ridedott/lido-hardware/LIDO_HW_2022_04_V01/SupportDocuments/OMNI_PCB_Stackup.JPG

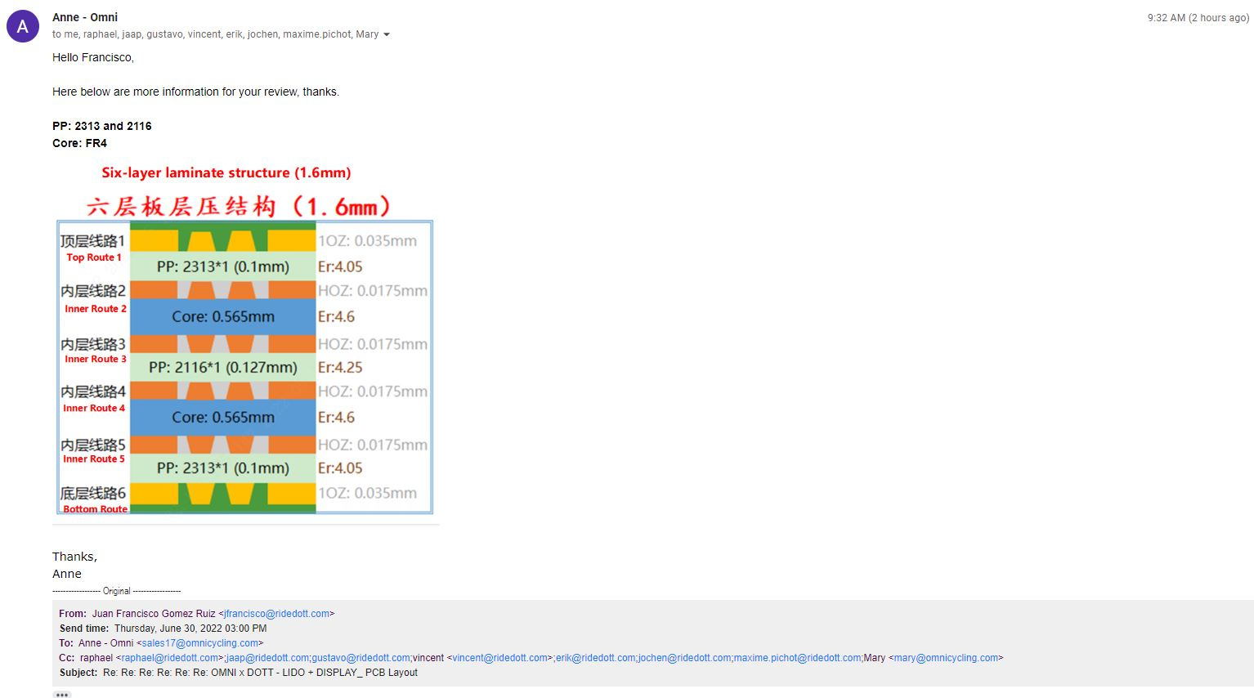
LIDO_HW_2022_04_V01/SupportDocuments/OMNI_PCB_Stackup.JPG
