ridedott/lido-hardware/LIDO_HW_2022_04_V01/SupportDocuments/Pinout_RearConnector.JPG

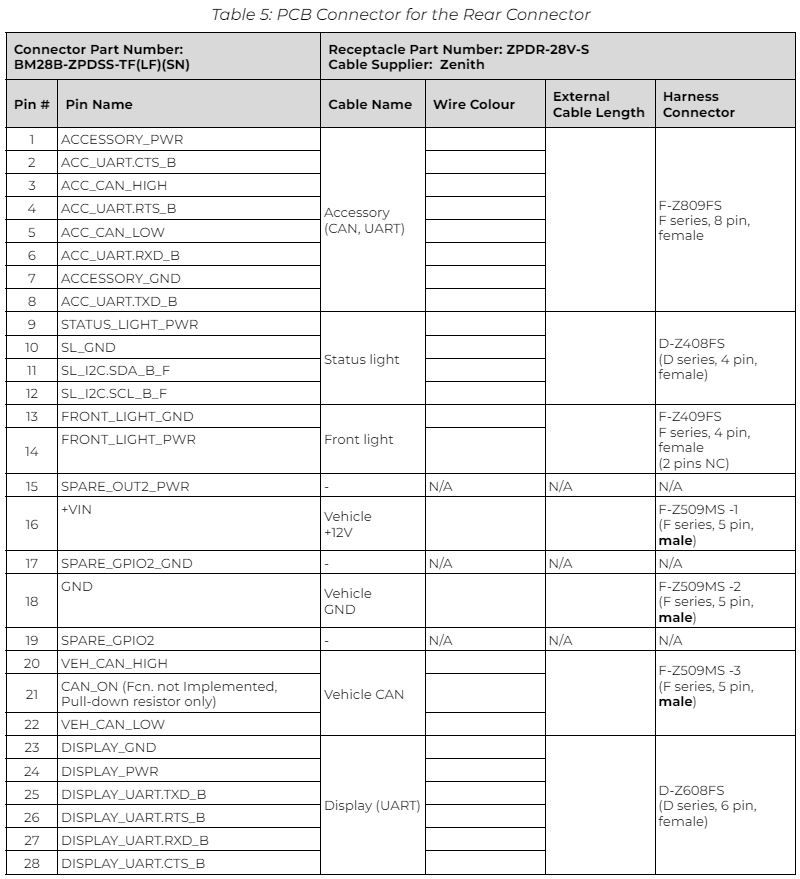
LIDO_HW_2022_04_V01/SupportDocuments/Pinout_RearConnector.JPG
