ridedott/lido-hardware/LIDO_HW_2022_04_V01/Output Documents/05_BOM/BOM LIDO_V03_DEVELOPMENT_04_07_2022.xls

 | Bill Of Materials
 | Project: | SDRR |  |  |  | DOTT (emTransit B.V.)
 | Source Data From: | LIDO_HW_2022_04_V01.PrjPcb |  |  |  | Westerdok
 | Project Name ( Board ): | LIDO |  |  |  | Van Diemenstraat 292
 | Variant: | DEVELOPMENT |  |  |  | 1013 CR, Amsterdam
 | Version & Revision: | 0 | .3 |  |  | The Netherlands
Created: | 02/07/2022 |  |  |  | Remarks:
Change LOG*: | .3 | 02/07/2022 | Initial release
*Change LOG information
Quantity | Designator | Manufacturer Part Number | Manufacturer | Manufacturer Part Number 2nd | Manufacturer 2nd | Description | Part Package | Package Type
28 | C100, C101, C102, C104, C106, C107, C108, C109, C111, C112, C113, C115, C118, C120, C122, C123, C124, C125, C127, C133, C302, C303, C304, C311, C314, C406, C407, C408 | CGA3E2C0G2A101J080AA | TDK Corporation |  |  | CAP CER 100PF 100V C0G 0603 | 0603 | SMT
10 | C103, C105, C110, C114, C116, C117, C119, C121, C126, C222 | CGA3E2X7R2A102K080AA | TDK Corporation |  |  | CAP CER 1000PF 100V X7R 0603 | 0603 | SMT
2 | C128, C129 | 25SVPK33M | Panasonic Electronic Components |  |  | CAP ALUM POLY 33UF 20% 25V SMD | D5_5.3x5.3x5.9mm | SMT
5 | C130, C131, C136, C146, C163 | ECASD31E226M040KA0 | Murata Electronics |  |  | CAP ALUM POLY 22UF 20% 25V SMD | 2917 | SMT
5 | C132, C142, C219, C221, C223 | CGA3E2X7R1H104K080AA | TDK Corporation |  |  | CAP CER 0.1UF 50V X7R 0603 | 0603 | SMT
7 | C135, C137, C139, C141, C143, C144, C300 | CL32B475KBJVPNE | Samsung Electro-Mechanics |  |  | CAP CER 4.7UF 50V X7R 1210 | 1210 | SMT
4 | C147, C148, C149, C150 | CGA3E2X7R1H682K080AA | TDK Corporation |  |  | CAP CER 6800PF 50V X7R 0603 | 0603 | SMT
5 | C151, C152, C153, C157, C158 | CGA3E2X7R1H333K080AA | TDK Corporation | CL10B333KB8WPNC | Samsung Electro-Mechanics | CAP CER 0.033UF 50V X7R 0603 | 0603 | SMT
23 | C154, C155, C161, C162, C164, C168, C224, C225, C301, C306, C307, C308, C309, C310, C312, C313, C400, C401, C402, C403, C404, C405, C410 | CGA3E1X7R1E105M080AE | TDK Corporation |  |  | CAP CER 1UF 25V X7R 0603 | 0603 | SMT
8 | C165, C166, C167, C169, C170, C171, C172, C173 | GCM188R71H473KA55D | Murata Electronics | CGA3E2X7R1H473M080AA | TDK Corporation | CAP CER 0.047UF 50V X7R 0603 | 0603 | SMT
11 | C200, C202, C203, C204, C210, C211, C213, C214, C215, C216, C217 | GCM155R71H104KE02D | Murata Electronics |  |  | CAP CER 0.1UF 50V X7R 0402 | 0402 | SMT
4 | C201, C205, C212, C218 | GRM188Z71A106KA73D | Murata Electronics |  |  | CAP CER 10UF 10V X7R 0603 | 0603 | SMT
4 | C206, C207, C208, C209 | GJM1555C1H120FB01D | Murata Electronics |  |  | CAP CER 12PF 50V C0G/NP0 0402 | 0402 | SMT
2 | C305, C409 | CGA3E2X7R1H472K080AA | TDK Corporation |  |  | CAP CER 4700PF 50V X7R 0603 | 0603 | SMT
18 | D100, D101, D102, D104, D105, D107, D108, D109, D111, D112, D113, D116, D119, D121, D123, D125, D126, D128 | PESD5V0V1BA,115 | Nexperia USA Inc. |  |  | 12.5V Clamp 4.8A (8/20µs) Ipp Tvs Diode Surface Mount SOD-323 | SOD323 | SMT
10 | D103, D106, D110, D114, D117, D118, D120, D122, D127, D130 | PESD12VL1BA,115 | Nexperia USA Inc. |  |  | 37V Clamp 5A (8/20µs) Ipp Tvs Diode Surface Mount SOD-323 | SOD323 | SMT
2 | D115, D124 | PESD1CAN,215 | Nexperia USA Inc. |  |  | 70V Clamp 3A (8/20µs) Ipp Tvs Diode Surface Mount TO-236AB | SOT23-3 | SMT
1 | D129 | SDT3A45SA-13 | Diodes Incorporated |  |  | SCHOTTKY RECTIFIER SMA T&R 10K | DO-214AC | SMT
12 | D131, D132, D133, D134, D135, D136, D137, D138, D139, D140, D141, D142 | CUS520,H3F | Toshiba Semiconductor and Storage |  |  | DIODE SCHOTTKY 30V 200MA | SOD-323 | SMT
1 | F100 | C1Q 3 | Bel Fuse Inc. |  |  | 3 A 125 V AC 63 V DC Fuse Board Mount (Cartridge Style Excluded) Surface Mount 1206 (3216 Metric) | 1206 | SMT
8 | FB100, FB101, FB102, FB103, FB107, FB108, FB110, FB113 | BLM18EG121SN1D | Murata Electronics |  |  | FERRITE BEAD 120 OHM 0603 1LN | 0603 | SMT
4 | FB104, FB105, FB111, FB112 | BLM15BD601SN1D | Murata Electronics |  |  | FERRITE BEAD 600 OHM 0402 1LN | 0402 | SMT
2 | FB106, FB109 | BLM18AG221SN1D | Murata Electronics |  |  | FERRITE BEAD 220 OHM 0603 1LN | 0603 | SMT
1 | FB200 | BLM18PG471SN1D | Murata Electronics |  |  | FERRITE BEAD 470 OHM 0603 1LN | 0603 | SMT
2 | L100, L101 | IHLP2525CZER100M8A | Vishay Dale |  |  | FIXED IND 10UH 4A 76.9 MOHM SMD | 6.47x6.47x3.0mm | SMT
1 | L200 | CDRH2D18/HPNP-100NC | Sumida America Components Inc. |  |  | FIXED IND 10UH 900MA 245MOHM SMD | 3.0x3.0x2.0mm | SMT
2 | Q100, Q101 | DMN4035LQ-13 | Diodes Incorporated |  |  | MOSFET N-CH 40V 4.6A SOT23 | SOT23-3 | SMT
8 | R100, R101, R102, R103, R104, R105, R106, R107 | ERJ-PA3J470V | Panasonic Electronic Components |  |  | RES SMD 47 OHM 5% 1/4W 0603 | 0603 | SMT
32 | R108, R113, R114, R115, R120, R123, R126, R129, R132, R133, R134, R140, R164, R165, R166, R170, R247, R248, R253, R260, R261, R263, R264, R300, R307, R310, R311, R314, R401, R402, R404, R410 | RC0603FR-0710KL | YAGEO |  |  | RES 10K OHM 1% 1/10W 0603 | 0603 | SMT
6 | R109, R110, R111, R116, R118, R119 | ERJ-6GEY0R00V | Panasonic Electronic Components |  |  | RES SMD 0 OHM JUMPER 1/8W 0805 | 0805 | SMT
1 | R112 | ERJ-3EKF5622V | Panasonic Electronic Components |  |  | RES SMD 56.2K OHM 1% 1/10W 0603 | 0603 | SMT
1 | R117 | ERJ-3EKF7682V | Panasonic Electronic Components | RMCF0603FT76K8 | Stackpole Electronics Inc | RES SMD 76.8K OHM 1% 1/10W 0603 | 0603 | SMT
10 | R121, R124, R127, R130, R200, R201, R205, R206, R315, R316 | ERJ-3EKF4701V, RC0603JR-074K7L | Panasonic Electronic Components, YAGEO |  |  | RES SMD 4.7K OHM 1% 1/10W 0603, RES 4.7K OHM 5% 1/10W 0603 | 0603 | SMT
4 | R122, R125, R128, R131 | ERJ-3EKF2002V | Panasonic Electronic Components | RC0603FR-0720KL | YAGEO | RES SMD 20K OHM 1% 1/10W 0603 | 0603 | SMT
5 | R135, R136, R137, R141, R143 | ERJ-3EKF4702V | Panasonic Electronic Components |  |  | RES SMD 47K OHM 1% 1/10W 0603 | 0603 | SMT
19 | R138, R142, R144, R147, R148, R149, R150, R155, R156, R158, R161, R251, R252, R254, R308, R312, R317, R318, R400 | RC0603JR-070RL | YAGEO | RMCF0603ZT0R00 | Stackpole Electronics Inc | RES 0 OHM JUMPER 1/10W 0603 | 0603 | SMT
1 | R163 | ESR03EZPJ100 | Rohm Semiconductor |  |  | RES SMD 10 OHM 5% 1/4W 0603 | 0603 | SMT
5 | R167, R259, R262, R302, R406 | RC0603JR-0733RL | YAGEO |  |  | RES 33 OHM 5% 1/10W 0603 | 0603 | SMT
24 | R202, R203, R204, R207, R209, R212, R216, R217, R218, R221, R223, R224, R226, R228, R229, R230, R231, R233, R235, R237, R238, R242, R243, R244 | ERJ-2GE0R00X | Panasonic Electronic Components |  |  | RES SMD 0 OHM JUMPER 1/10W 0402 | 0402 | SMT
19 | R208, R210, R211, R213, R214, R215, R219, R220, R222, R225, R227, R232, R234, R236, R239, R240, R241, R249, R250 | ERJ-2GEJ330X | Panasonic Electronic Components |  |  | RES SMD 33 OHM 5% 1/10W 0402 | 0402 | SMT
3 | R245, R246, R257 | RC0603JR-071KL | YAGEO |  |  | RES 1K OHM 5% 1/10W 0603 | 0603 | SMT
2 | R255, R258 | ERJ-3EKF5101V | Panasonic Electronic Components |  |  | RES SMD 5.1K OHM 1% 1/10W 0603 | 0603 | SMT
1 | R256 | RC0603FR-0731K6L | YAGEO |  |  | RES 31.6K OHM 1% 1/10W 0603 | 0603 | SMT
4 | R305, R306, R409, R411 | ERJ-3EKF62R0V | Panasonic Electronic Components |  |  | RES SMD 62 OHM 1% 1/10W 0603 | 0603 | SMT
1 | S200 | SKRKAEE020 | Alps Alpine |  |  | Switch Tactile N.O. SPST Round Button Gull Wing 0.05A 12VDC 1.57N SMD T/R |  | SMT
1 | U100 | TPS562208DDCR | Texas Instruments |  |  | Buck Switching Regulator IC Positive Adjustable 0.768V 1 Output 2A SOT-23-6 Thin, TSOT-23-6 | SOT23-6 | SMT
1 | U101 | TPS2552DBVR | Texas Instruments |  |  | Power Switch/Driver 1:1 N-Channel 1.5A SOT-23-6 | SOT23-6 | SMT
1 | U102 | TLV74333PDBVR | Texas Instruments |  |  | Linear Voltage Regulator IC Positive Fixed 1 Output 300mA SOT-23-5 | SOT23-5 | SMT
6 | U103, U302, U303, U304, U400, U401 | TCA9406DCTR | Texas Instruments |  |  | Voltage Level Translator Bidirectional 1 Circuit 2 Channel 24Mbps SM8 | MSOP-8 | SMT
1 | U104 | L9733XPTR | STMicroelectronics |  |  | Power Switch/Driver 1:8 N-Channel 1A PowerSSO-28 Exposed Pad | PSSOP-28 | SMT
1 | U200 | ATSAME54P20A-CTUT | Microchip Technology |  |  | ARM® Cortex®-M4F series Microcontroller IC 32-Bit Single-Core 120MHz 1MB (1M x 8) FLASH 120-TFBGA (8x8) | TFBGA-120 | SMT
1 | U201 | TPS3808G01DBVR | Texas Instruments |  |  | Supervisor Open Drain or Open Collector 1 Channel SOT-23-6 | SOT23-6 | SMT
1 | U202 | ATECC608A-SSH4E-T | Microchip Technology |  |  | IC AUTHENTICATION CHIP 8SOIC | SOIC-8 | SMT
1 | U203 | TMP75AIDGKR | Texas Instruments |  |  | Temperature Sensor Digital, Local -40°C ~ 125°C 11 b 8-VSSOP | VSSOP-8 | SMT
2 | U300, U402 | ATA6561-GAQW | Microchip Technology |  |  | IC TRANSCEIVER 1/1 8SO | SOIC-8 | SMT
2 | U301, U403 | TS3A4741DCNR | Texas Instruments |  |  | IC SWITCH DUAL SPST SOT23-8 | SOT23-8 | SMT
1 | X100 | BM24B-GHDS-TF(LF)(SN) | JST Sales America Inc. |  |  | Connector Header Surface Mount 24 position 0.049" (1.25mm)
1 | X101 | BM28B-ZPDSS-TF(LF)(SN) | JST Sales America Inc. |  |  | Connector Header Surface Mount 28 position 0.059" (1.50mm)
1 | X200 | PRPC003SAAN-RC | Sullins Connector Solutions |  |  | CONN HEADER VERT 3POS 2.54MM
1 | X201 | 830103552209 | Würth Elektronik |  |  | 32 MHz ±10ppm Crystal 9pF 40 Ohms 4-SMD, No Lead | SMD-4 | SMT
1 | X202 | CM8V-T1A-32.768KHZ-9PF-20PPM-TA-QC | Micro Crystal AG |  |  | 32.768 kHz ±20ppm Crystal 9pF 70 kOhms 2-SMD, No Lead | SMD-2 | SMT
1 | X203 | GRPB052VWQS-RC | Sullins Connector Solutions |  |  | CONN HEADER SMD 10POS 1.27MM
