ridedott/lido-hardware/LIDO_HW_2022_04_V01/SupportDocuments/Templates/BOM Dott template rev.A1.xls

 | Bill Of Materials
 | Project: | Field=MainProjectName |  |  |  | DOTT (emTransit B.V.)
 | Source Data From: | Field=DataSourceFileName |  |  |  | Westerdok
 | Project Name ( Board ): | Field=ProjectBoardName |  |  |  | Van Diemenstraat 292
 | Variant: | Field=VariantName |  |  |  | 1013 CR, Amsterdam
 | Version & Revision: | Field=Project_Version | Field=ProjectRevision |  |  | The Netherlands
Created: | Field=ReportDate |  |  |  | Remarks:
Change LOG*: | Field=ProjectRevision | Field=ReportDate | Initial release
*Change LOG information
Column=Quantity | Column=Designator | Column=Manufacturer Part Number | Column=Manufacturer | Column=Manufacturer Part Number 2nd | Column=Manufacturer 2nd | Column=Description | Column=Part Package | Column=Package Type
