ridedott/lido-hardware/LIDO_HW_2022_04_V01/SupportDocuments/20220602_OMNI LIDO PCB.step

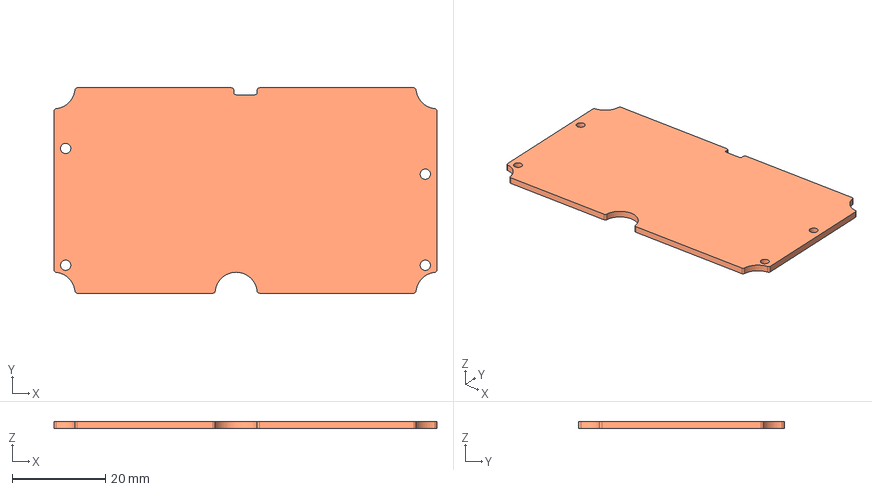
[picture p4: CAD file, 2022-06-07]
LIDO_HW_2022_04_V01/SupportDocuments/20220602_OMNI LIDO PCB.step
82.0 x 44.0 x 1.60 mm
