ridedott/lido-hardware/LIDO_HW_2022_04_V01/Output Documents/01_Schematics/Sch LIDO_V03_DEVELOPMENT_04_07_2022.PDF

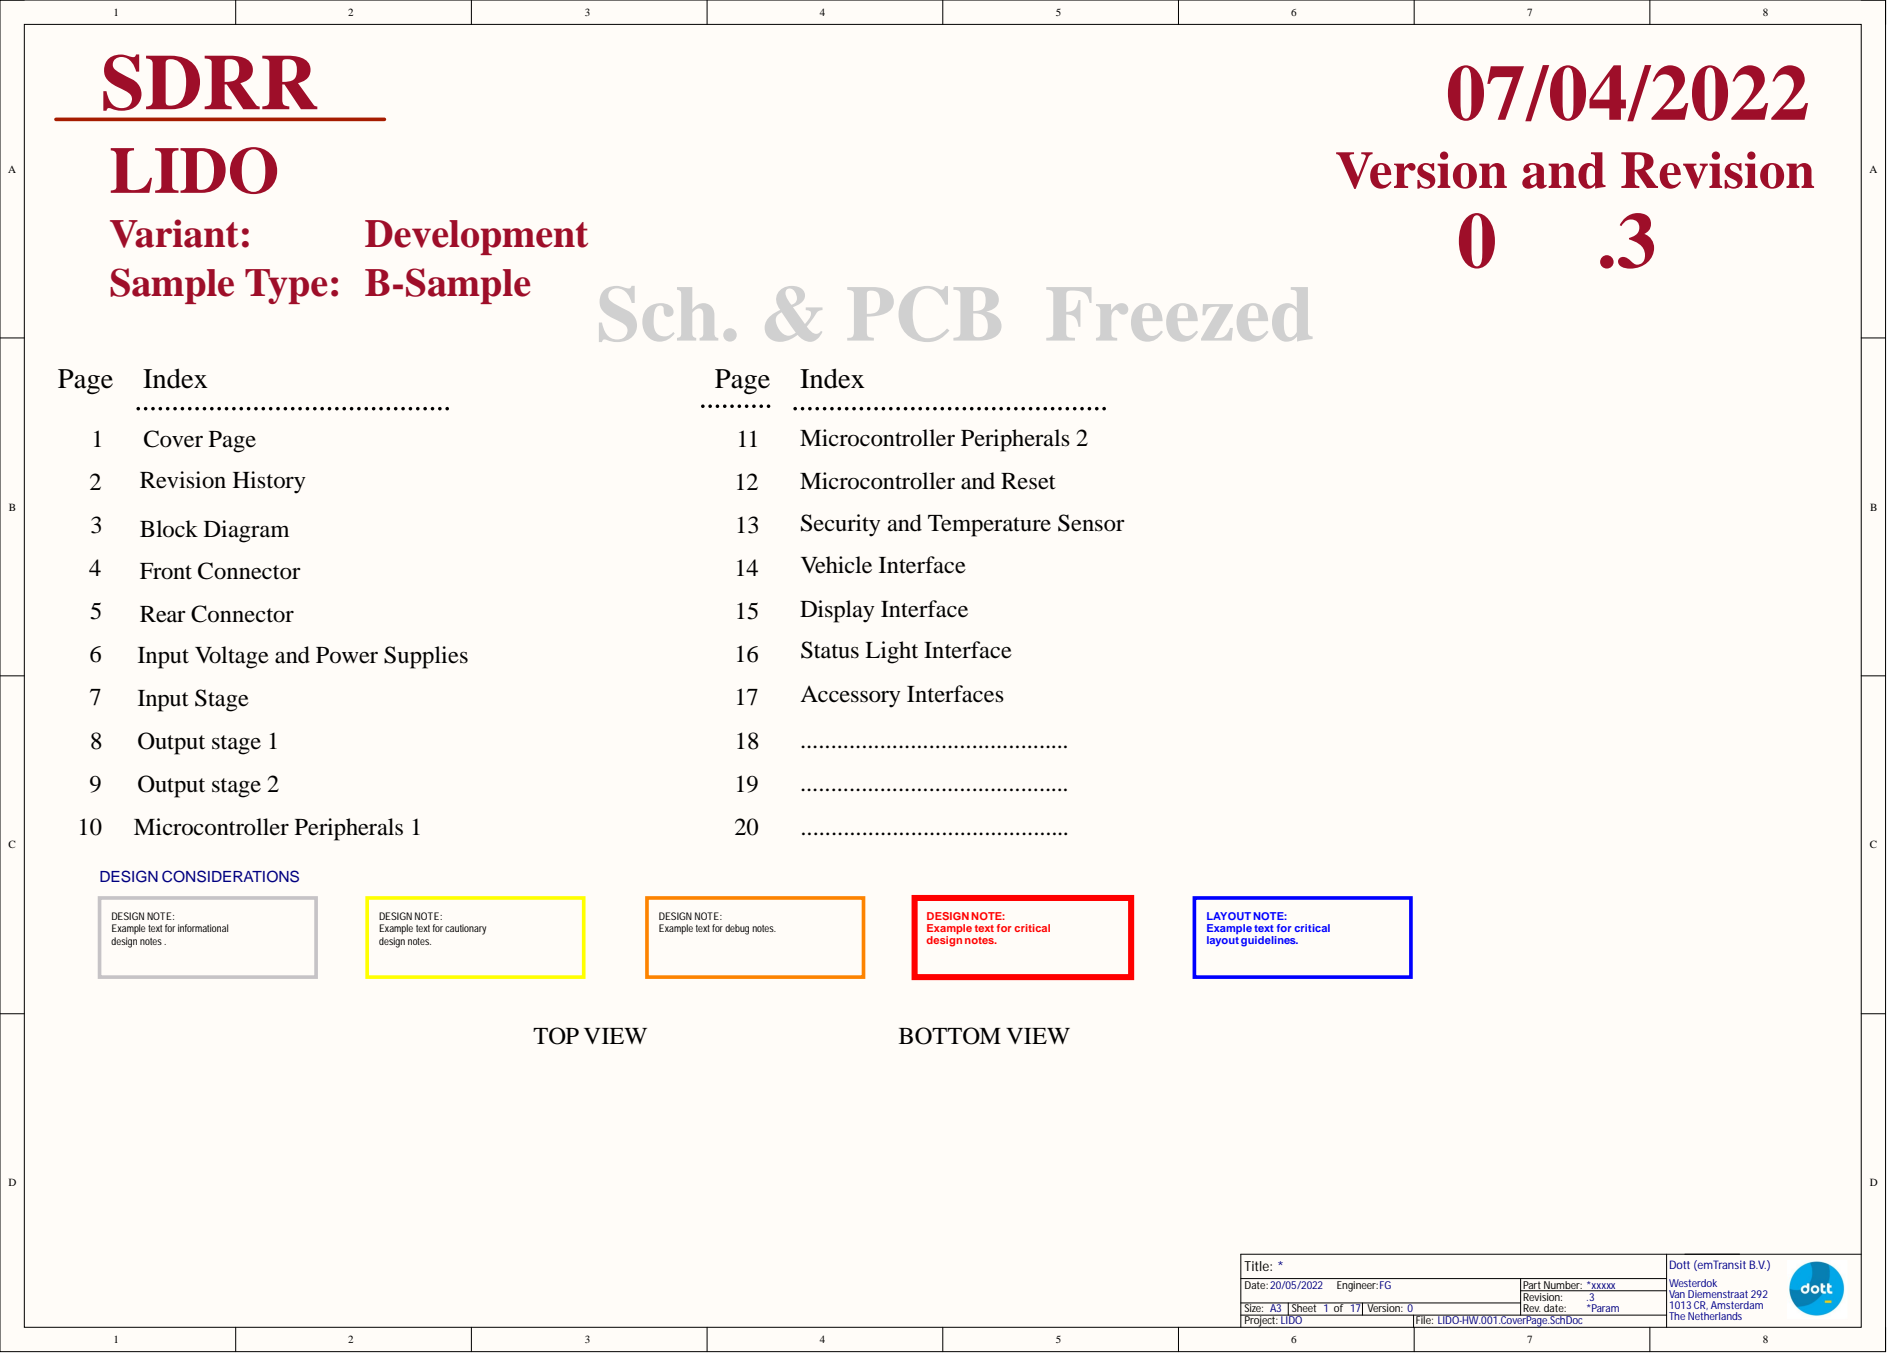
[picture p5: page 1]

DESIGN NOTE:
Example text for informational
design notes .

Example text for cautionary
design notes.

Example text for debug notes.

Example text for critical

LAYOUT NOTE:
layout guidelines.

LIDO-HW.001.CoverPage.SchDoc

D | D
C | C
B | B
A | A

LIDO-HW.002.RevisionHistory.SchDoc

Sheet | of 2 | 17 | Version: 0

# ID002 - Revision History

Index | HISTORY
1 | Date
| 29/04/2022
2 | 04/05/2022
3 | 17/05/2022
4 | 01/06/2022

Draft schematic wiht symbo only ready for first reviews within team and Vladimir (external)

V0.1 - Corrections based on the first sch. review meeting.

V0.2 - Vladimir's comments/suggestions added to schematic.
Old symbol where replaced by real components (Symbol + Footprint) from the databsae library with the part numbers provided by Vladimir.
Some of the part numbers change due to no stock. main parameter remains.

V0.3 - Connectors andCapacitors changed due to space constrains.
- New connectors have smaller pitch. Main connector with 1.50mm pitch; Ratings: 100Volts and up to 2.0Amp. Sensor's conenctor with 1.25mm pitch; Ratings: 50Volts and up to 1.0Amp.
- Some Polymer Caps change to MLCC caps due to space constrains.
- Component placement completed in this revision.

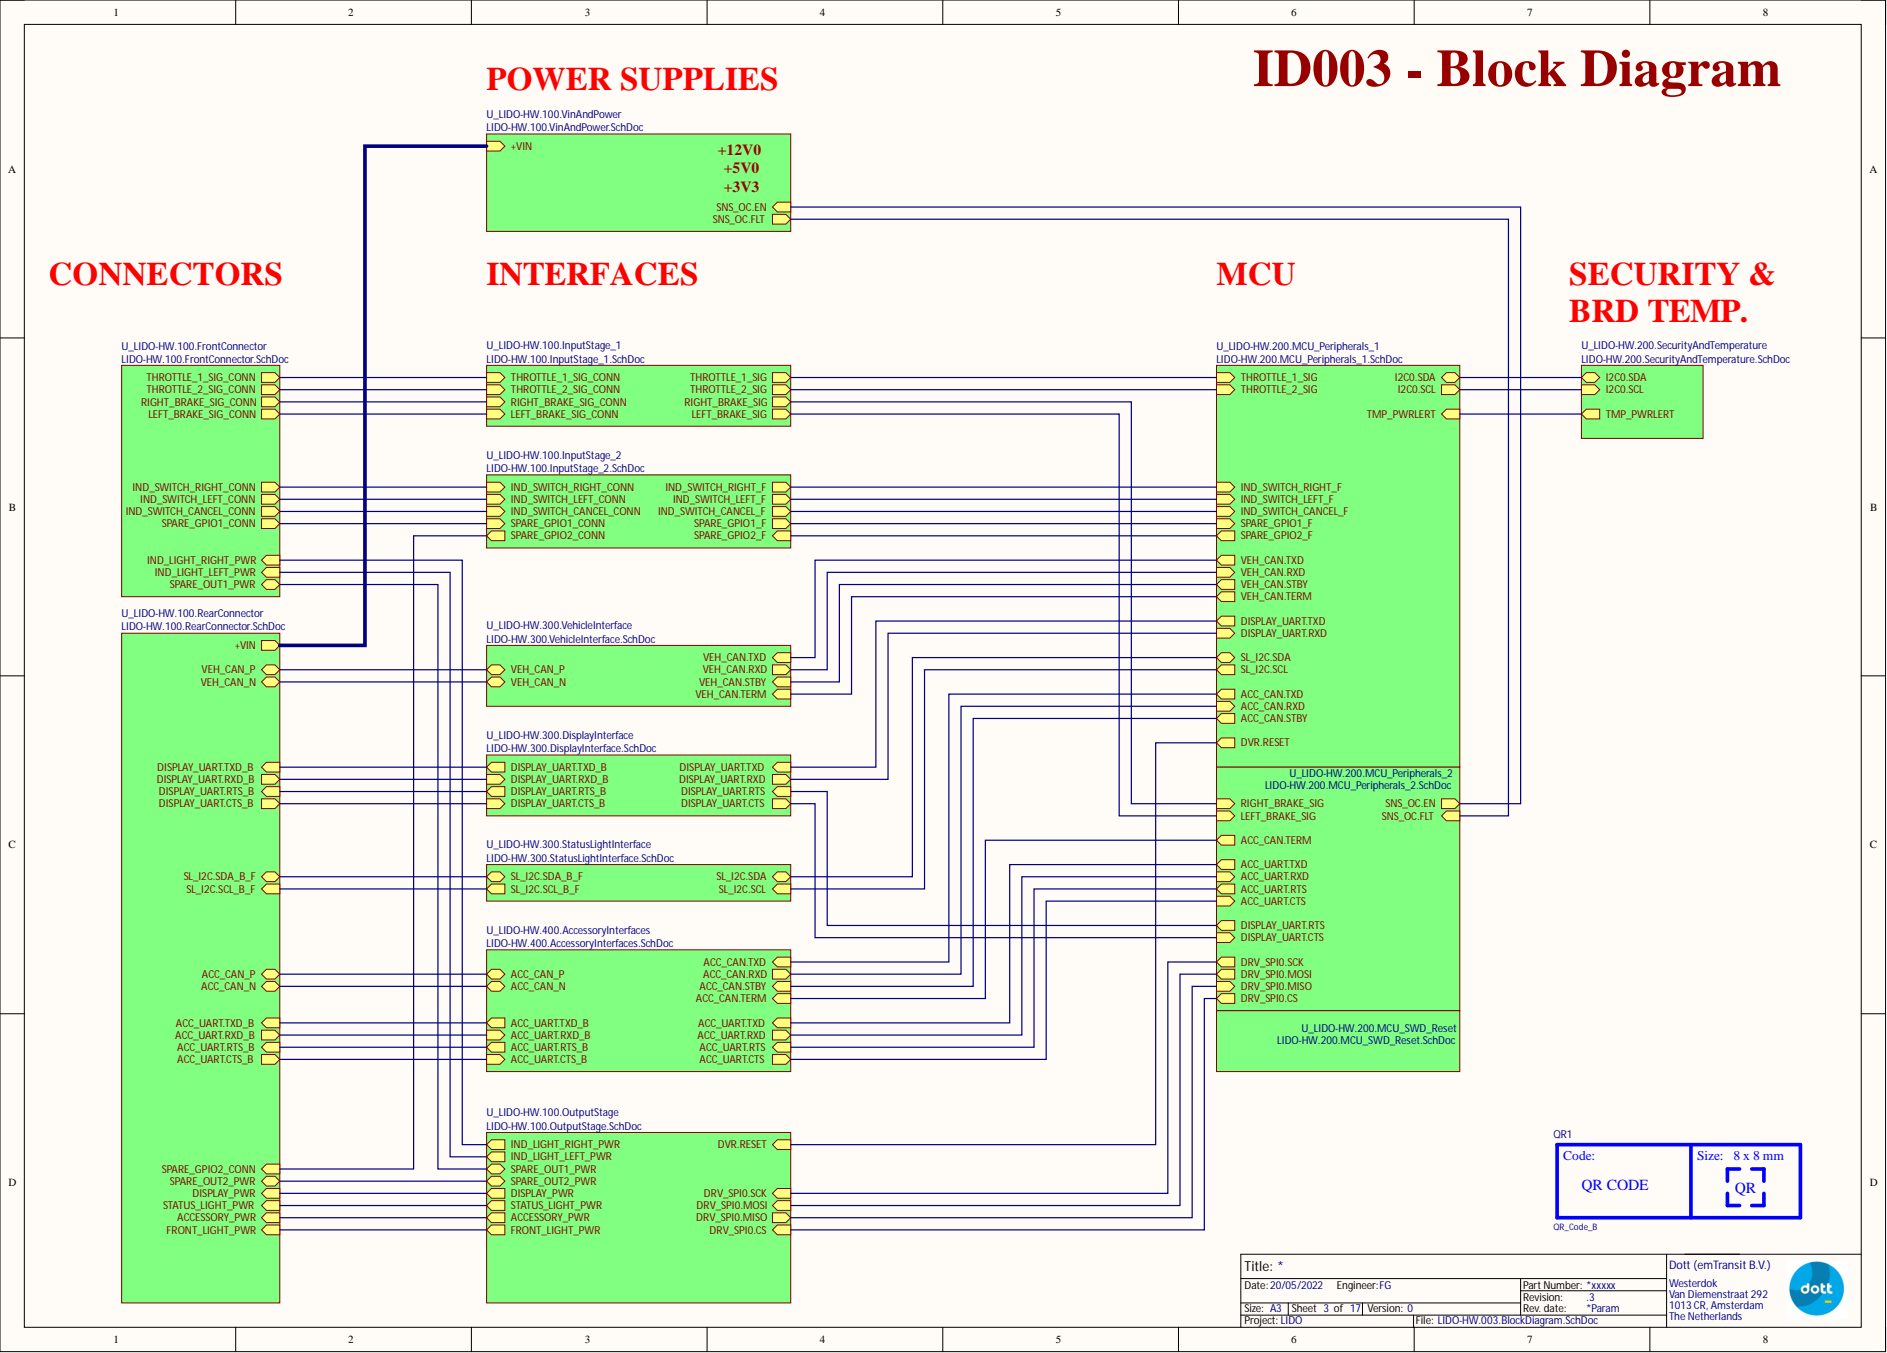
[picture p6: page 3]

U_LIDO-HW.100.VinAndPower
LIDO-HW.100.VinAndPower.SchDoc
+VIN

U_LIDO-HW.200.SecurityAndTemperature
LIDO-HW.200.SecurityAndTemperature.SchDoc
I2C0.SDA
I2C0.SCL

U_LIDO-HW.100.RearConnector
LIDO-HW.100.RearConnector.SchDoc

U_LIDO-HW.300.VehicleInterface
LIDO-HW.300.VehicleInterface.SchDoc

VEH_CAN.TXD VEH_CAN_P VEH_CAN.RXD VEH_CAN_N VEH_CAN.STBY VEH_CAN.TERM

U_LIDO-HW.300.DisplayInterface LIDO-HW.300.DisplayInterface.SchDoc

U_LIDO-HW.200.MCU_Peripherals_2 LIDO-HW.200.MCU_Peripherals_2.SchDoc RIGHT_BRAKE_SIG SNS_OC.EN

LEFT_BRAKE_SIG SNS_OC.FLT

U_LIDO-HW.300.StatusLightInterface LIDO-HW.300.StatusLightInterface.SchDoc | ACC_CAN.TERM ACC_UART.TXD ACC_UART.RXD ACC_UART.RTS ACC_UART.CTS DISPLAY_UART.RTS DISPLAY_UART.CTS DRV_SPI0.SCK DRV_SPI0.MOSI DRV_SPI0.MISO DRV_SPI0.CS

SL_I2C.SDA_B_F SL_I2C.SDA SL_I2C.SCL_B_F SL_I2C.SCL

U_LIDO-HW.400.AccessoryInterfaces LIDO-HW.400.AccessoryInterfaces.SchDoc

LIDO-HW.003.BlockDiagram.SchDoc

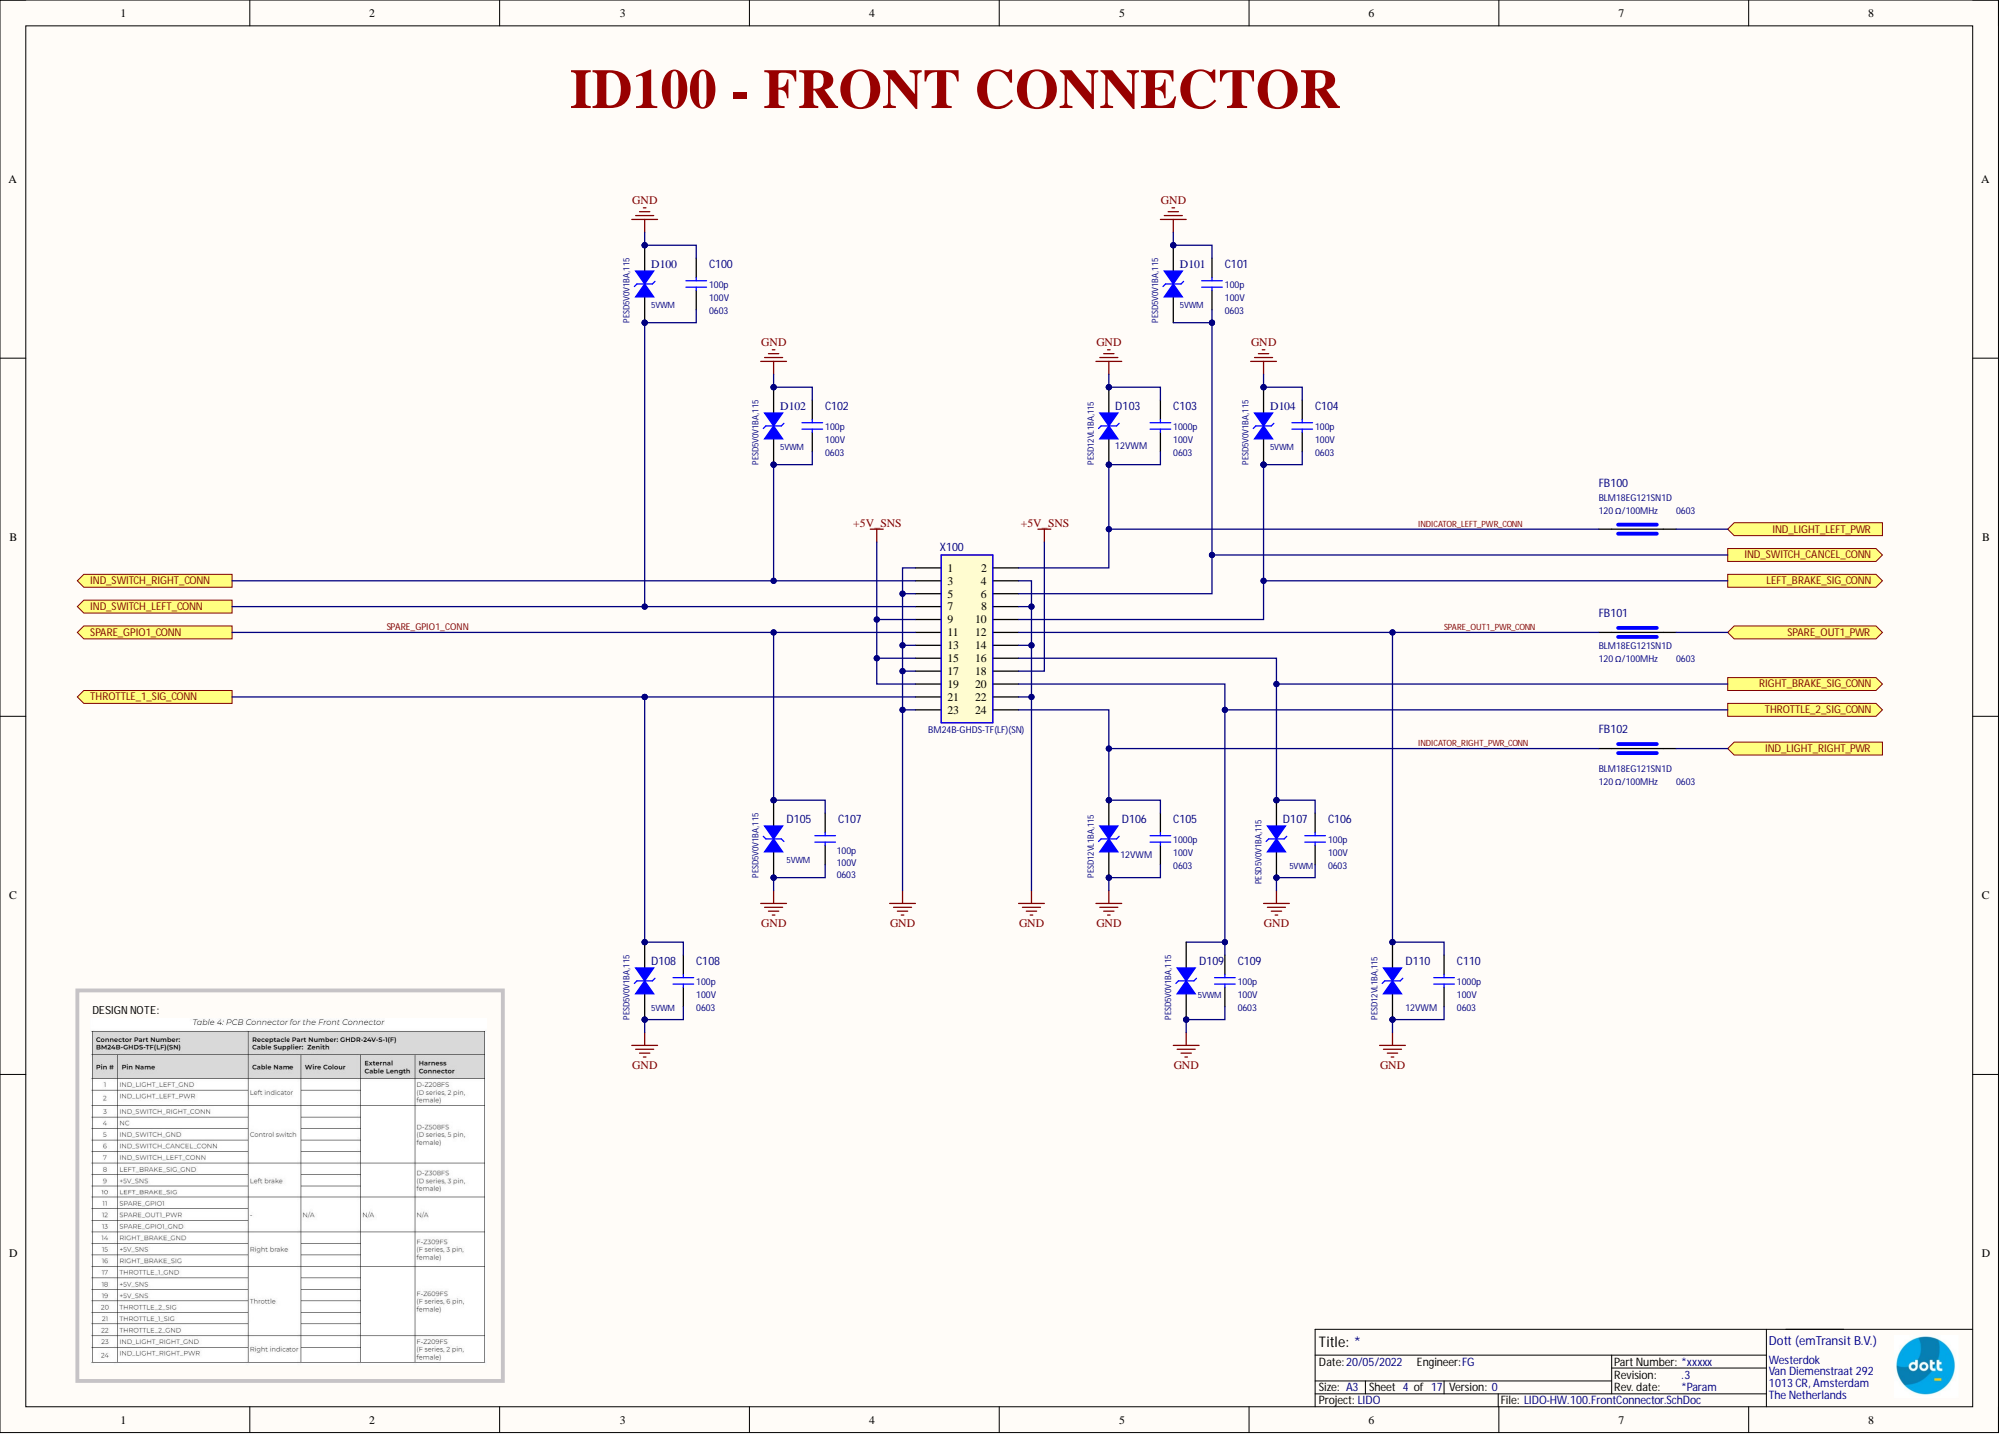
[picture p7: page 4]

BM24B-GHDS-TF(LF)(SN)

LIDO-HW.100.FrontConnector.SchDoc

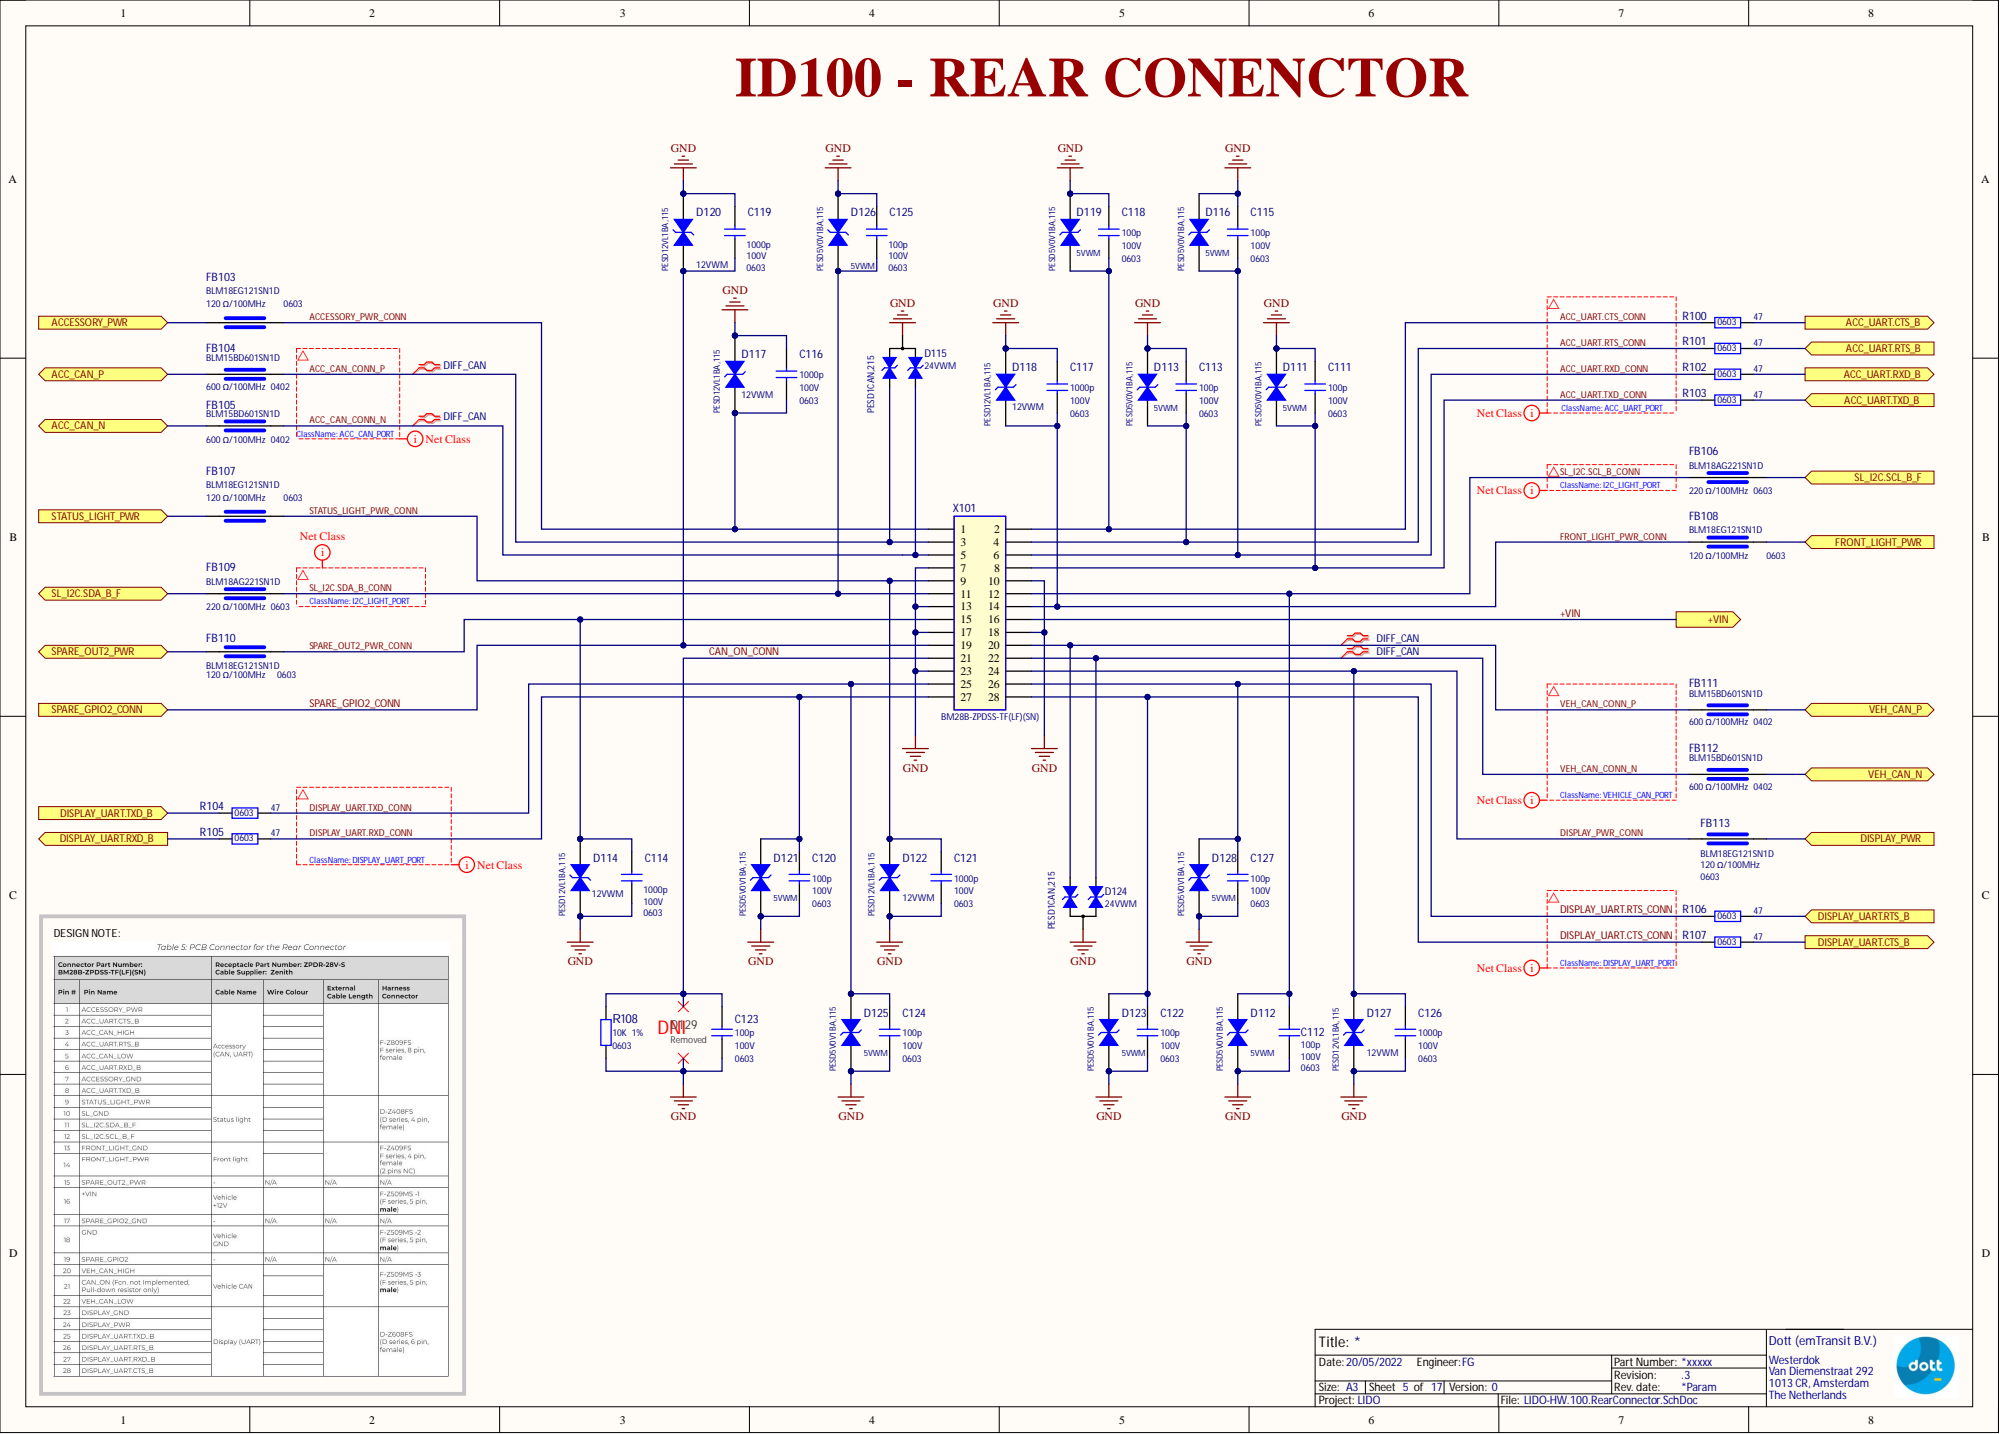
[picture p8: page 5]

1000p | 100p | 100p | ACC_UART.TXD_CONN

0603 | | 5VWM | 0603 | 5VWM

Net Class

BM28B-ZPDSS-TF(LF)(SN)

DISPLAY_UART.RXD_CONN

DISPLAY_UART.CTS_CONN

LIDO-HW.100.RearConnector.SchDoc

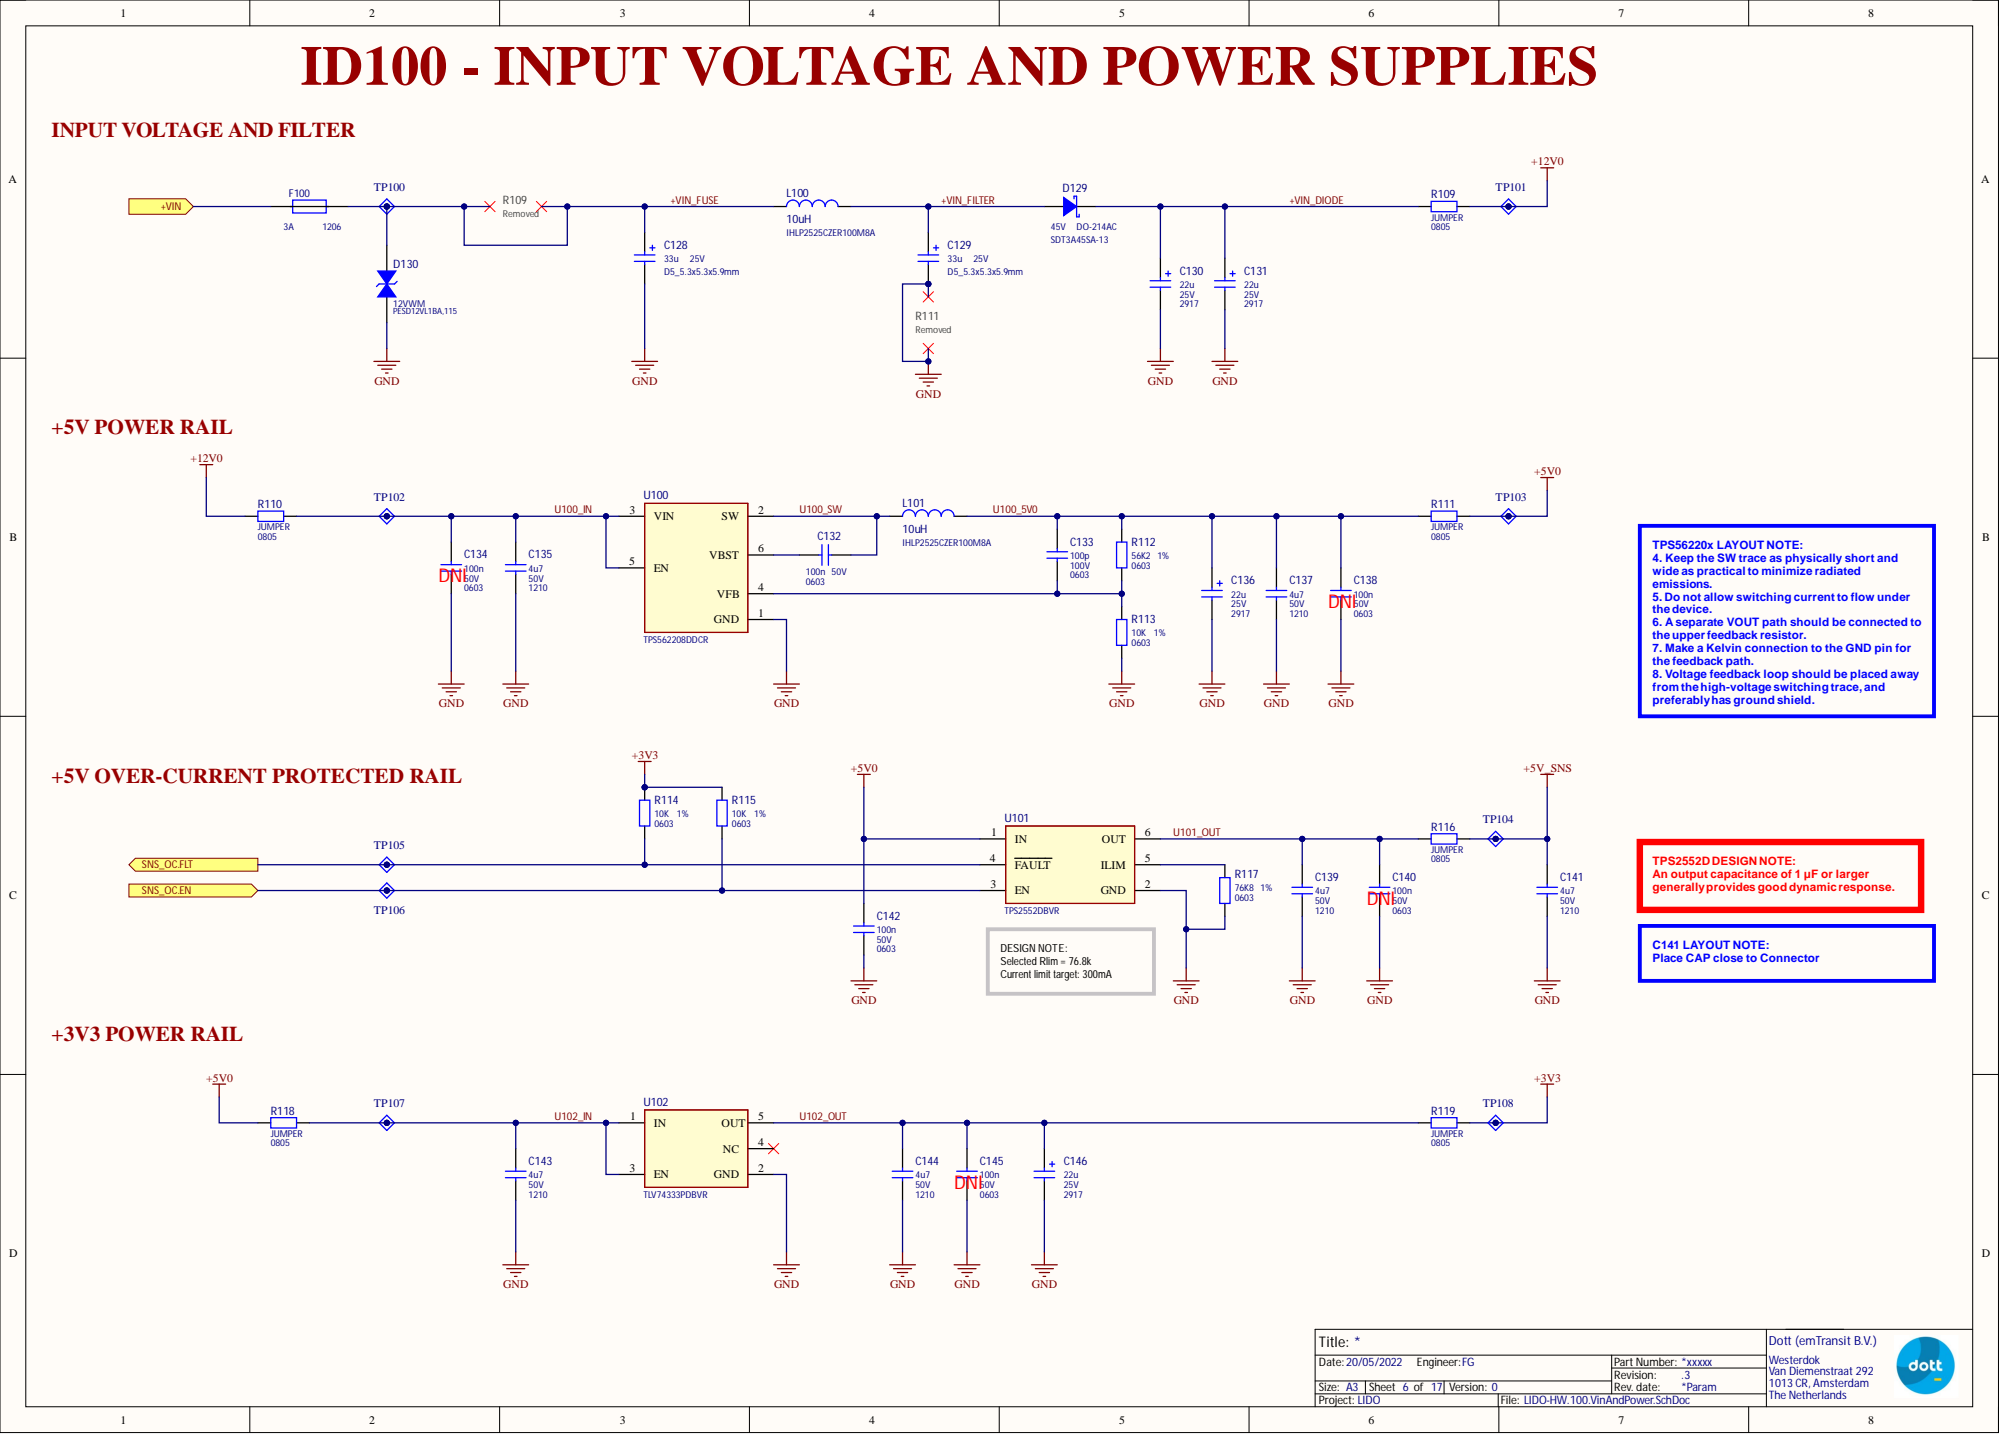
[picture p9: page 6]

ID100 - INPUT VOLTAGE AND POWER SUPPLIES

INPUT VOLTAGE AND FILTER

TPS56220x LAYOUT NOTE:
4. Keep the SW trace as physically short and
wide as practical to minimize radiated
emissions.
5. Do not allow switching current to flow under
the device.
6. A separate VOUT path should be connected to
the upperfeedback resistor.
7. Make a Kelvin connection to the GND pin for
the feedback path.
8. Voltage feedback loop should be placed away
from the high-voltage switching trace, and
preferablyhas ground shield.

+5V OVER-CURRENT PROTECTED RAIL

TPS2552D DESIGN NOTE:
An output capacitance of 1 μF or larger
generallyprovides good dynamic response.

C141 LAYOUT NOTE:
Place CAP close to Connector

LIDO-HW.100.VinAndPower.SchDoc

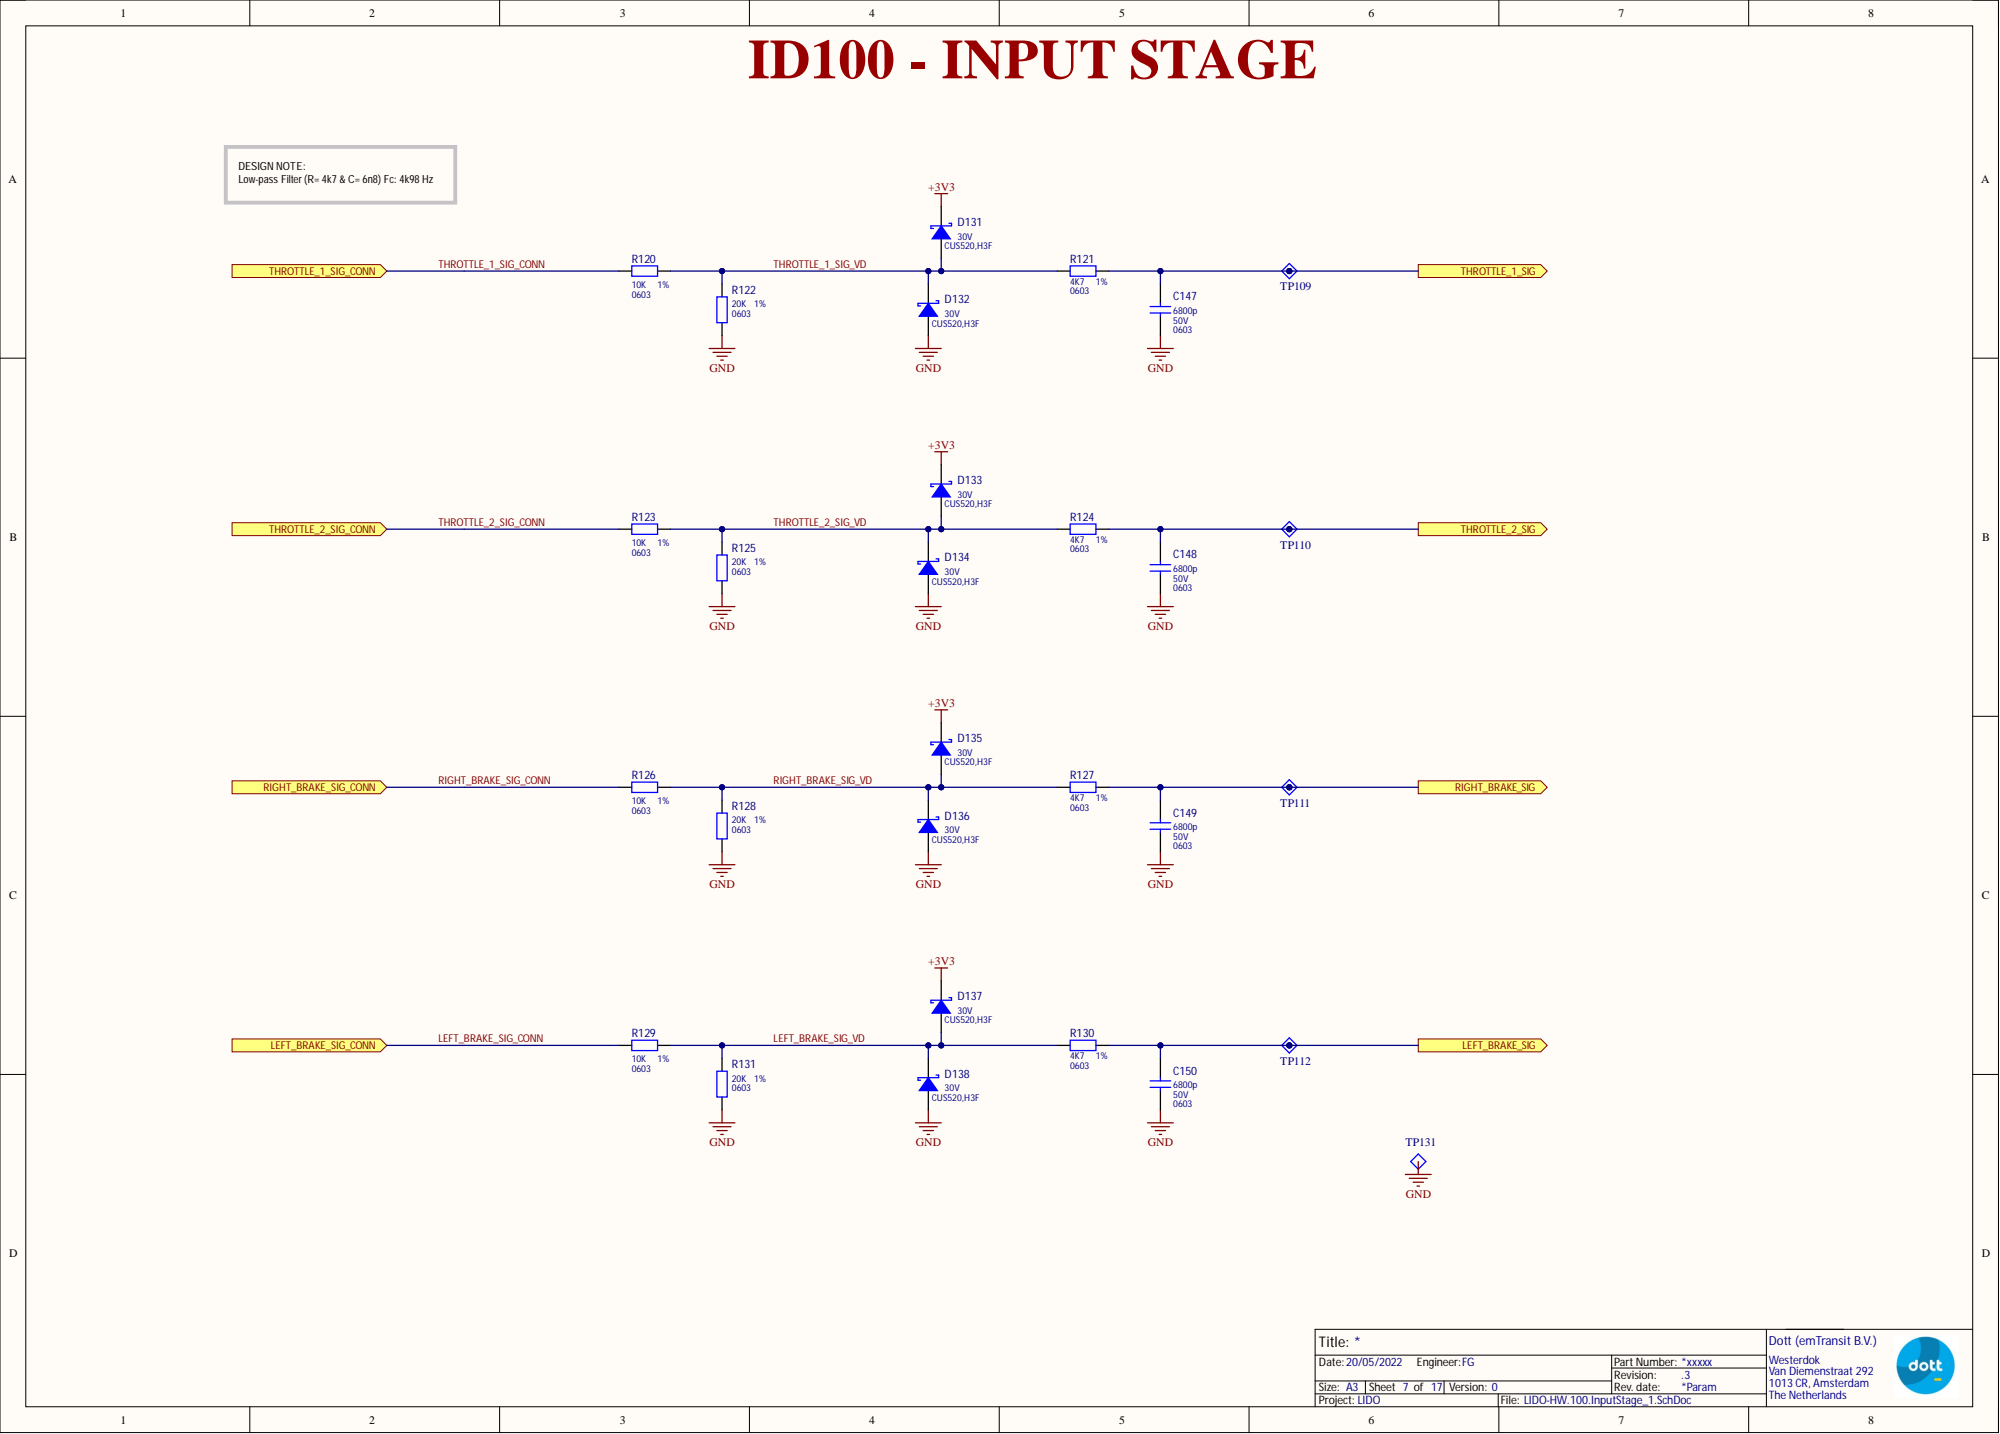
[picture p10: page 7]

DESIGN NOTE:
Low-pass Filter (R= 4k7 & C= 6n8) Fc: 4k98 Hz

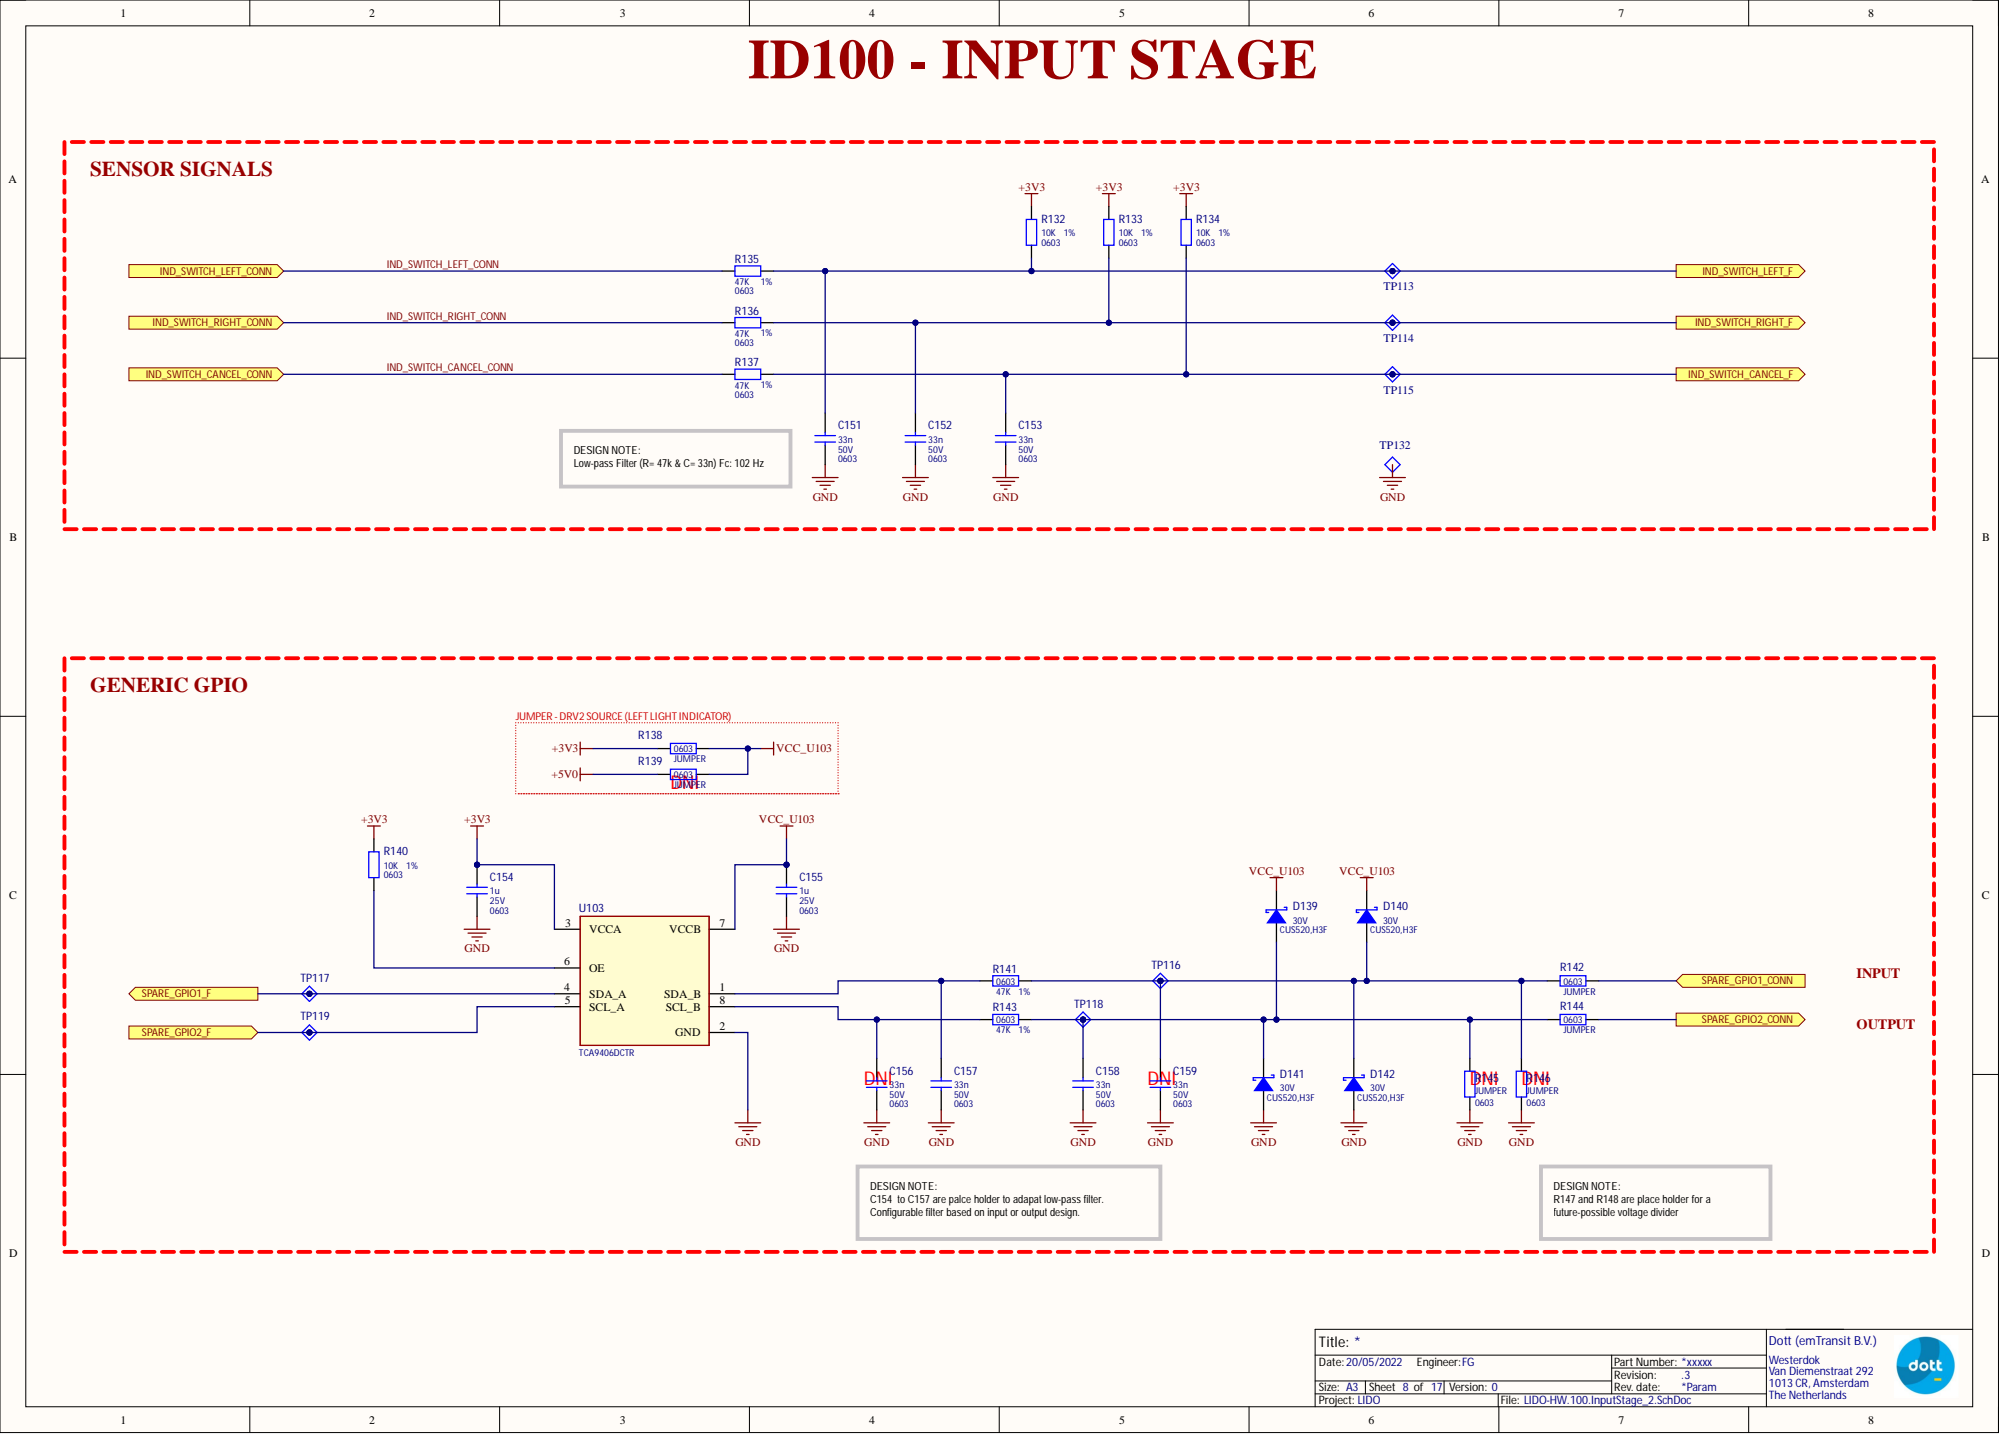
[picture p11: page 8]

DESIGN NOTE:
Low-pass Filter (R= 47k & C= 33n) Fc: 102 Hz

JUMPER - DRV2 SOURCE (LEFT LIGHT INDICATOR)

C154 to C157 are palce holder to adapat low-pass filter.
Configurable filter based on input or output design.

R147 and R148 are place holder for a
future-possible voltage divider

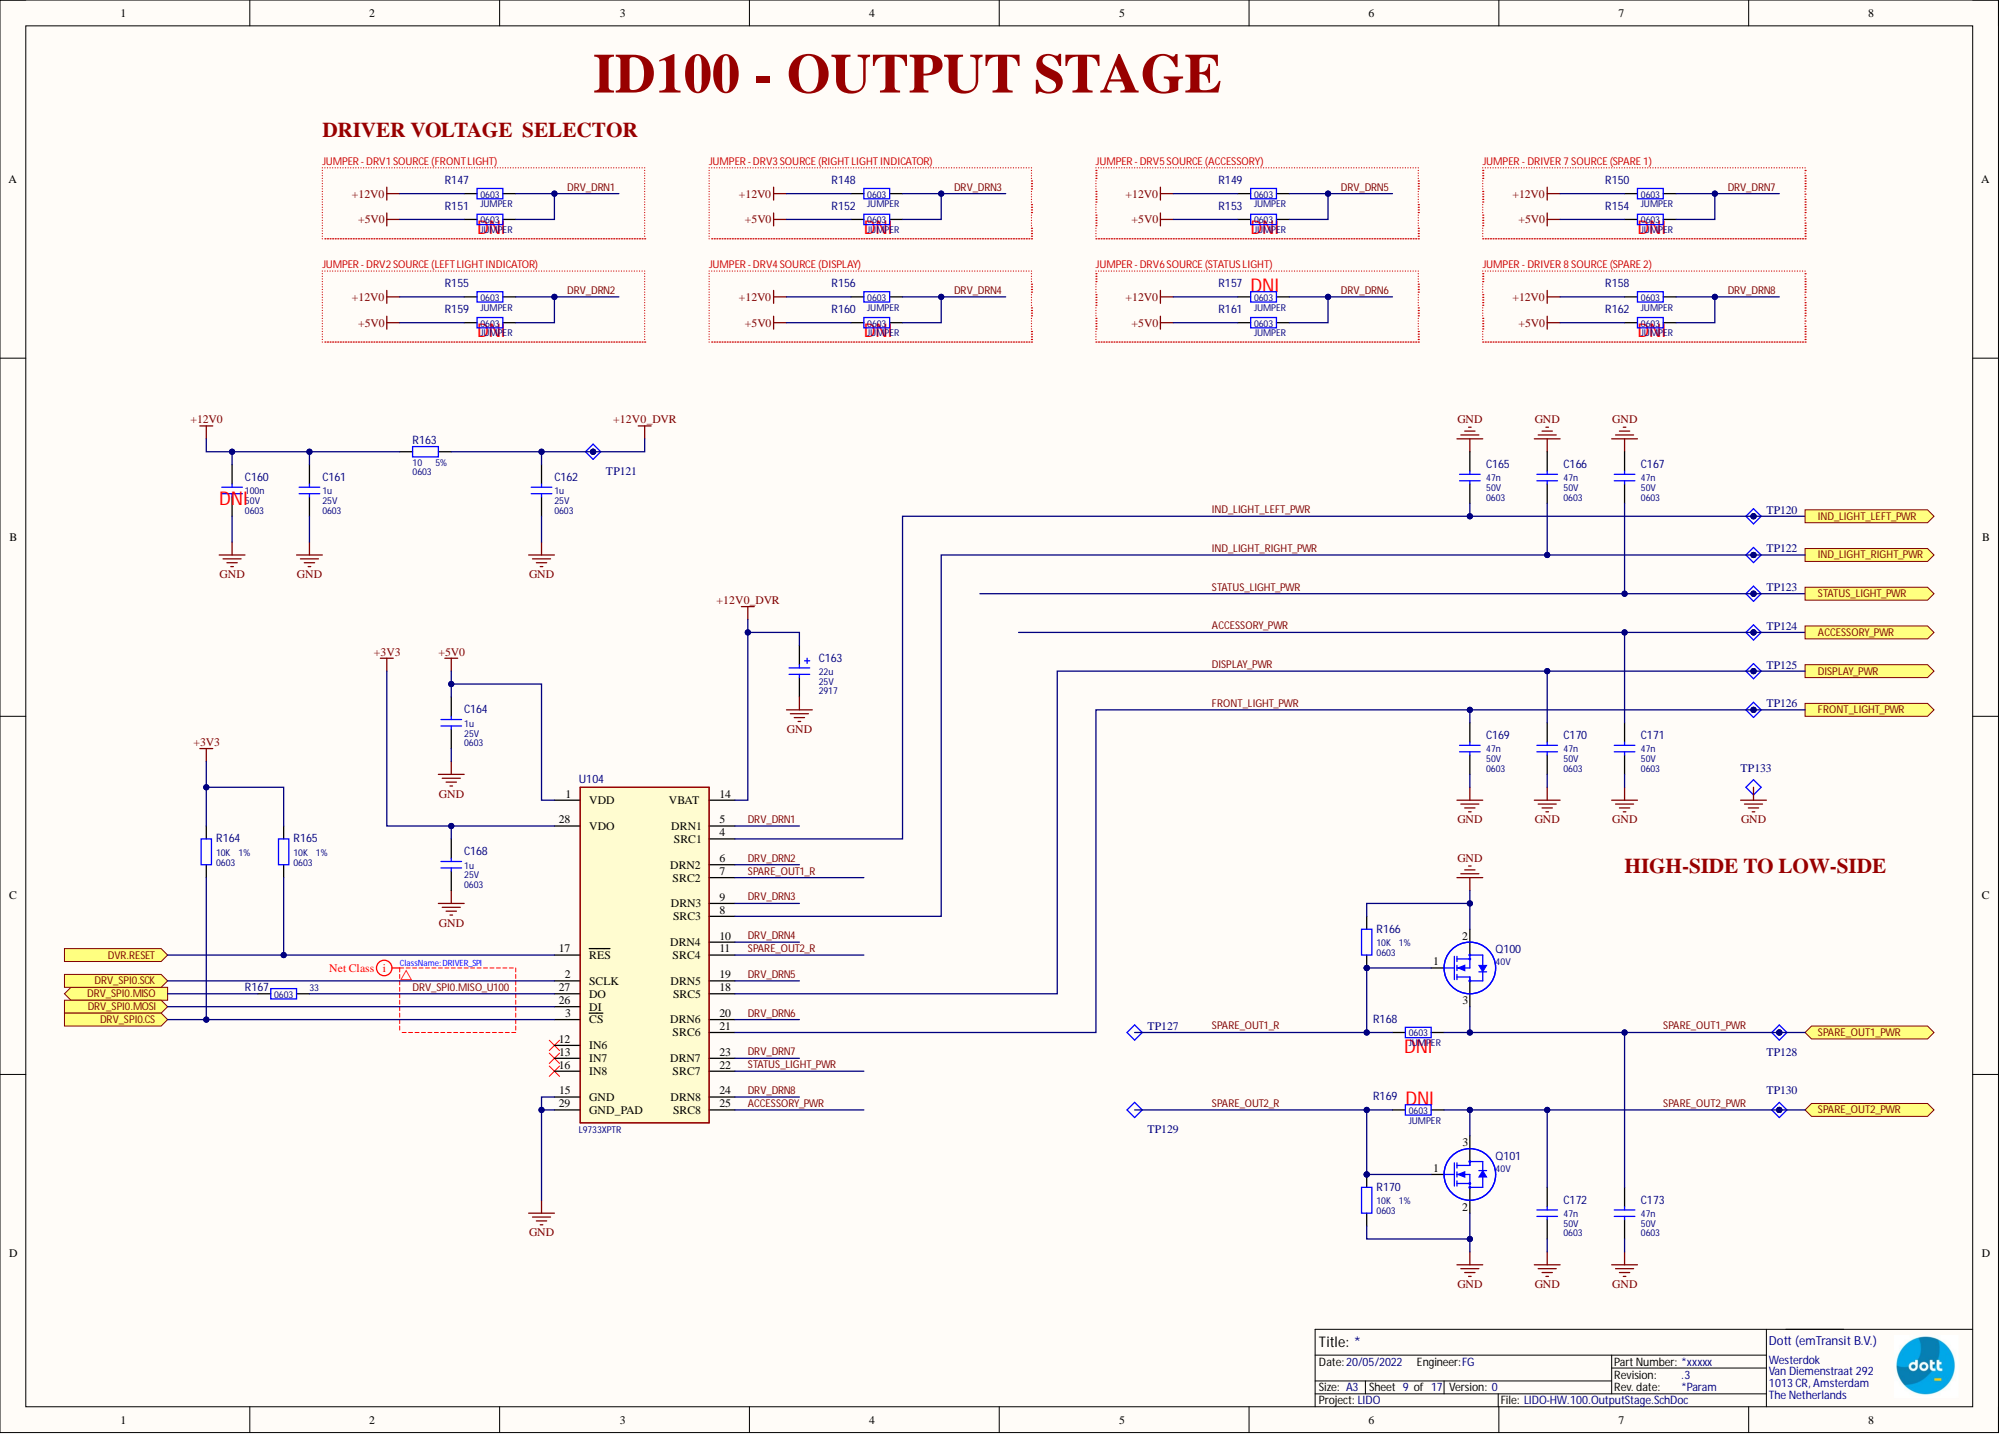
[picture p12: page 9]

JUMPER - DRV1 SOURCE (FRONT LIGHT)

JUMPER - DRV3 SOURCE (RIGHT LIGHT INDICATOR)

JUMPER - DRIVER 7 SOURCE (SPARE 1)

JUMPER - DRV2 SOURCE (LEFT LIGHT INDICATOR)

JUMPER - DRV6 SOURCE (STATUS LIGHT)

JUMPER - DRIVER 8 SOURCE (SPARE 2)

HIGH-SIDE TO LOW-SIDE

LIDO-HW.100.OutputStage.SchDoc

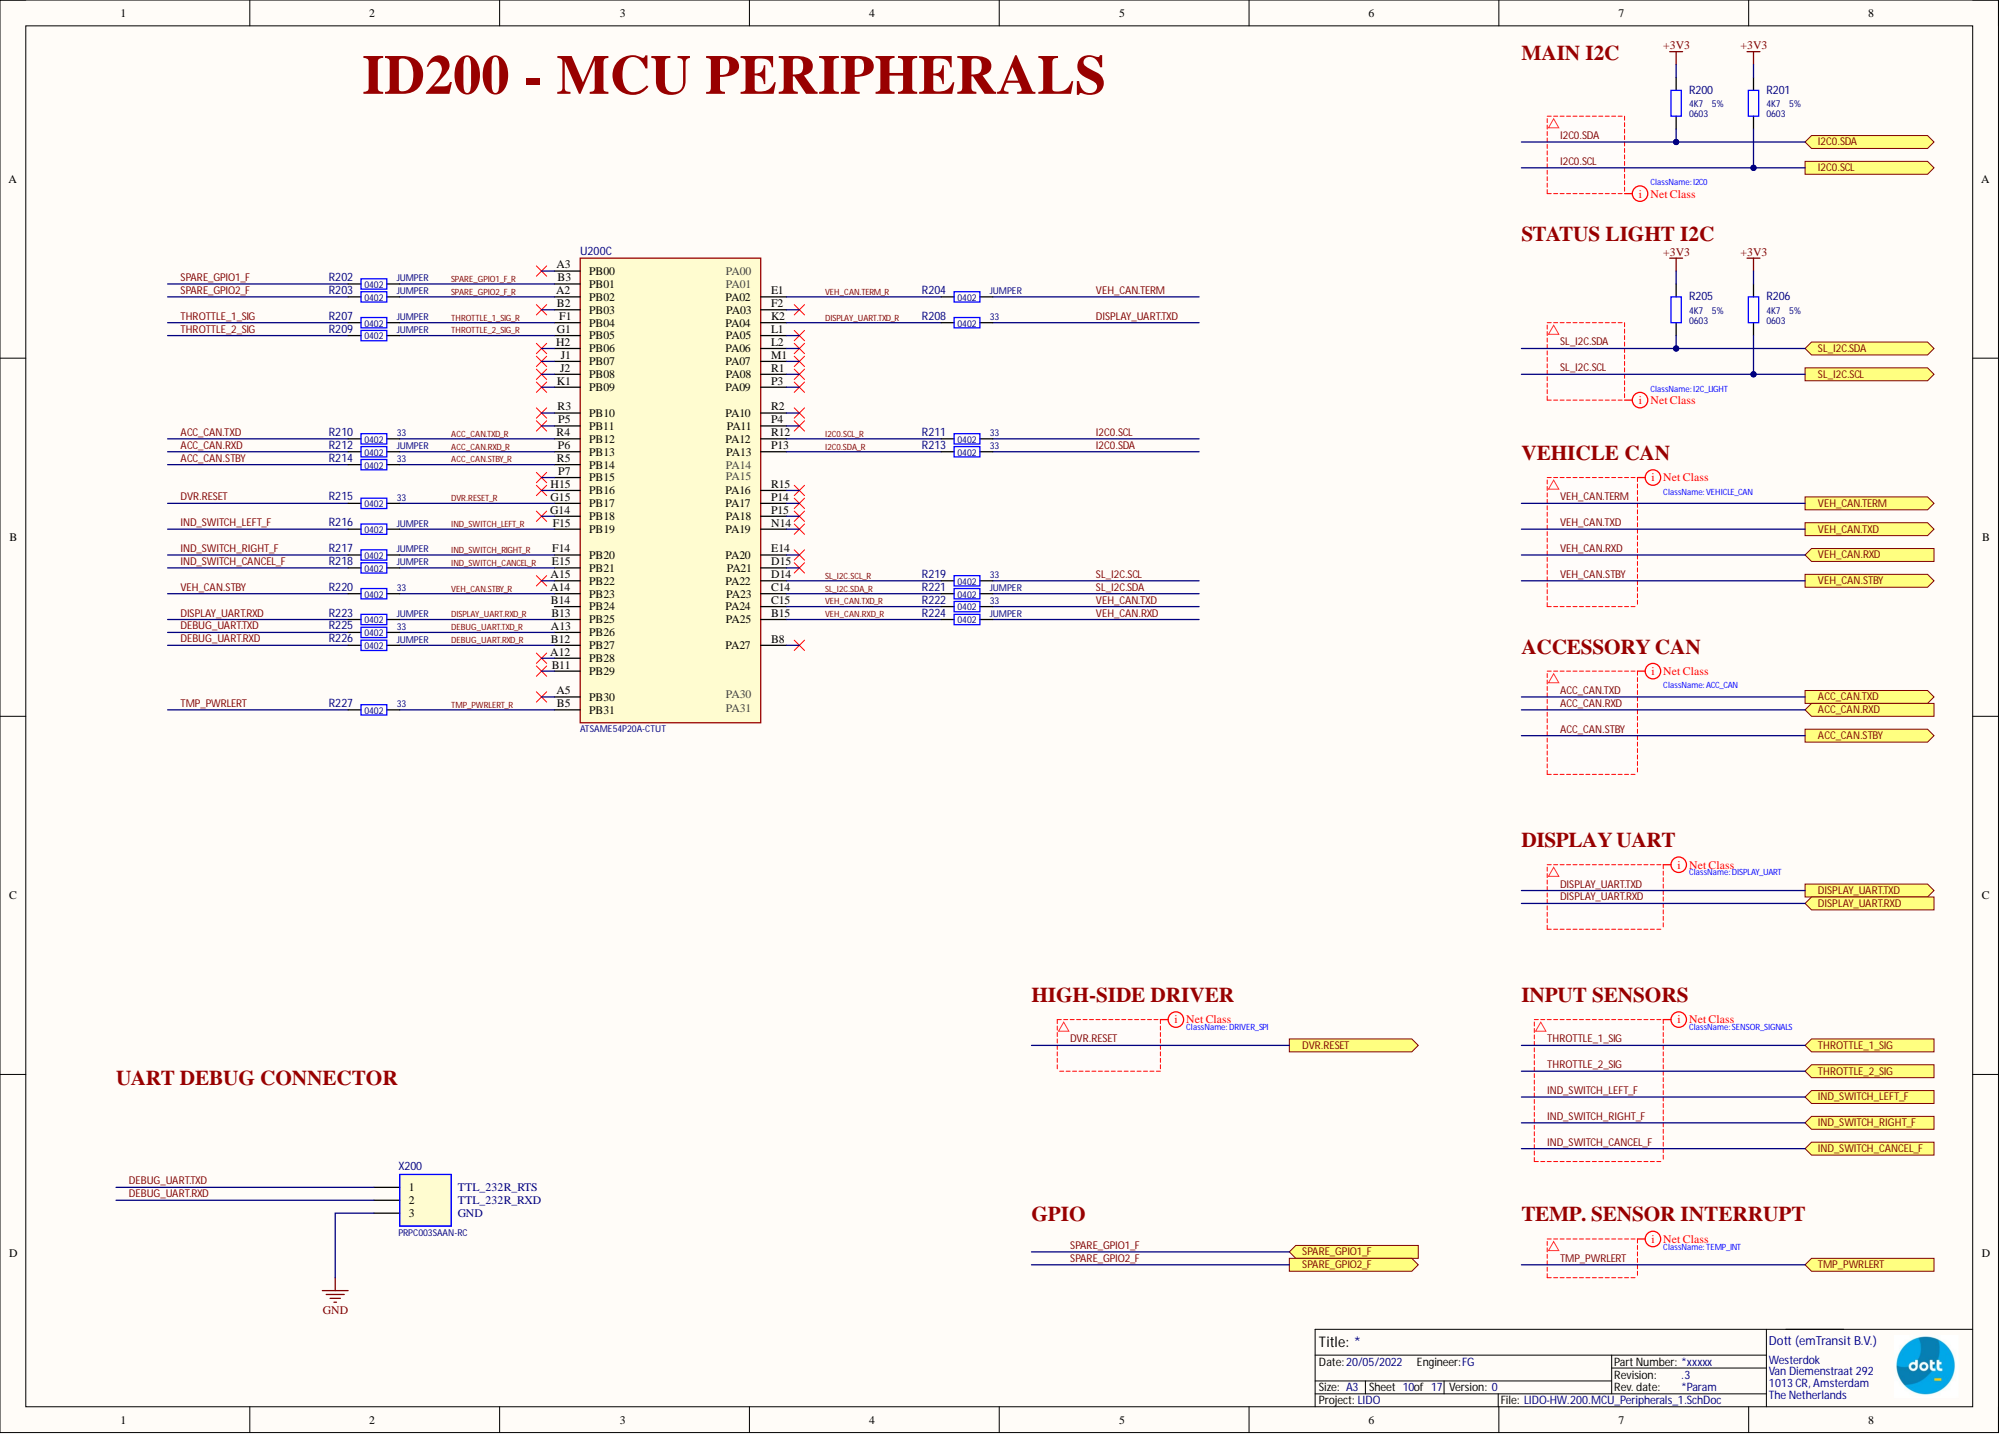
[picture p13: page 10]

DVR.RESET

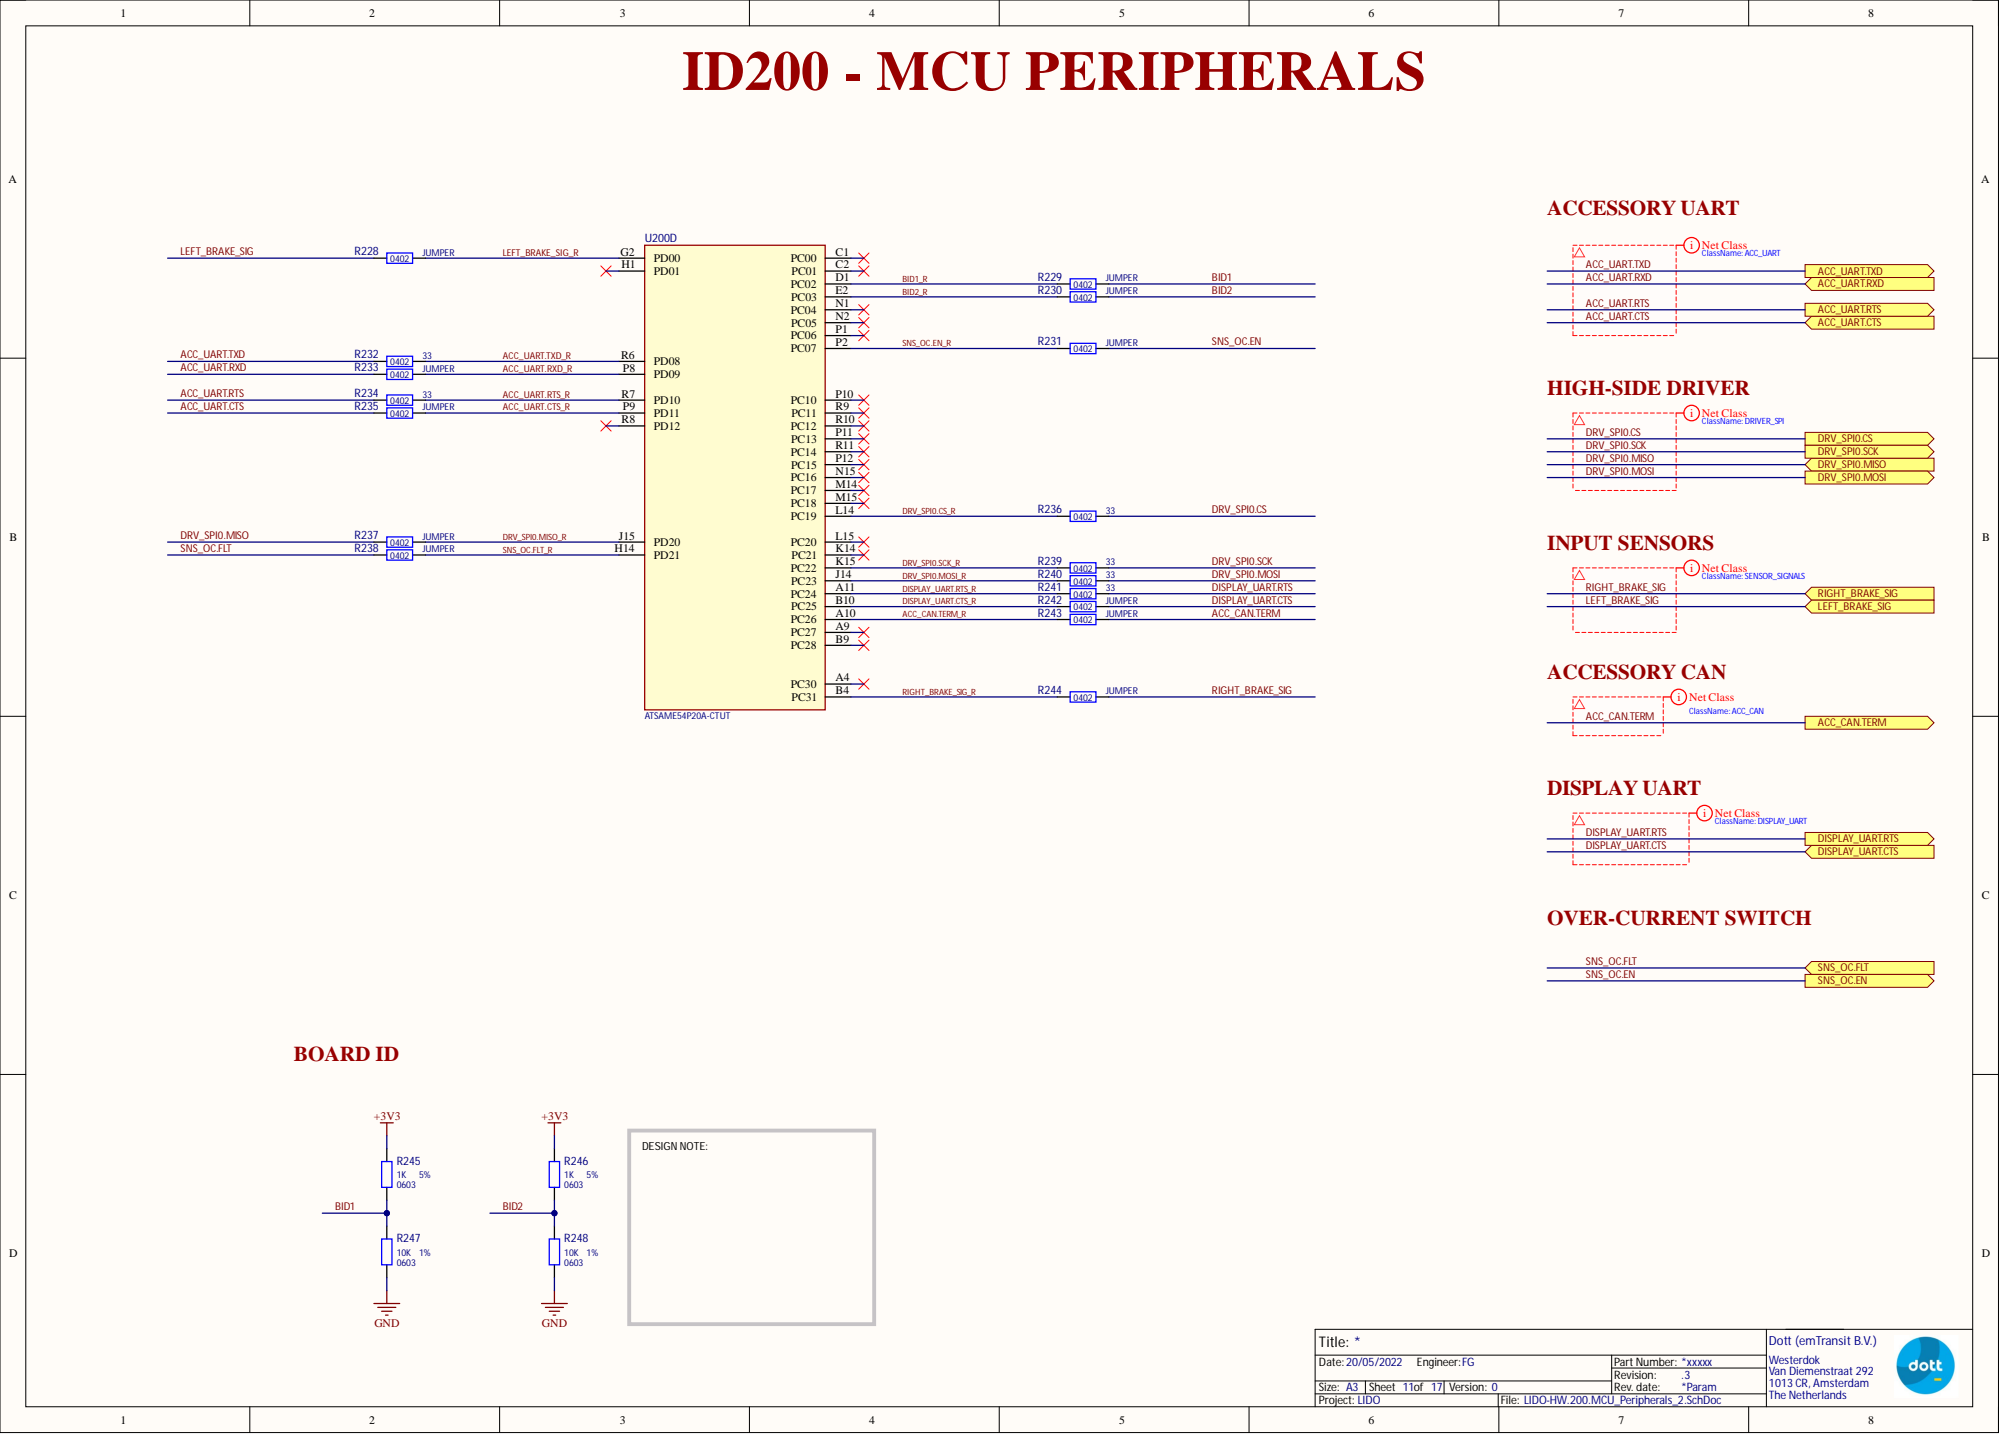
[picture p14: page 11]

DISPLAY_UART.RTS_R | 0402 R241 | 33 DISPLAY_UART.RTS
DISPLAY_UART.CTS_R | 0402 R242 | JUMPER DISPLAY_UART.CTS
ACC_CAN.TERM_R | | ACC_CAN.TERM

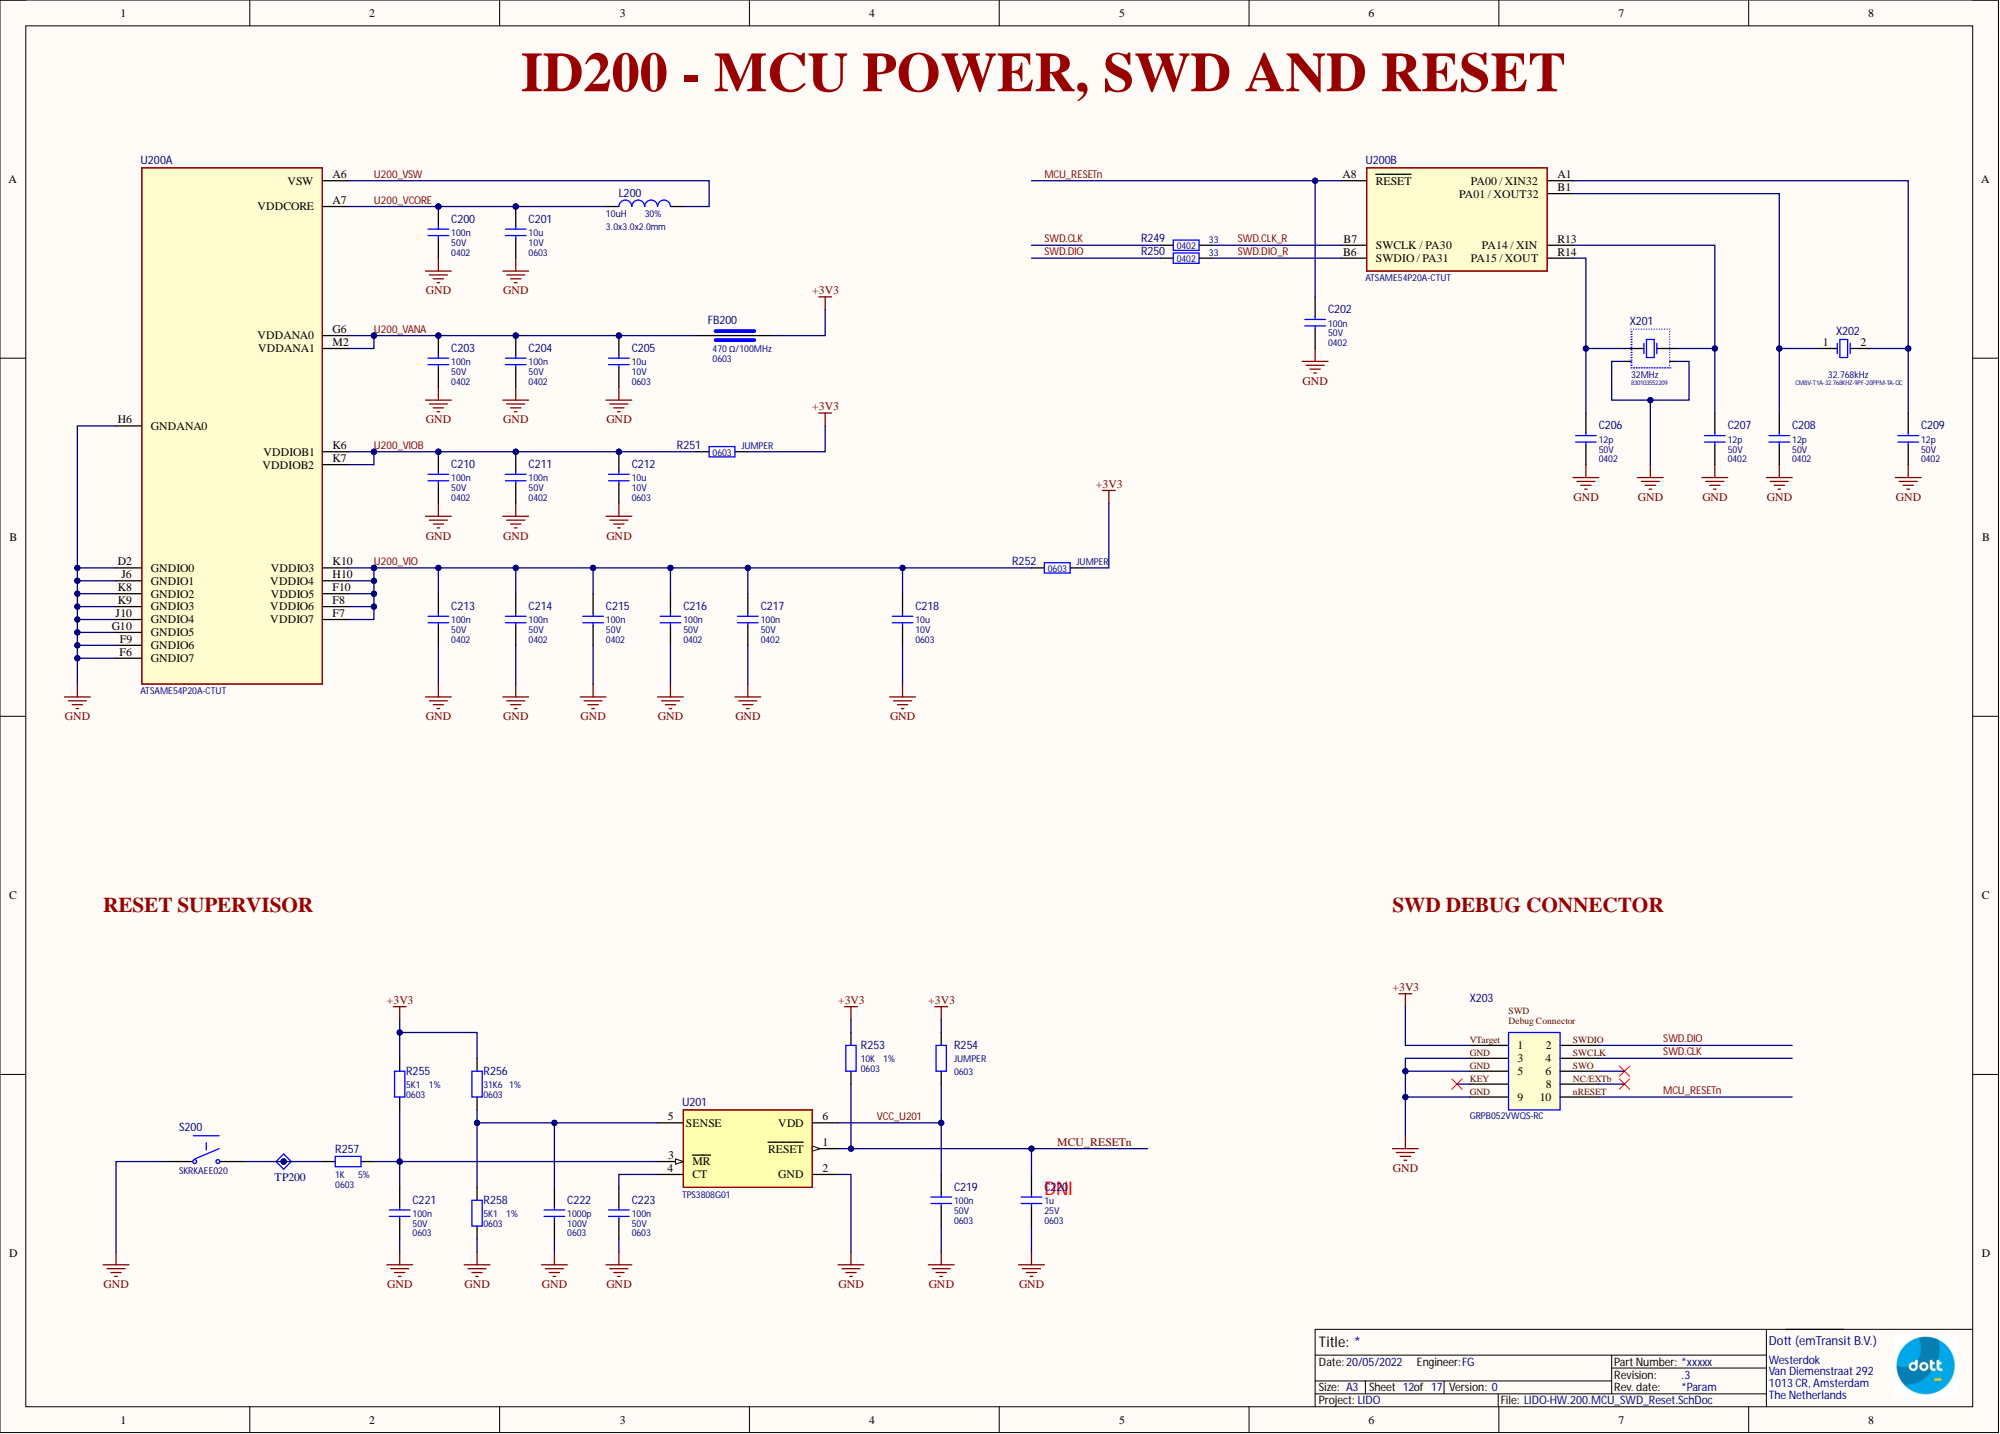
[picture p15: page 12]

ID200 - MCU POWER, SWD AND RESET

GND
KEY

VCC_U201

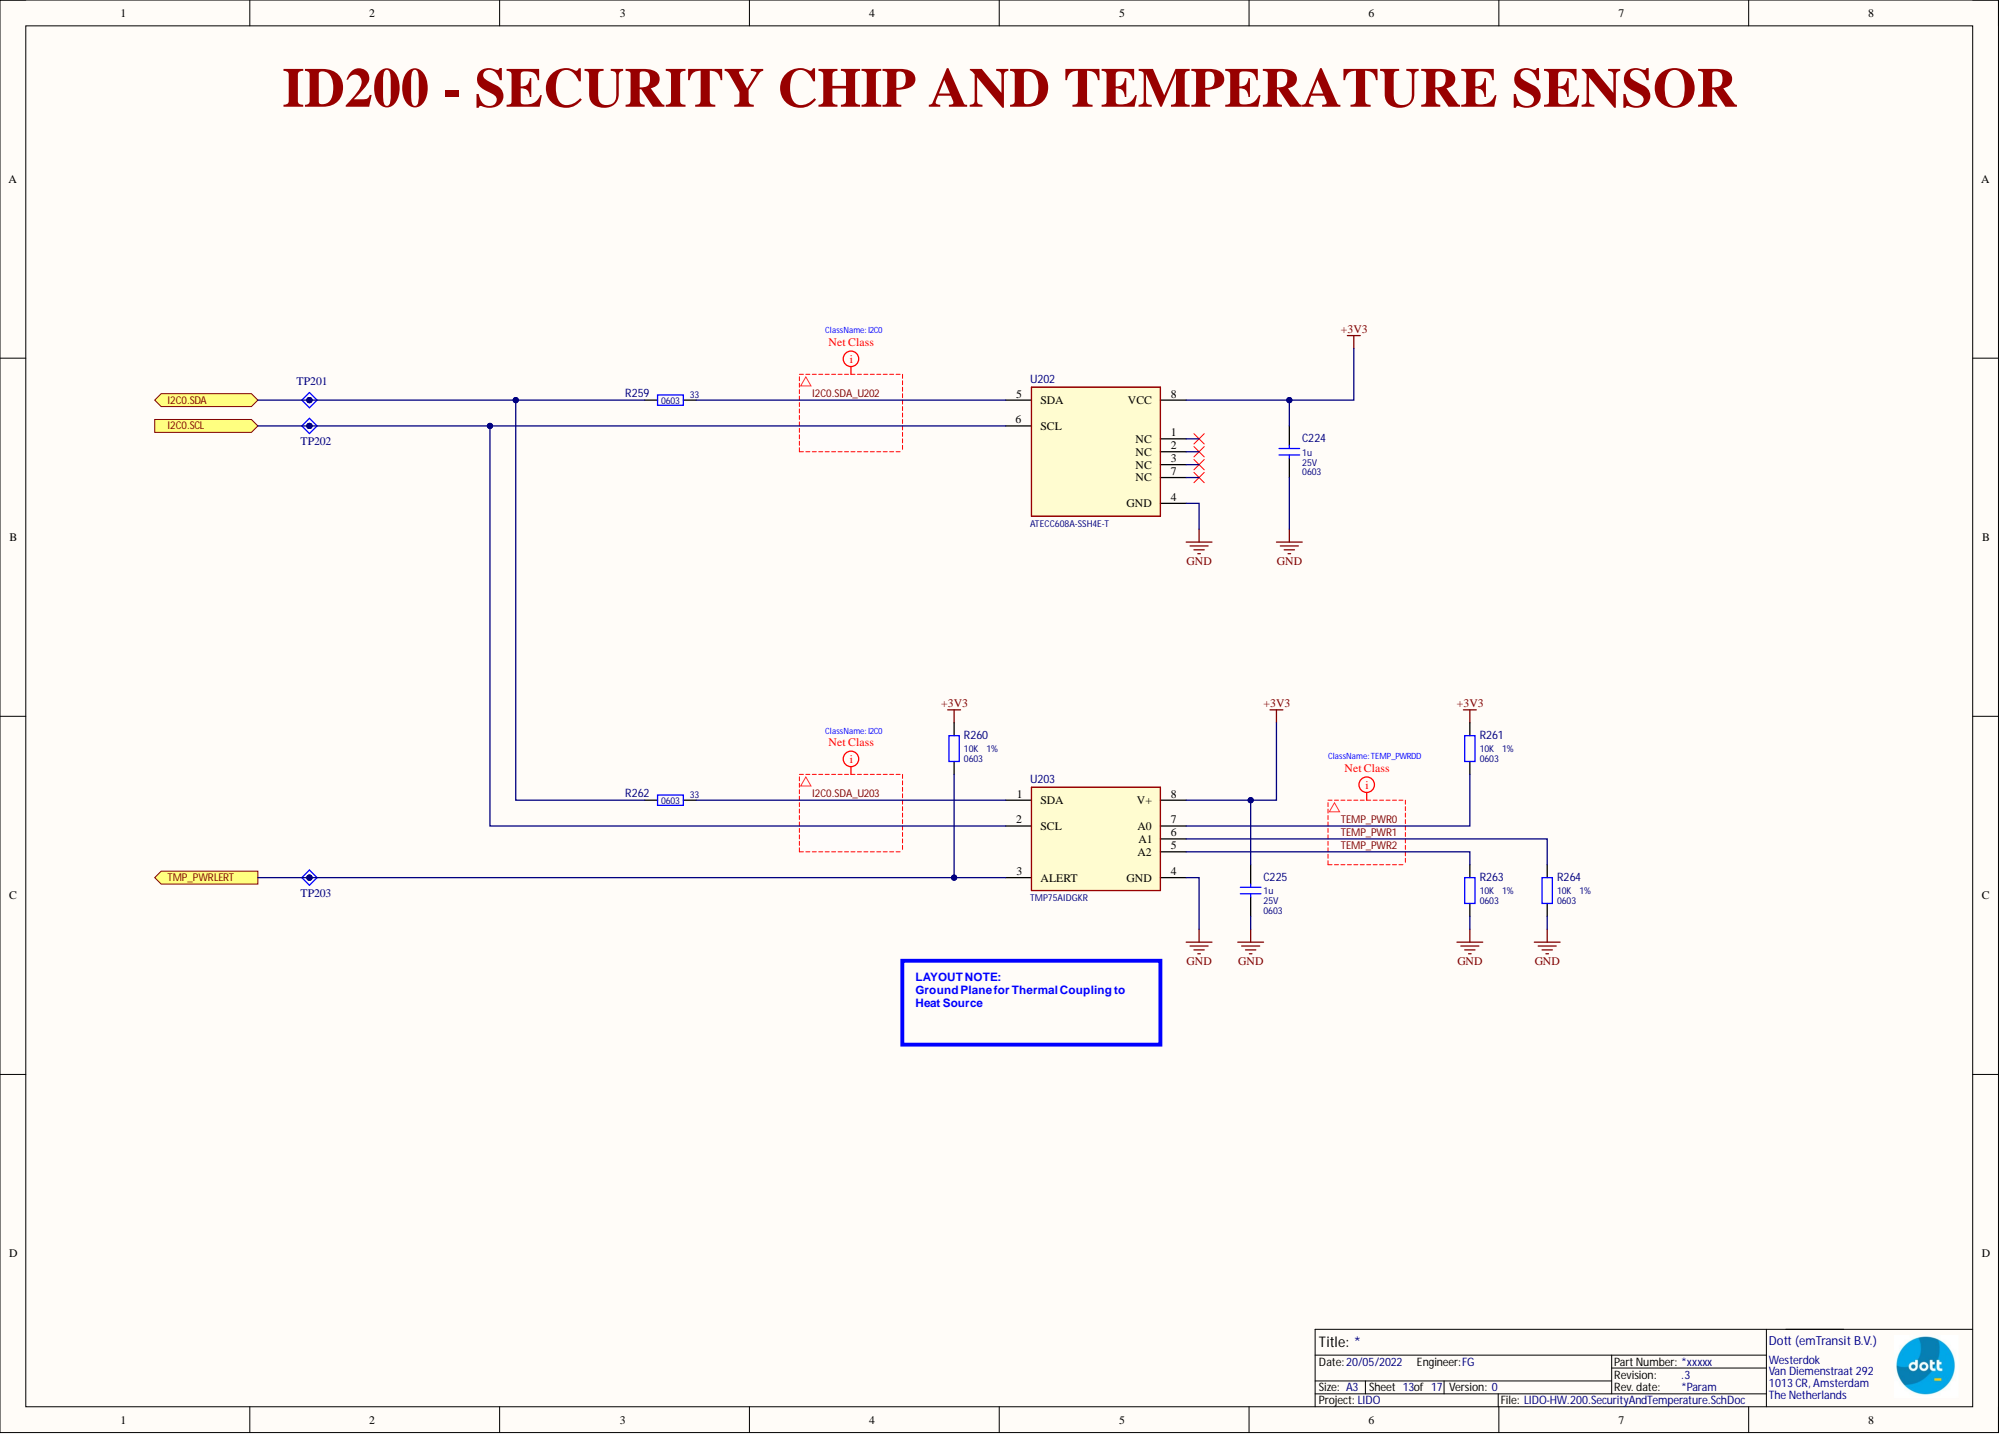
[picture p16: page 13]

ID200 - SECURITY CHIP AND TEMPERATURE SENSOR I2C0.SDA_U202 I2C0.SDA_U203 i Net Class ClassName: I2C0 i Net Class ClassName: I2C0

6 | TEMP_PWR 1

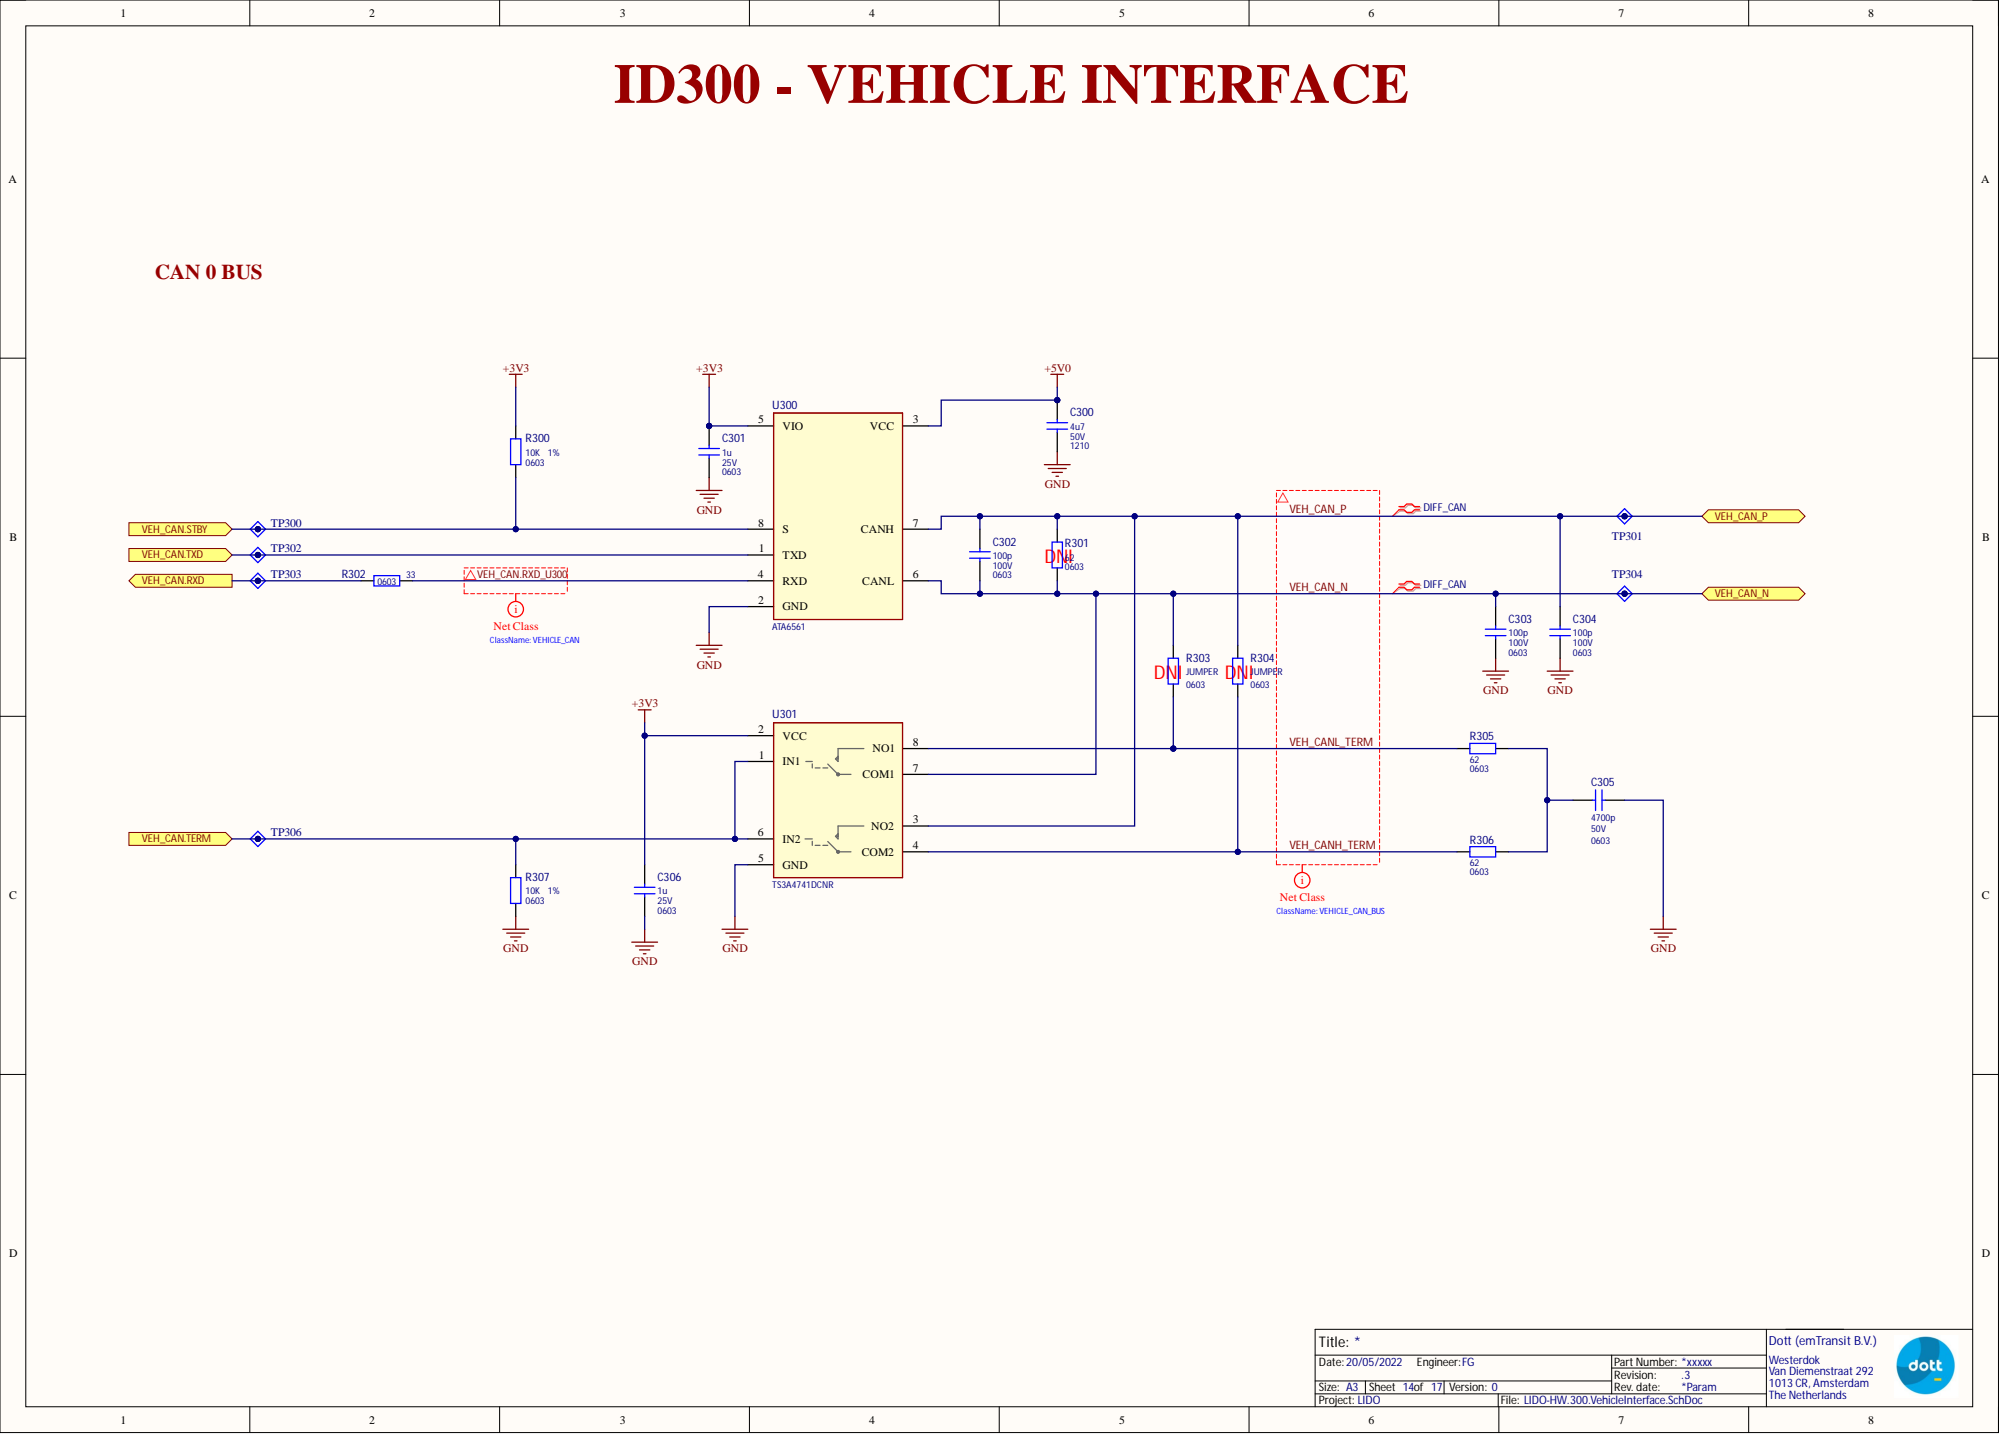
[picture p17: page 14]

VEH_CA N L_TER M

7 | | VEH_CA NH_TER M

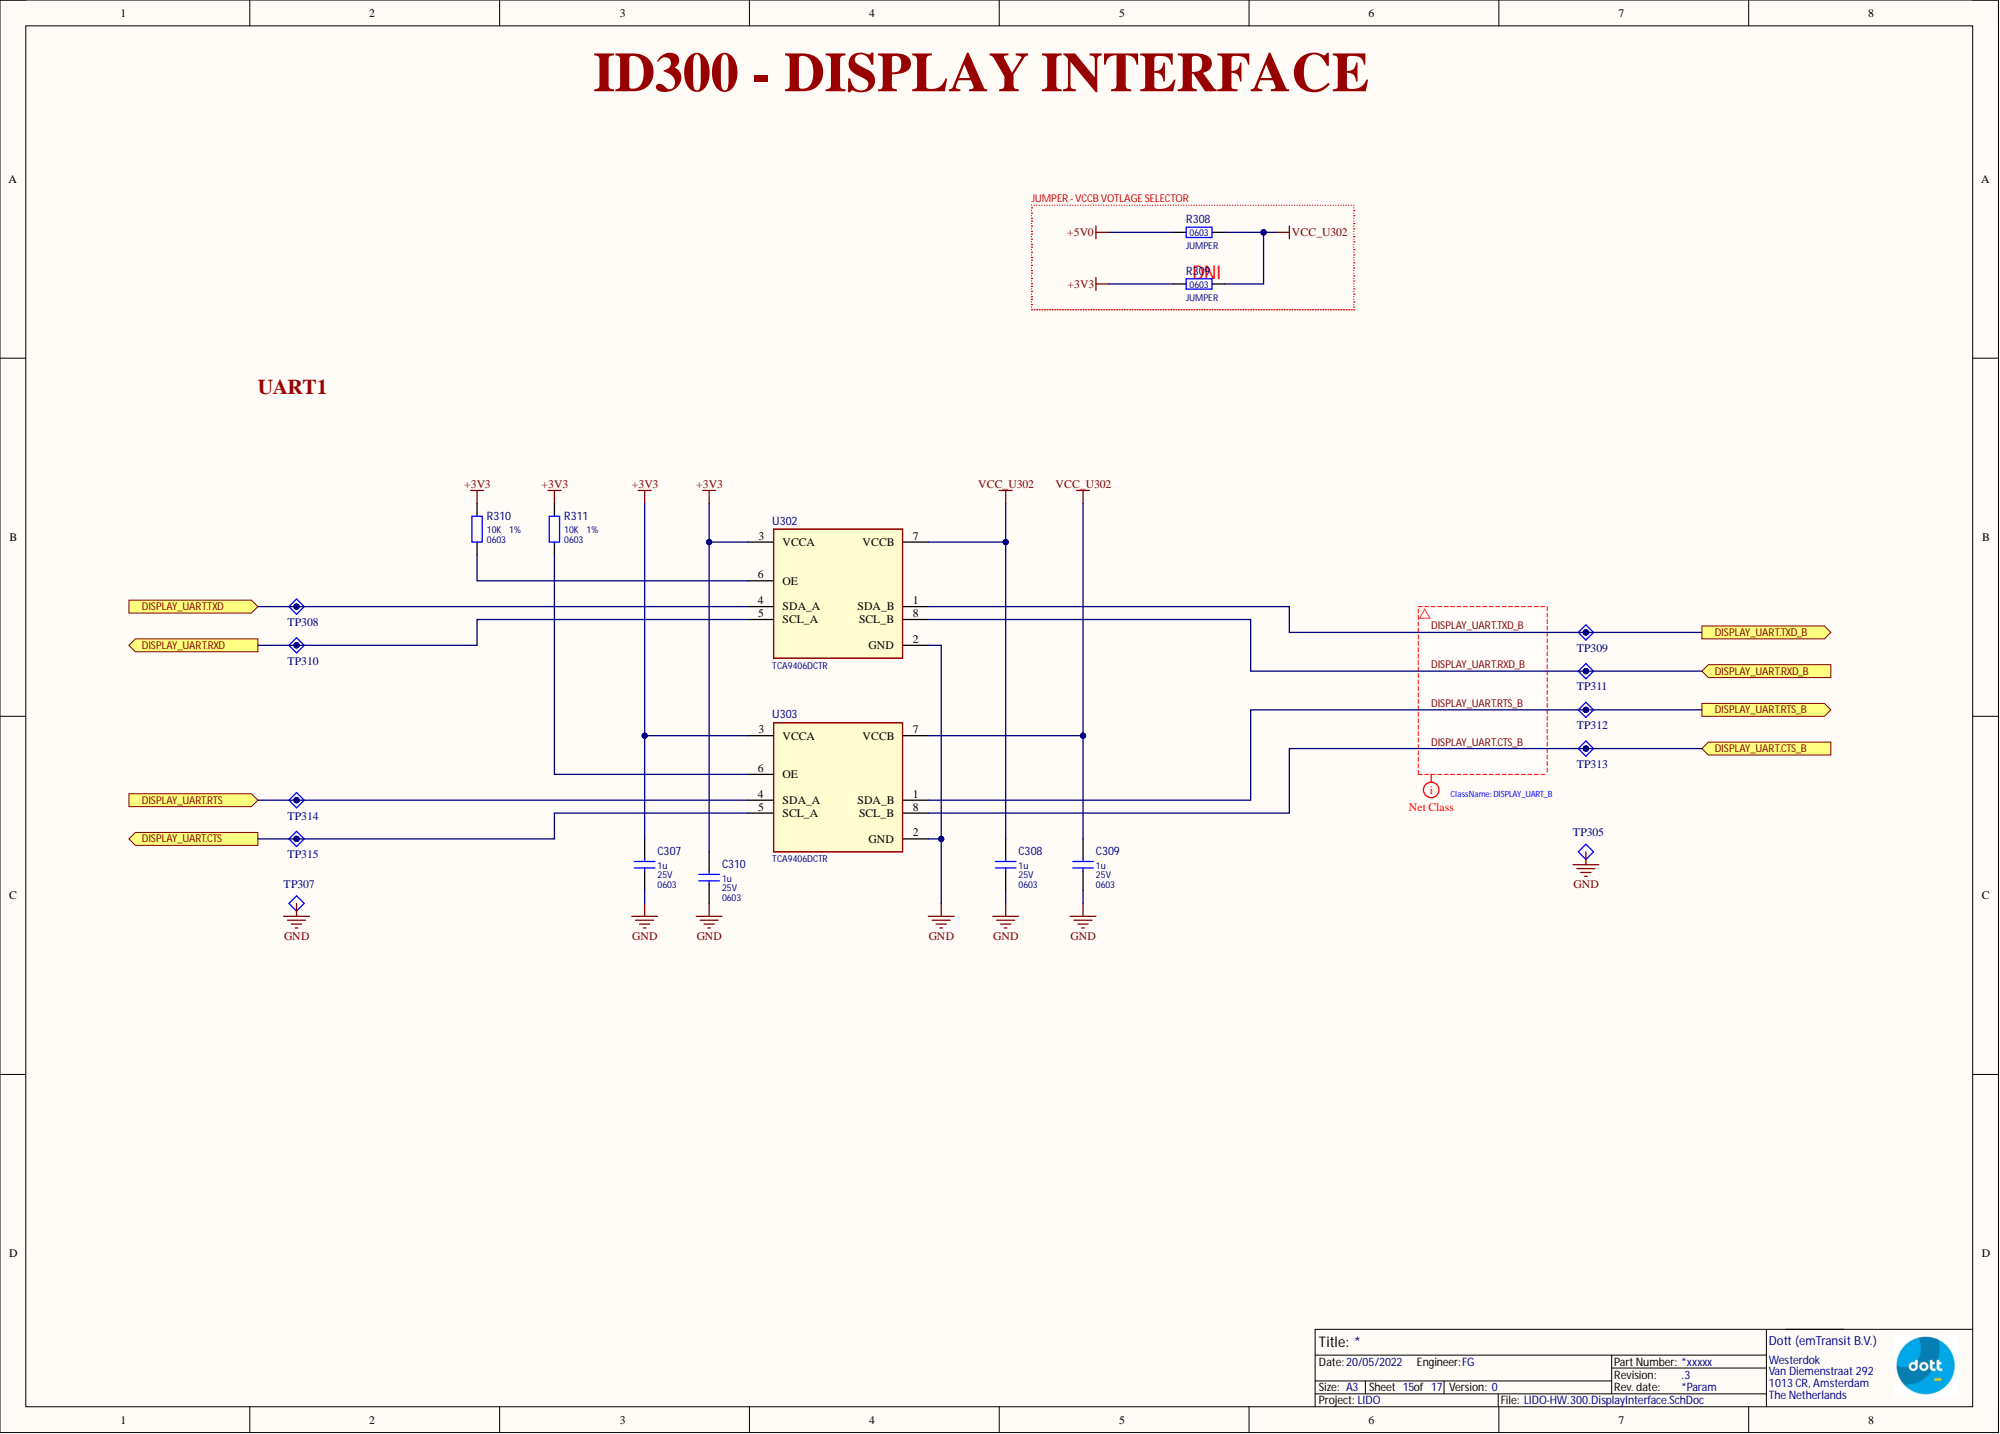
[picture p18: page 15]

JUMPER - VCCB VOTLAGE SELECTOR

DISPLAY_UART.RXD_B | TP309

DISPLAY_UART.RTS_B

LIDO-HW.300.DisplayInterface.SchDoc

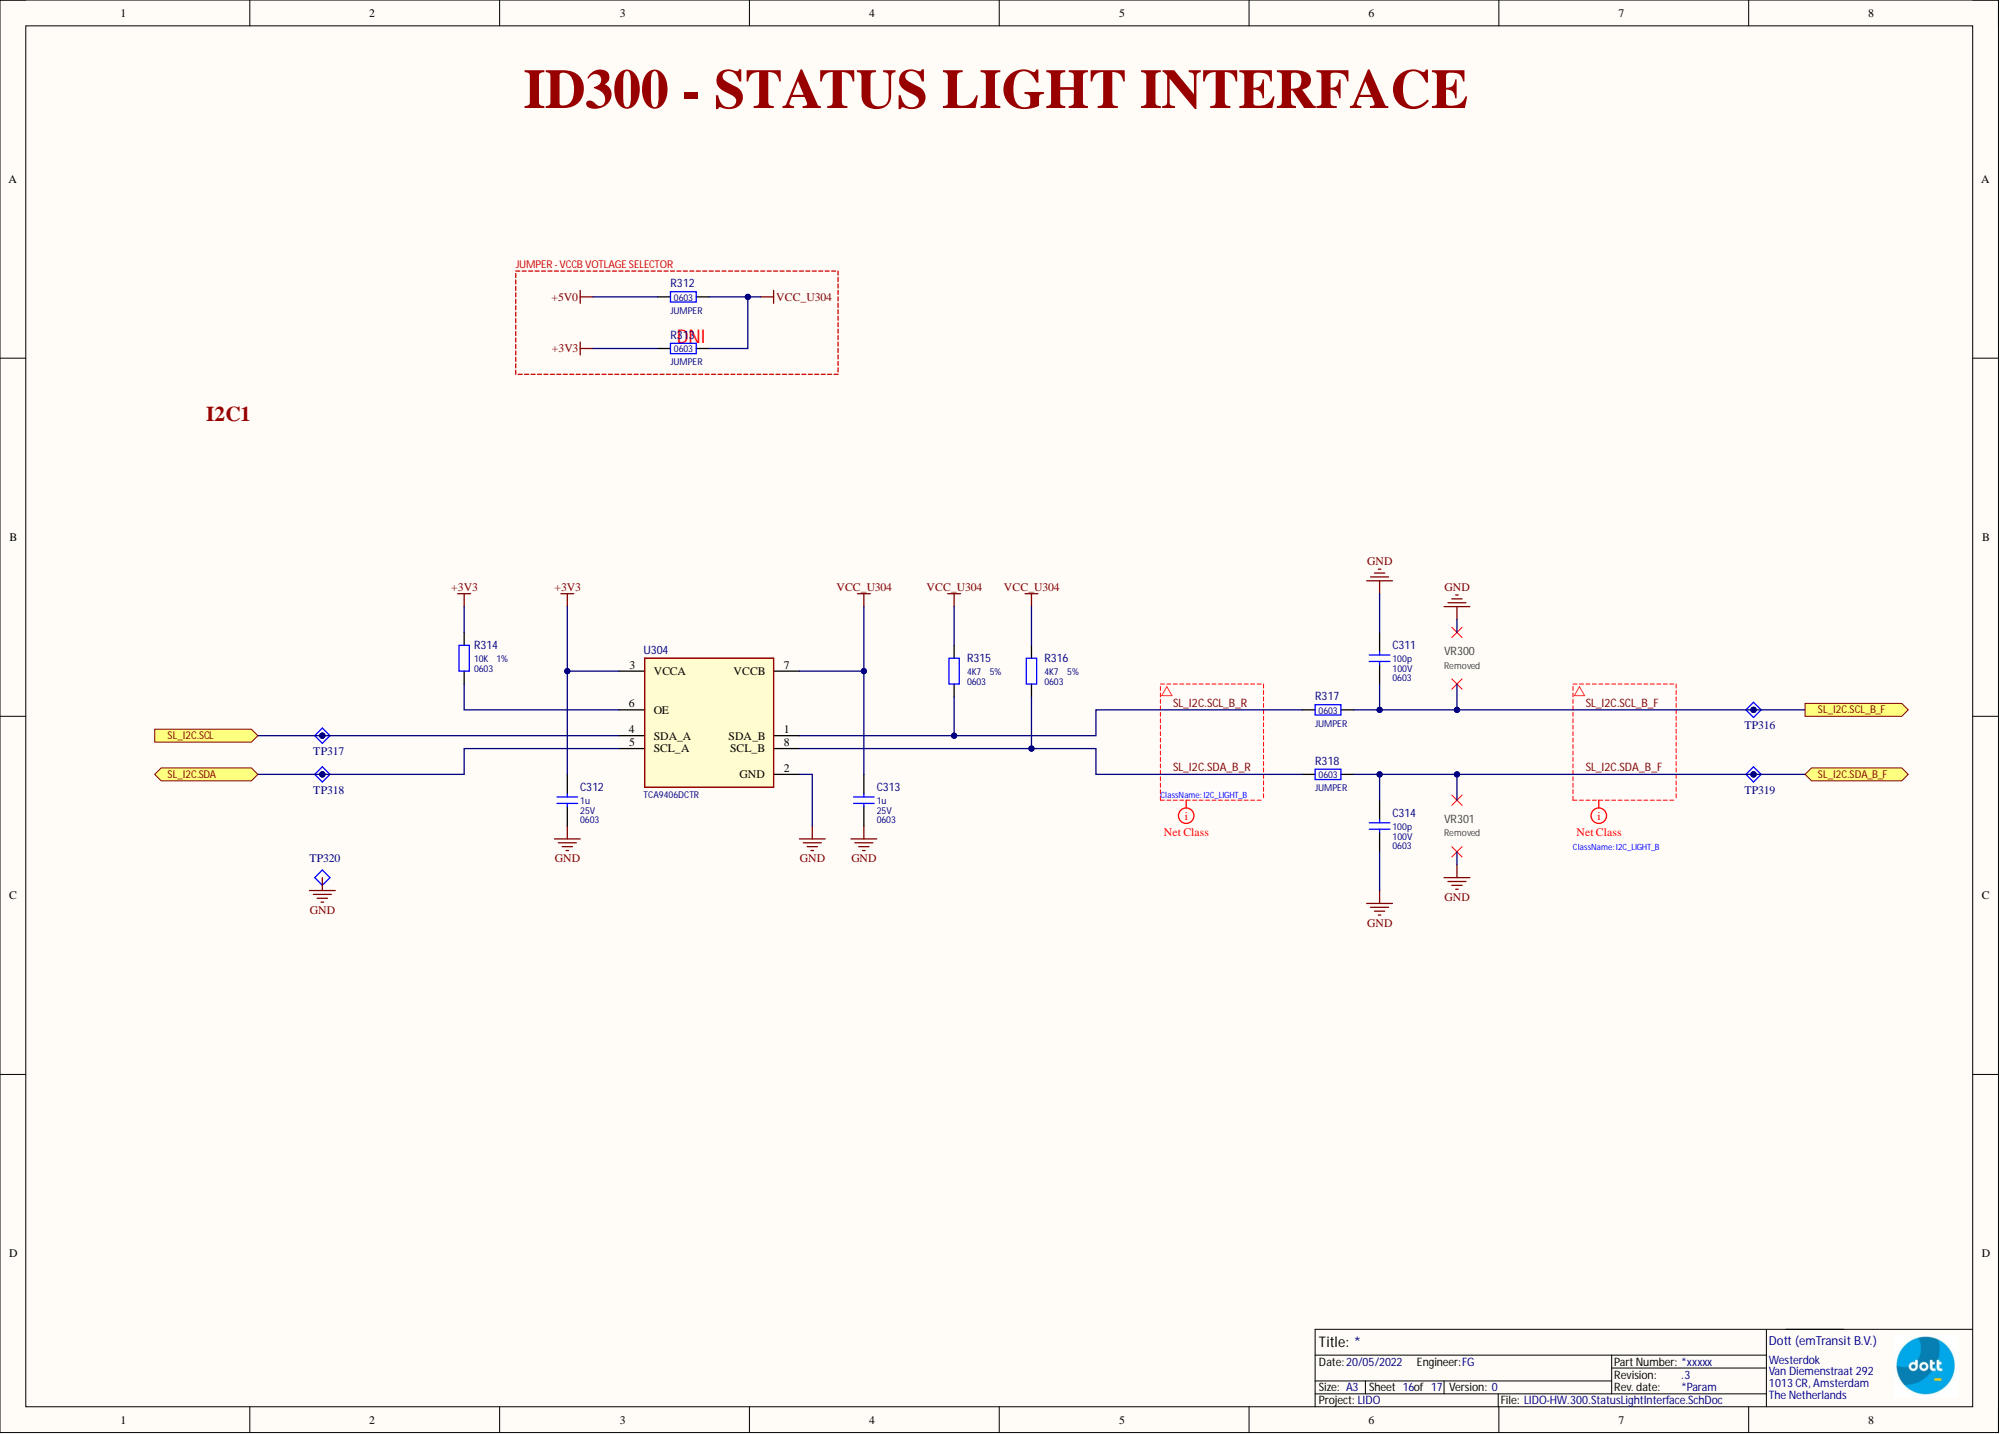
[picture p19: page 16]

JUMPER - VCCB VOTLAGE SELECTOR

SDA_A 4 | JUMPER R318

ClassName: I2C_LIGHT_B | 0603

LIDO-HW.300.StatusLightInterface.SchDoc

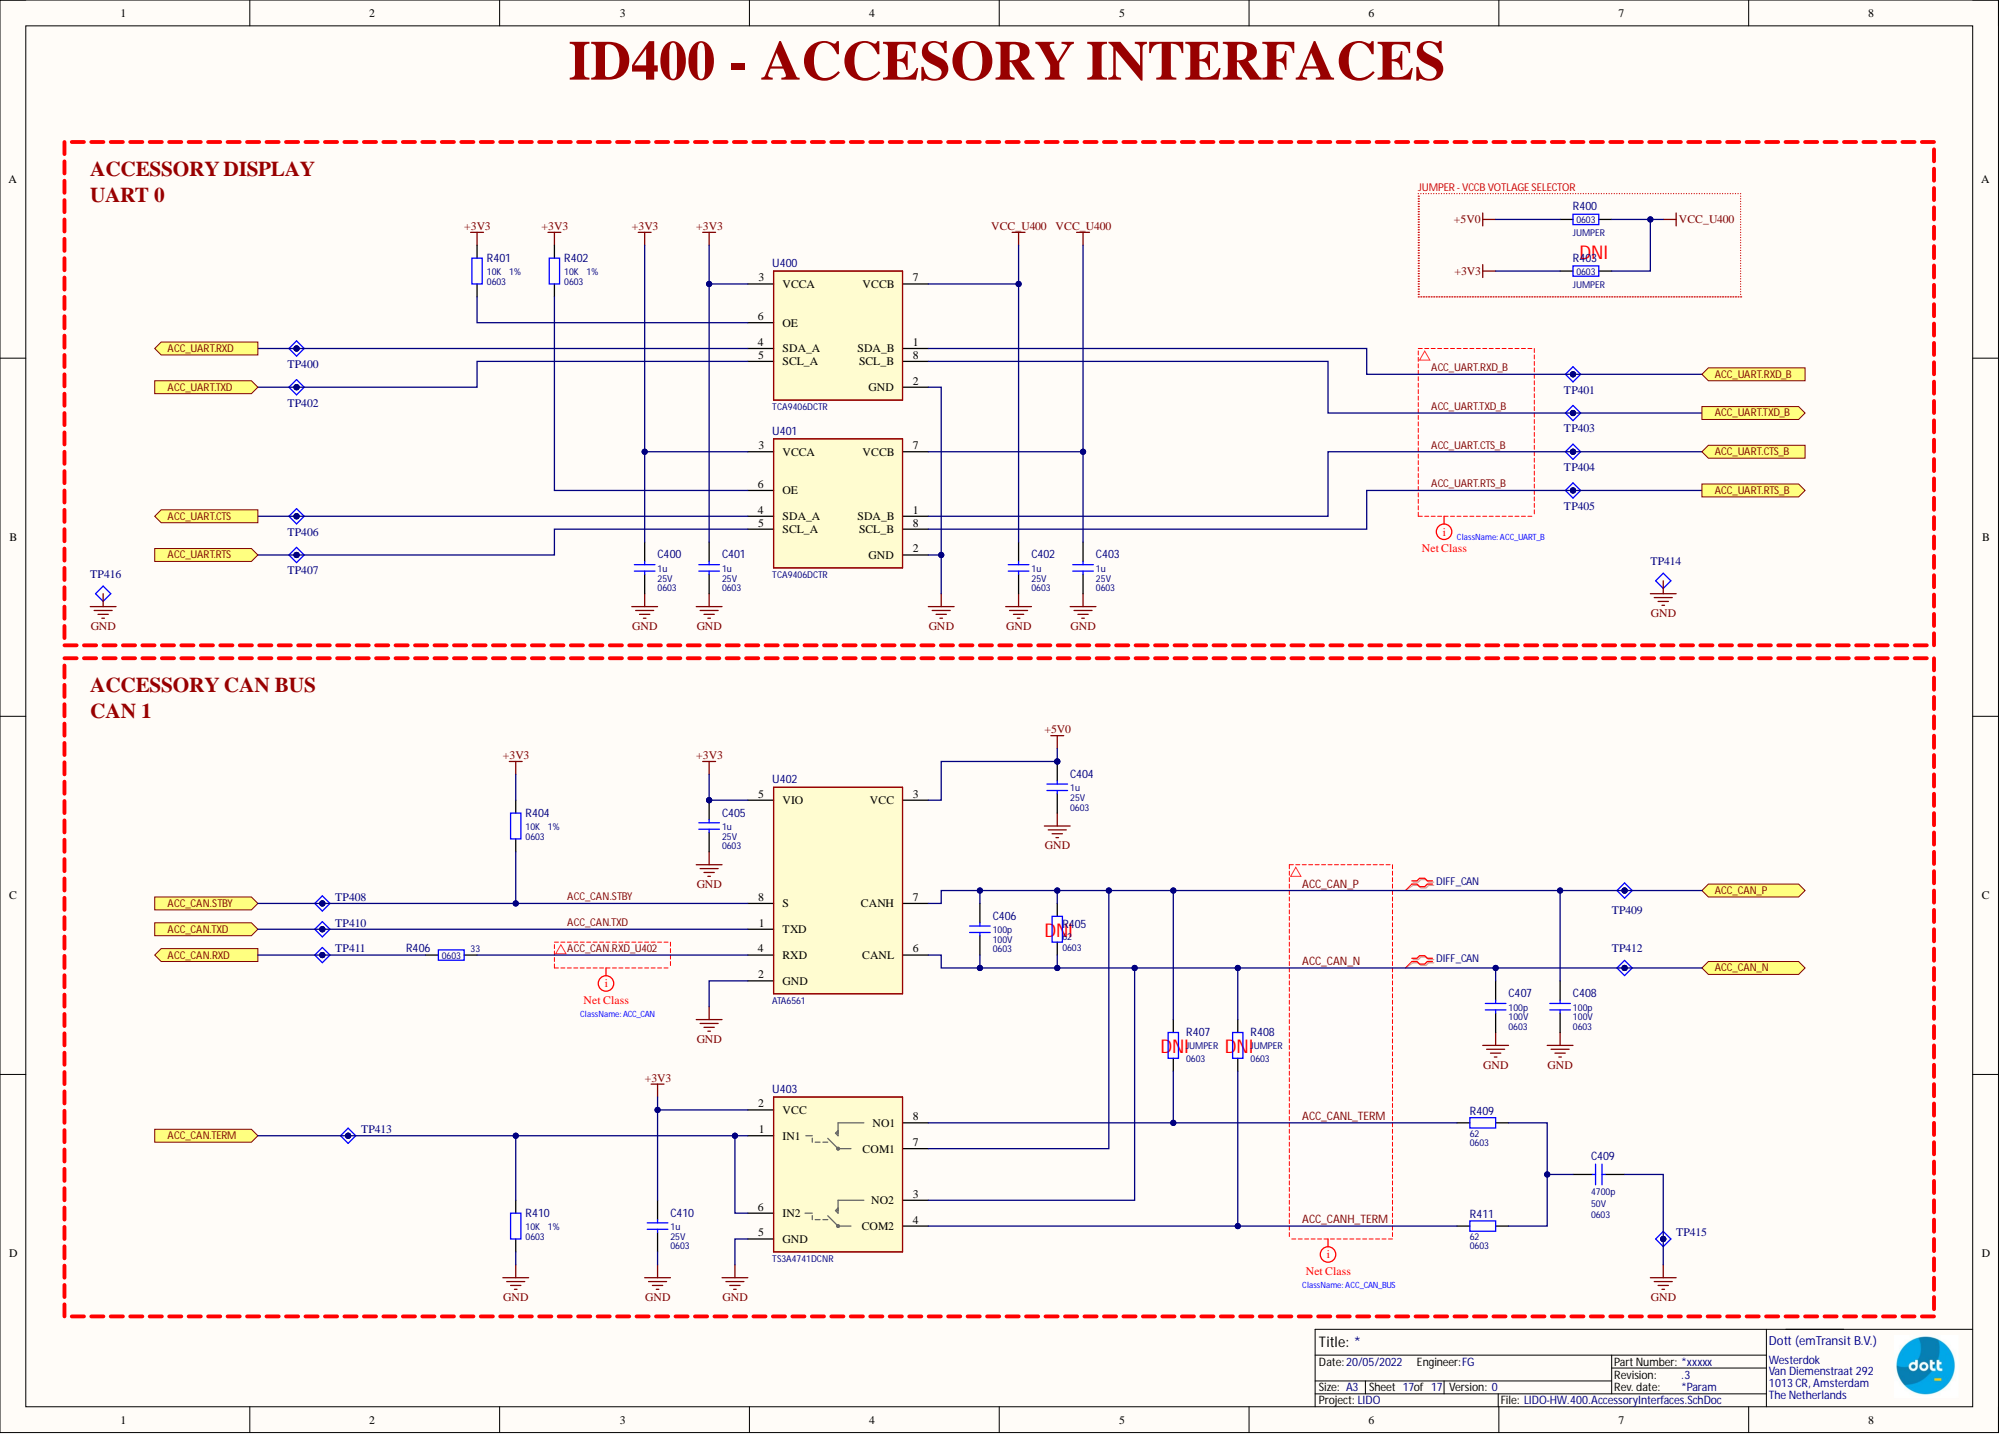
[picture p20: page 17]

JUMPER - VCCB VOTLAGE SELECTOR

SDA_A 4

TP400 | | | ACC_UART.RXD_B

ACC_UART.TXD_B | TP401

ACC_UART.CTS_B

ACC_CAN_N | DIFF_CAN

ACC_CANL_TERM

LIDO-HW.400.AccessoryInterfaces.SchDoc
