ridedott/lido-hardware/LIDO_HW_2022_04_V01/Output Documents/02_Assembly Drawings/Assy Drw LIDO_V03_DEVELOPMENT_04_07_2022.PDF

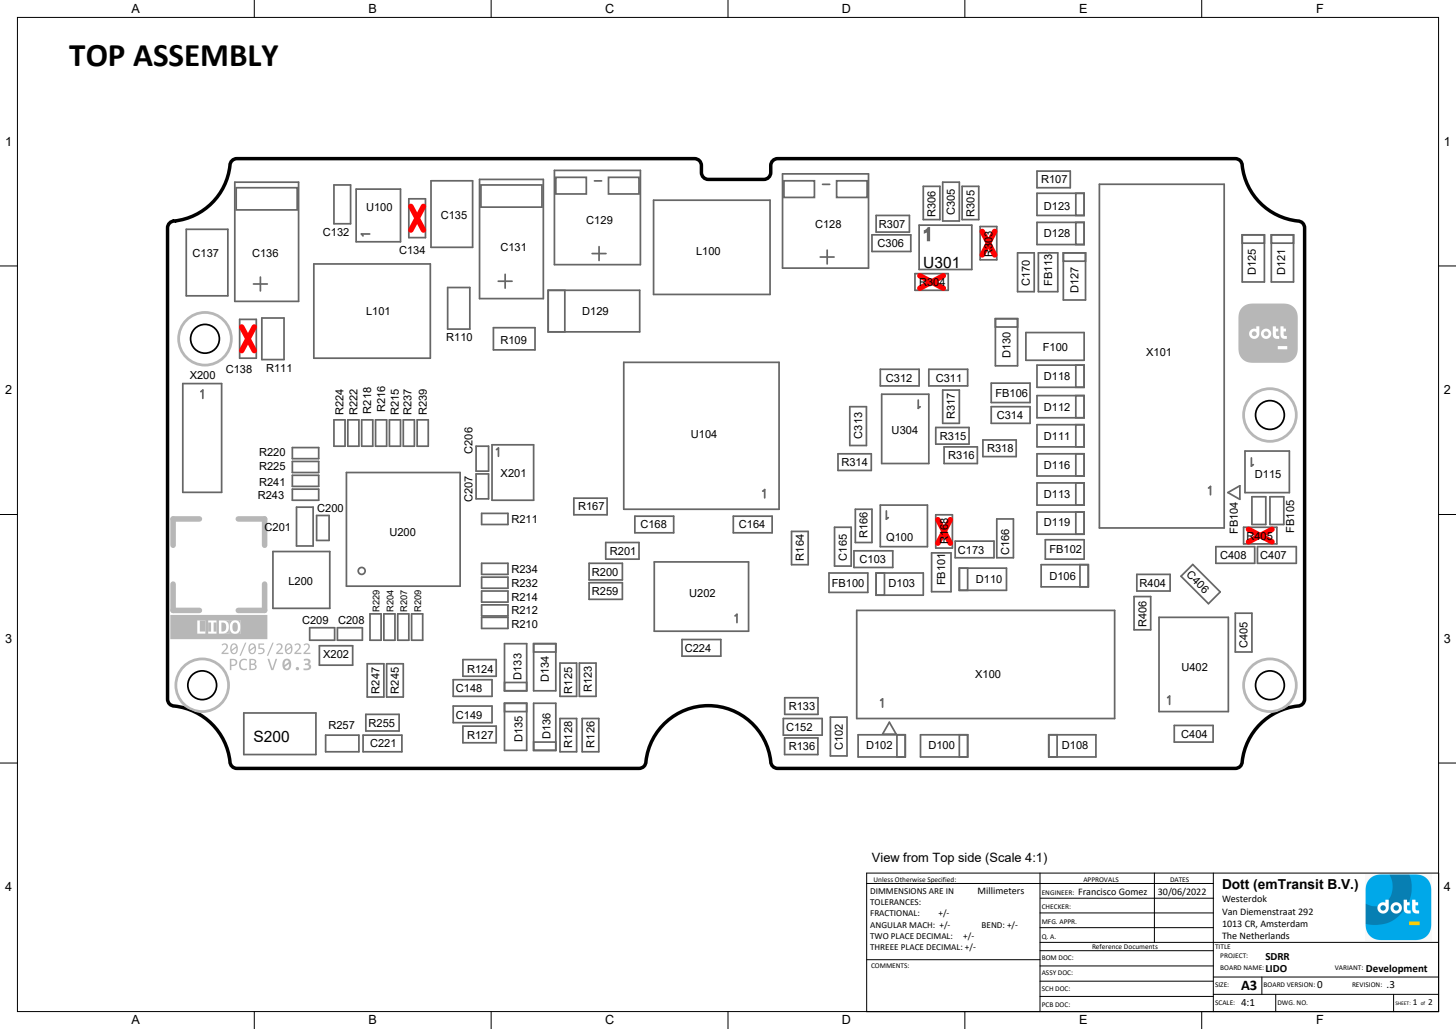
[picture p21: page 1]

View from Top side (Scale 4:1)

Unless Otherwise Specified: | APPROVALS | DATES | Dott (emTransit B.V.) Westerdok Van Diemenstraat 292 1013 CR, Amsterdam The Netherlands
DIMMENSIONS ARE IN Millimeters TOLERANCES: FRACTIONAL: +/-ANGULAR MACH: +/-BEND: +/-TWO PLACE DECIMAL: +/-THREEE PLACE DECIMAL: +/- | Francisco Gomez ENGINEER: | 30/06/2022

CHECKER:
MFG. APPR.
Q. A.

Reference Documents | | TITLE PROJECT: SDRR BOARD NAME:LIDO VARIANT: Development

SIZE: A3 | BOARD VERSION: 0 REVISION: .3

PCB DOC: | 4:1 SCALE: | DWG. NO. | SHEET: of 1 2

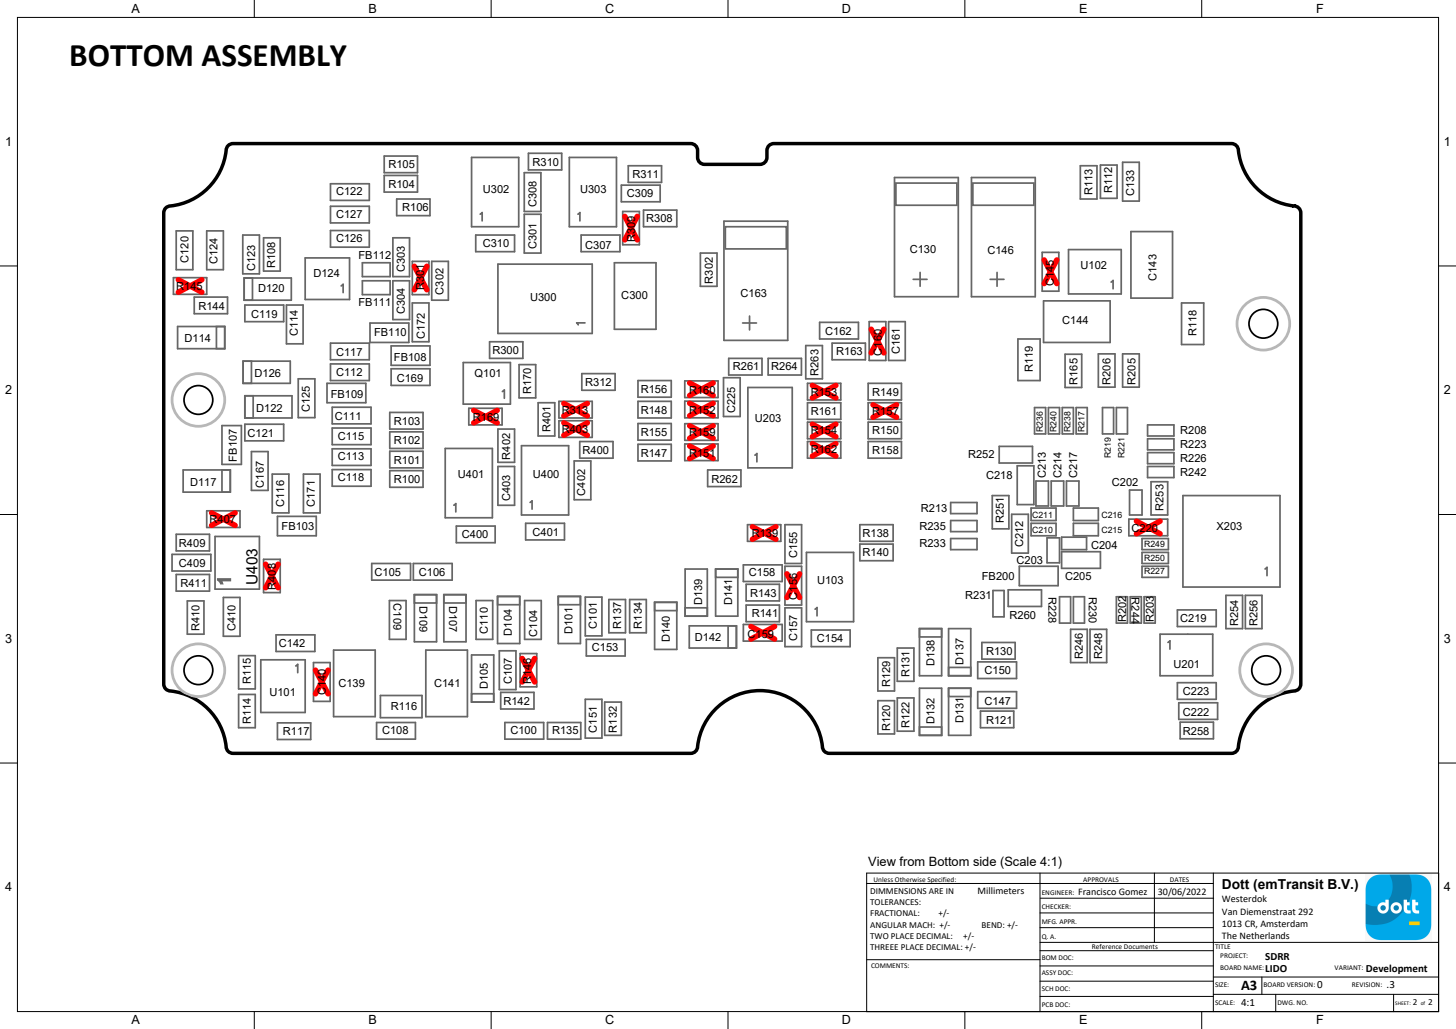
[picture p22: page 2]

View from Bottom side (Scale 4:1)

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

CHECKER:
MFG. APPR.
Q. A.

Reference Documents | | TITLE PROJECT: SDRR BOARD NAME:LIDO VARIANT: Development

SIZE: A3 | BOARD VERSION: 0 REVISION: .3

PCB DOC: | 4:1 SCALE: | DWG. NO. | SHEET: of 2 2
