ridedott/lido-hardware/LIDO_HW_2022_04_V01/Output Documents/01_Schematics/LIDO_V01_29042022.PDF

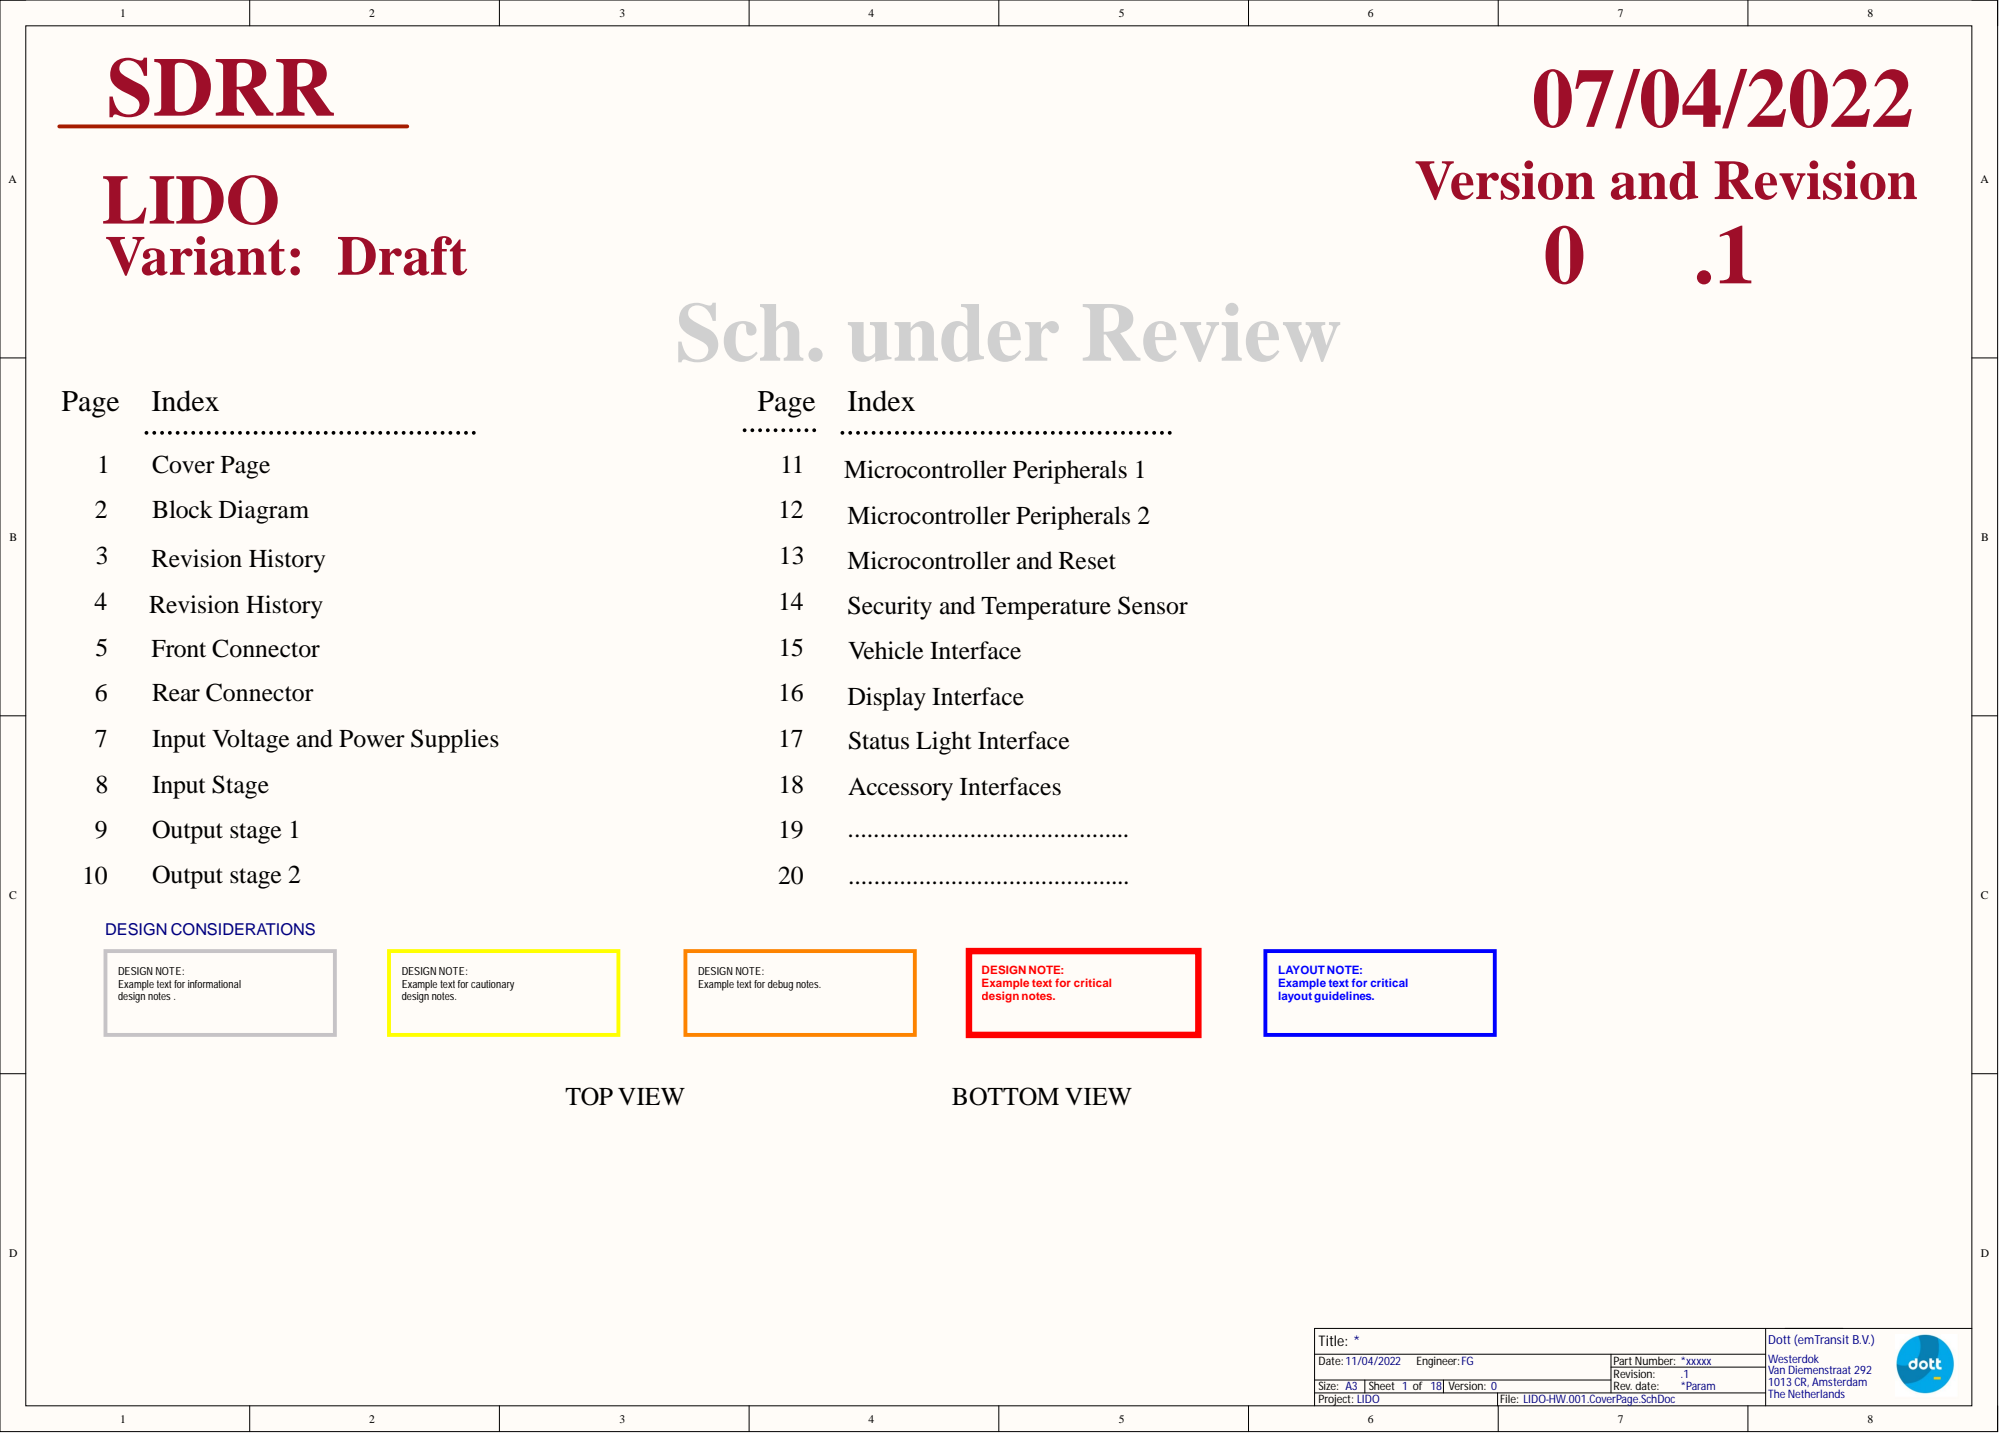
[picture p40: page 1]

Version and Revision LIDO

Input Voltage and Power Supplies

DESIGN NOTE:
Example text for informational
design notes .

Example text for cautionary
design notes.

Example text for debug notes.

Example text for critical

LAYOUT NOTE:
layout guidelines.

LIDO-HW.001.CoverPage.SchDoc

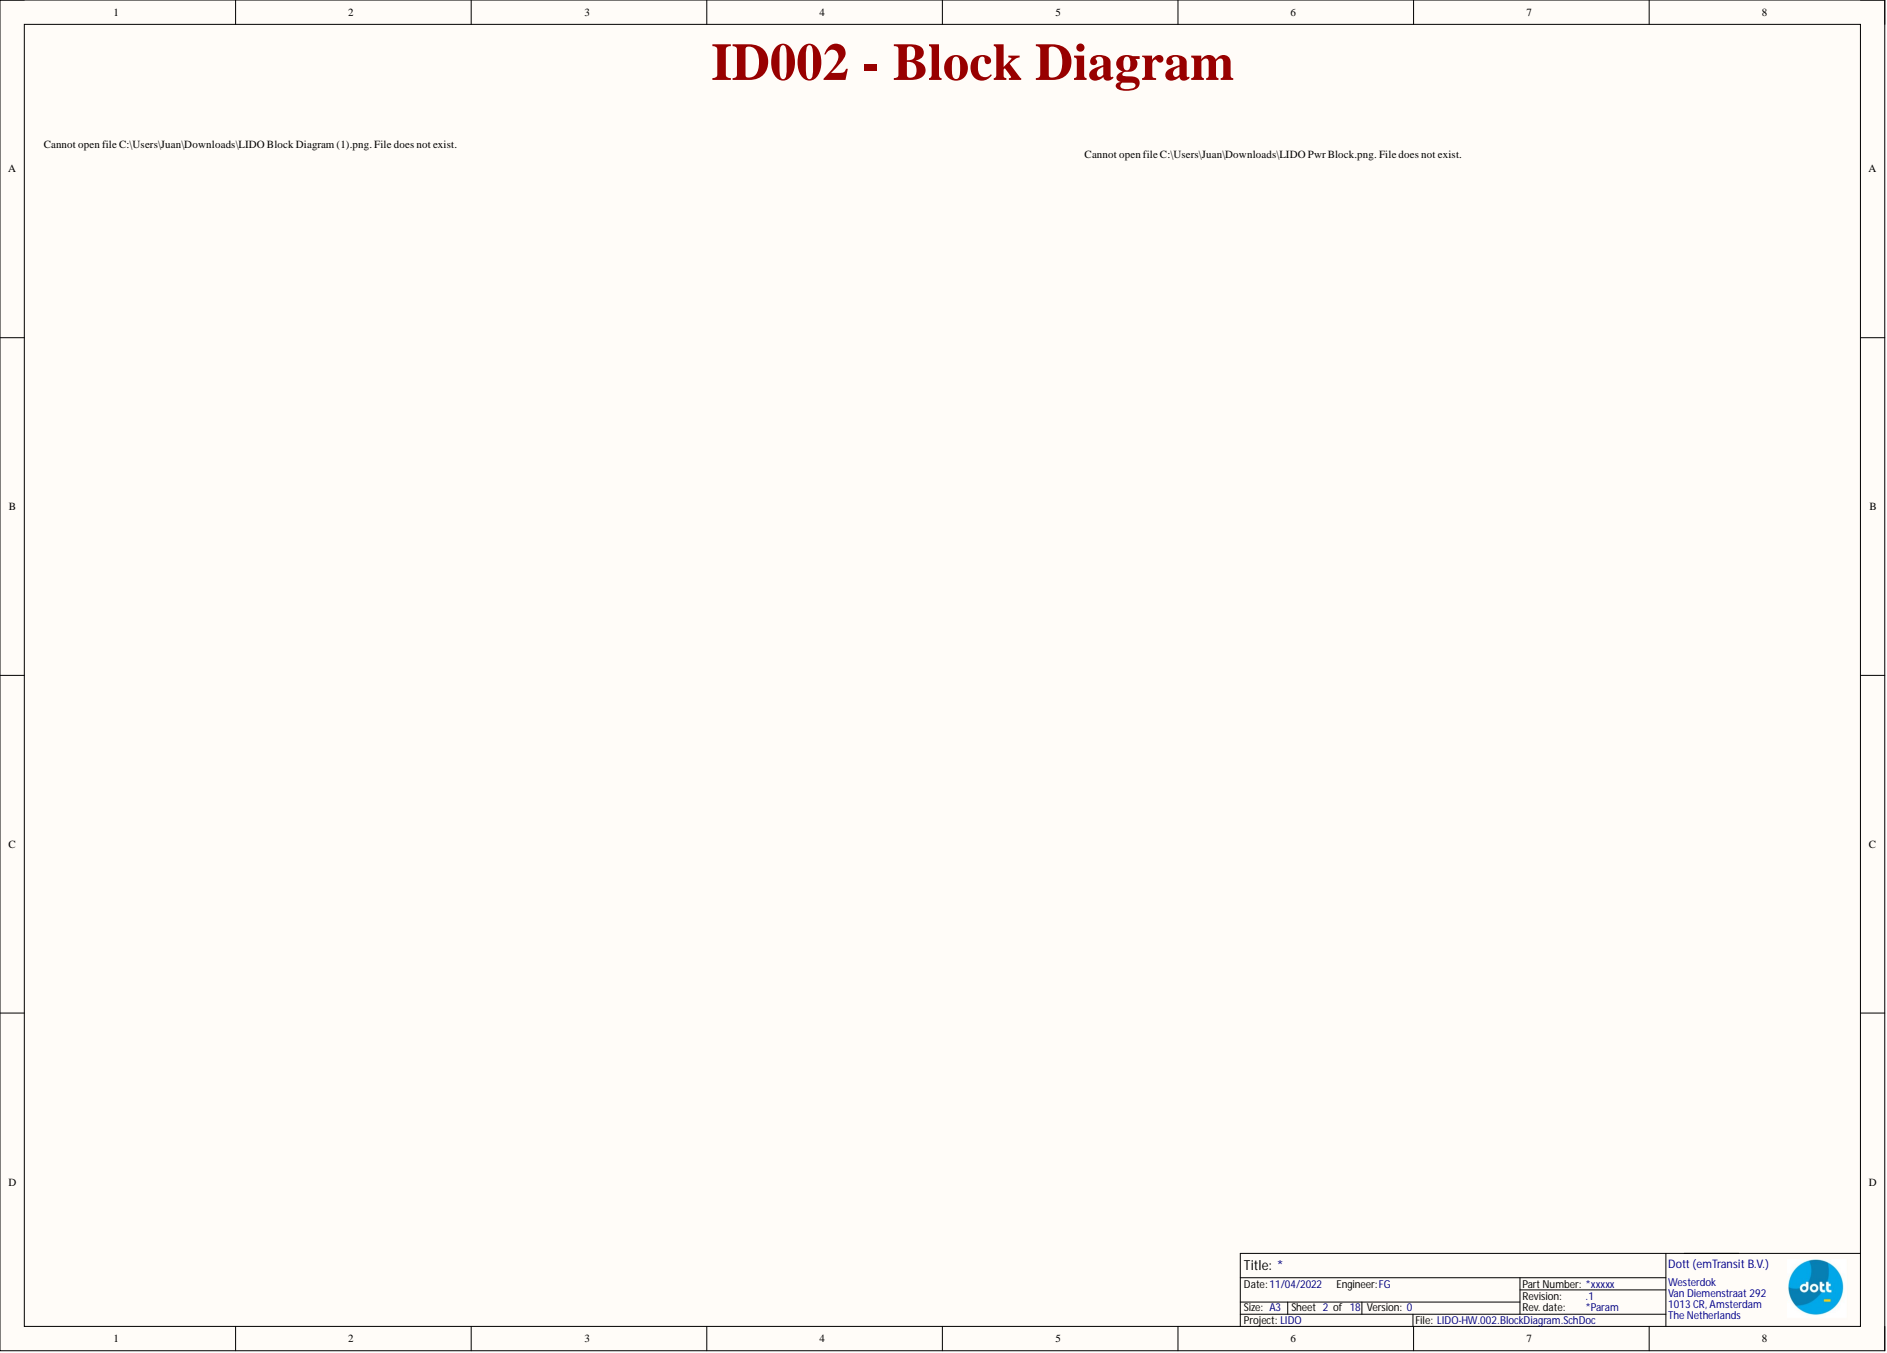
[picture p41: page 2]

Cannot open file C:\Users\Juan\Downloads\LIDO Pwr Block.png. File does not exist. Cannot open file C:\Users\Juan\Downloads\LIDO Block Diagram (1).png. File does not exist.

LIDO-HW.002.BlockDiagram.SchDoc

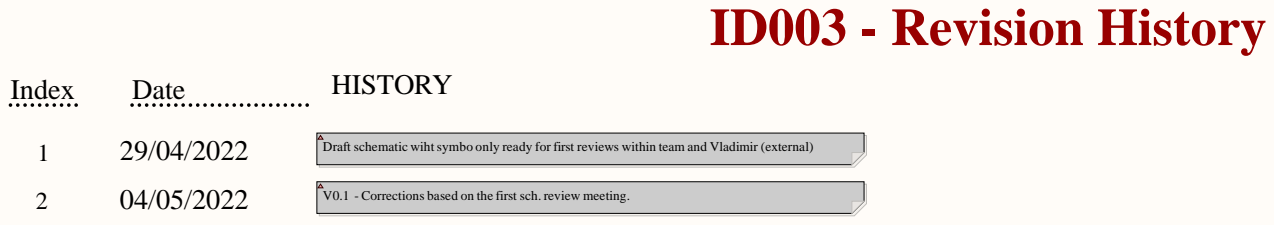
[picture p42: page 3]

Draft schematic wiht symbo only ready for first reviews within team and Vladimir (external)

V0.1 - Corrections based on the first sch. review meeting.

LIDO-HW.003.RevisionHistory.SchDoc

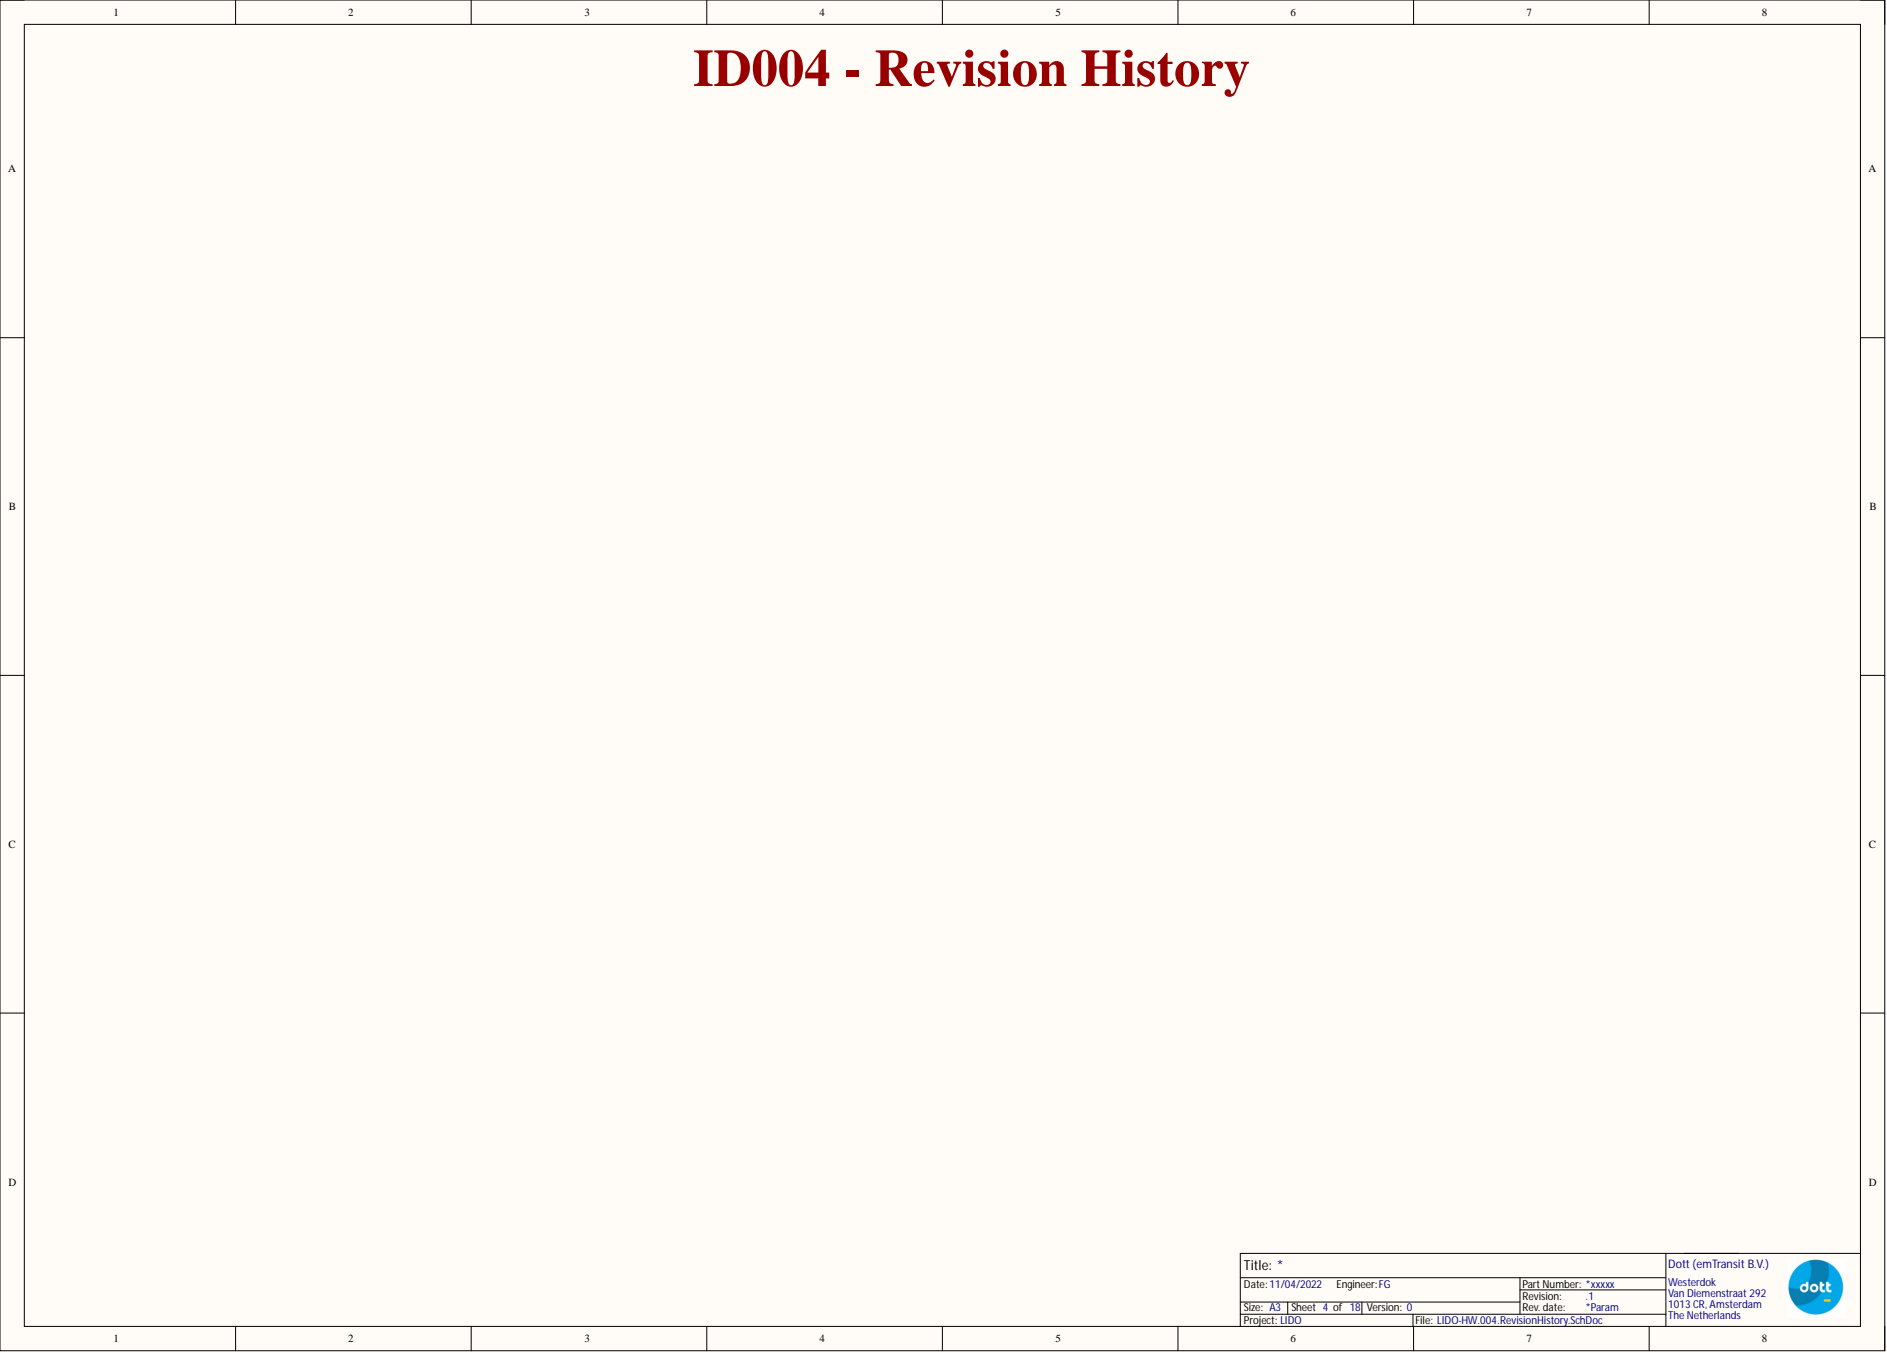
[picture p43: page 4]

LIDO-HW.004.RevisionHistory.SchDoc

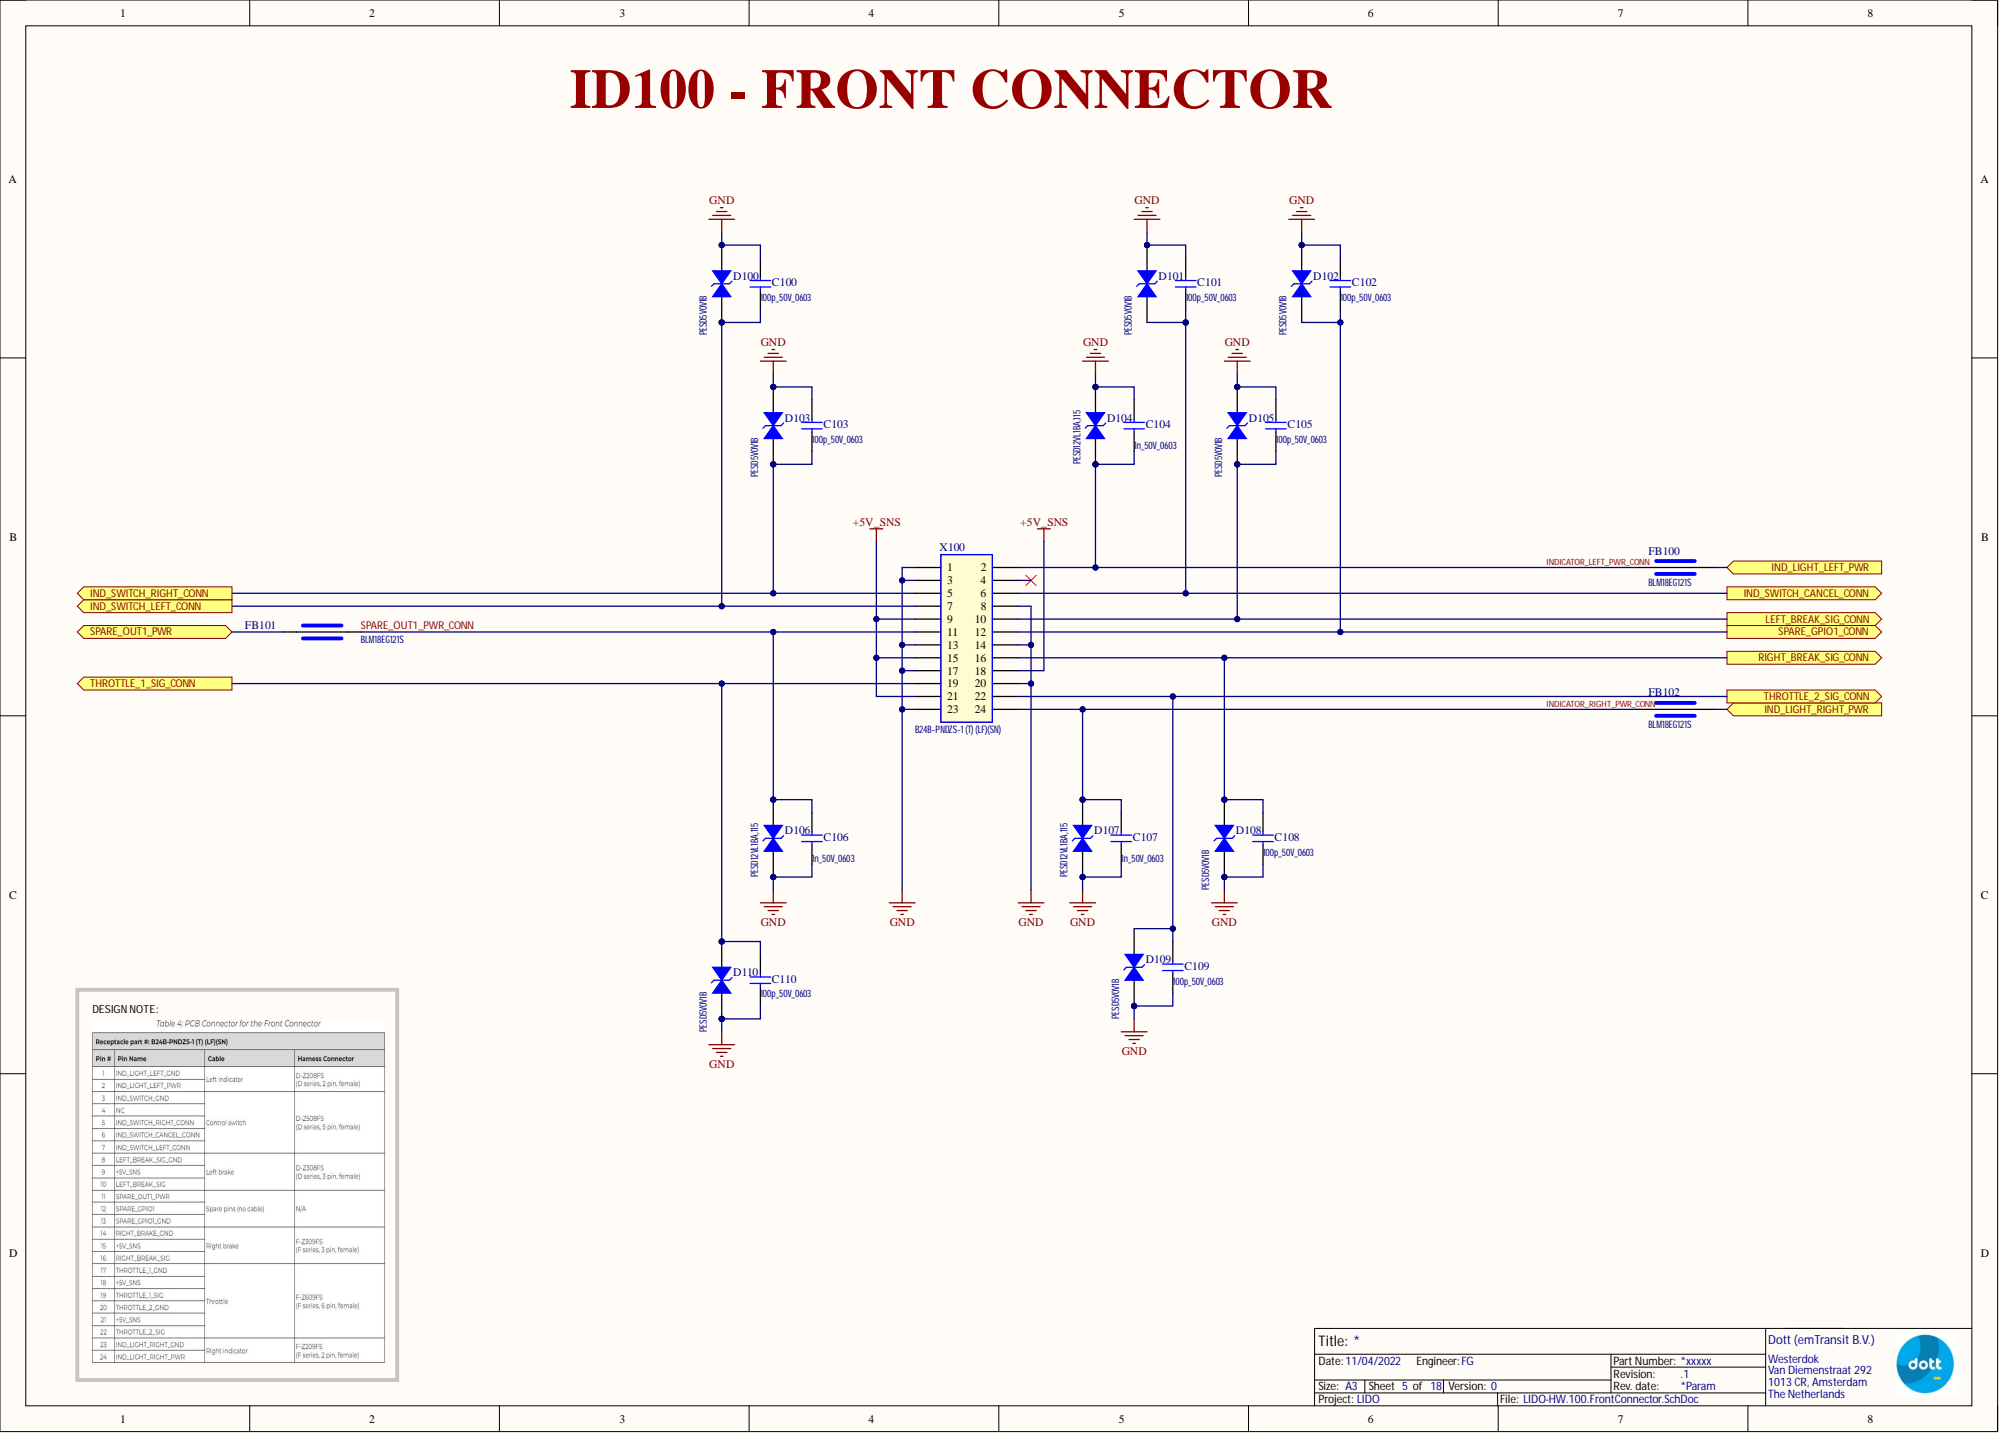
[picture p44: page 5]

LIDO-HW.100.FrontConnector.SchDoc

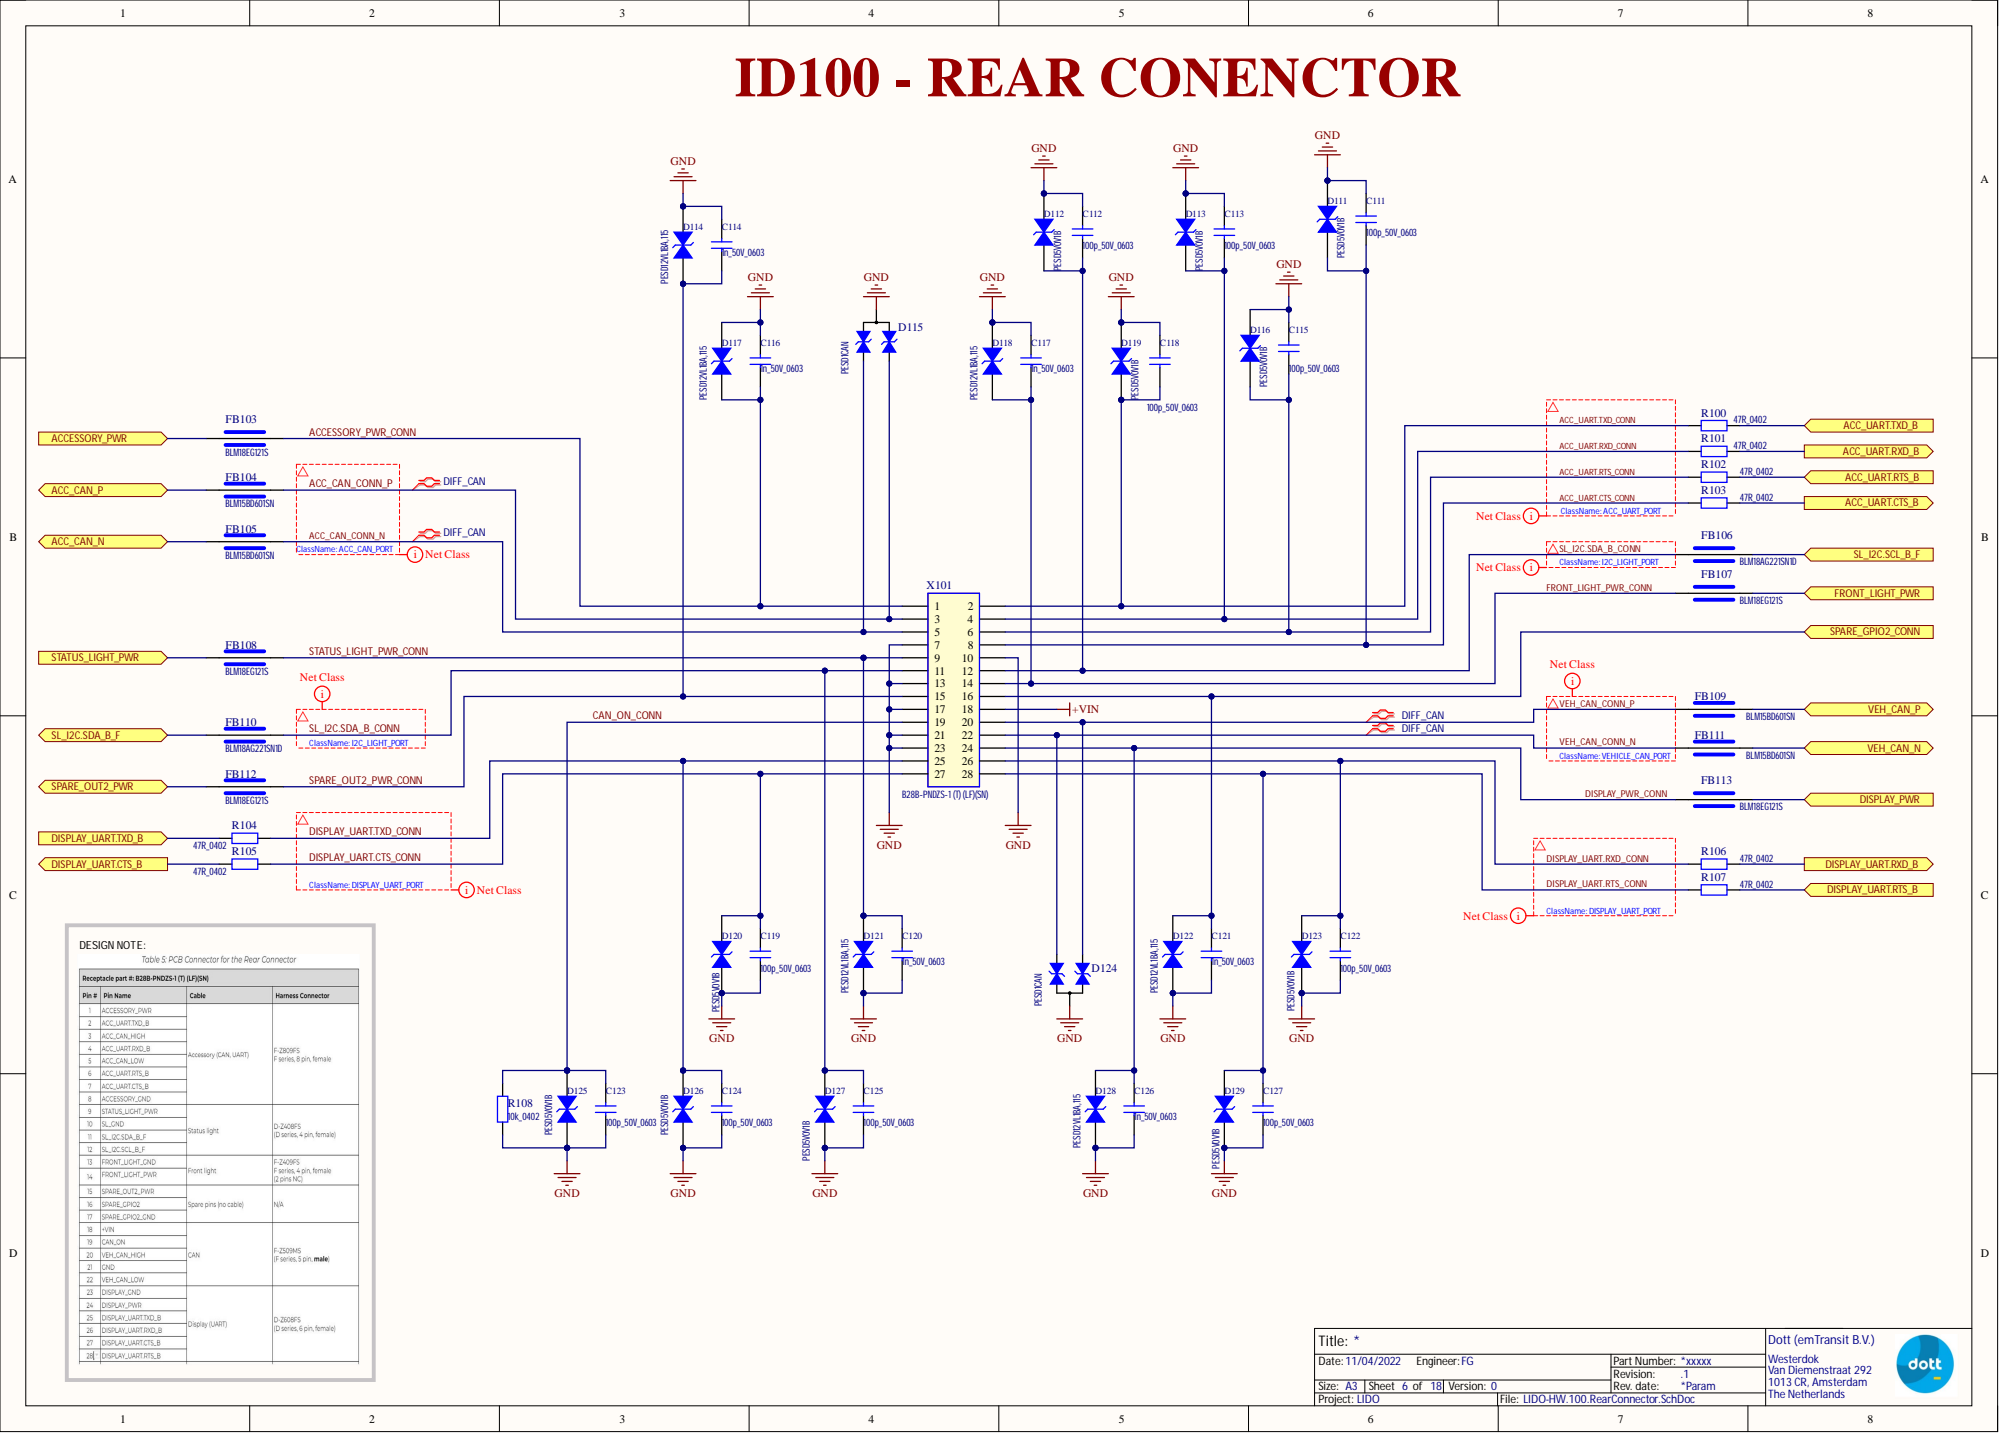
[picture p45: page 6]

A CC_UART.RX D_CO N N

A CC_UART.RTS_CO N N

A CC_UART.CTS_CO N N
C l assName: A CC_U A RT_PO RT

Net Clas s
H_CAN_CONN_N i V E H_CAN_CONN_P

V E
C l assName: V E HIC LE_CA N_PO RT

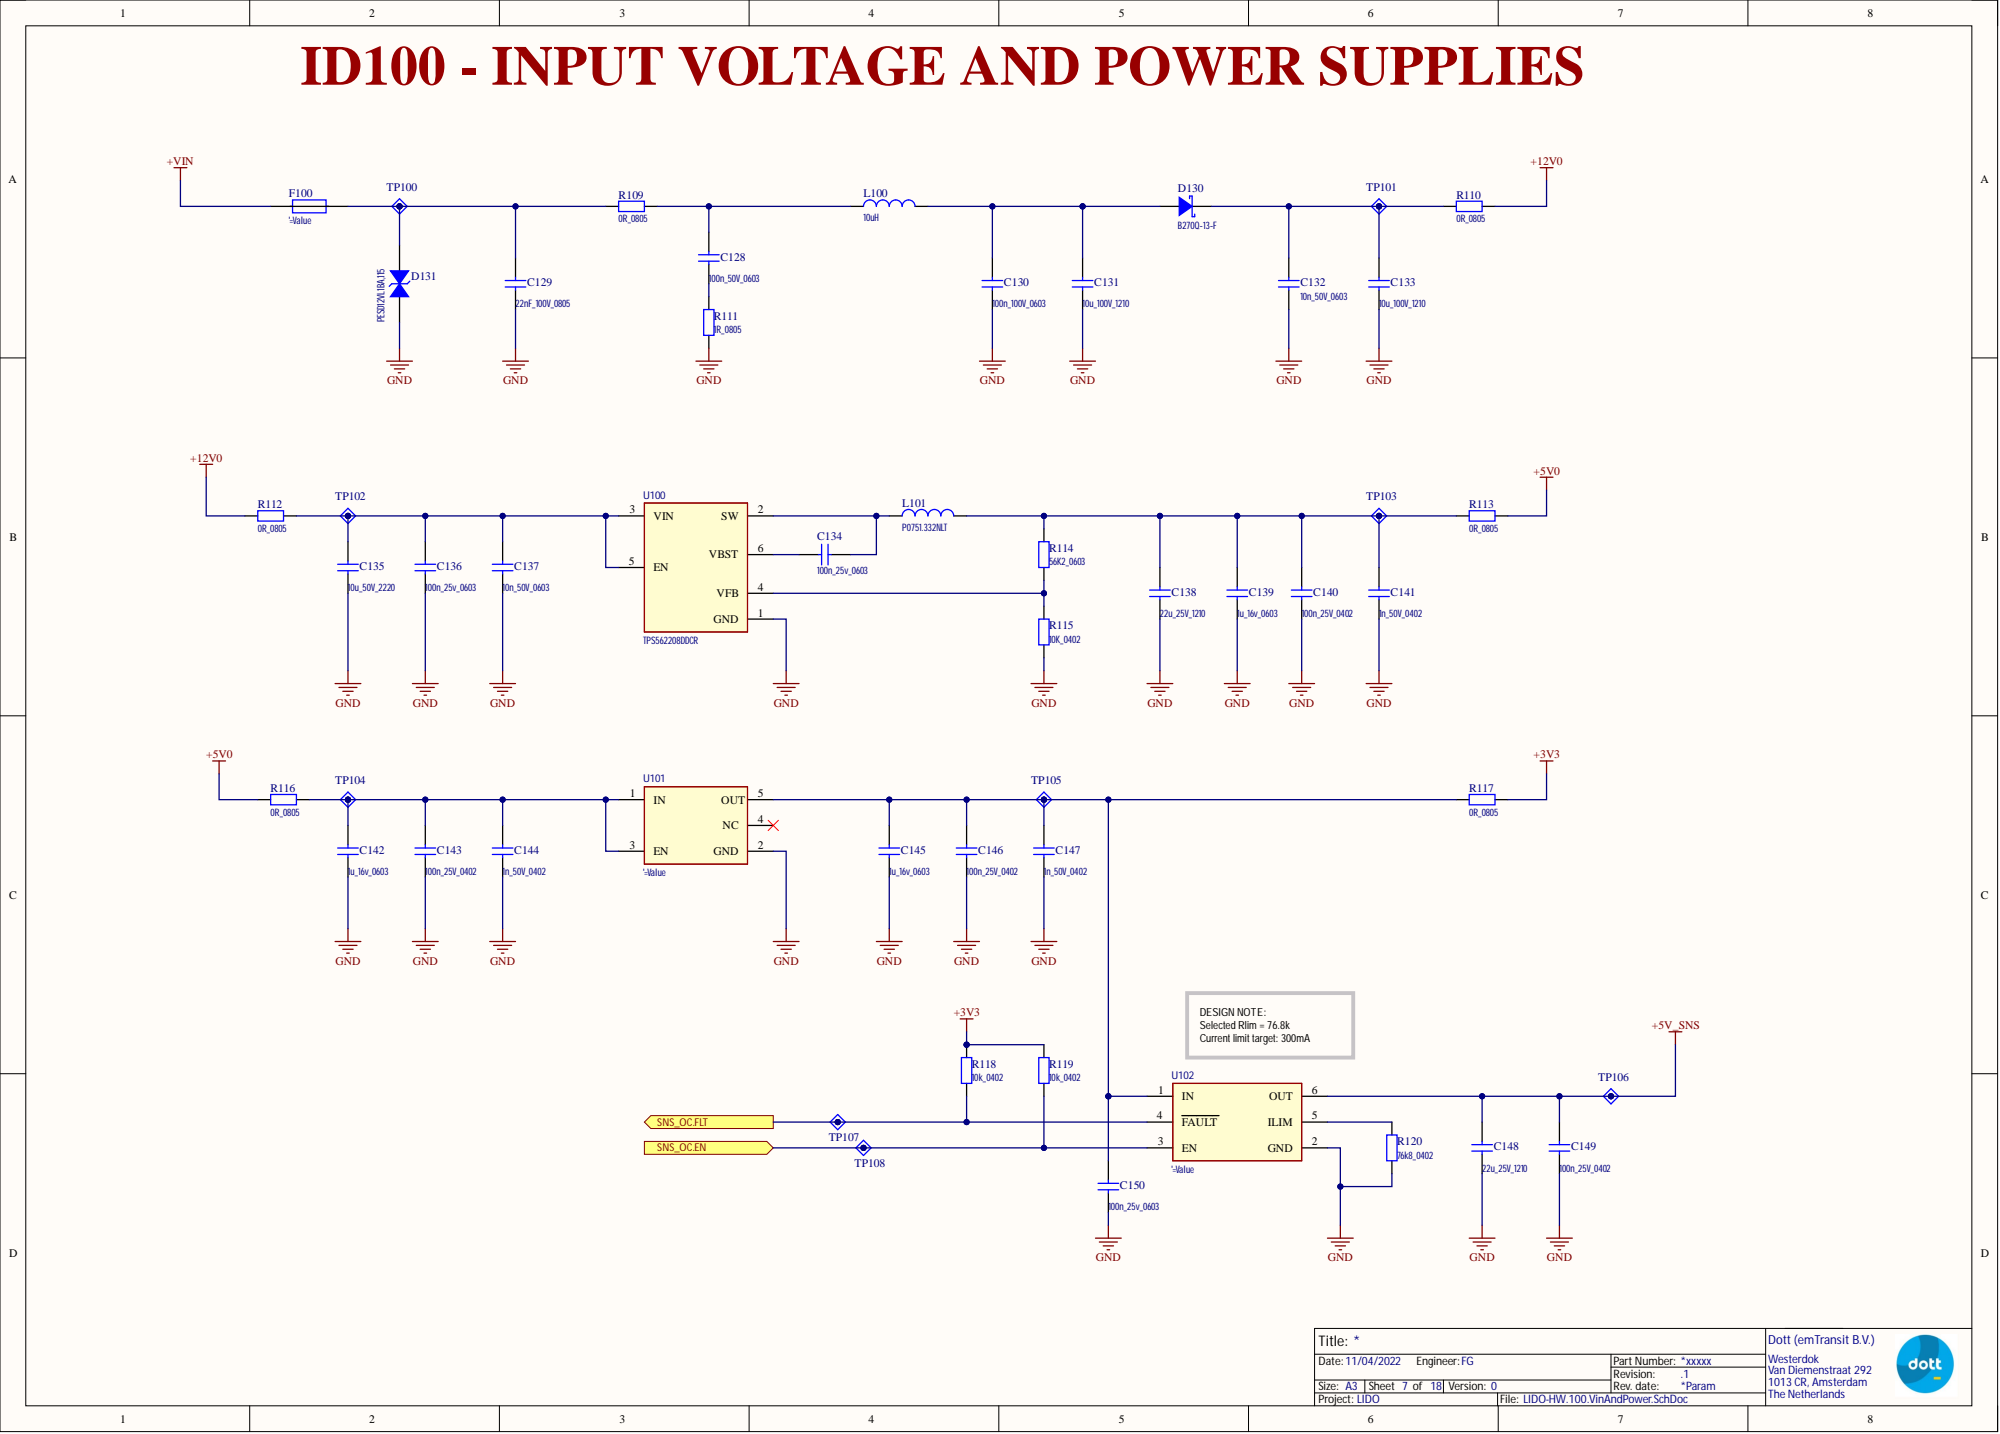
[picture p46: page 7]

ID100 - INPUT VOLTAGE AND POWER SUPPLIES

LIDO-HW.100.VinAndPower.SchDoc

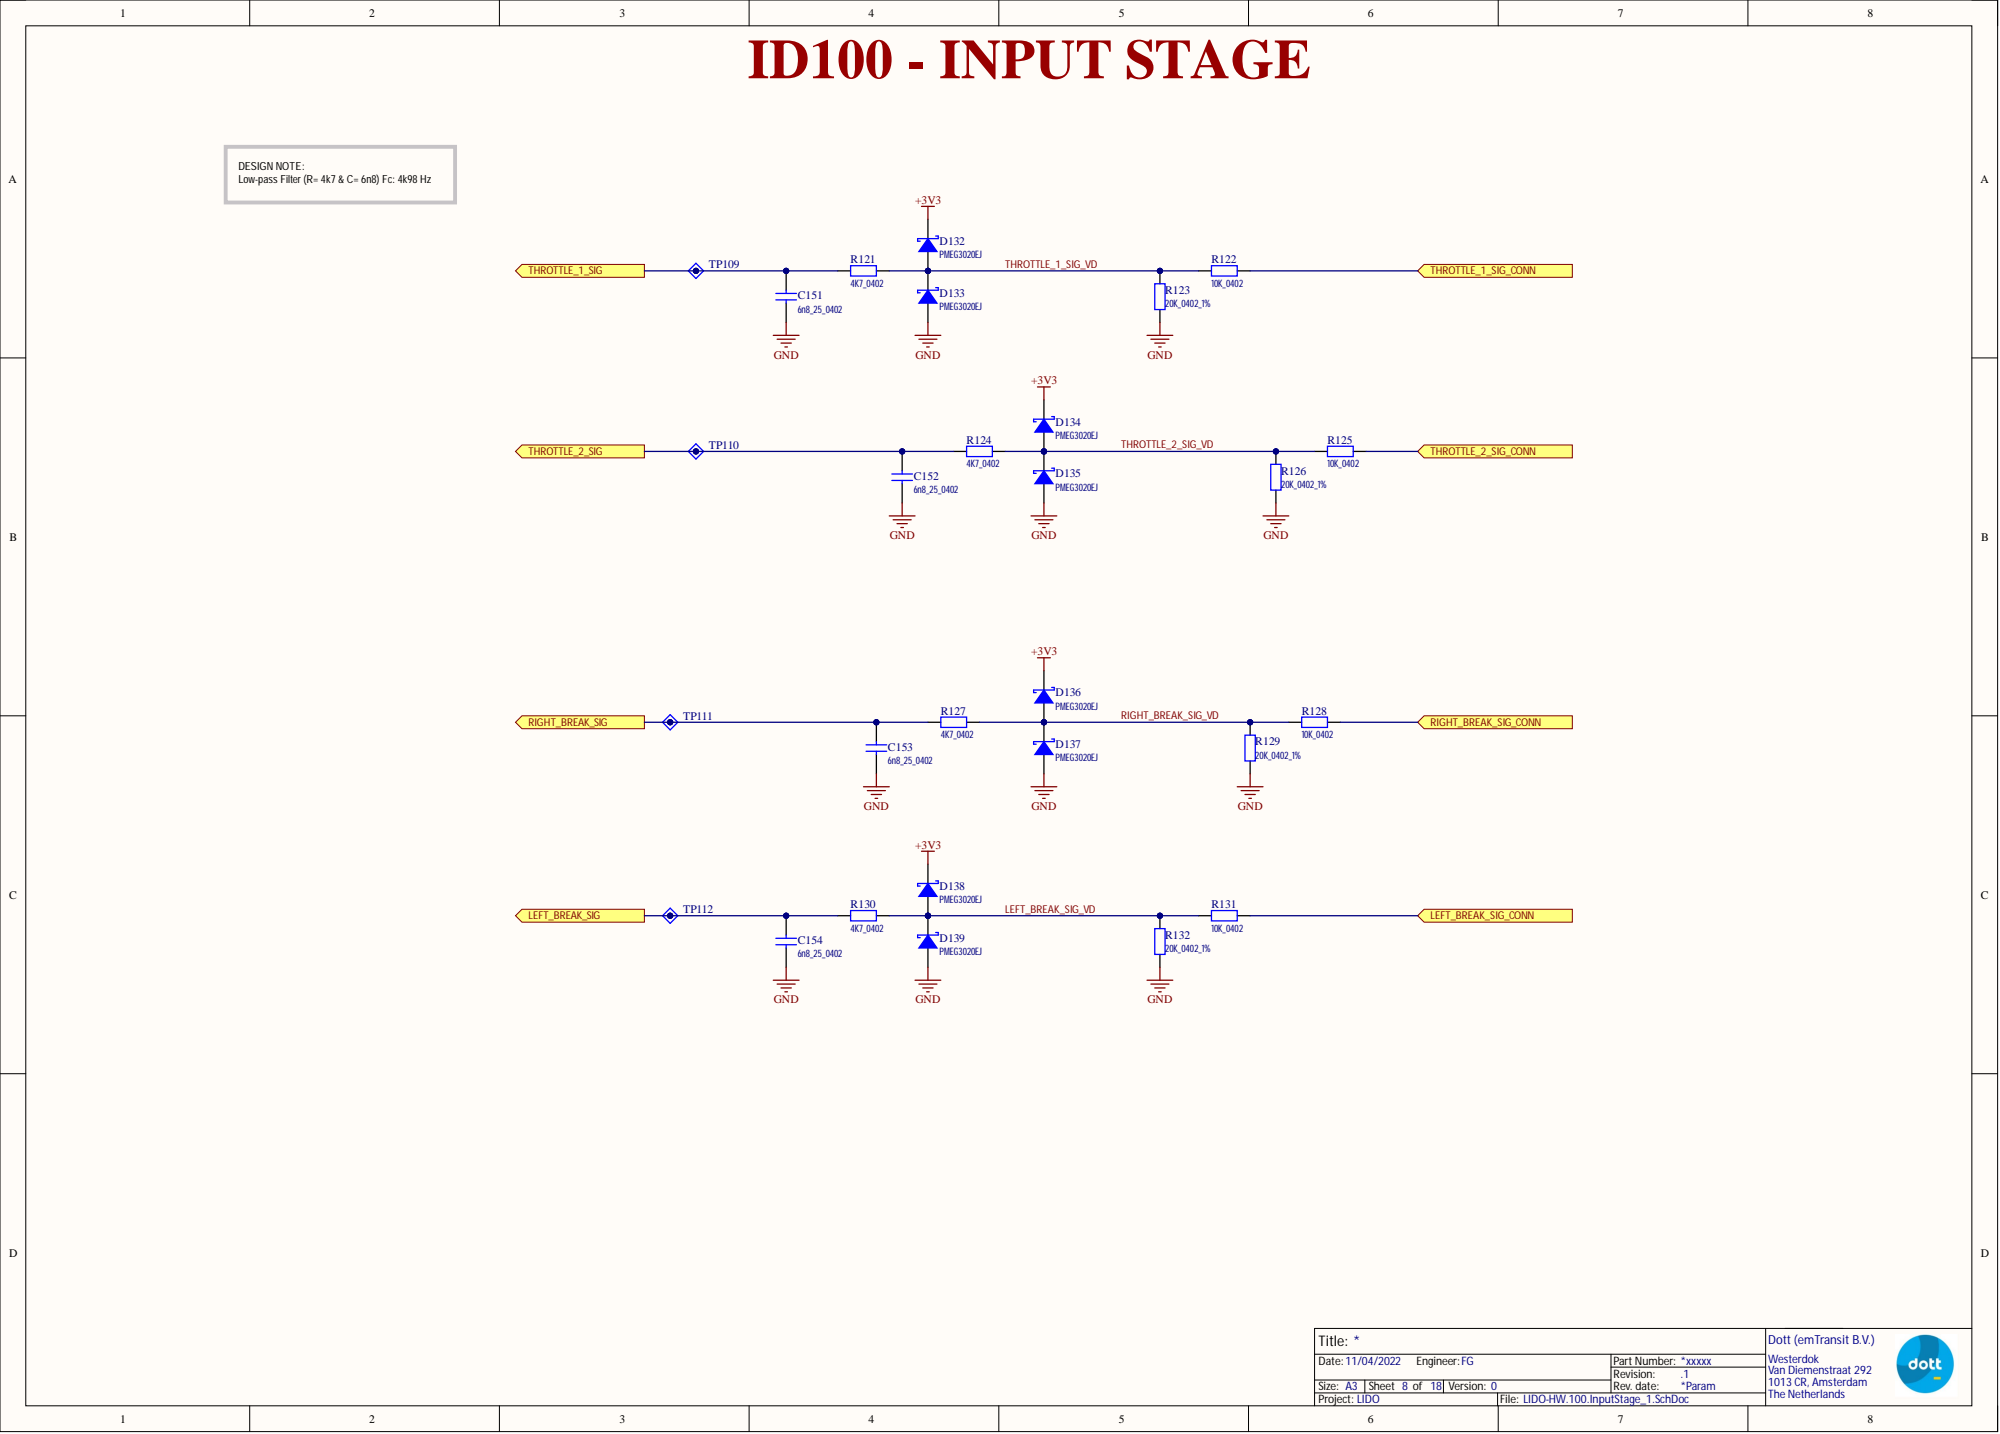
[picture p47: page 8]

DESIGN NOTE:
Low-pass Filter (R= 4k7 & C= 6n8) Fc: 4k98 Hz

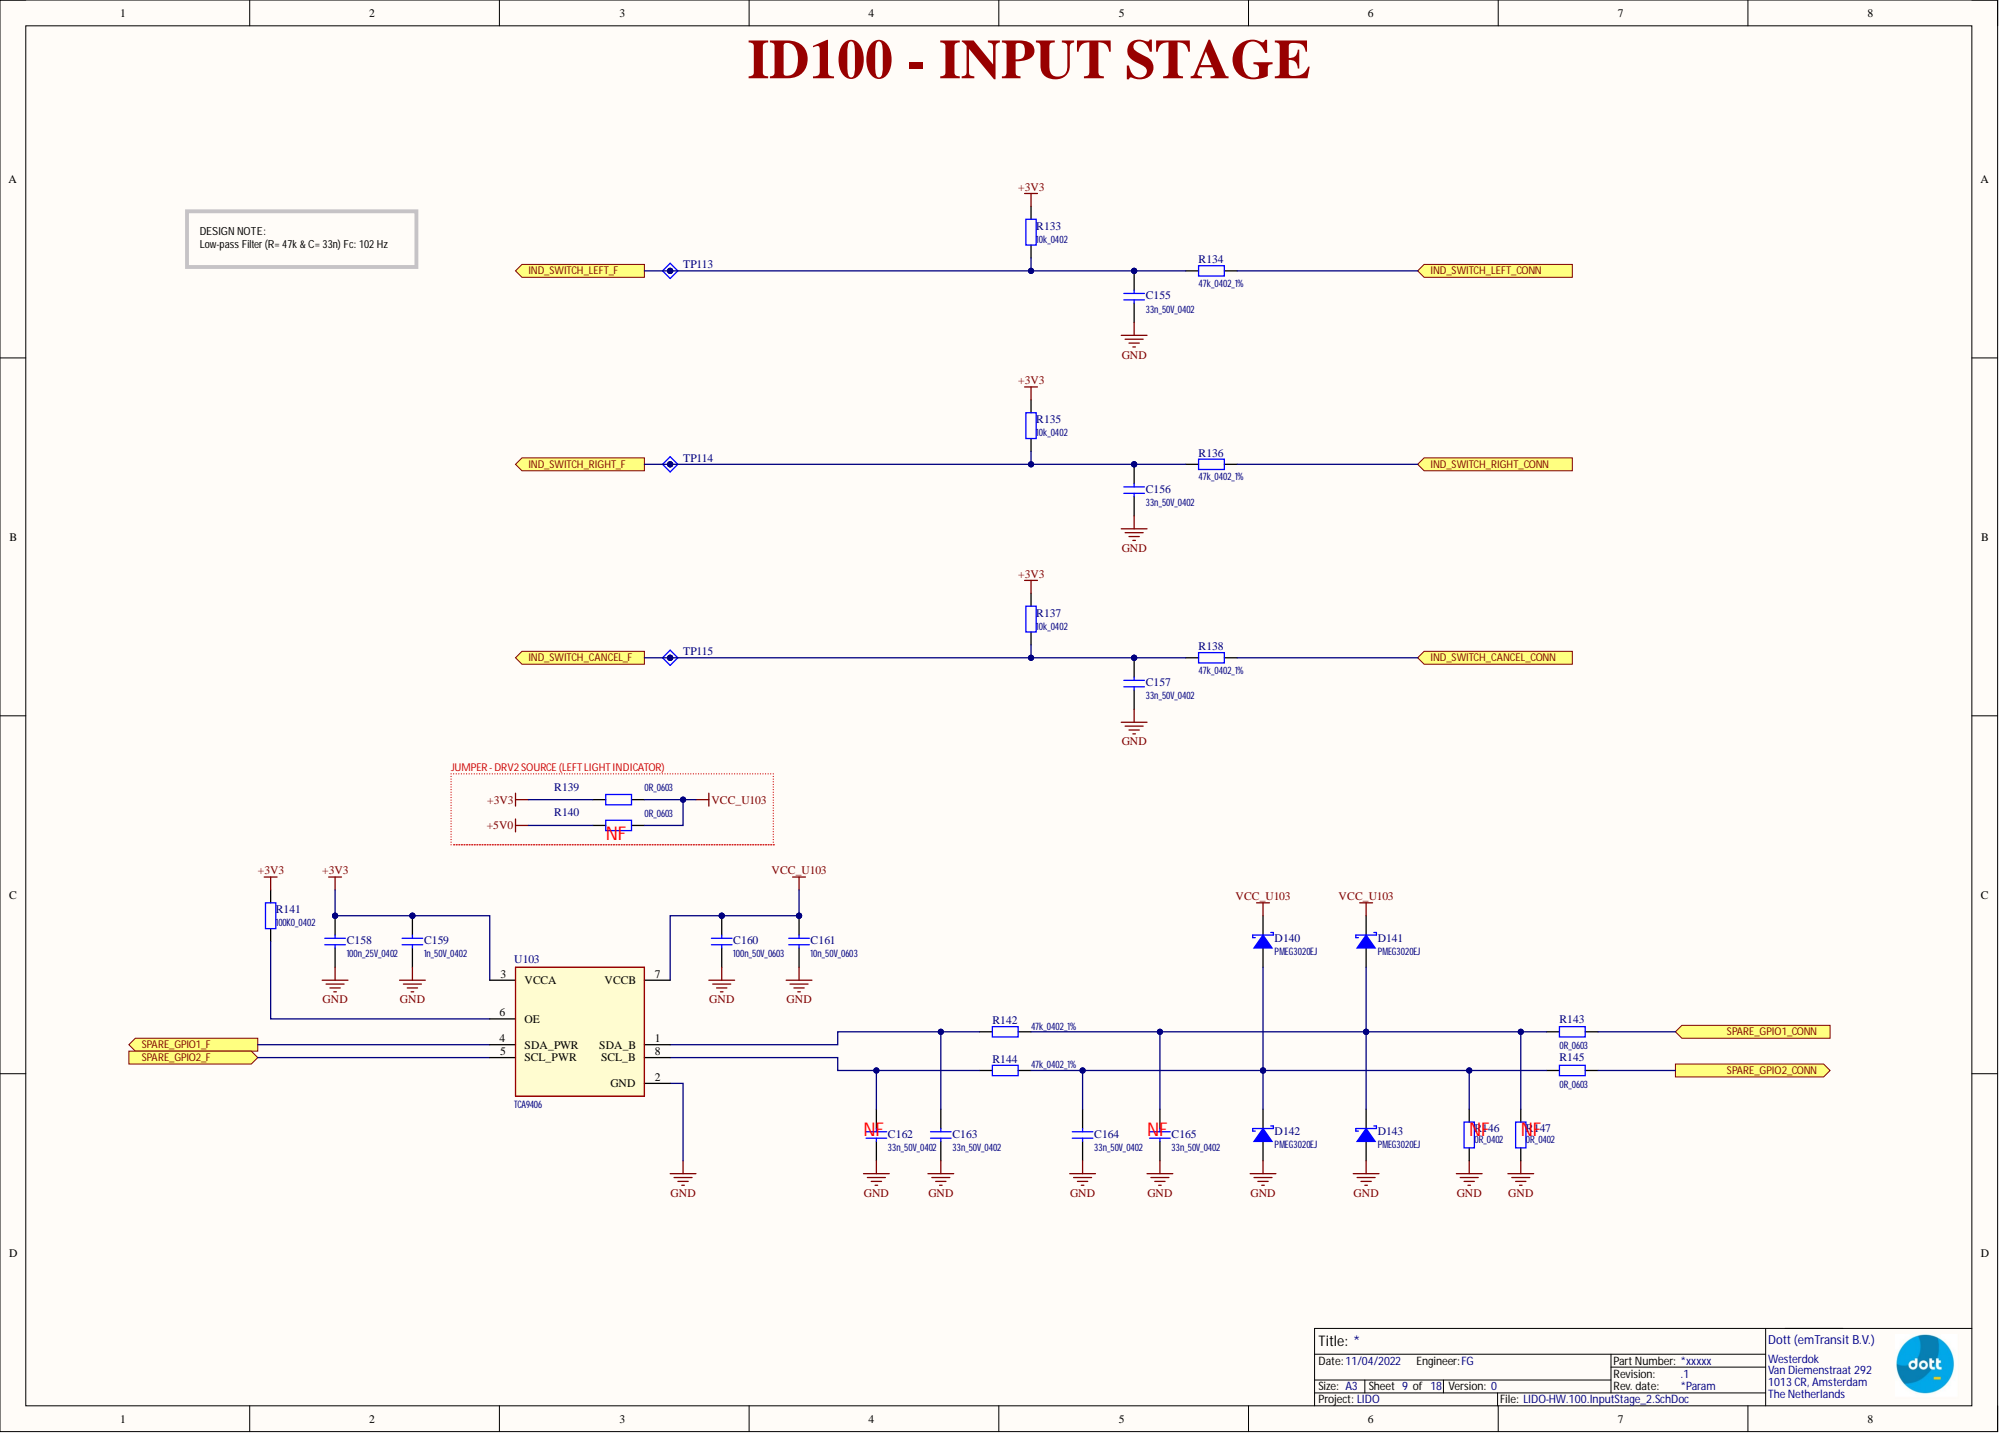
[picture p48: page 9]

DESIGN NOTE:
Low-pass Filter (R= 47k & C= 33n) Fc: 102 Hz

JUMPER - DRV2 SOURCE (LEFT LIGHT INDICATOR)

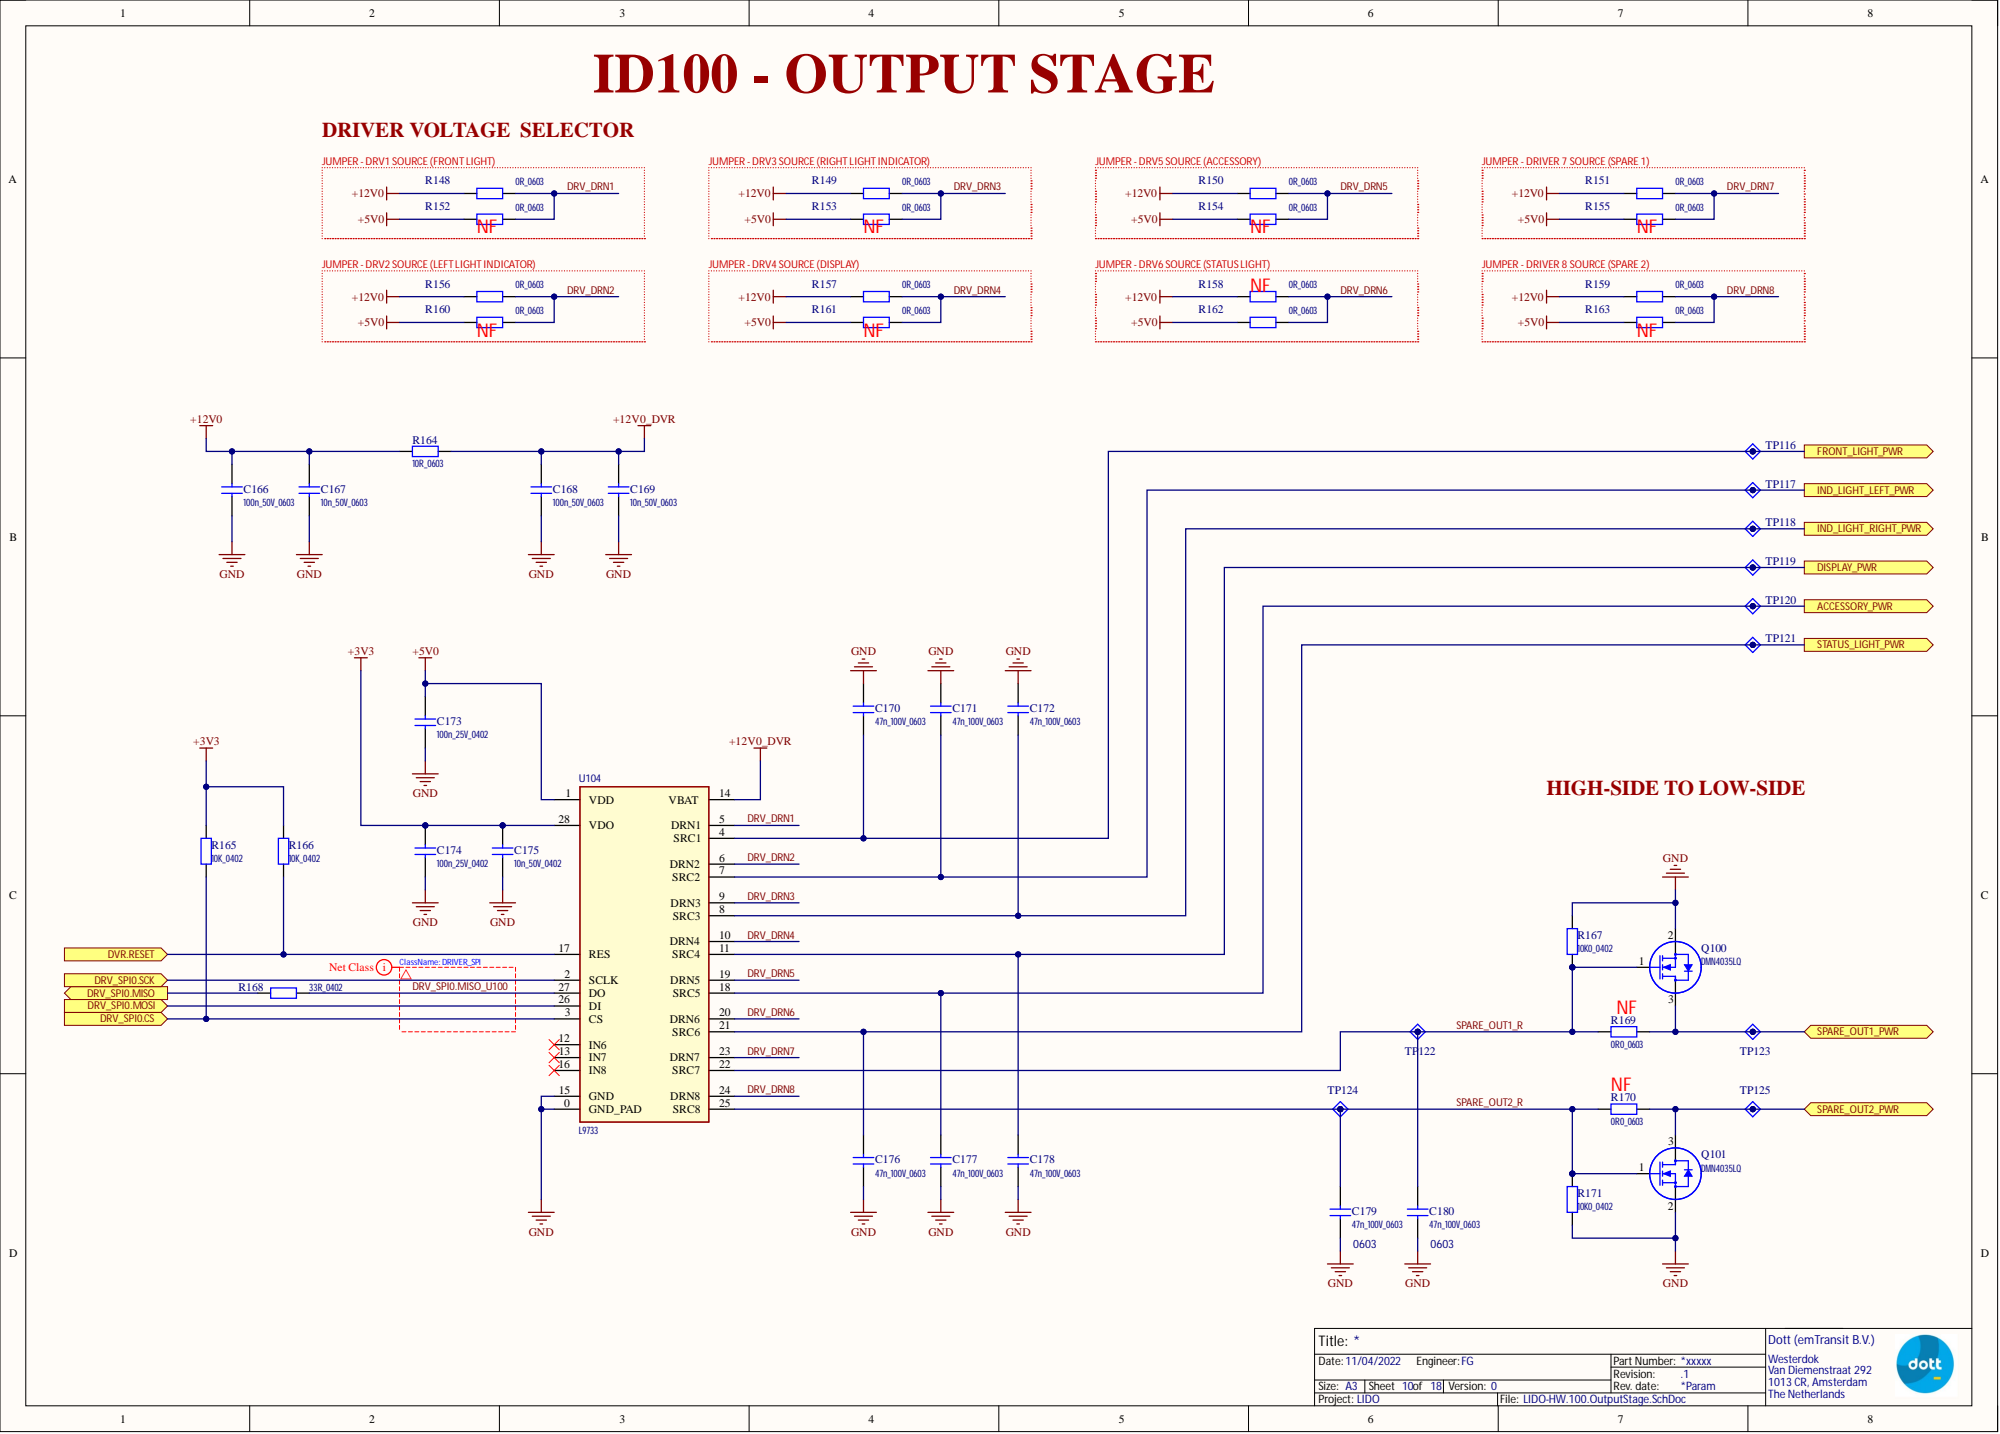
[picture p49: page 10]

JUMPER - DRV1 SOURCE (FRONT LIGHT)

JUMPER - DRV3 SOURCE (RIGHT LIGHT INDICATOR)

JUMPER - DRIVER 7 SOURCE (SPARE 1)

JUMPER - DRV2 SOURCE (LEFT LIGHT INDICATOR)

JUMPER - DRV6 SOURCE (STATUS LIGHT)

JUMPER - DRIVER 8 SOURCE (SPARE 2)

HIGH-SIDE TO LOW-SIDE

LIDO-HW.100.OutputStage.SchDoc

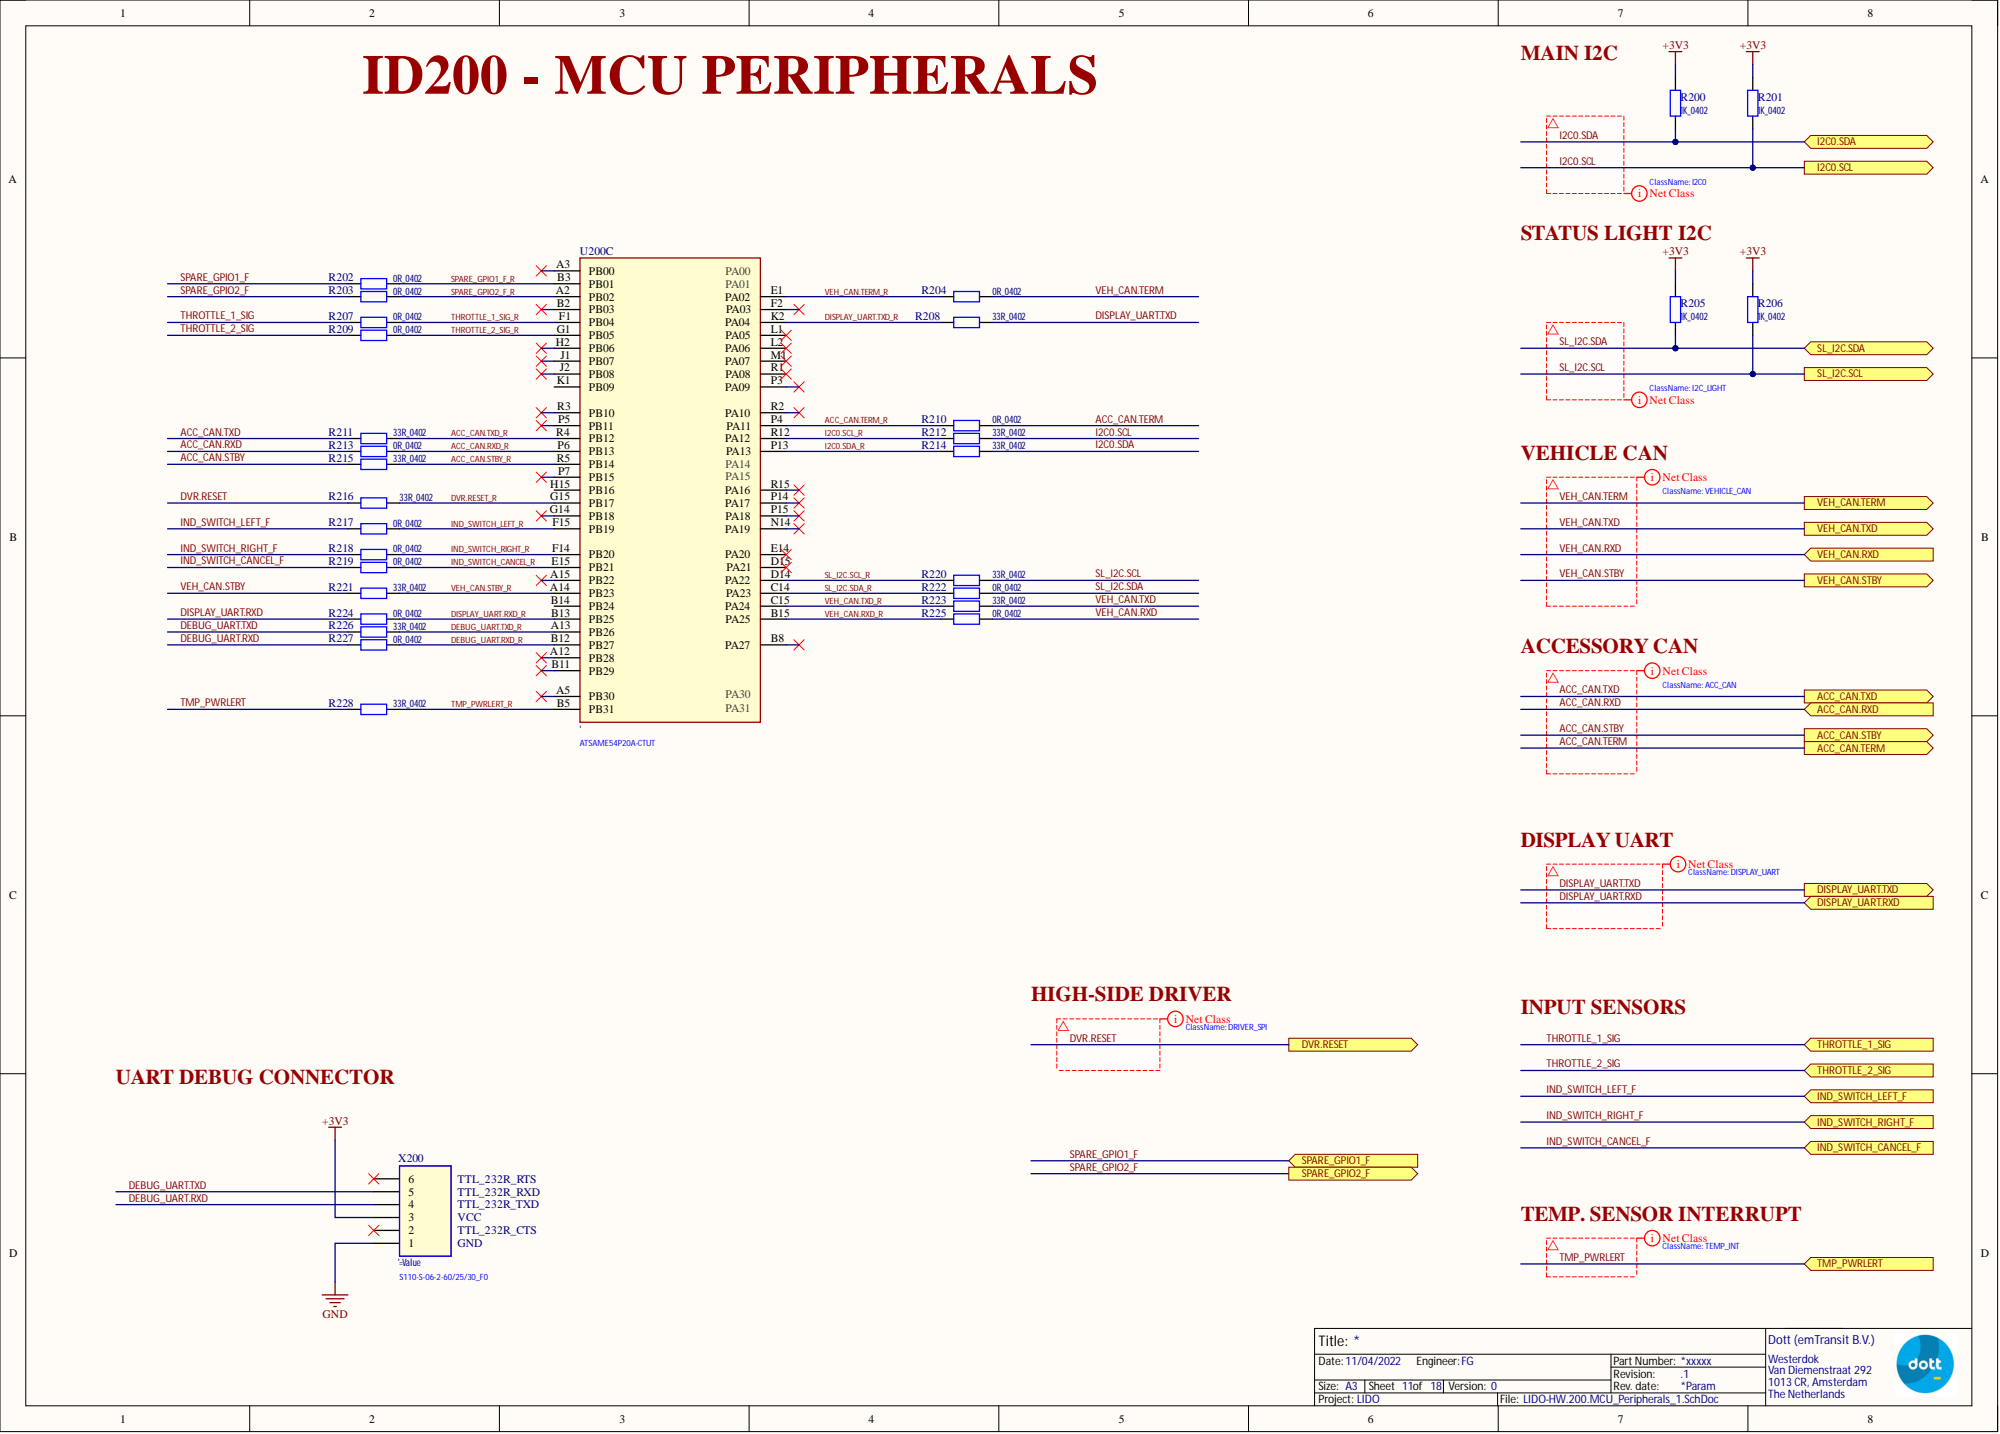
[picture p50: page 11]

DVR.RESET

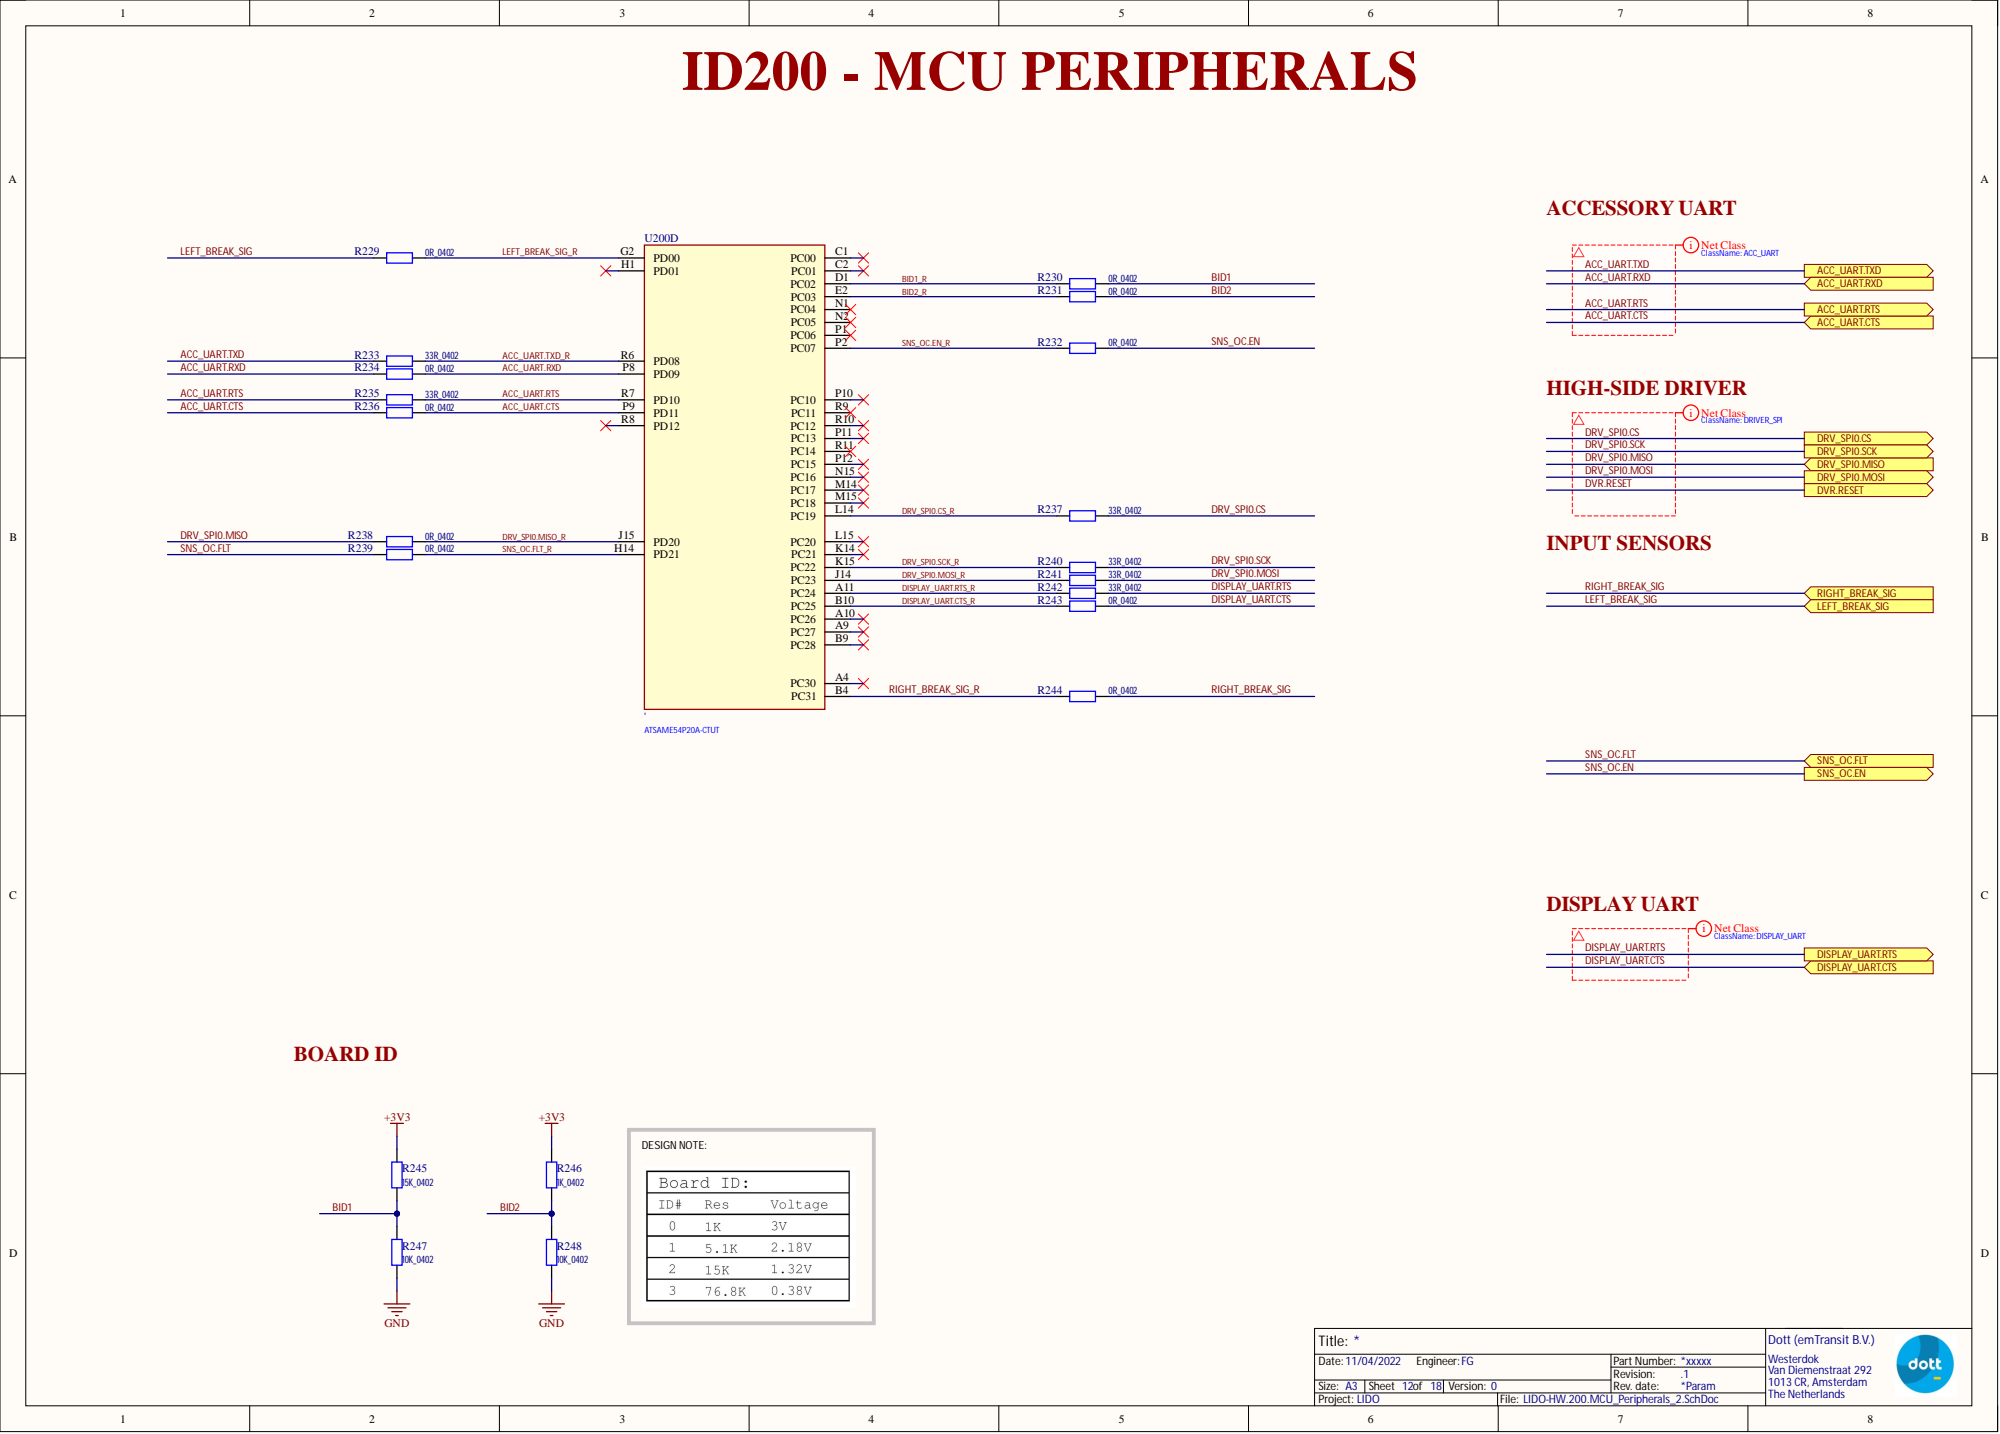
[picture p51: page 12]

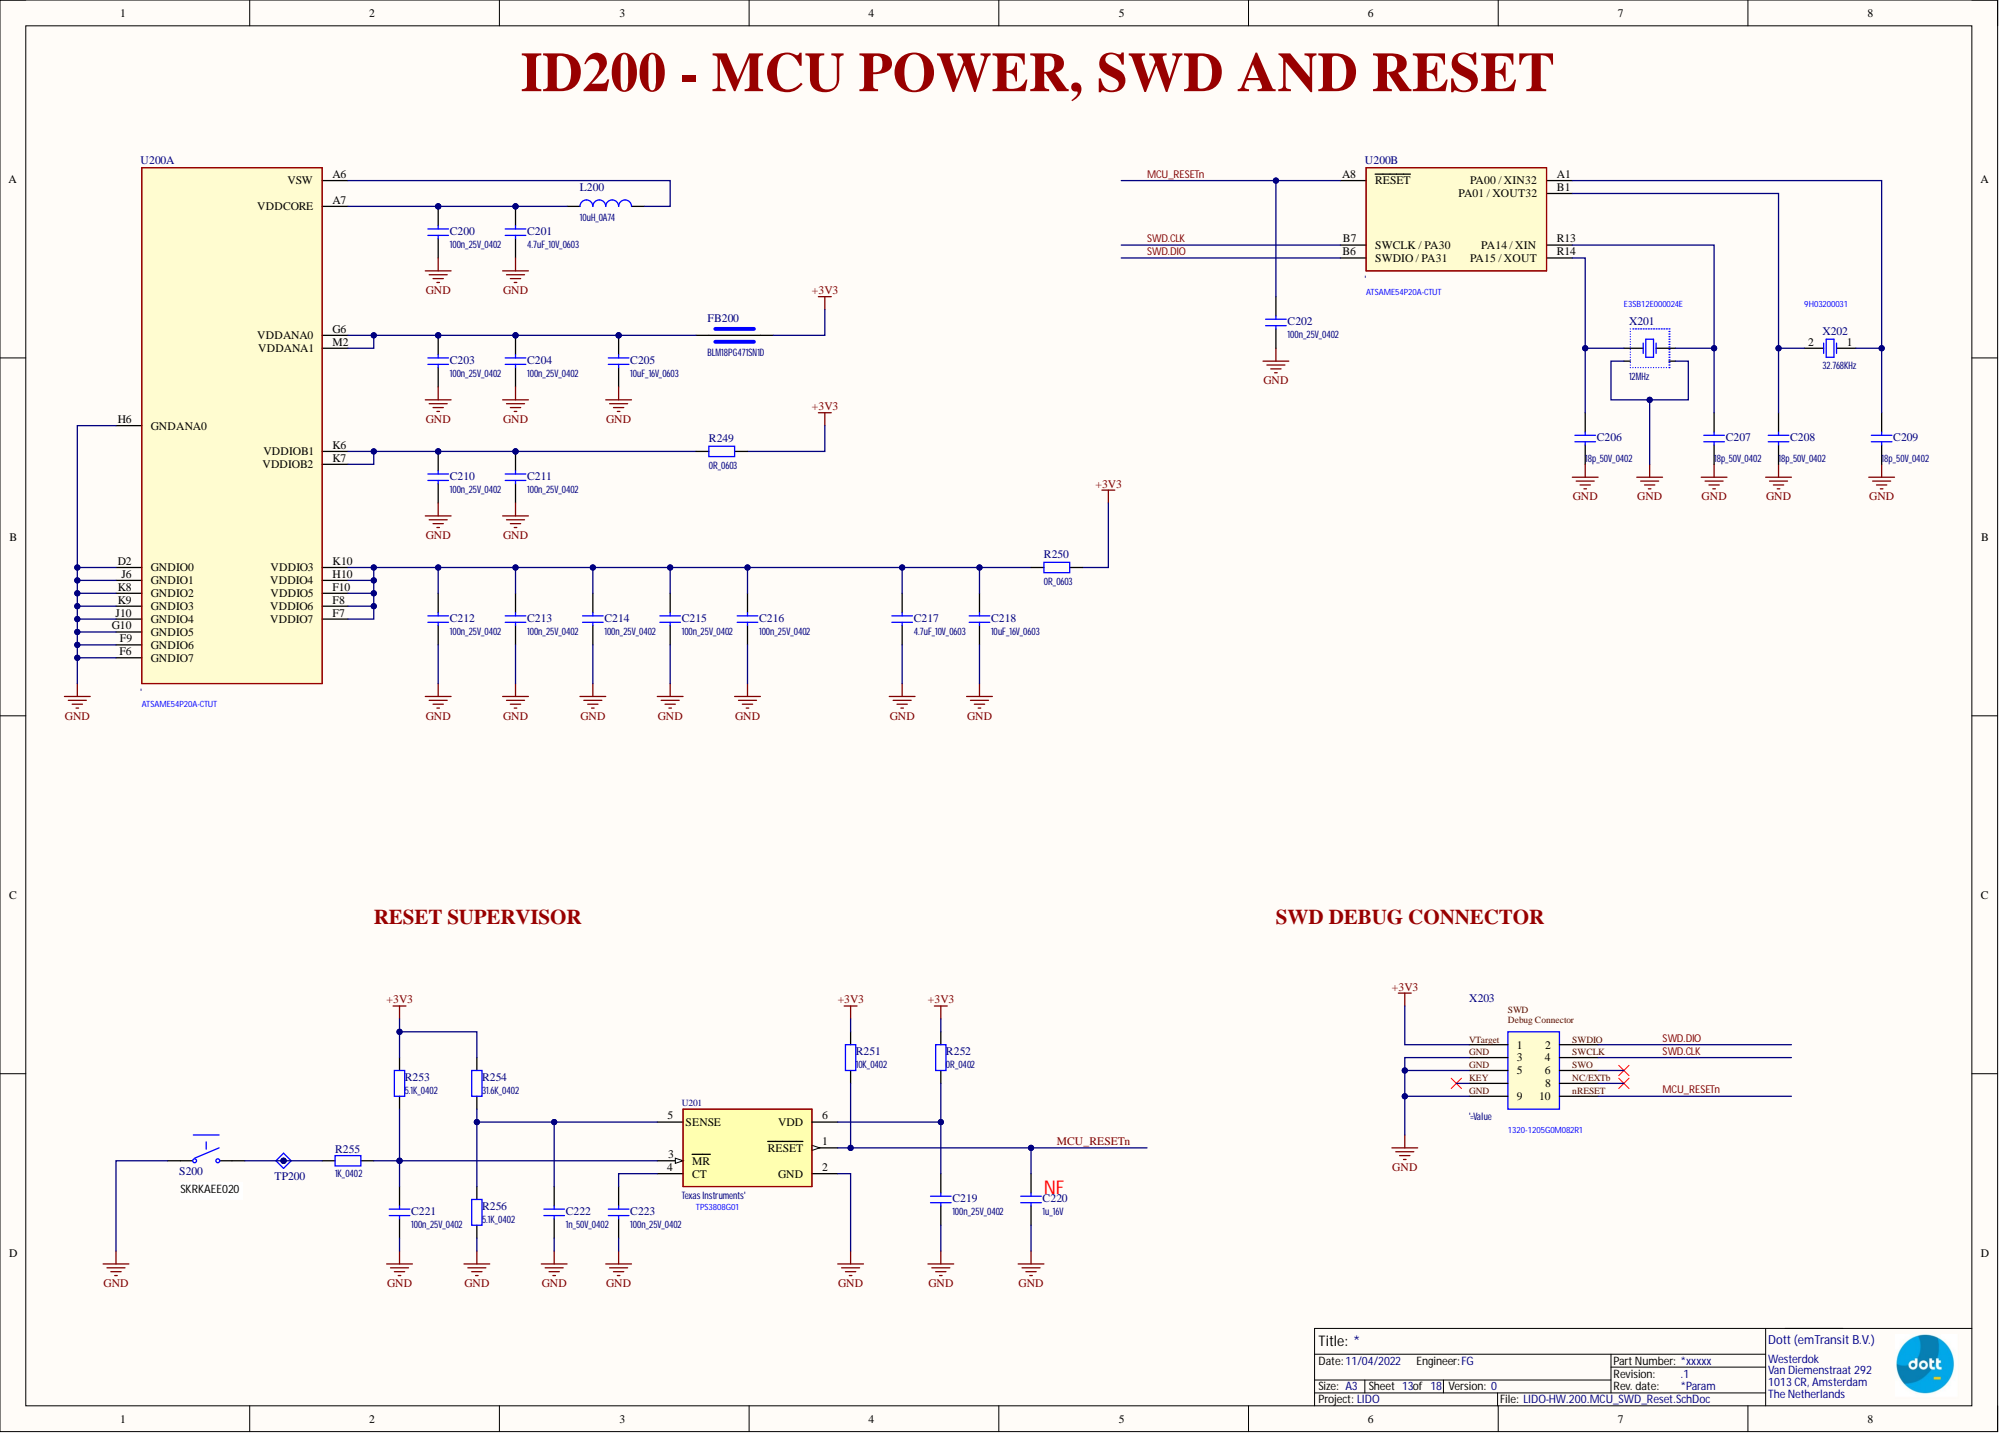
[picture p52: page 13]

ID200 - MCU POWER, SWD AND RESET

GND
KEY

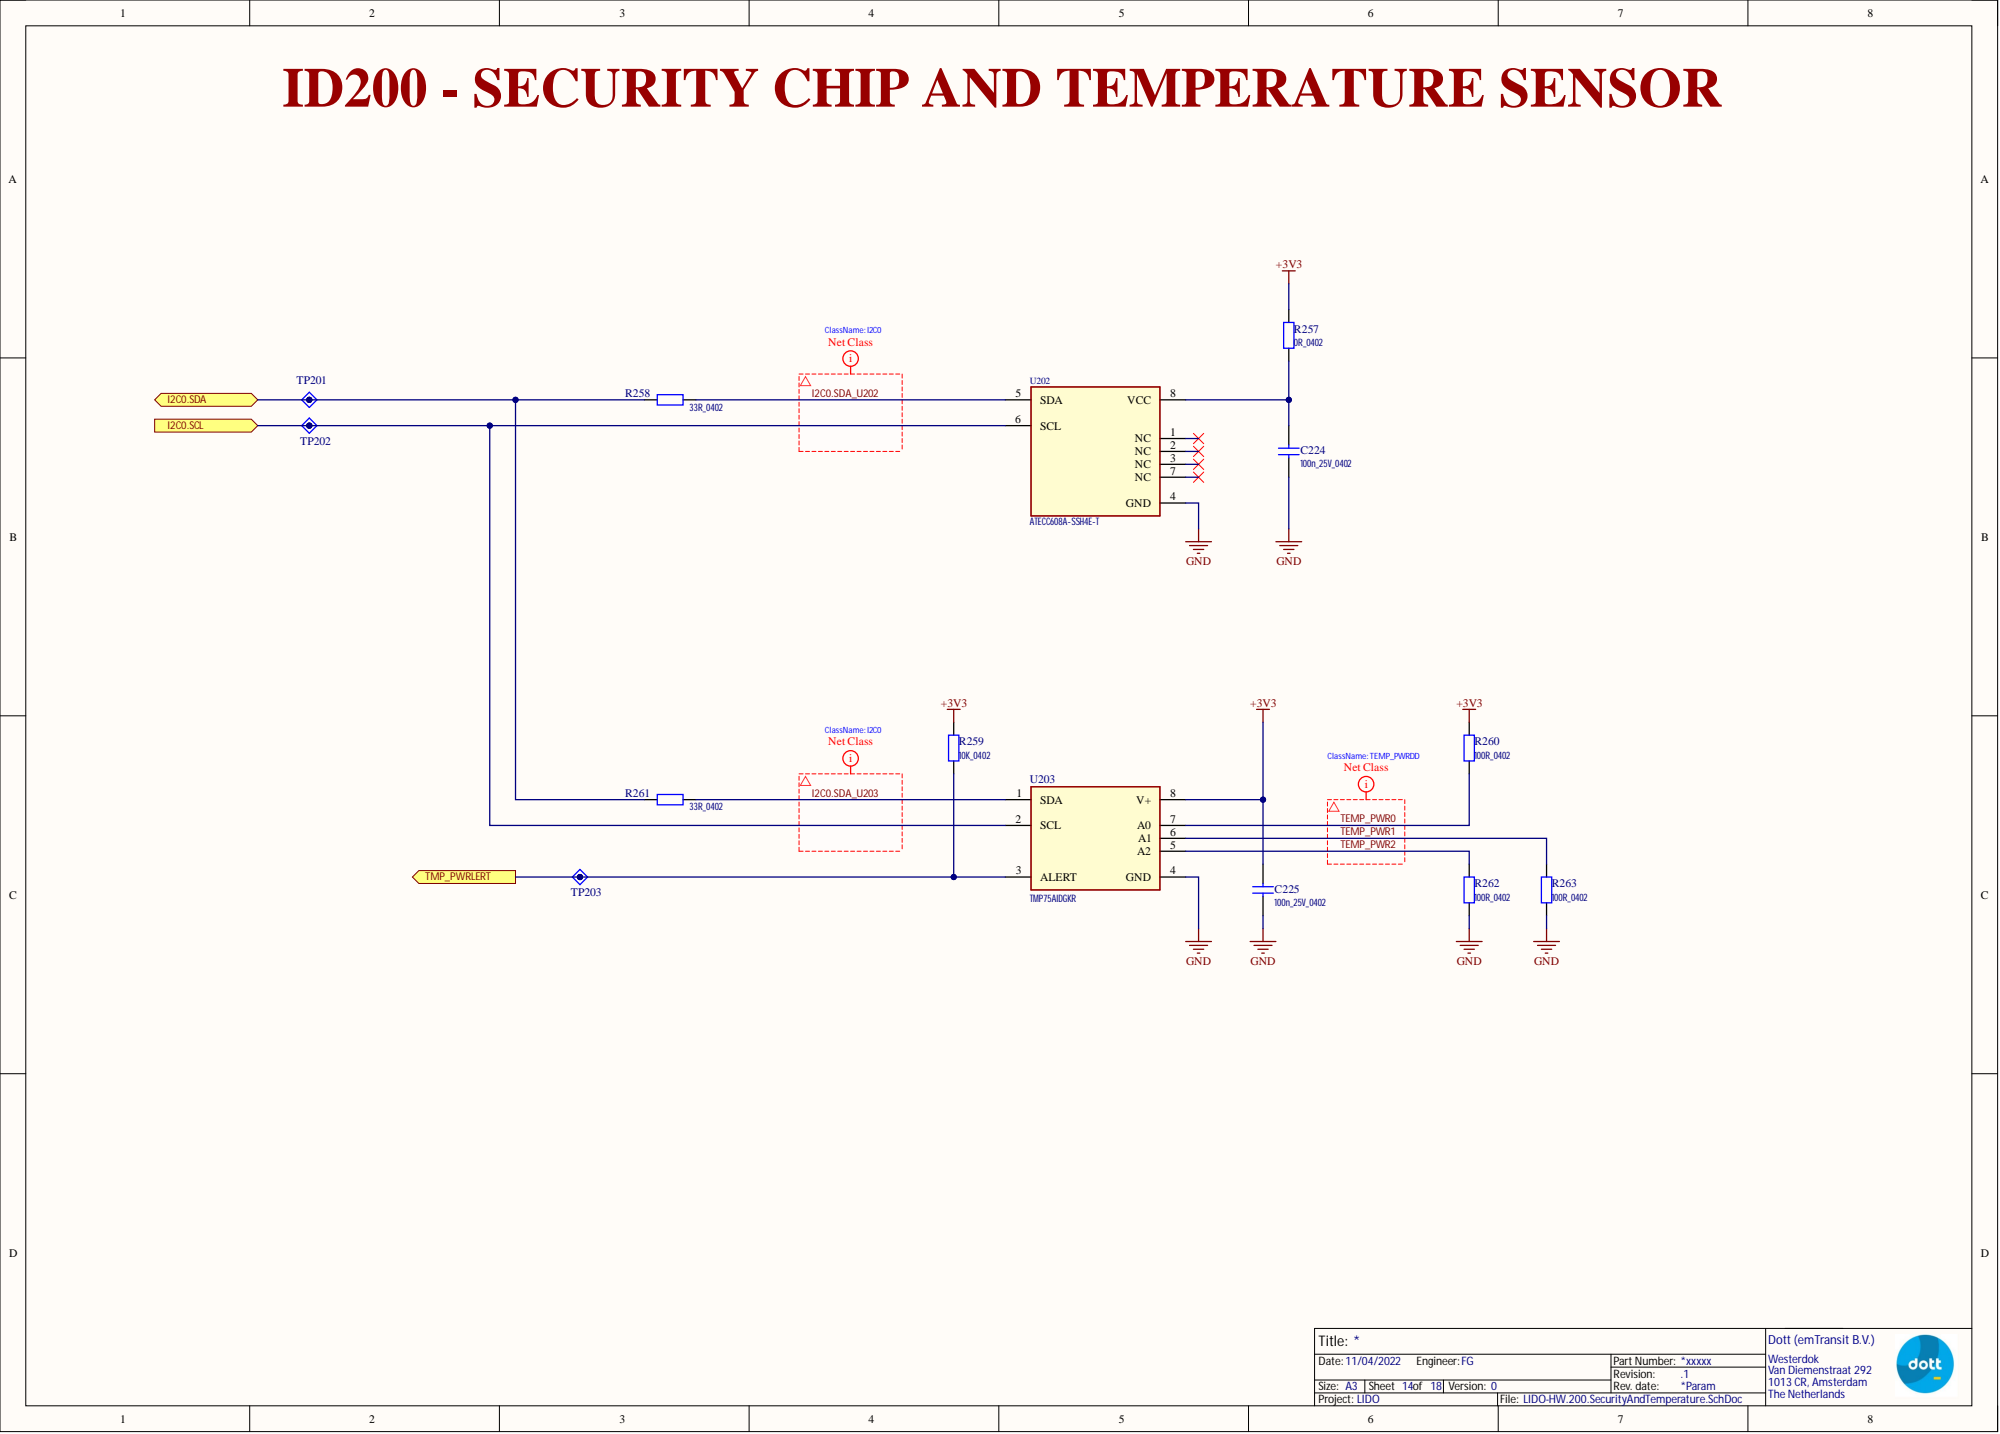
[picture p53: page 14]

ID200 - SECURITY CHIP AND TEMPERATURE SENSOR

ALERT 3 | TEMP_PWR1

TEMP_PWR2

LIDO-HW.200.SecurityAndTemperature.SchDoc

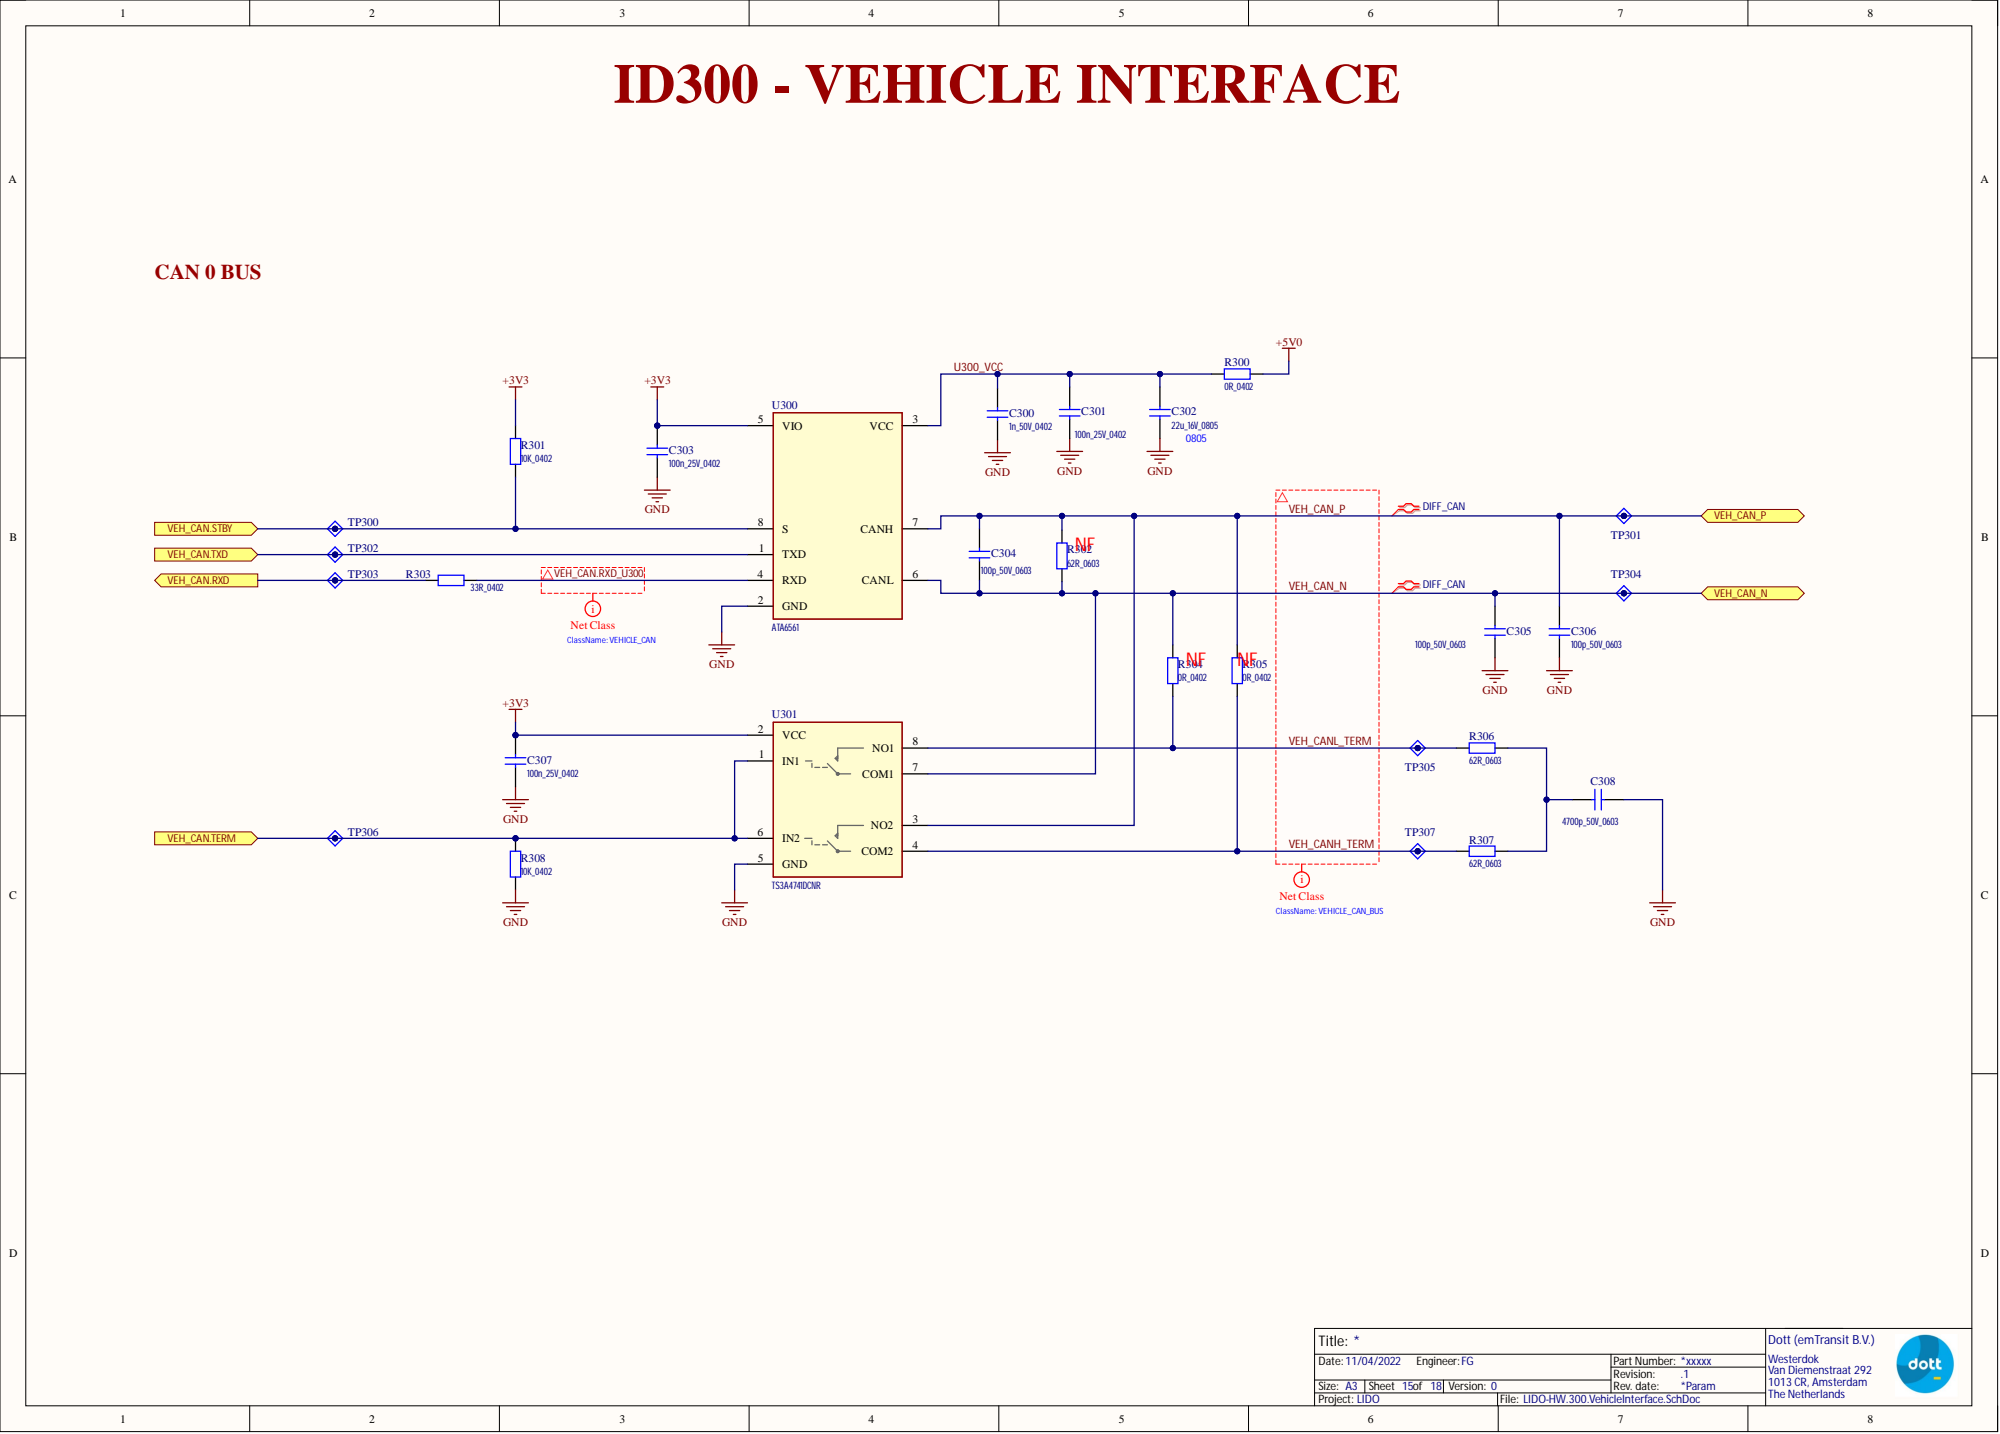
[picture p54: page 15]

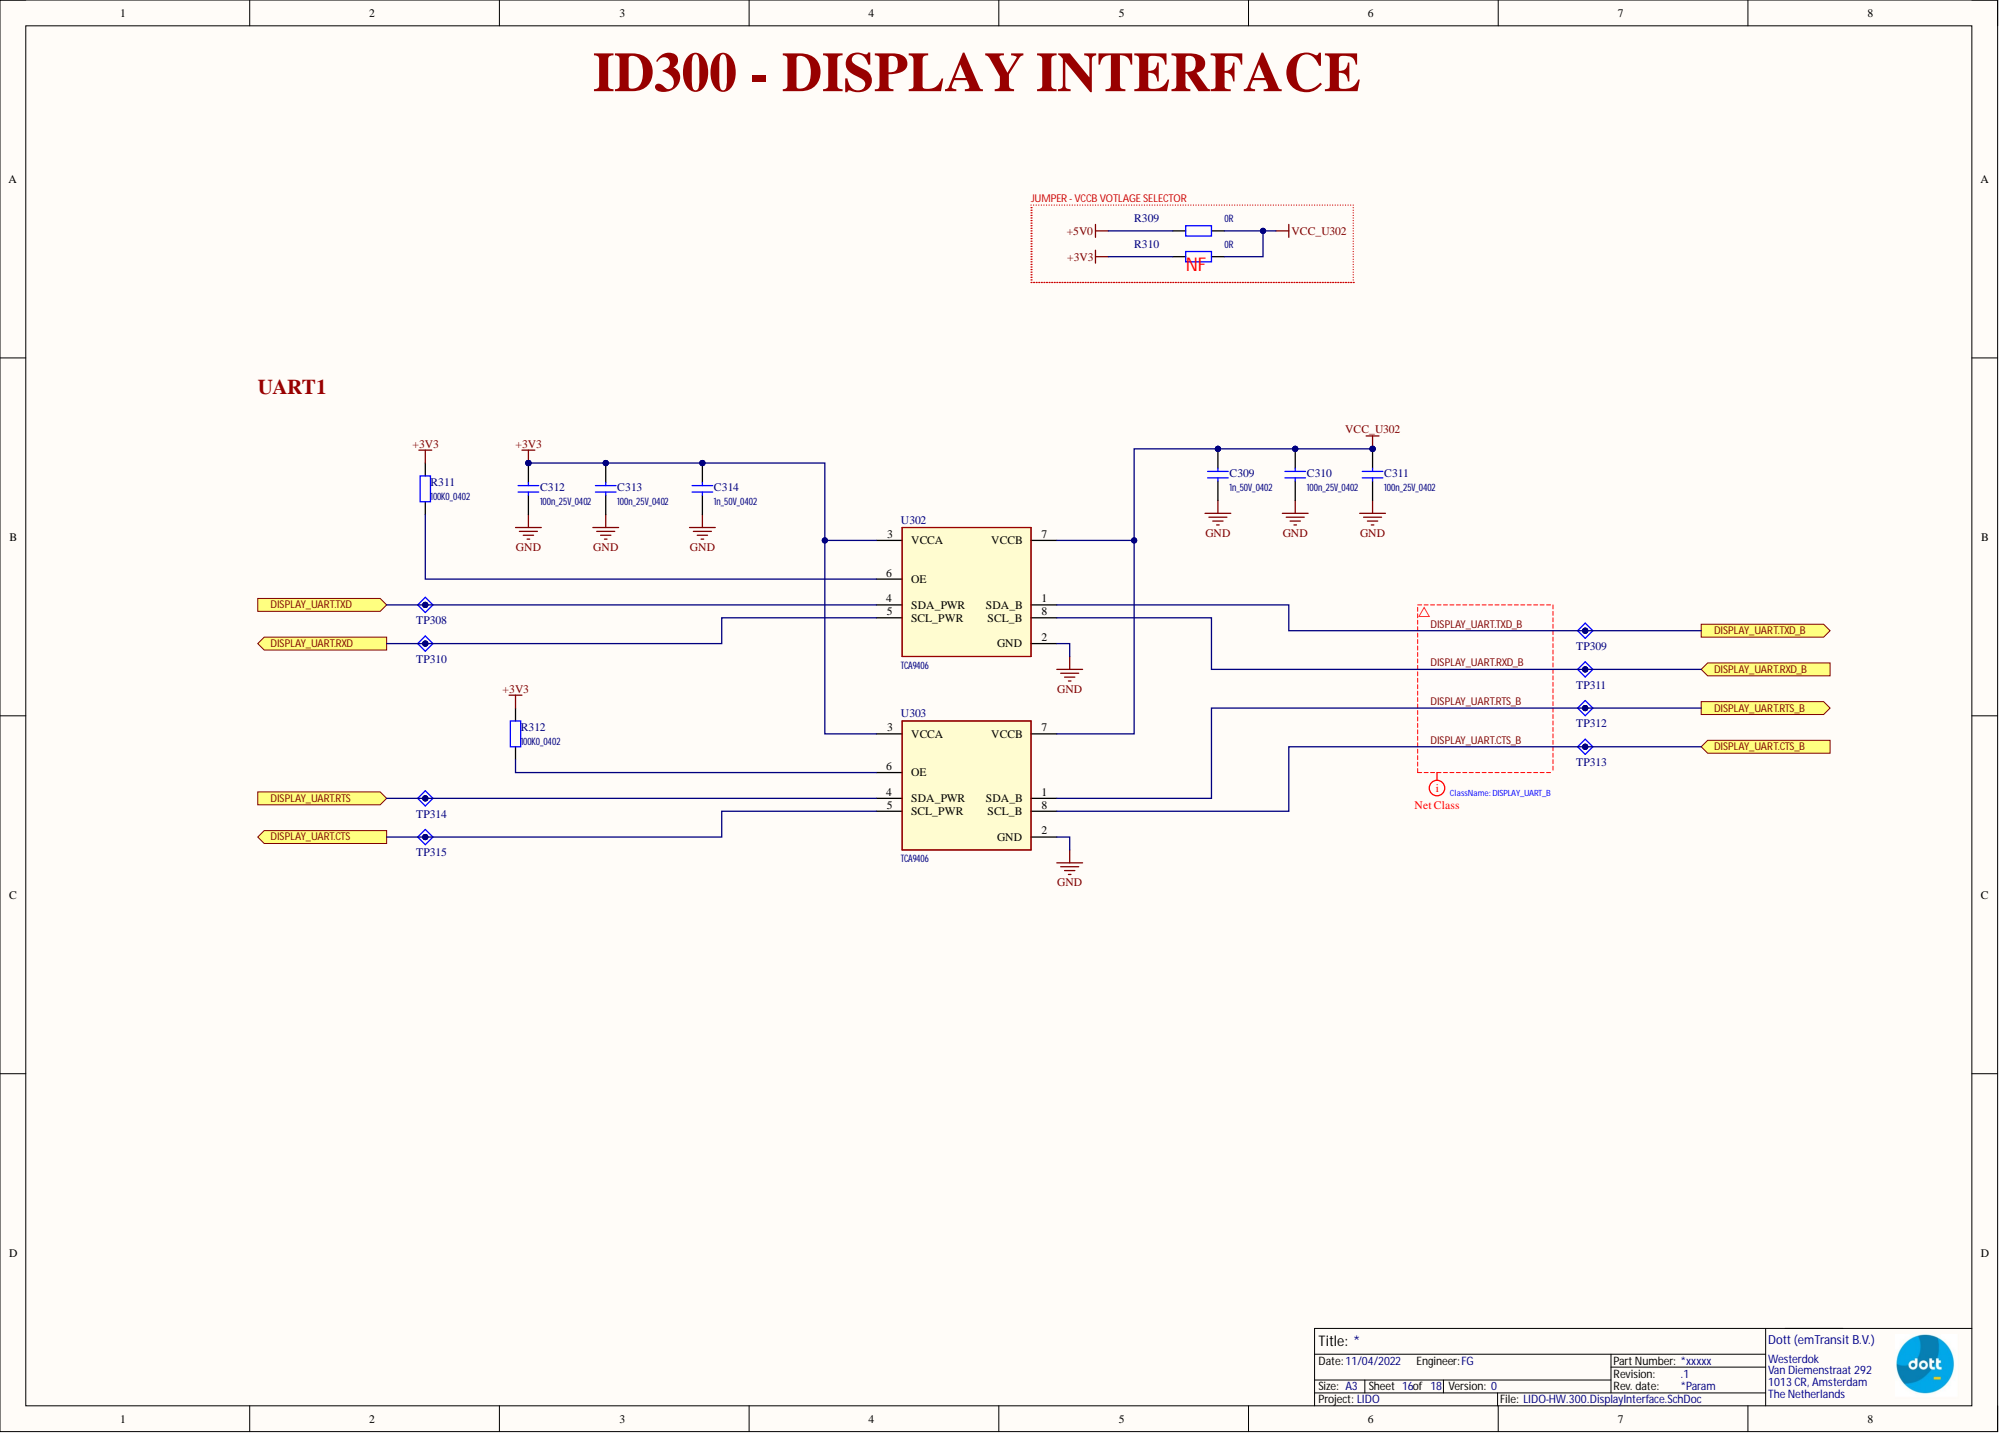
[picture p55: page 16]

JUMPER - VCCB VOTLAGE SELECTOR

GND

SDA_PWR 4

DISPLAY_UART.RXD_B | TP309

GND | DISPLAY_UART.RTS_B

DISPLAY_UART.CTS_B | TP312

SCL_PWR 5 | Net Class

LIDO-HW.300.DisplayInterface.SchDoc

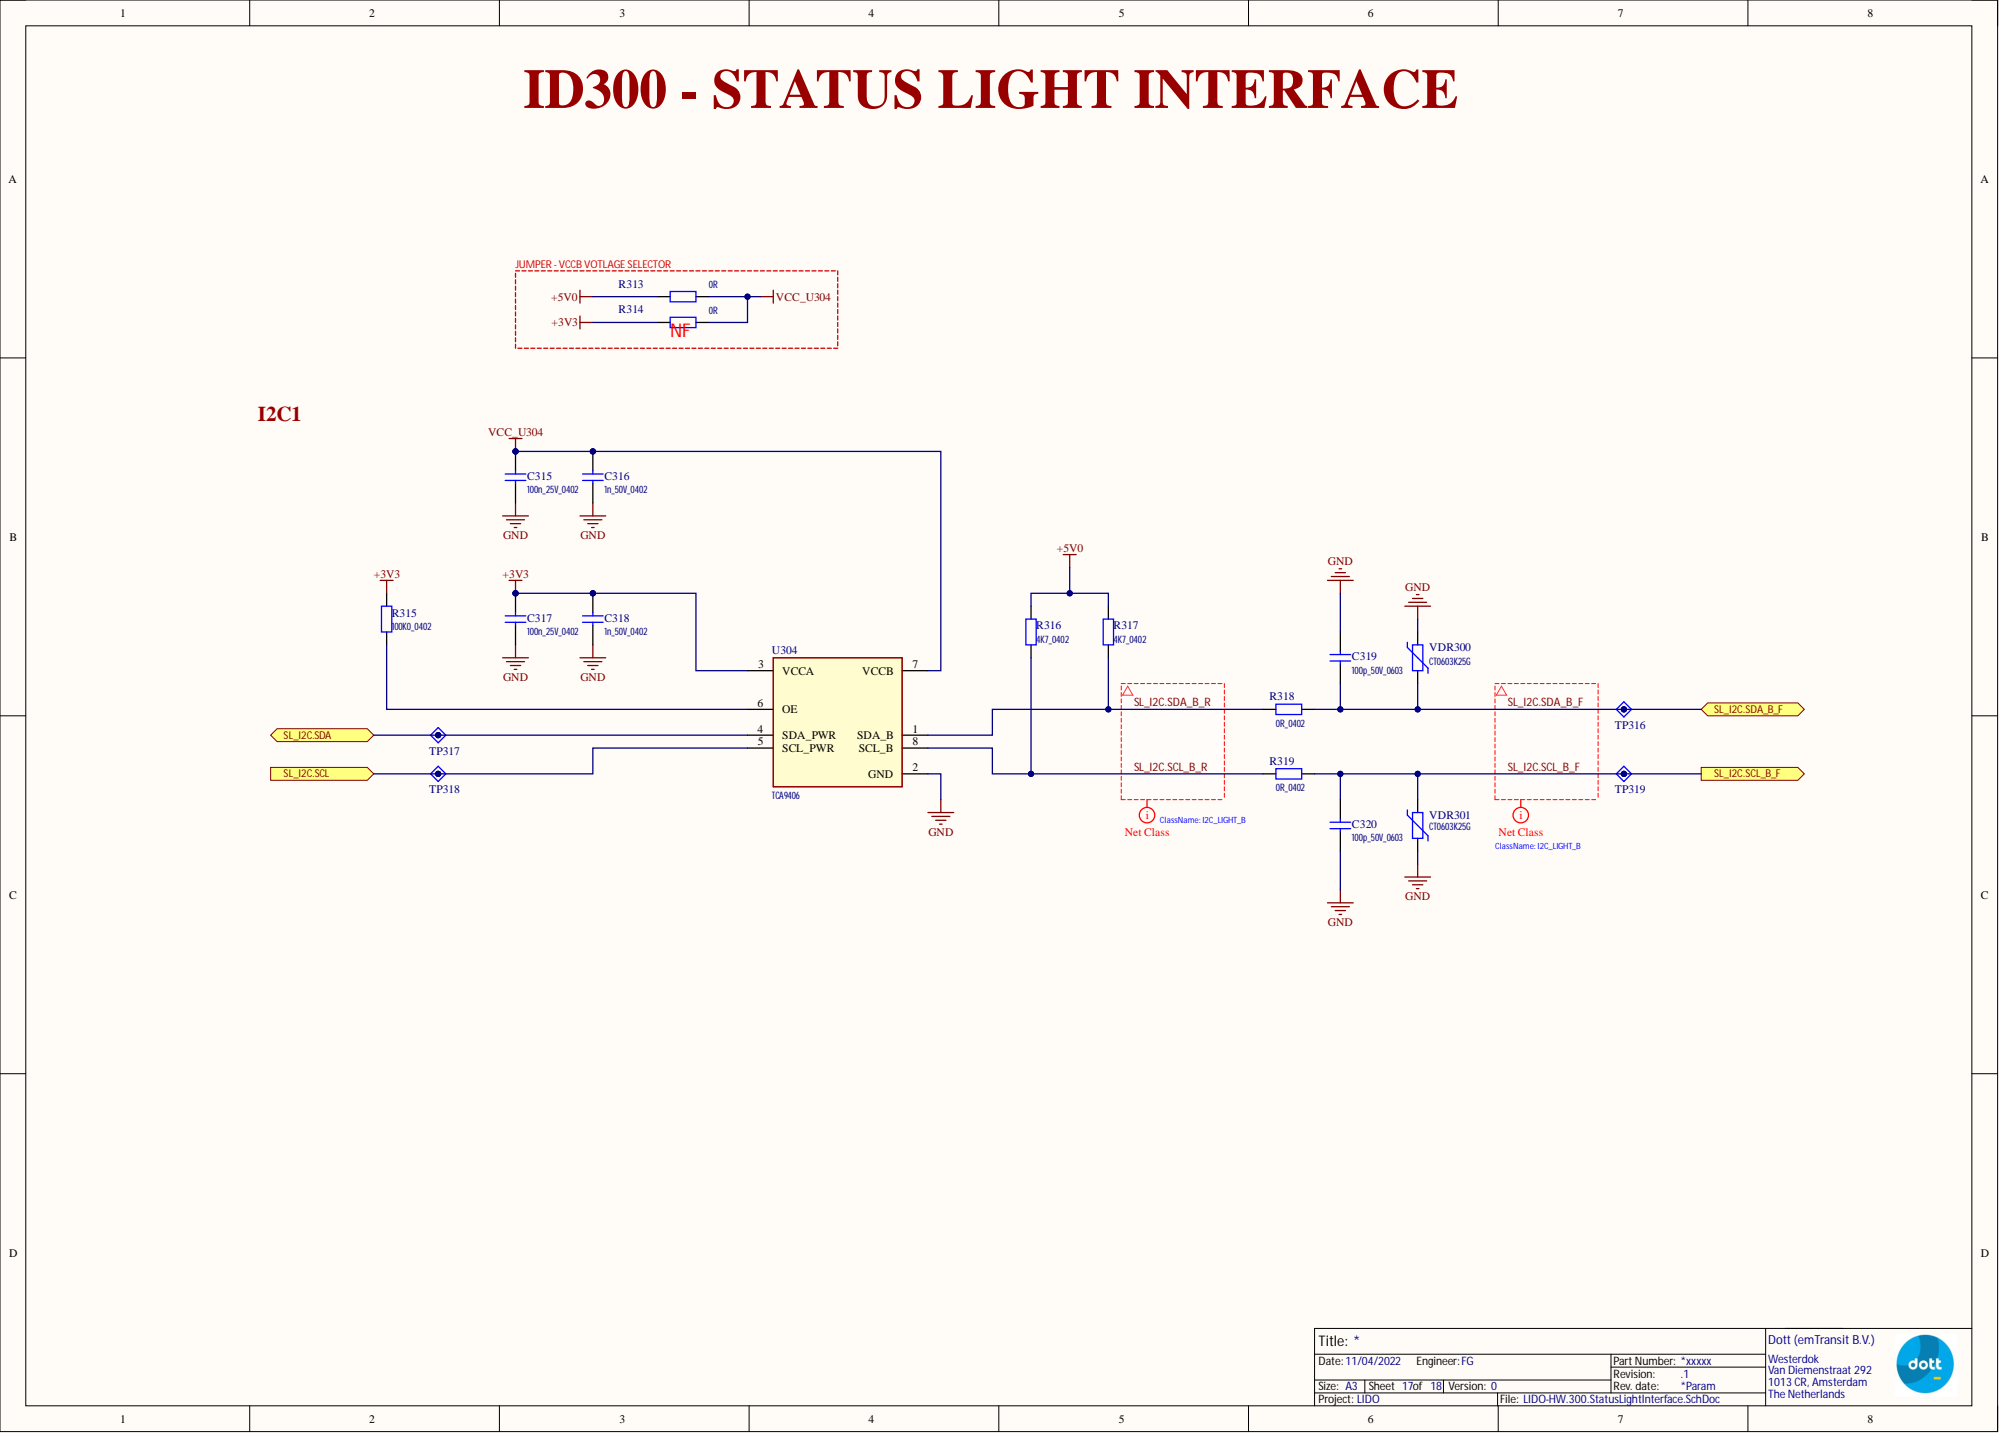
[picture p56: page 17]

JUMPER - VCCB VOTLAGE SELECTOR

LIDO-HW.300.StatusLightInterface.SchDoc

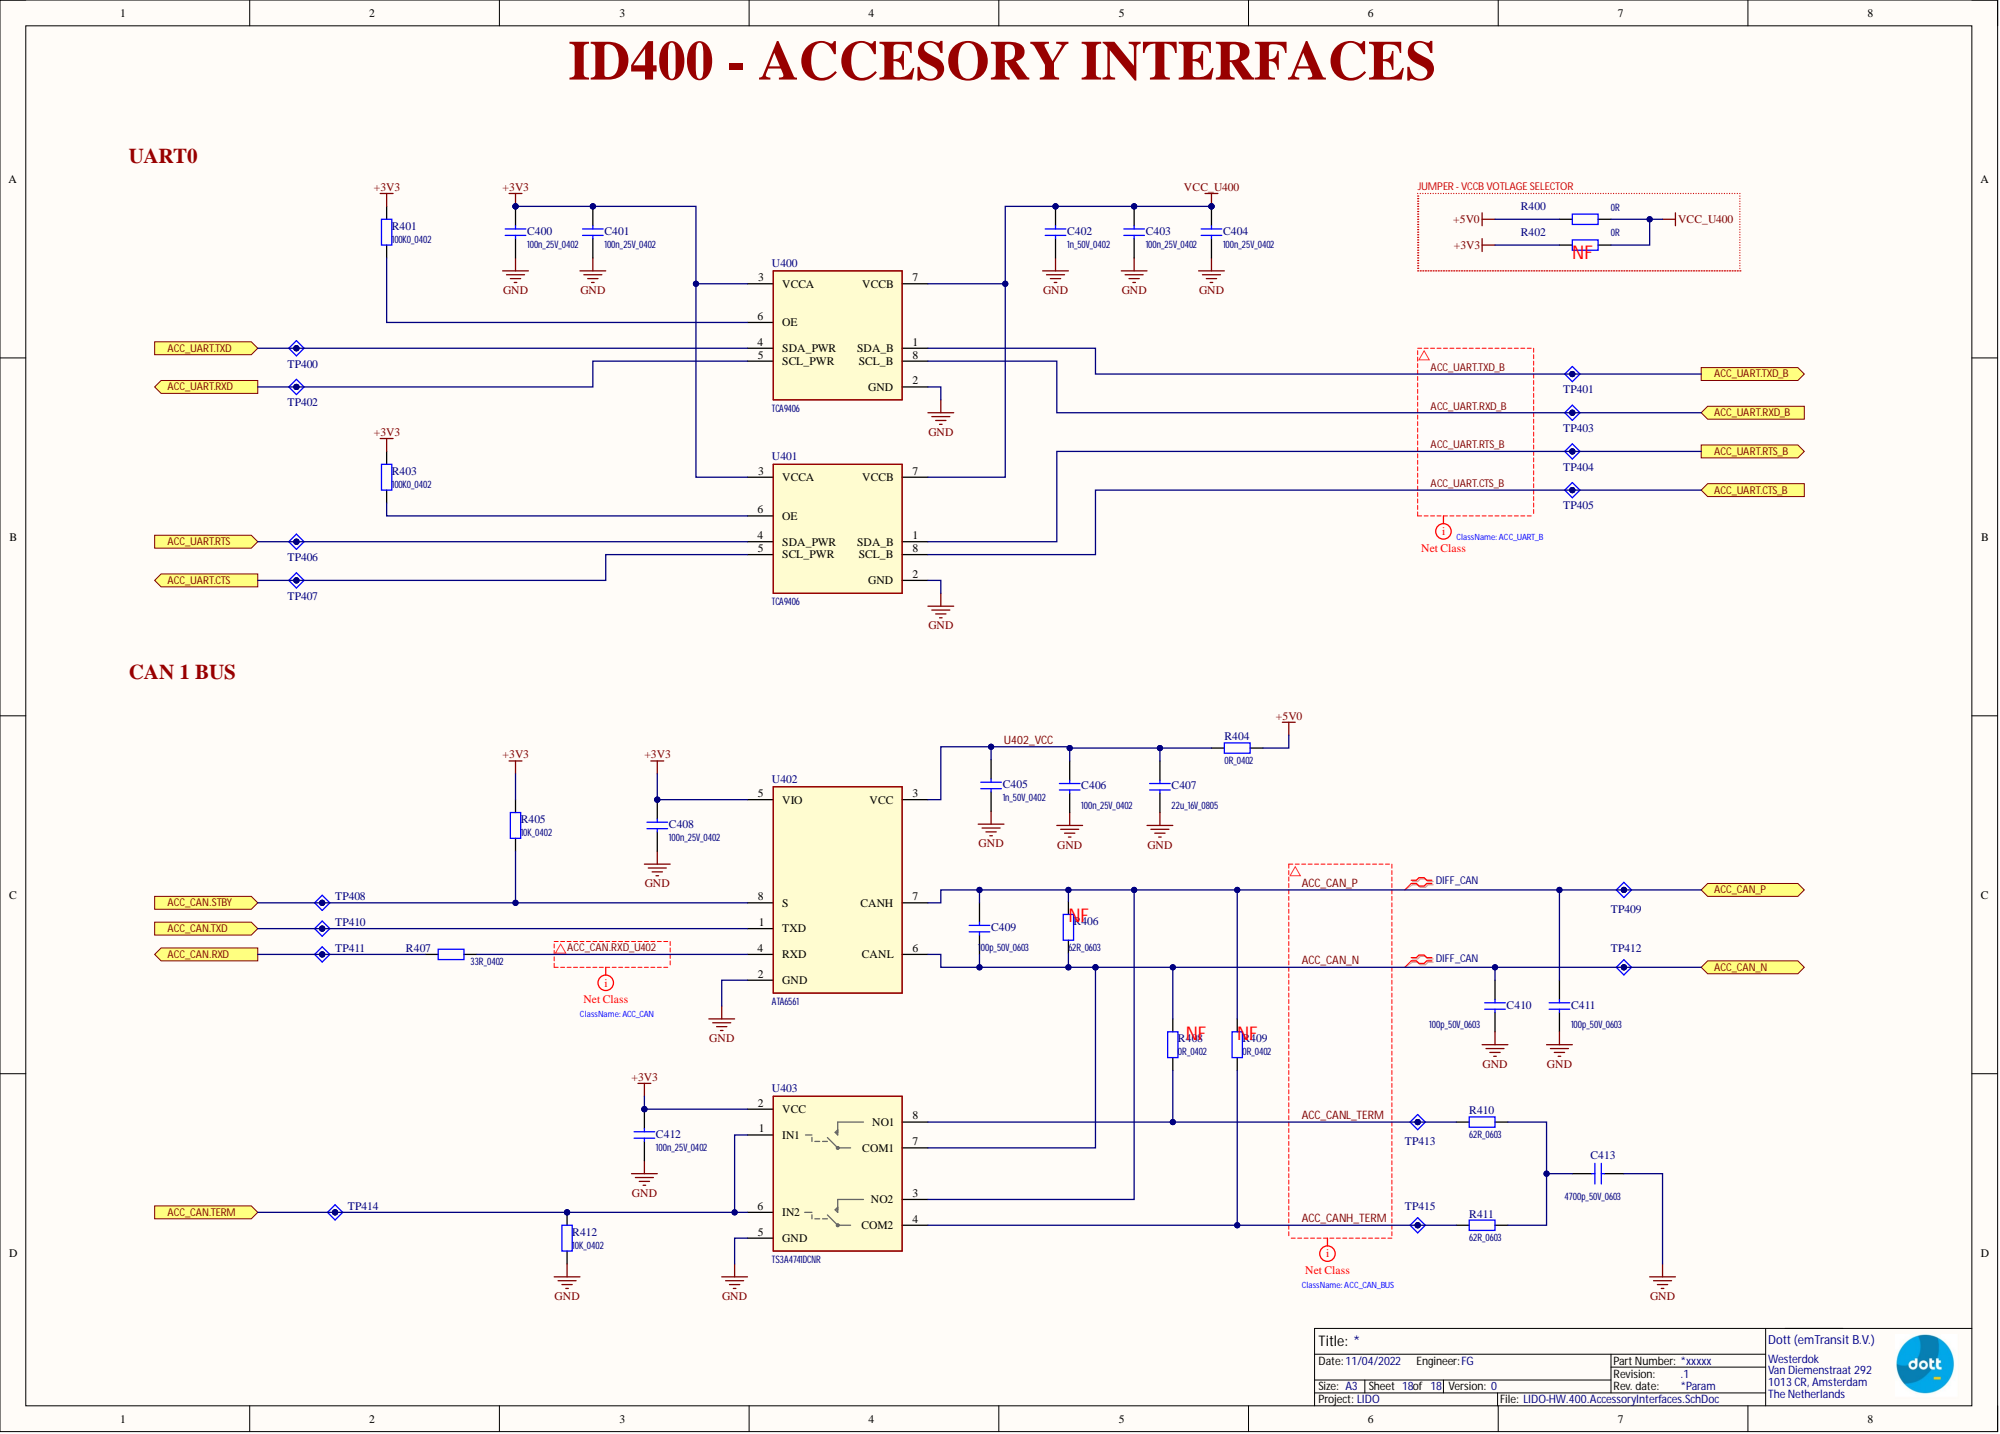
[picture p57: page 18]

JUMPER - VCCB VOTLAGE SELECTOR

ACC_UART.RXD_B | TP401

GND | ACC_UART.RTS_B

ACC_UART.CTS_B | TP404

SCL_PWR 5 | Net Class

ACC_CAN_N | DIFF_CAN

ACC_CANL_TERM

LIDO-HW.400.AccessoryInterfaces.SchDoc
