ridedott/lido-hardware/LIDO_HW_2022_04_V01/Output Documents/01_Schematics/LIDO_V00_29042022_draft.PDF

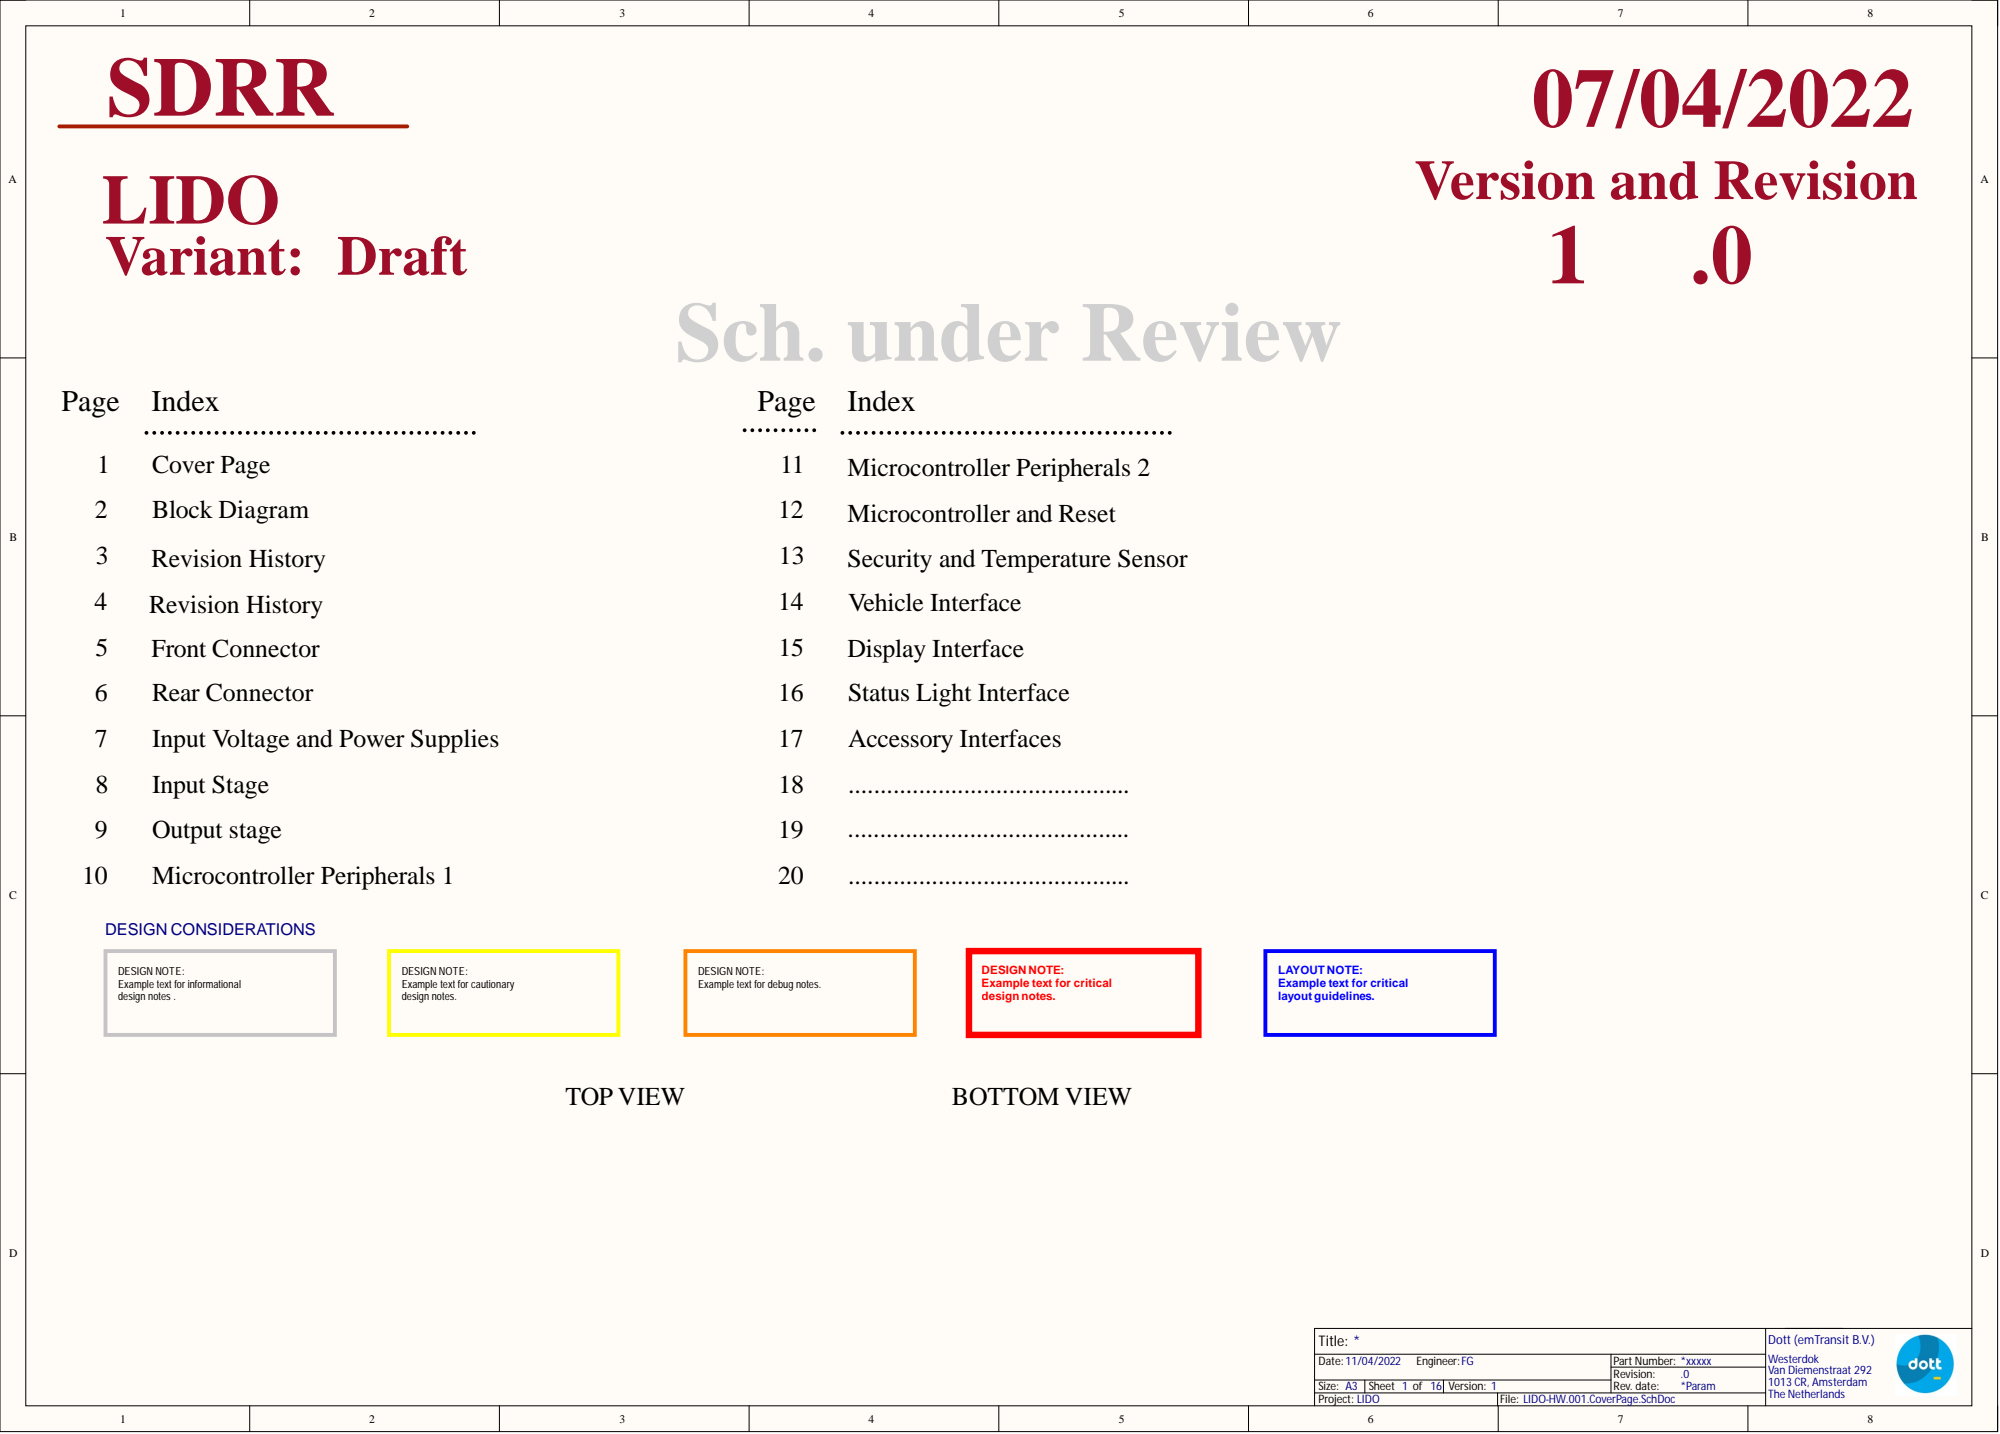
[picture p58: page 1]

Version and Revision LIDO

Input Voltage and Power Supplies

DESIGN NOTE:
Example text for informational
design notes .

Example text for cautionary
design notes.

Example text for debug notes.

Example text for critical

LAYOUT NOTE:
layout guidelines.

LIDO-HW.001.CoverPage.SchDoc

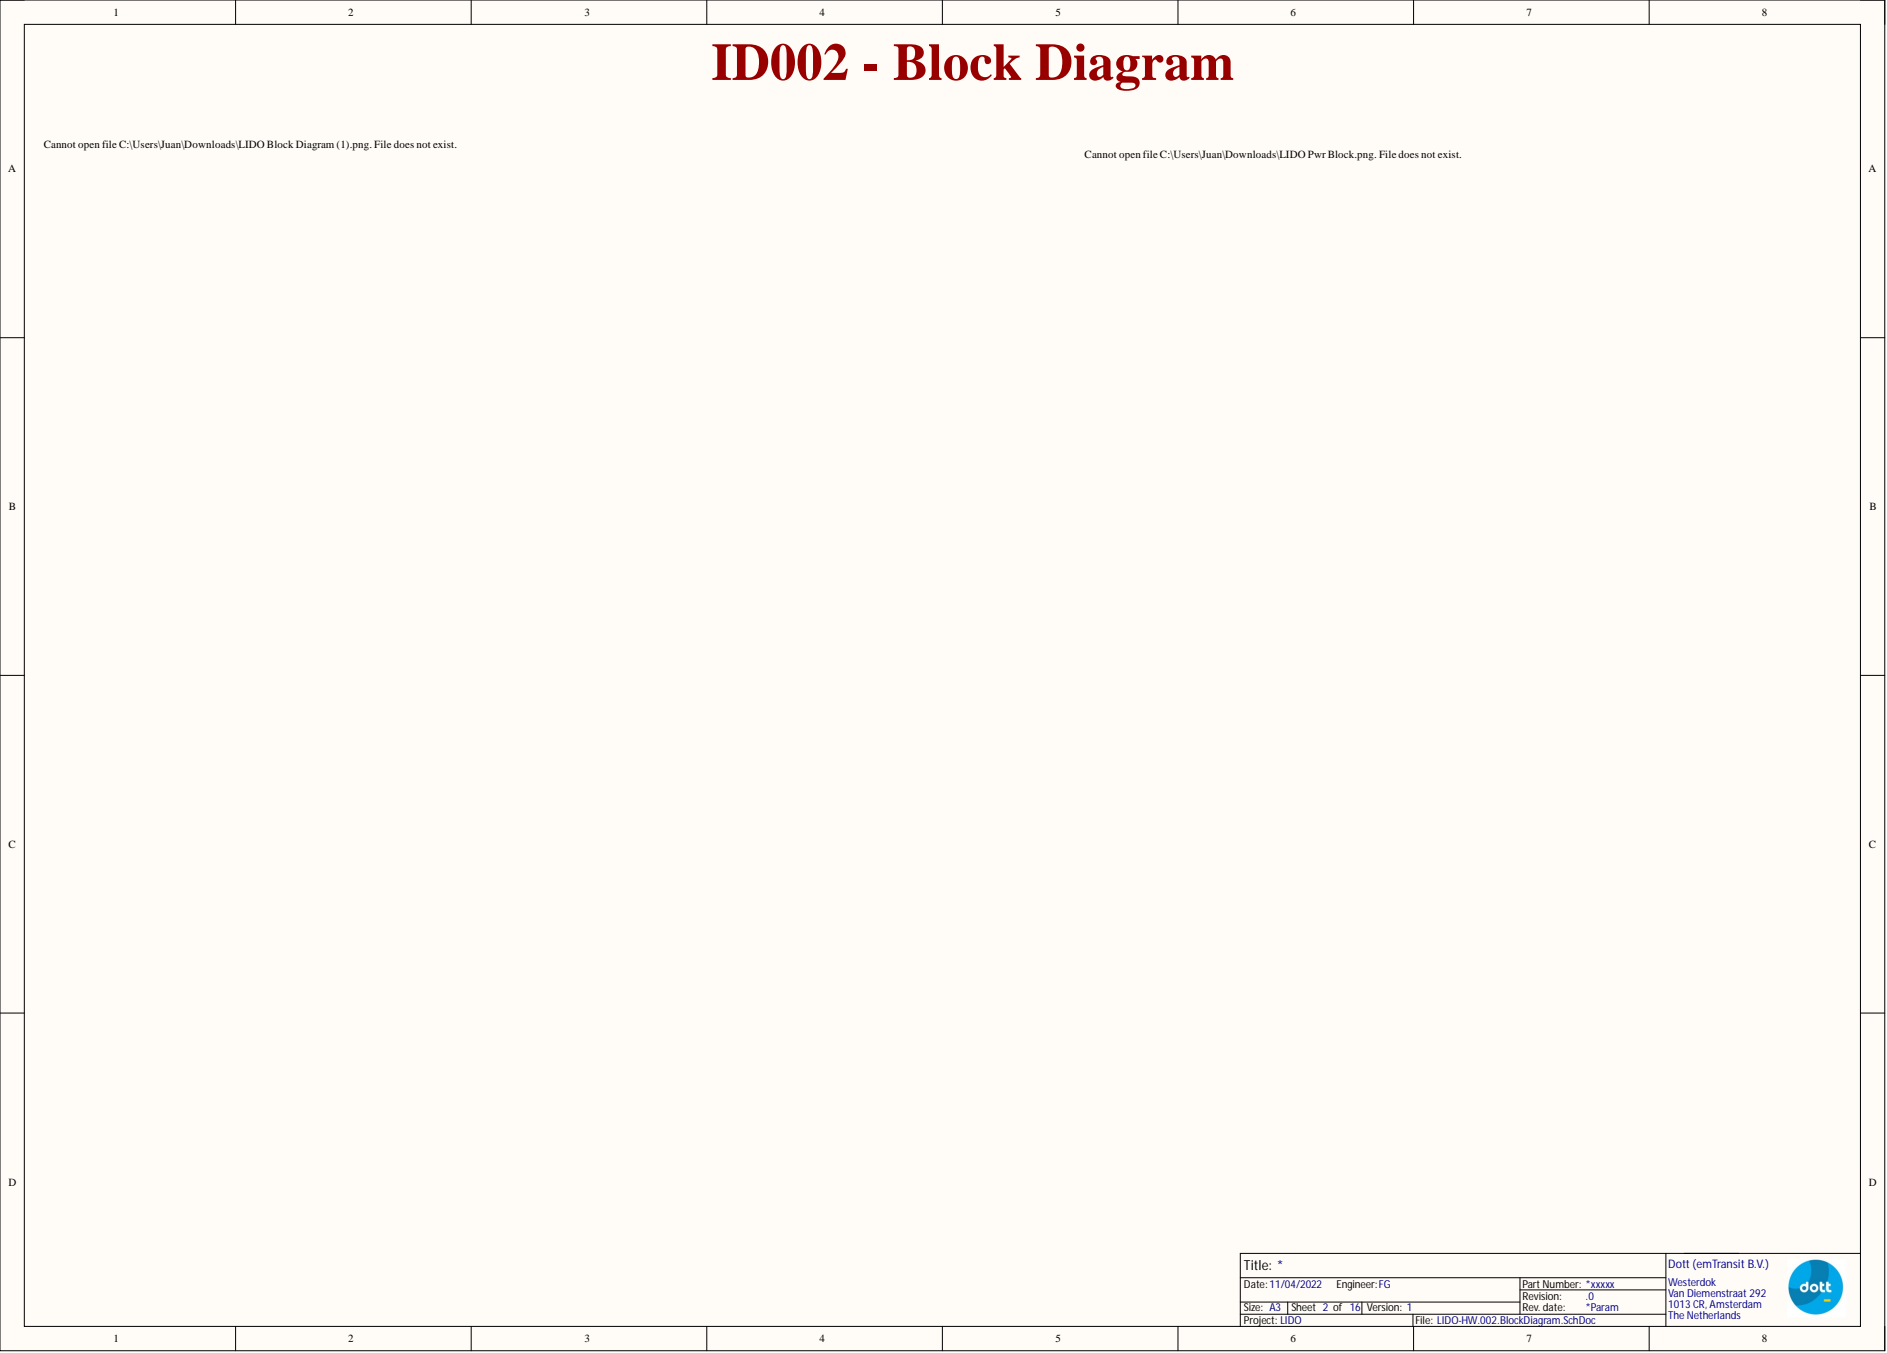
[picture p59: page 2]

Cannot open file C:\Users\Juan\Downloads\LIDO Pwr Block.png. File does not exist. Cannot open file C:\Users\Juan\Downloads\LIDO Block Diagram (1).png. File does not exist.

LIDO-HW.002.BlockDiagram.SchDoc

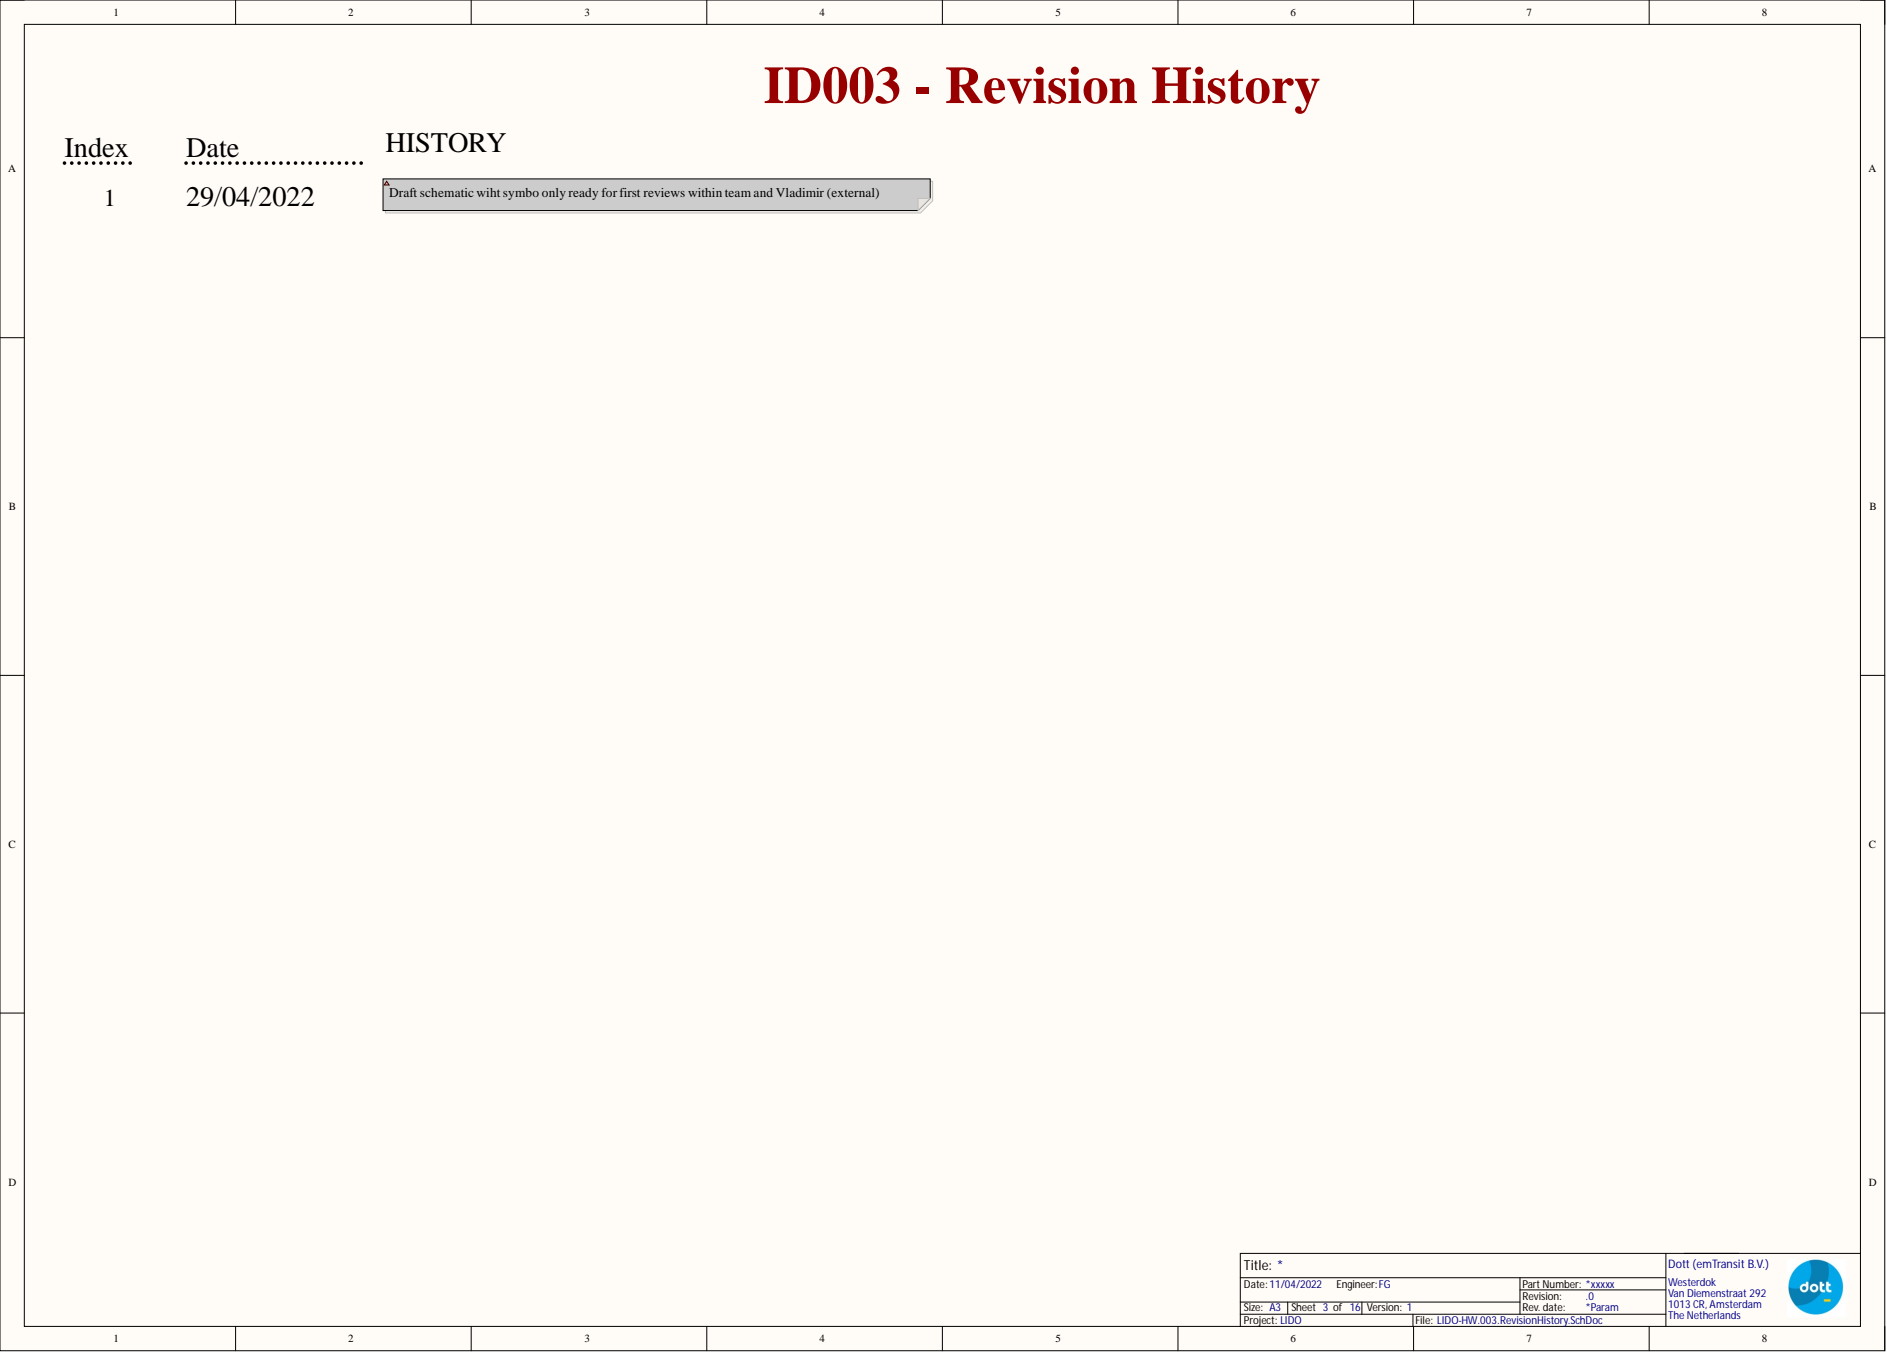
[picture p60: page 3]

LIDO-HW.003.RevisionHistory.SchDoc

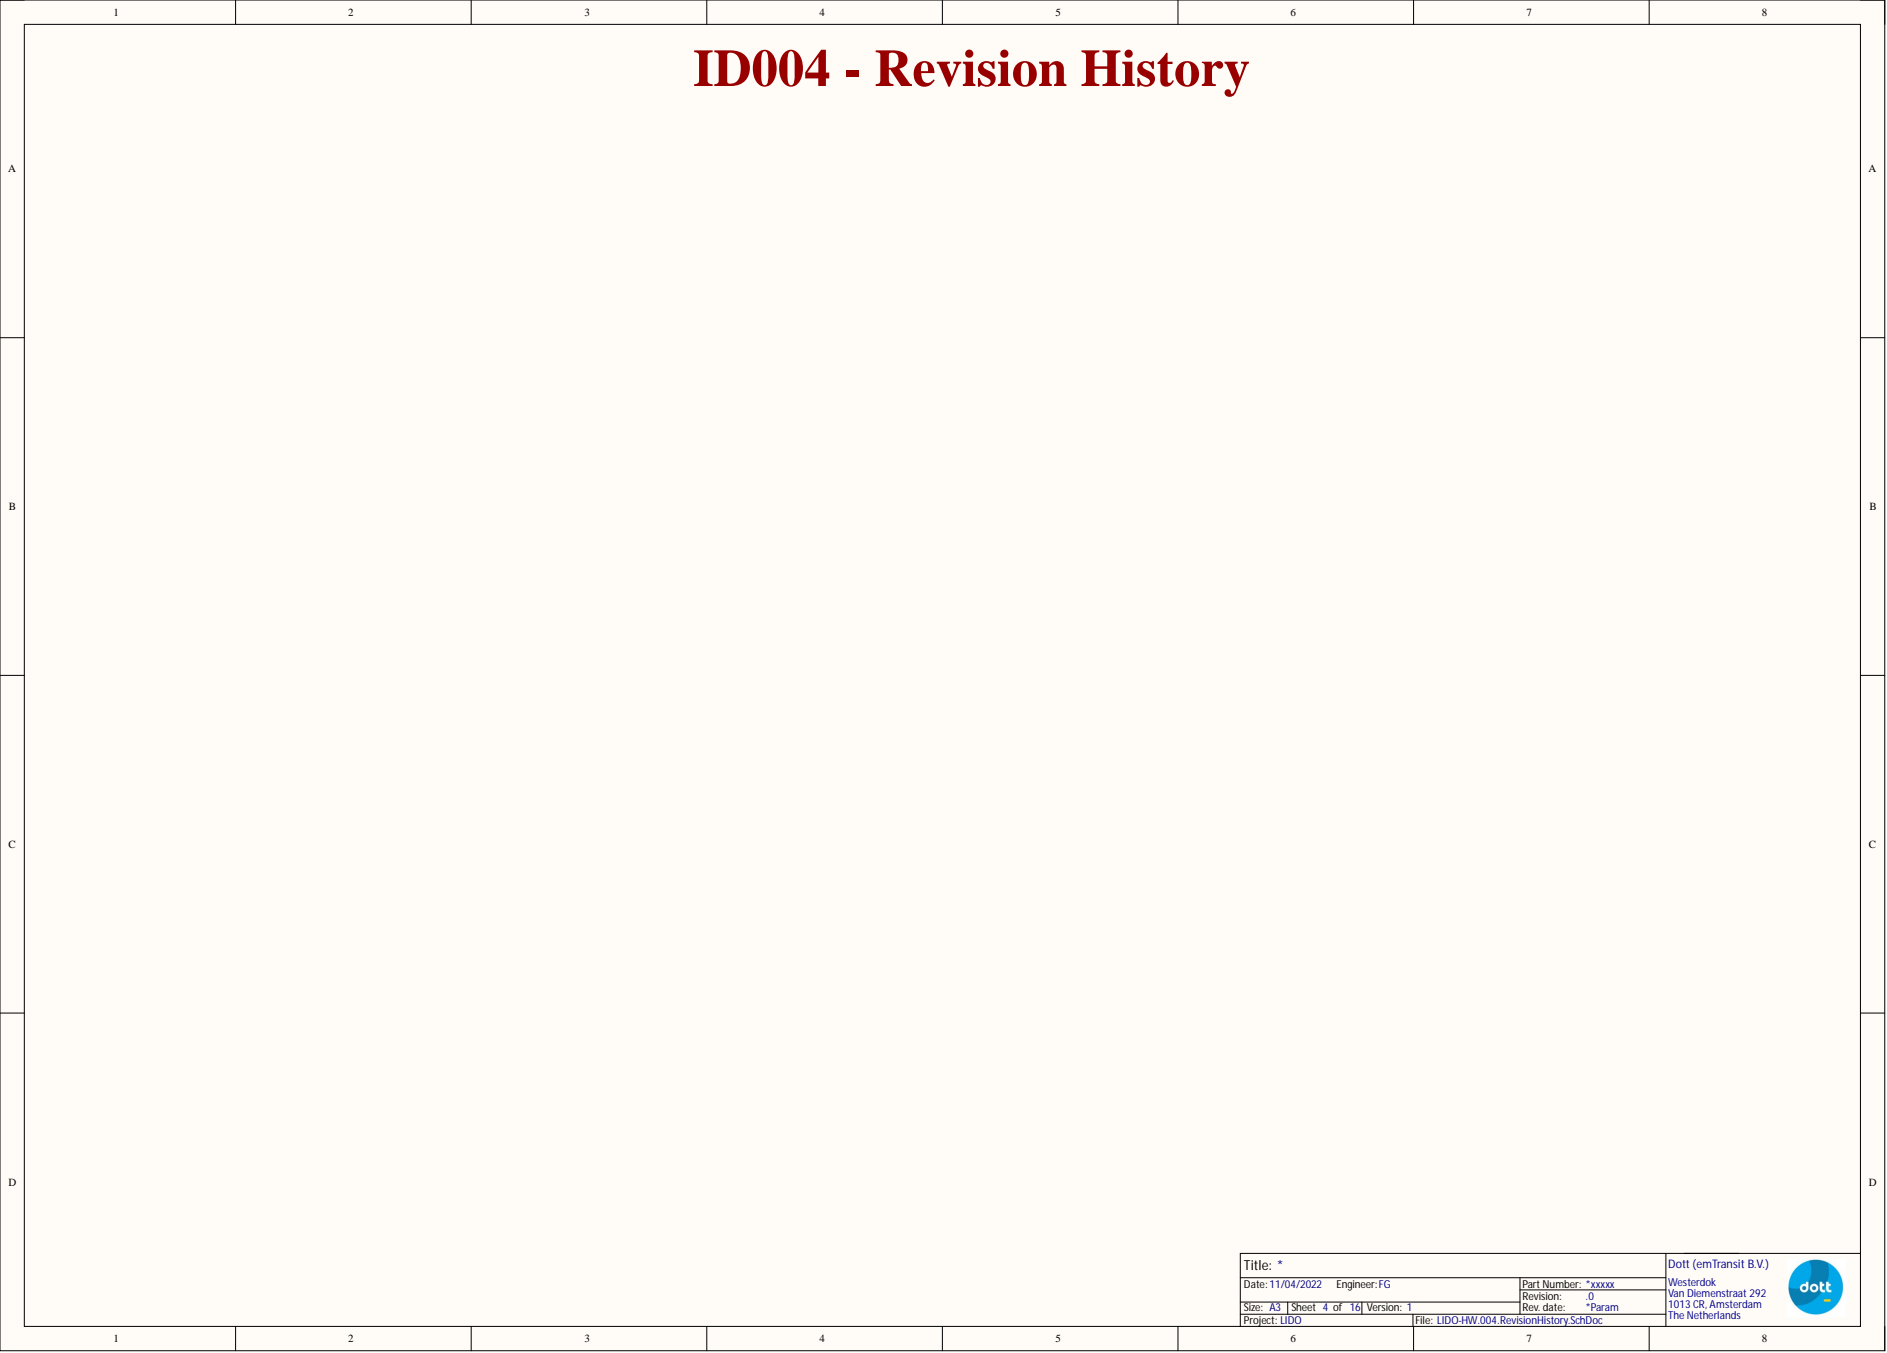
[picture p61: page 4]

LIDO-HW.004.RevisionHistory.SchDoc

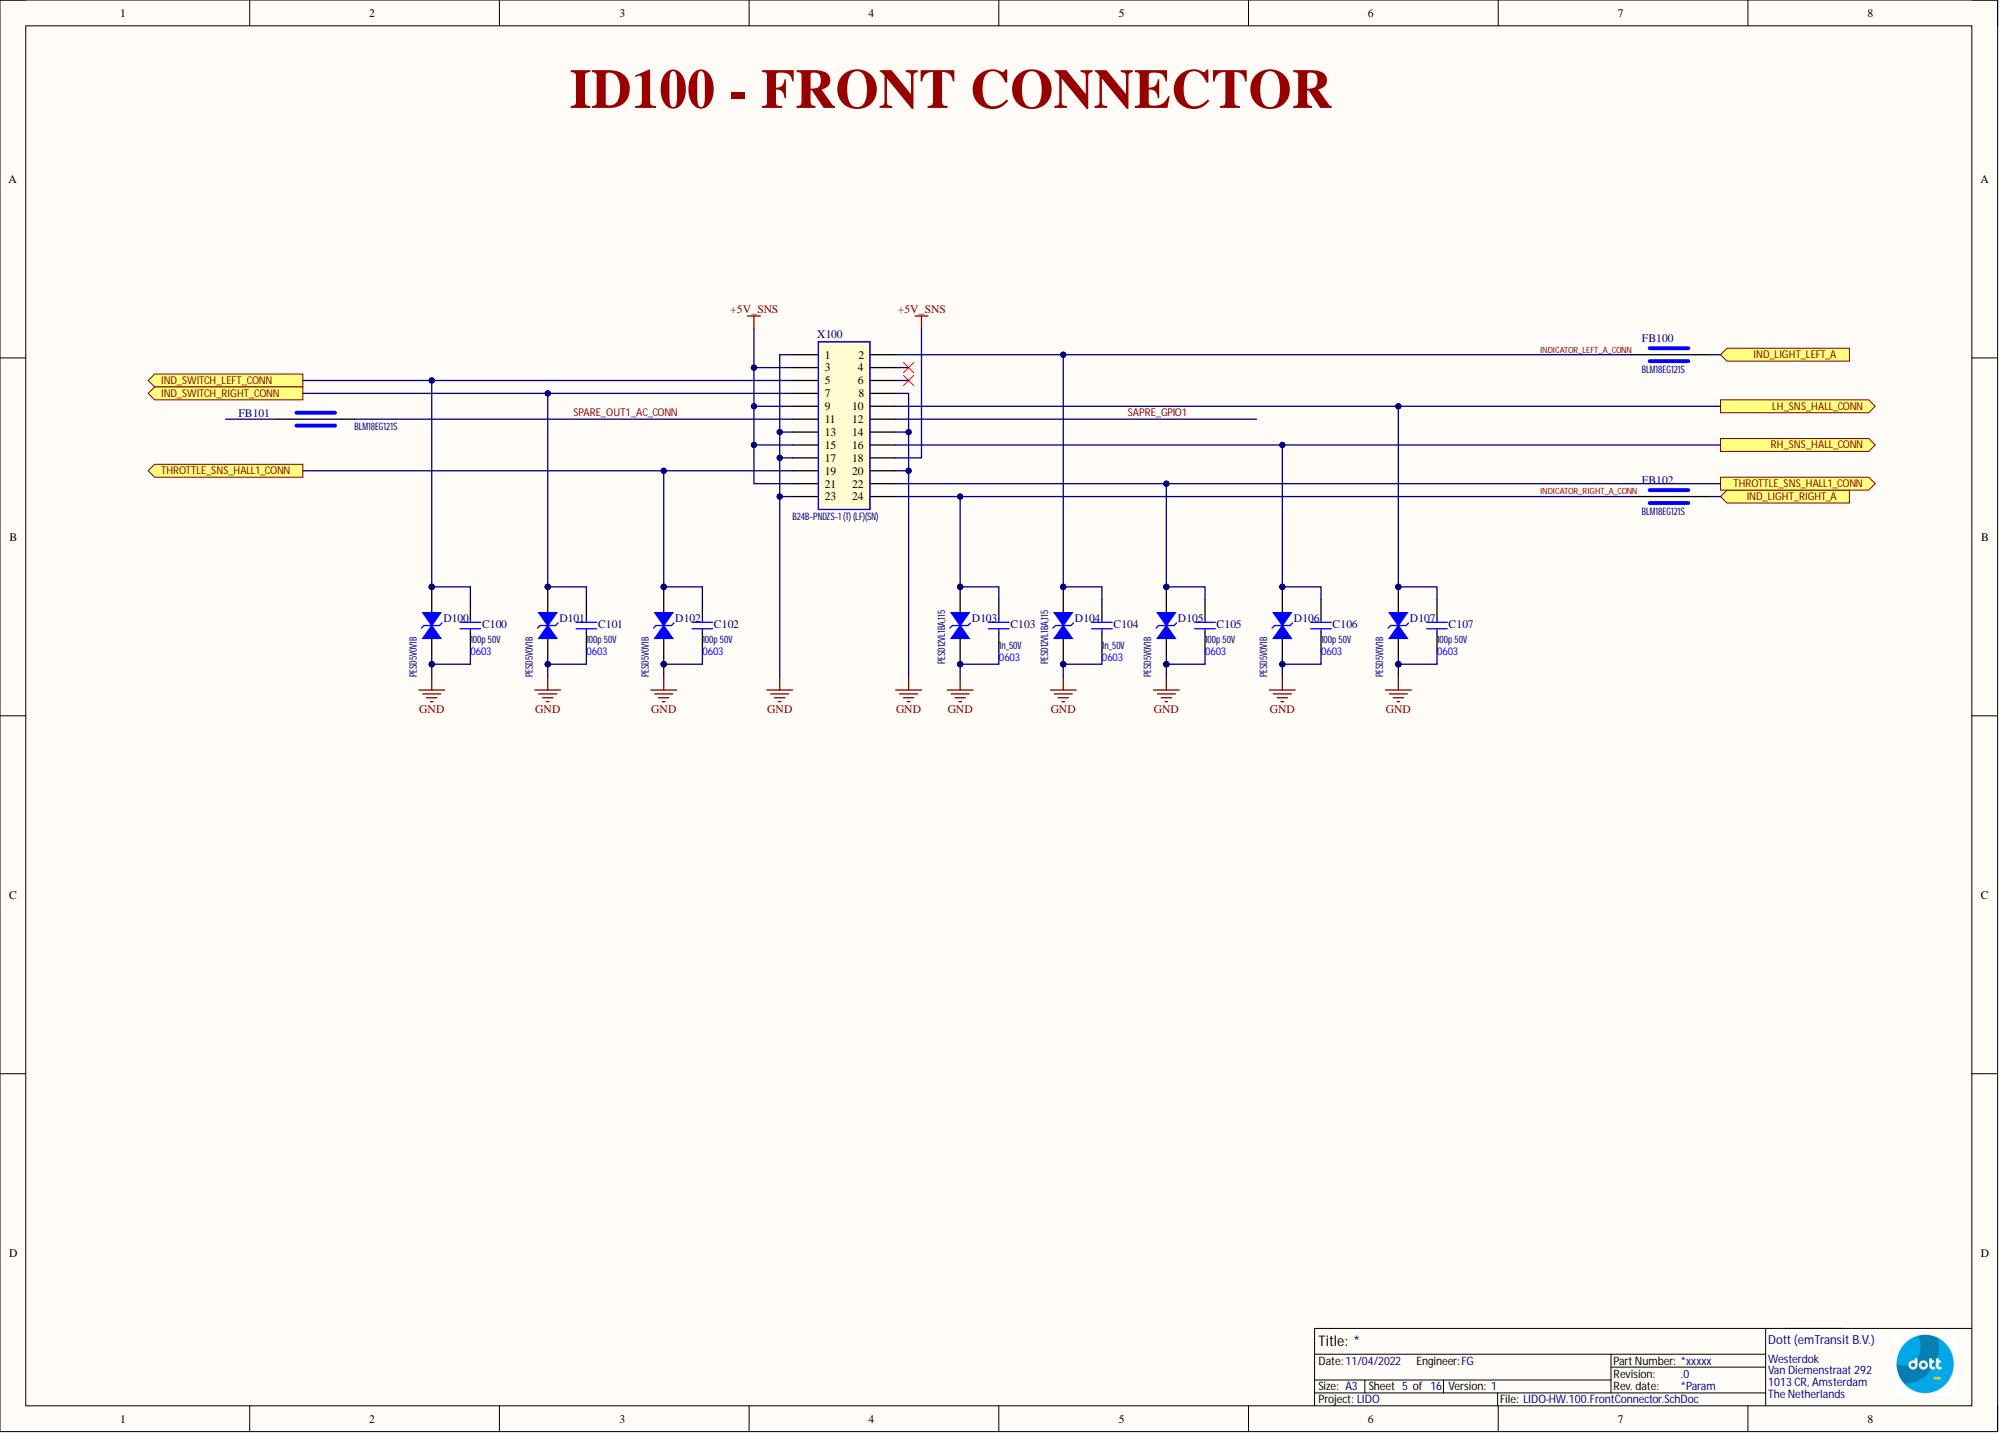
[picture p62: page 5]

LIDO-HW.100.FrontConnector.SchDoc

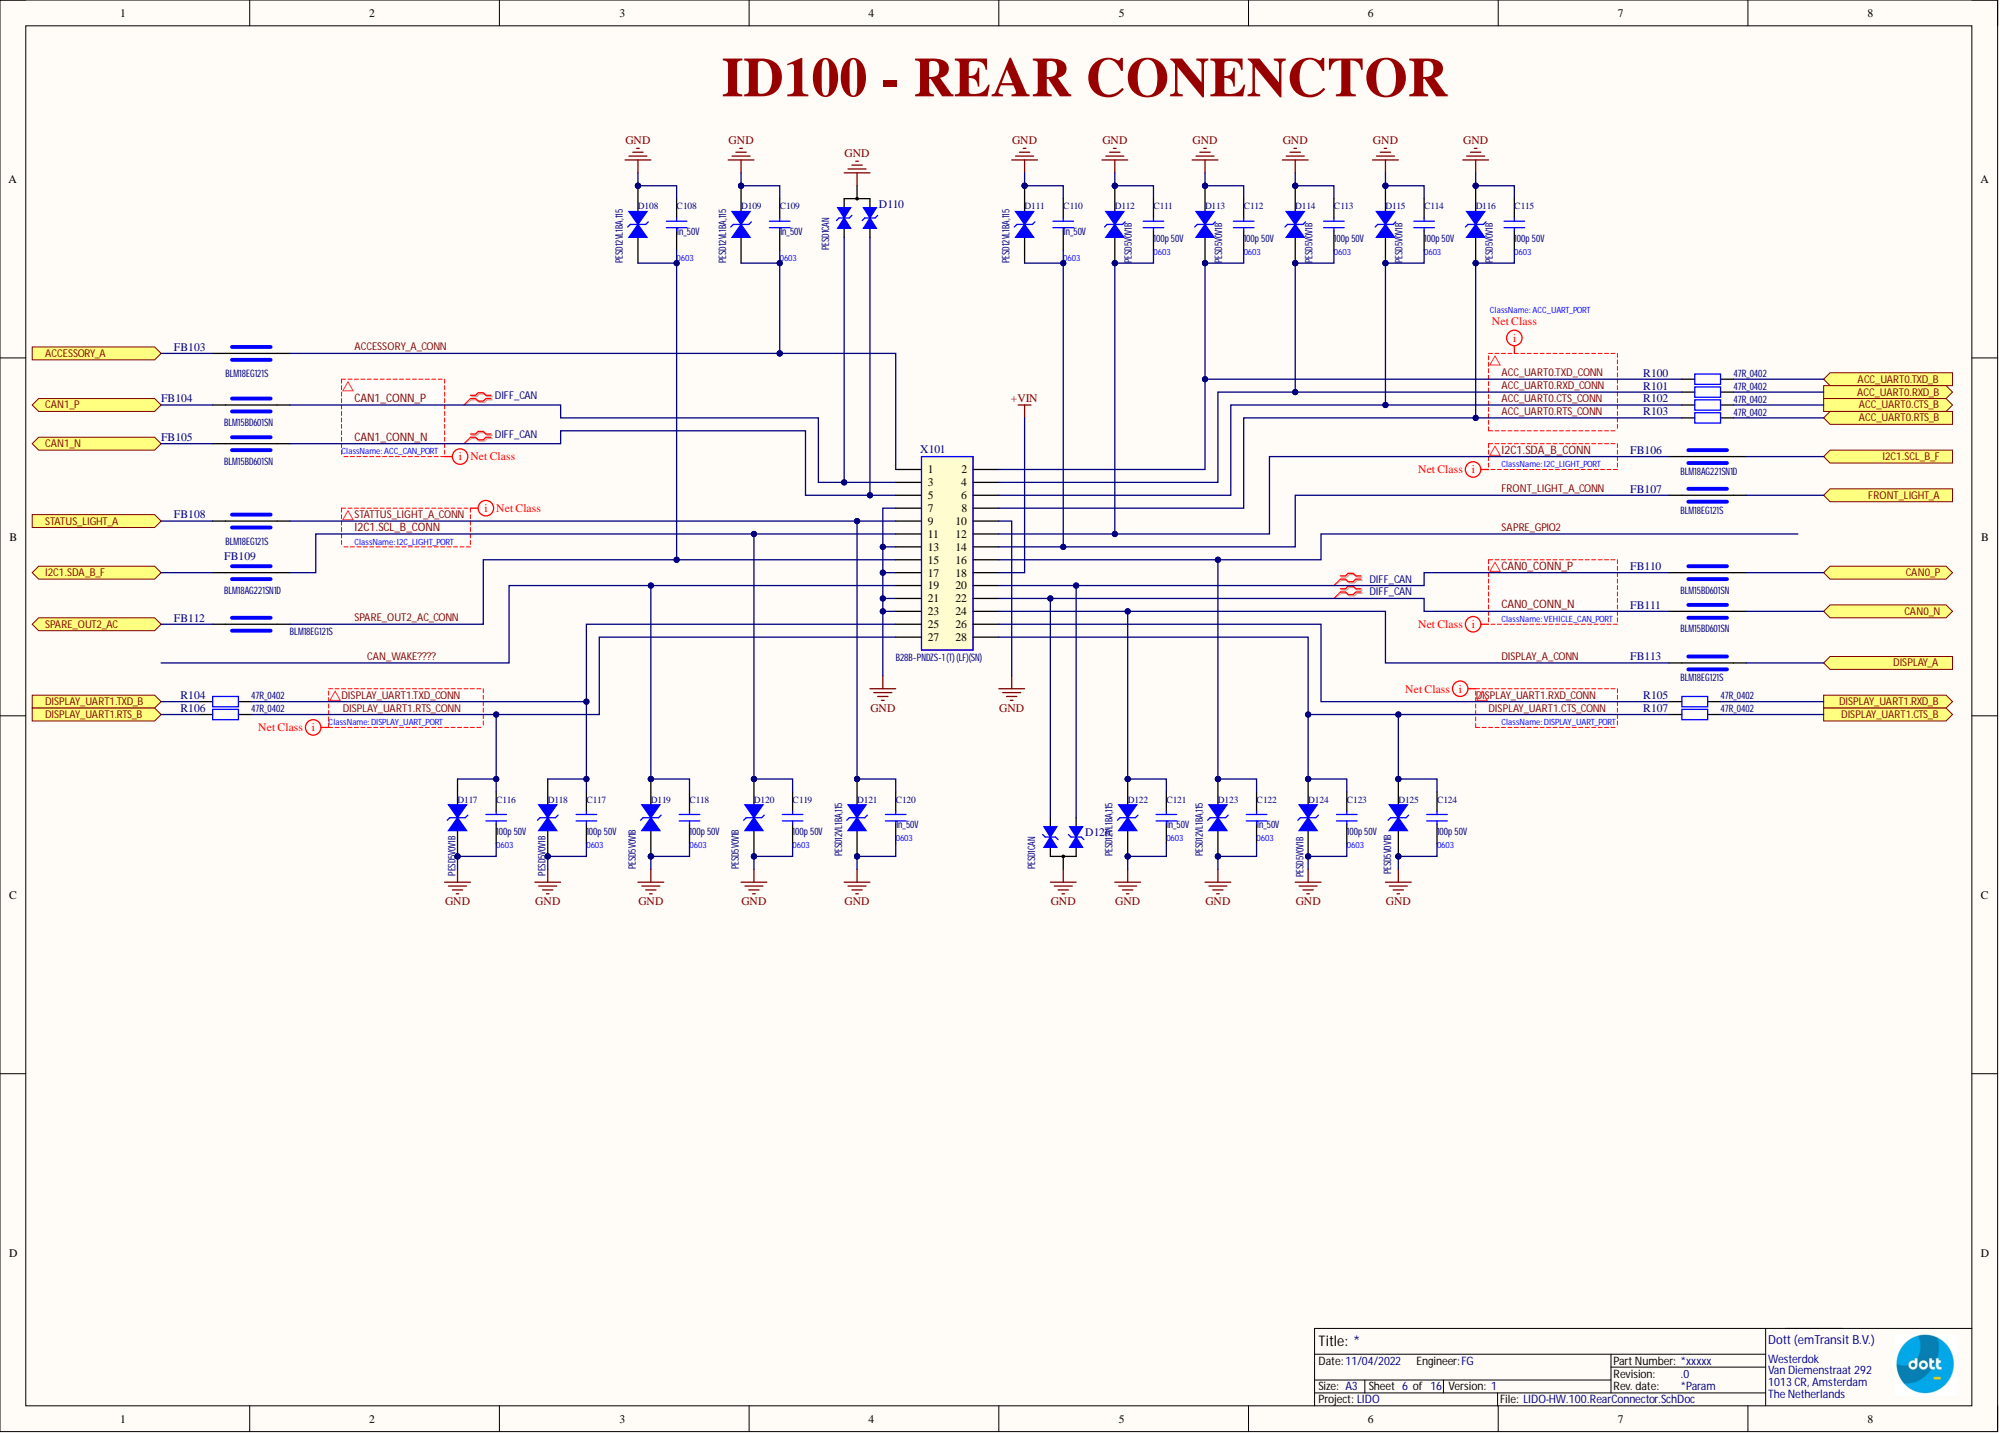
[picture p63: page 6]

I2C1.SCL_B_CONN
ClassName: I2C_LIGHT_PORT

DIFF_CAN | CAN0_CONN_P

BLM18AG221SN1D | SPARE_OUT2_AC_CONN | | | | | DIFF_CAN

CAN0_CONN_N | FB111

BLM18EG121S

CAN_WAKE???? | | DISPLAY_A_CONN

LIDO-HW.100.RearConnector.SchDoc

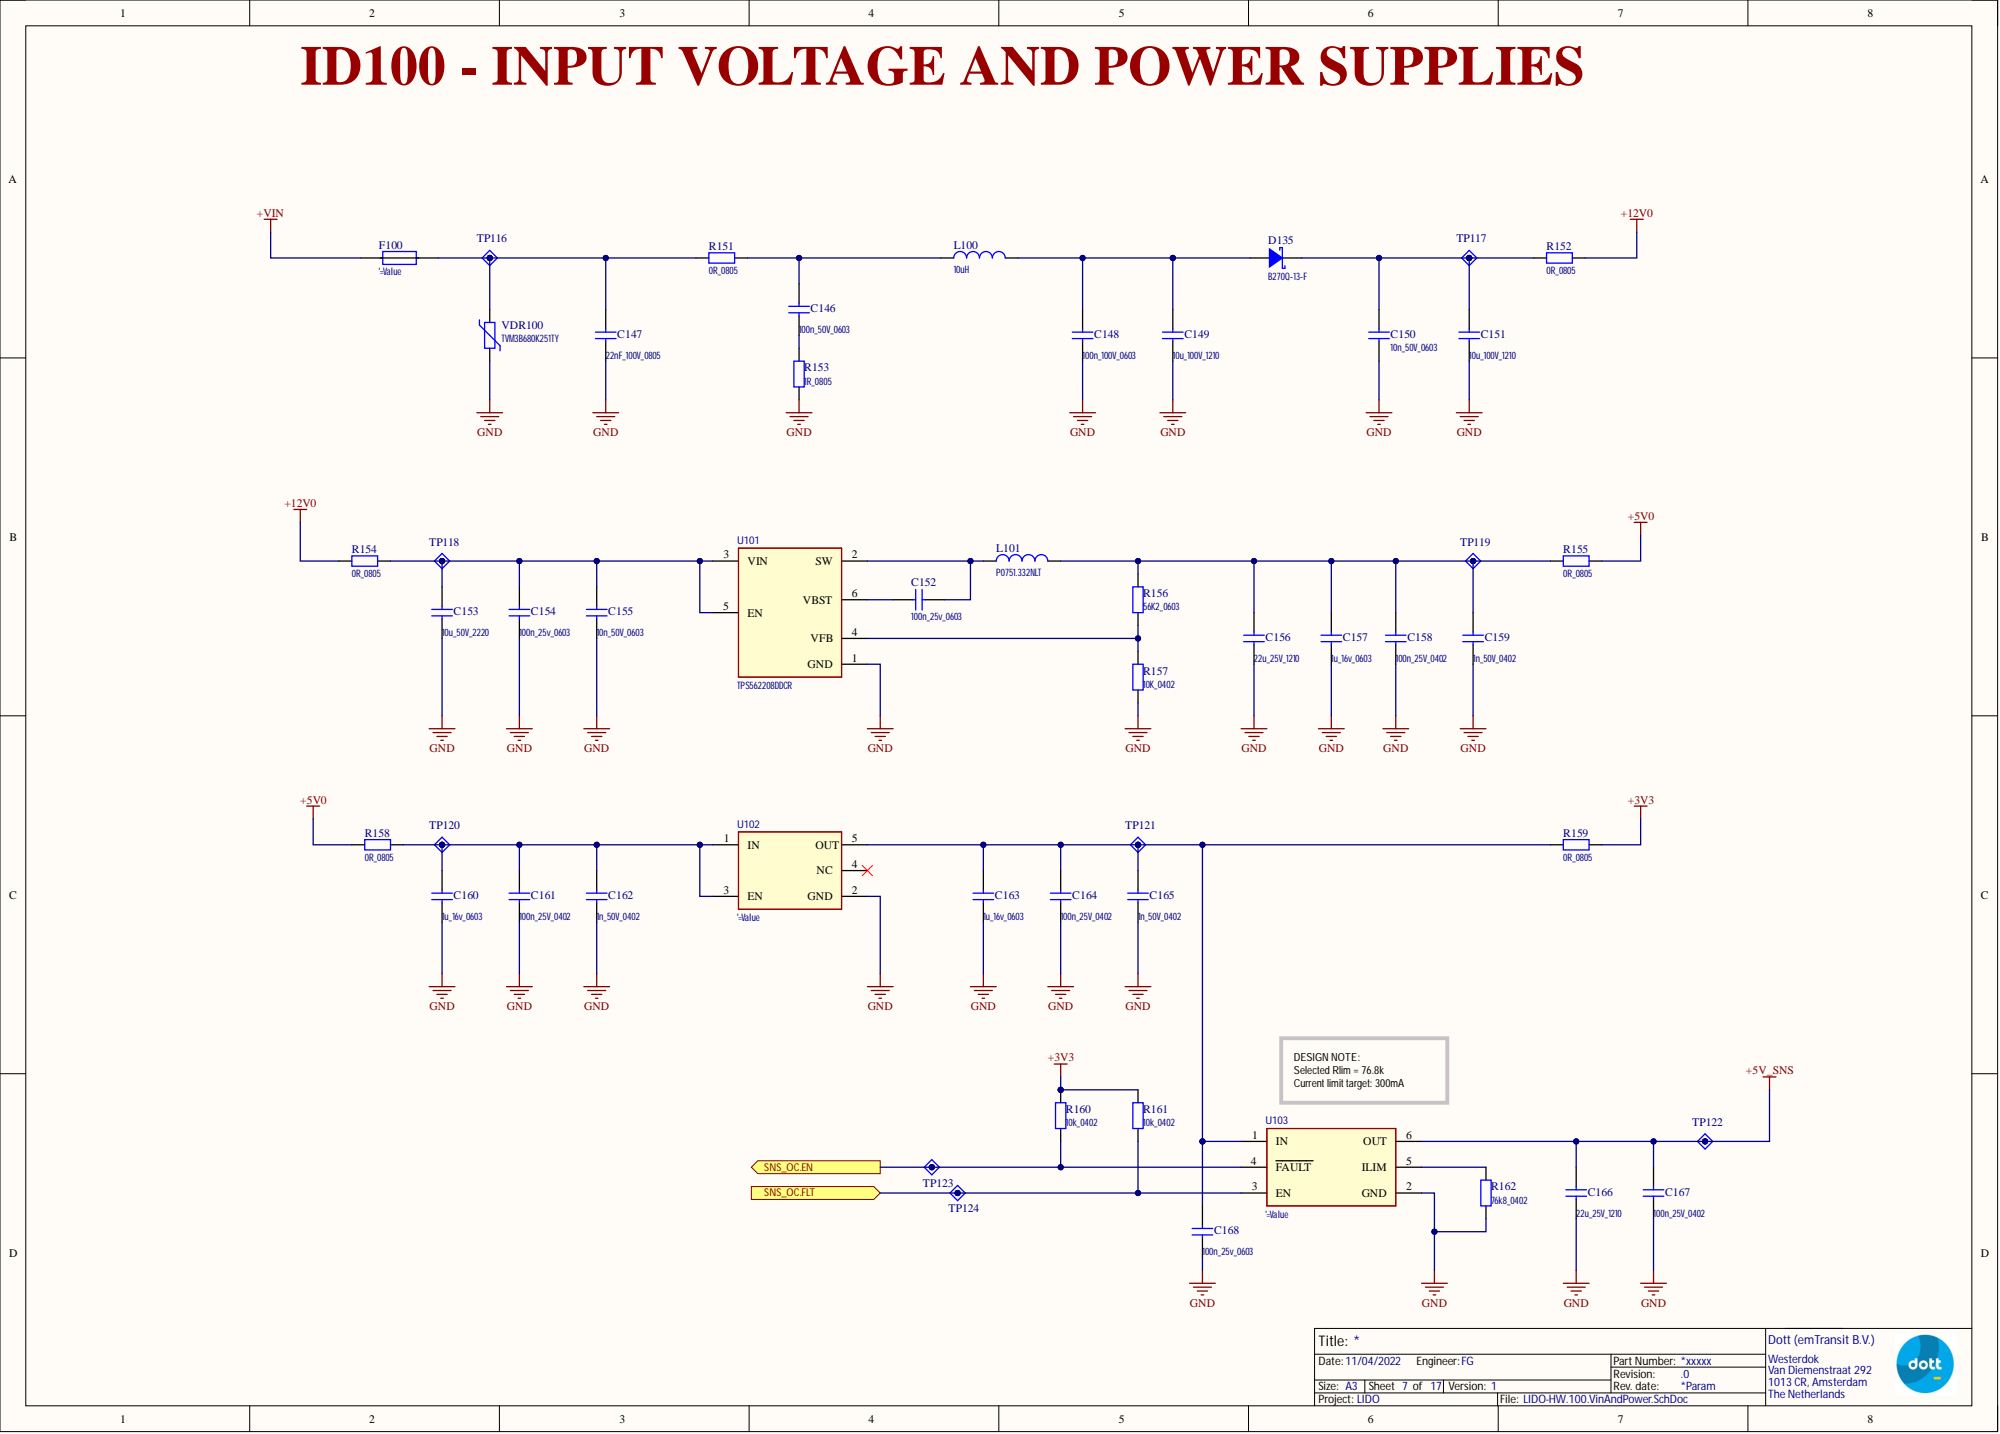
[picture p64: page 7]

ID100 - INPUT VOLTAGE AND POWER SUPPLIES

LIDO-HW.100.VinAndPower.SchDoc

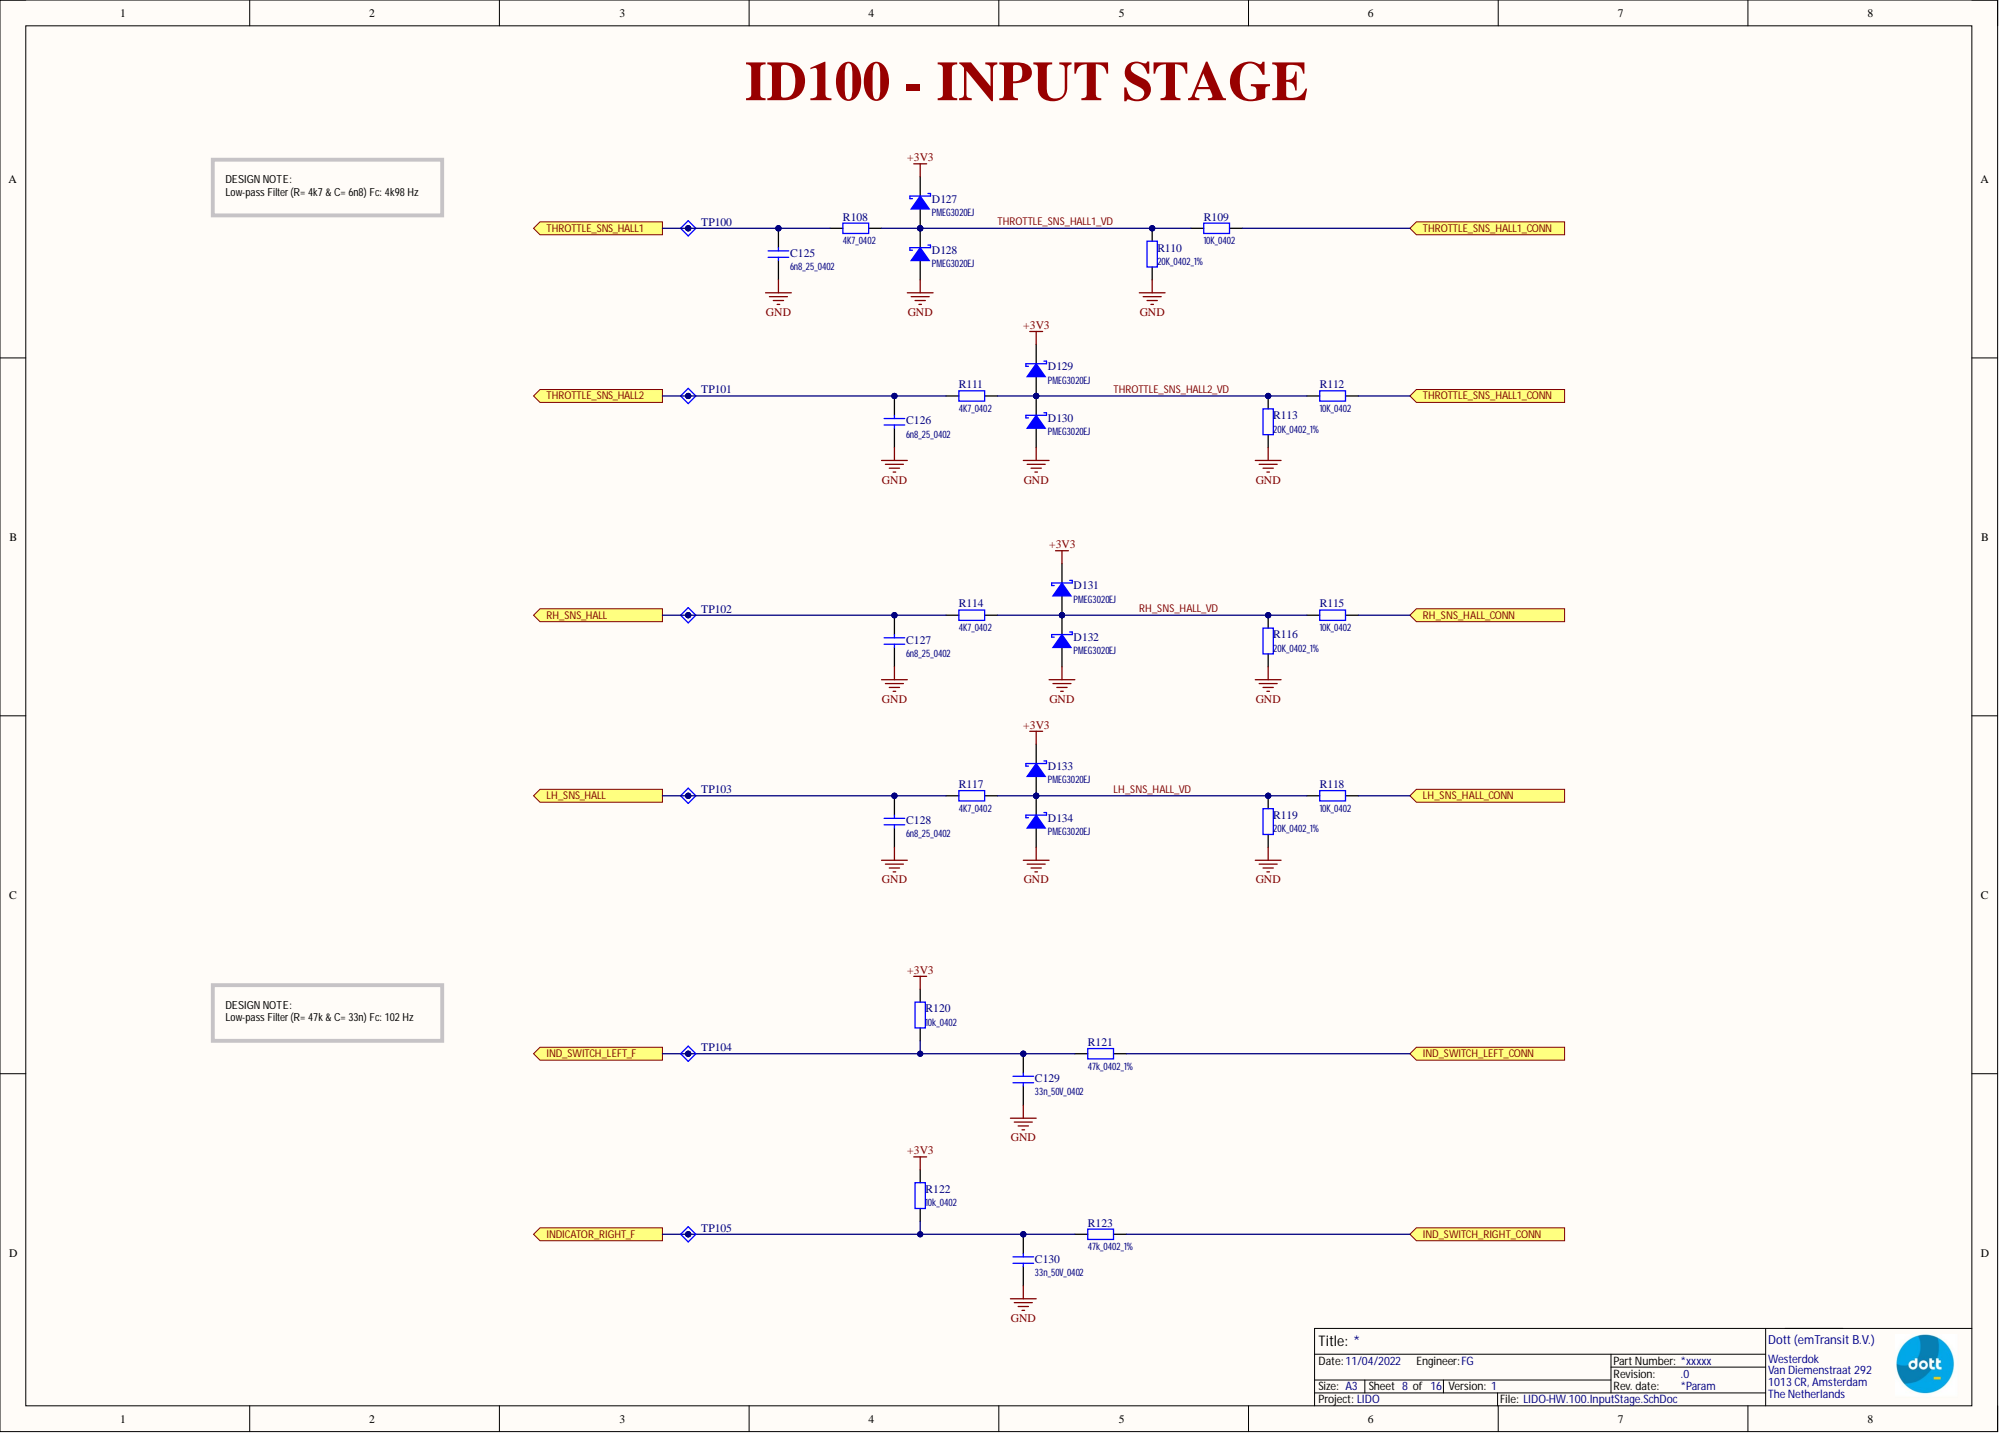
[picture p65: page 8]

DESIGN NOTE:
Low-pass Filter (R= 4k7 & C= 6n8) Fc: 4k98 Hz

Low-pass Filter (R= 47k & C= 33n) Fc: 102 Hz

LIDO-HW.100.InputStage.SchDoc

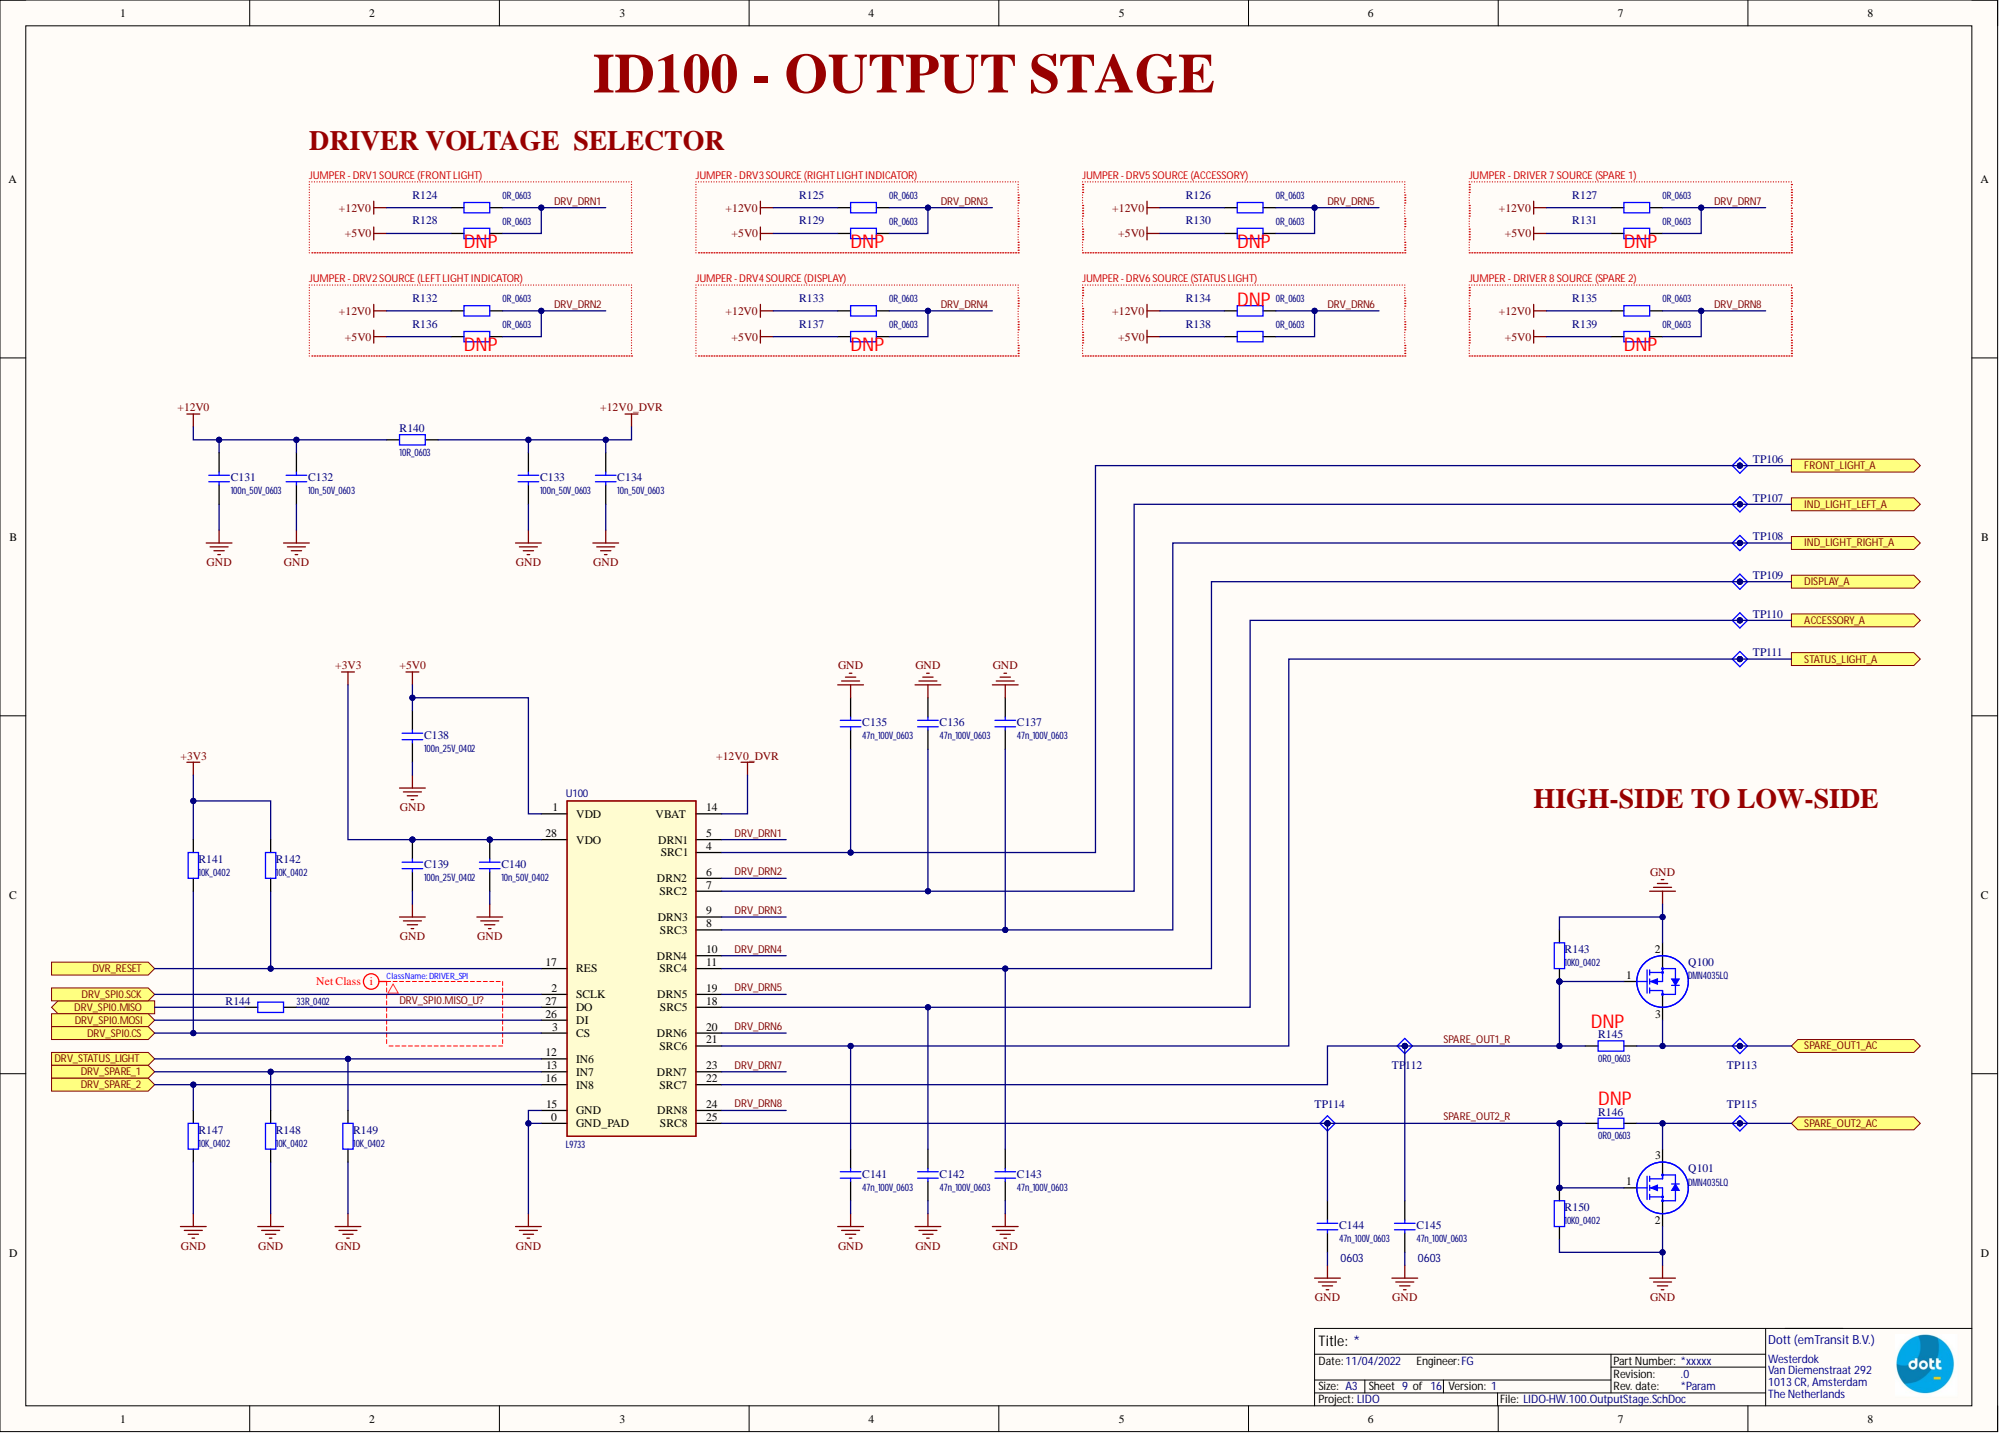
[picture p66: page 9]

JUMPER - DRV1 SOURCE (FRONT LIGHT)

JUMPER - DRV3 SOURCE (RIGHT LIGHT INDICATOR)

JUMPER - DRIVER 7 SOURCE (SPARE 1)

JUMPER - DRV2 SOURCE (LEFT LIGHT INDICATOR)

JUMPER - DRV6 SOURCE (STATUS LIGHT)

JUMPER - DRIVER 8 SOURCE (SPARE 2)

HIGH-SIDE TO LOW-SIDE

LIDO-HW.100.OutputStage.SchDoc

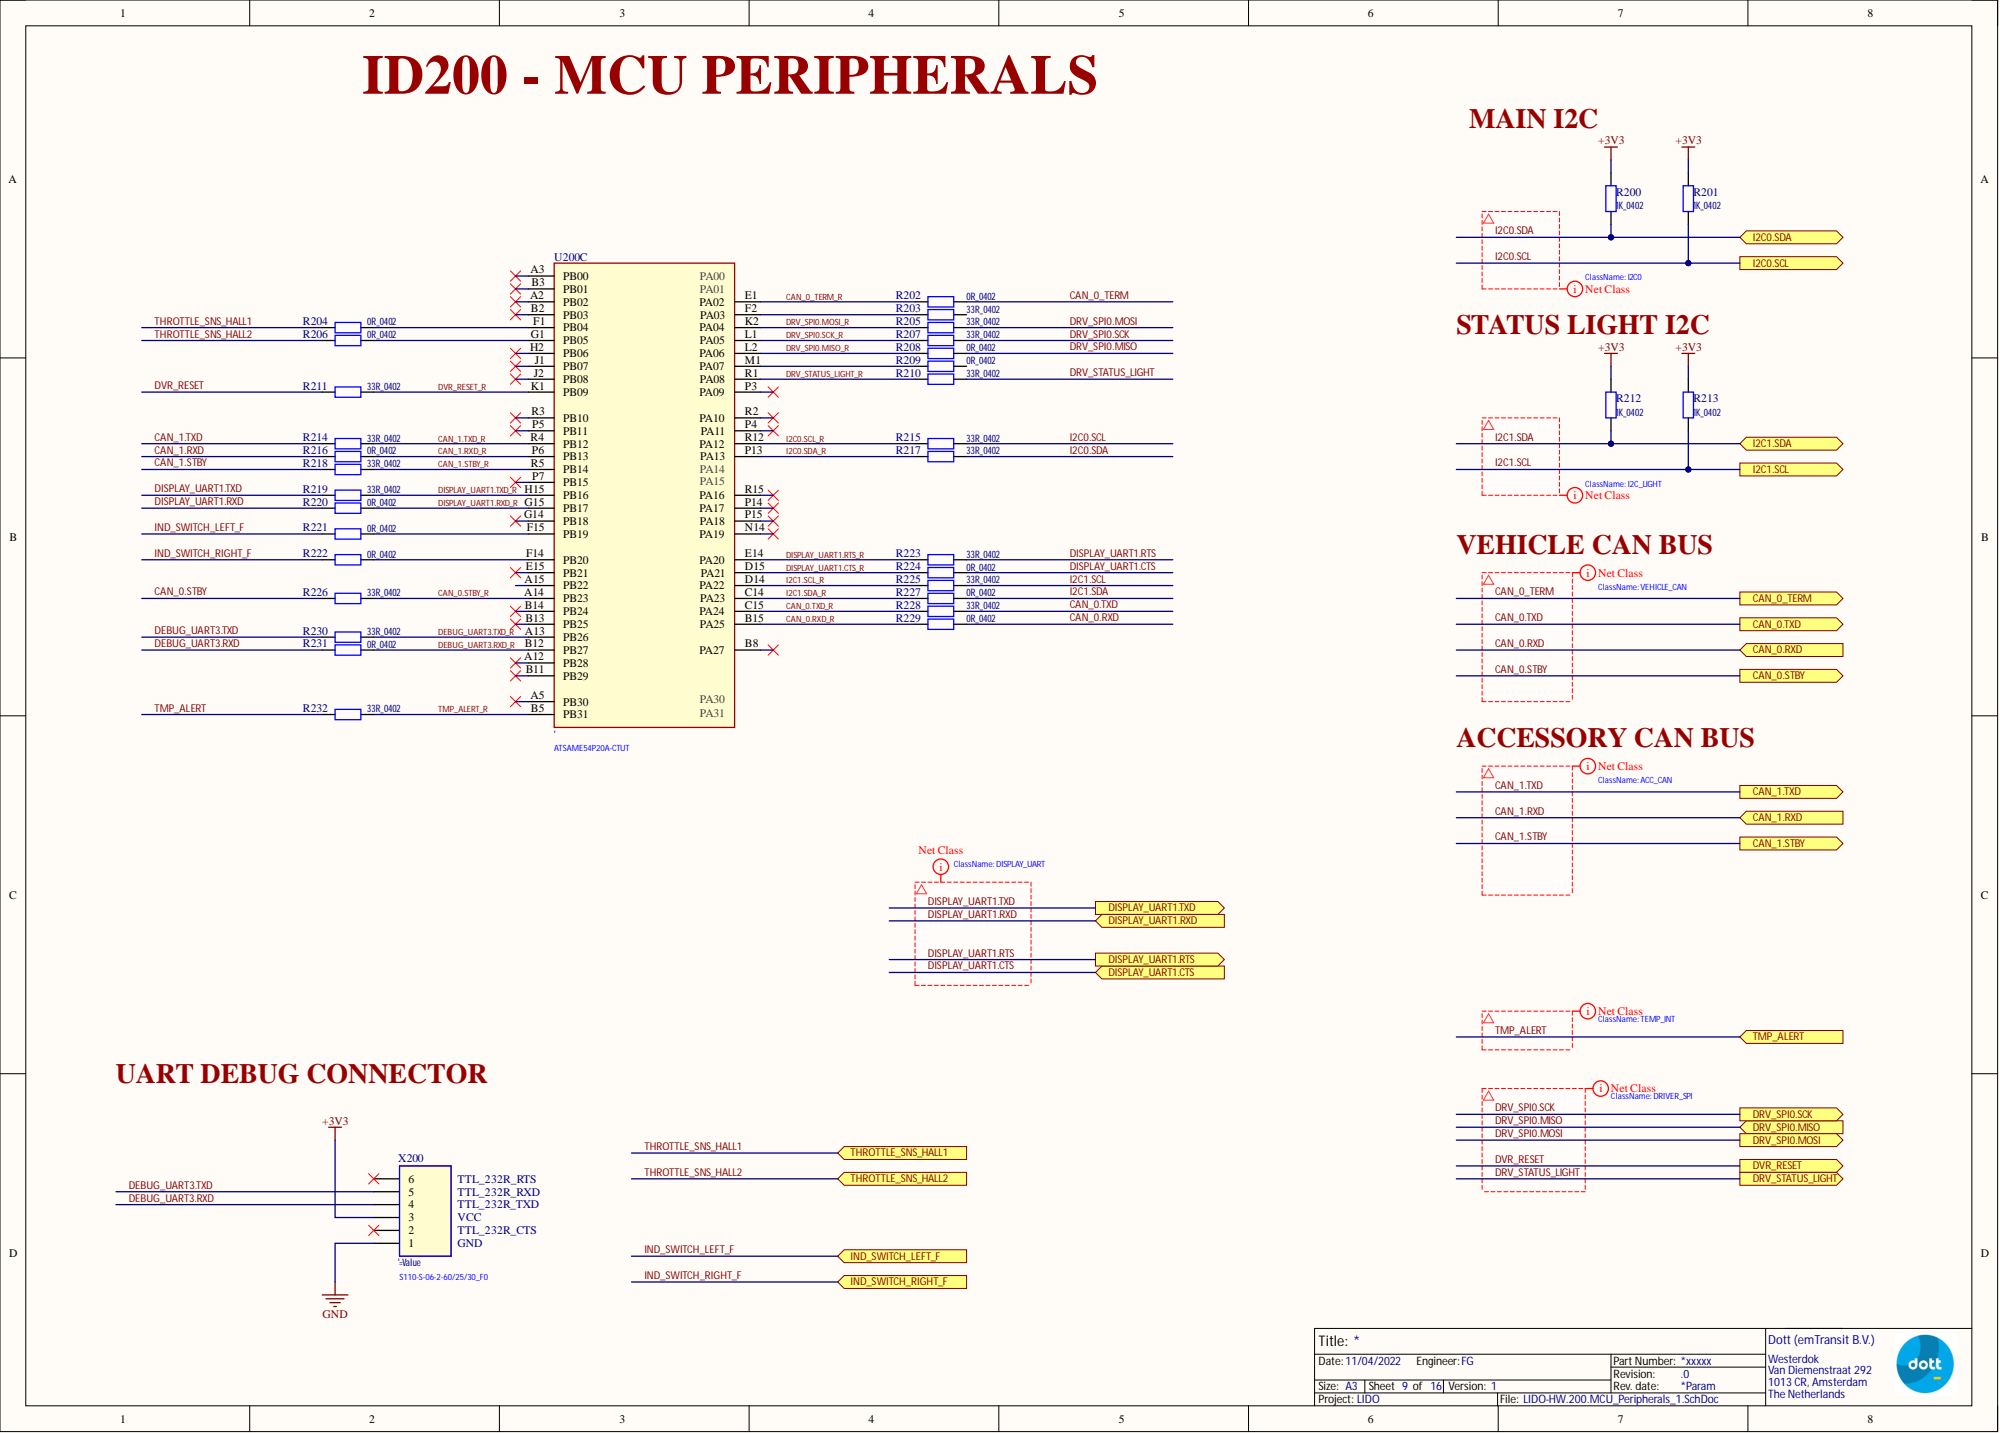
[picture p67: page 10]

PB05 G1 | DRV_SPI0.SCK_R
PB06 H2 PB07 J1 PB08 J2 PB09 K1 | DRV_SPI0.MISO_R

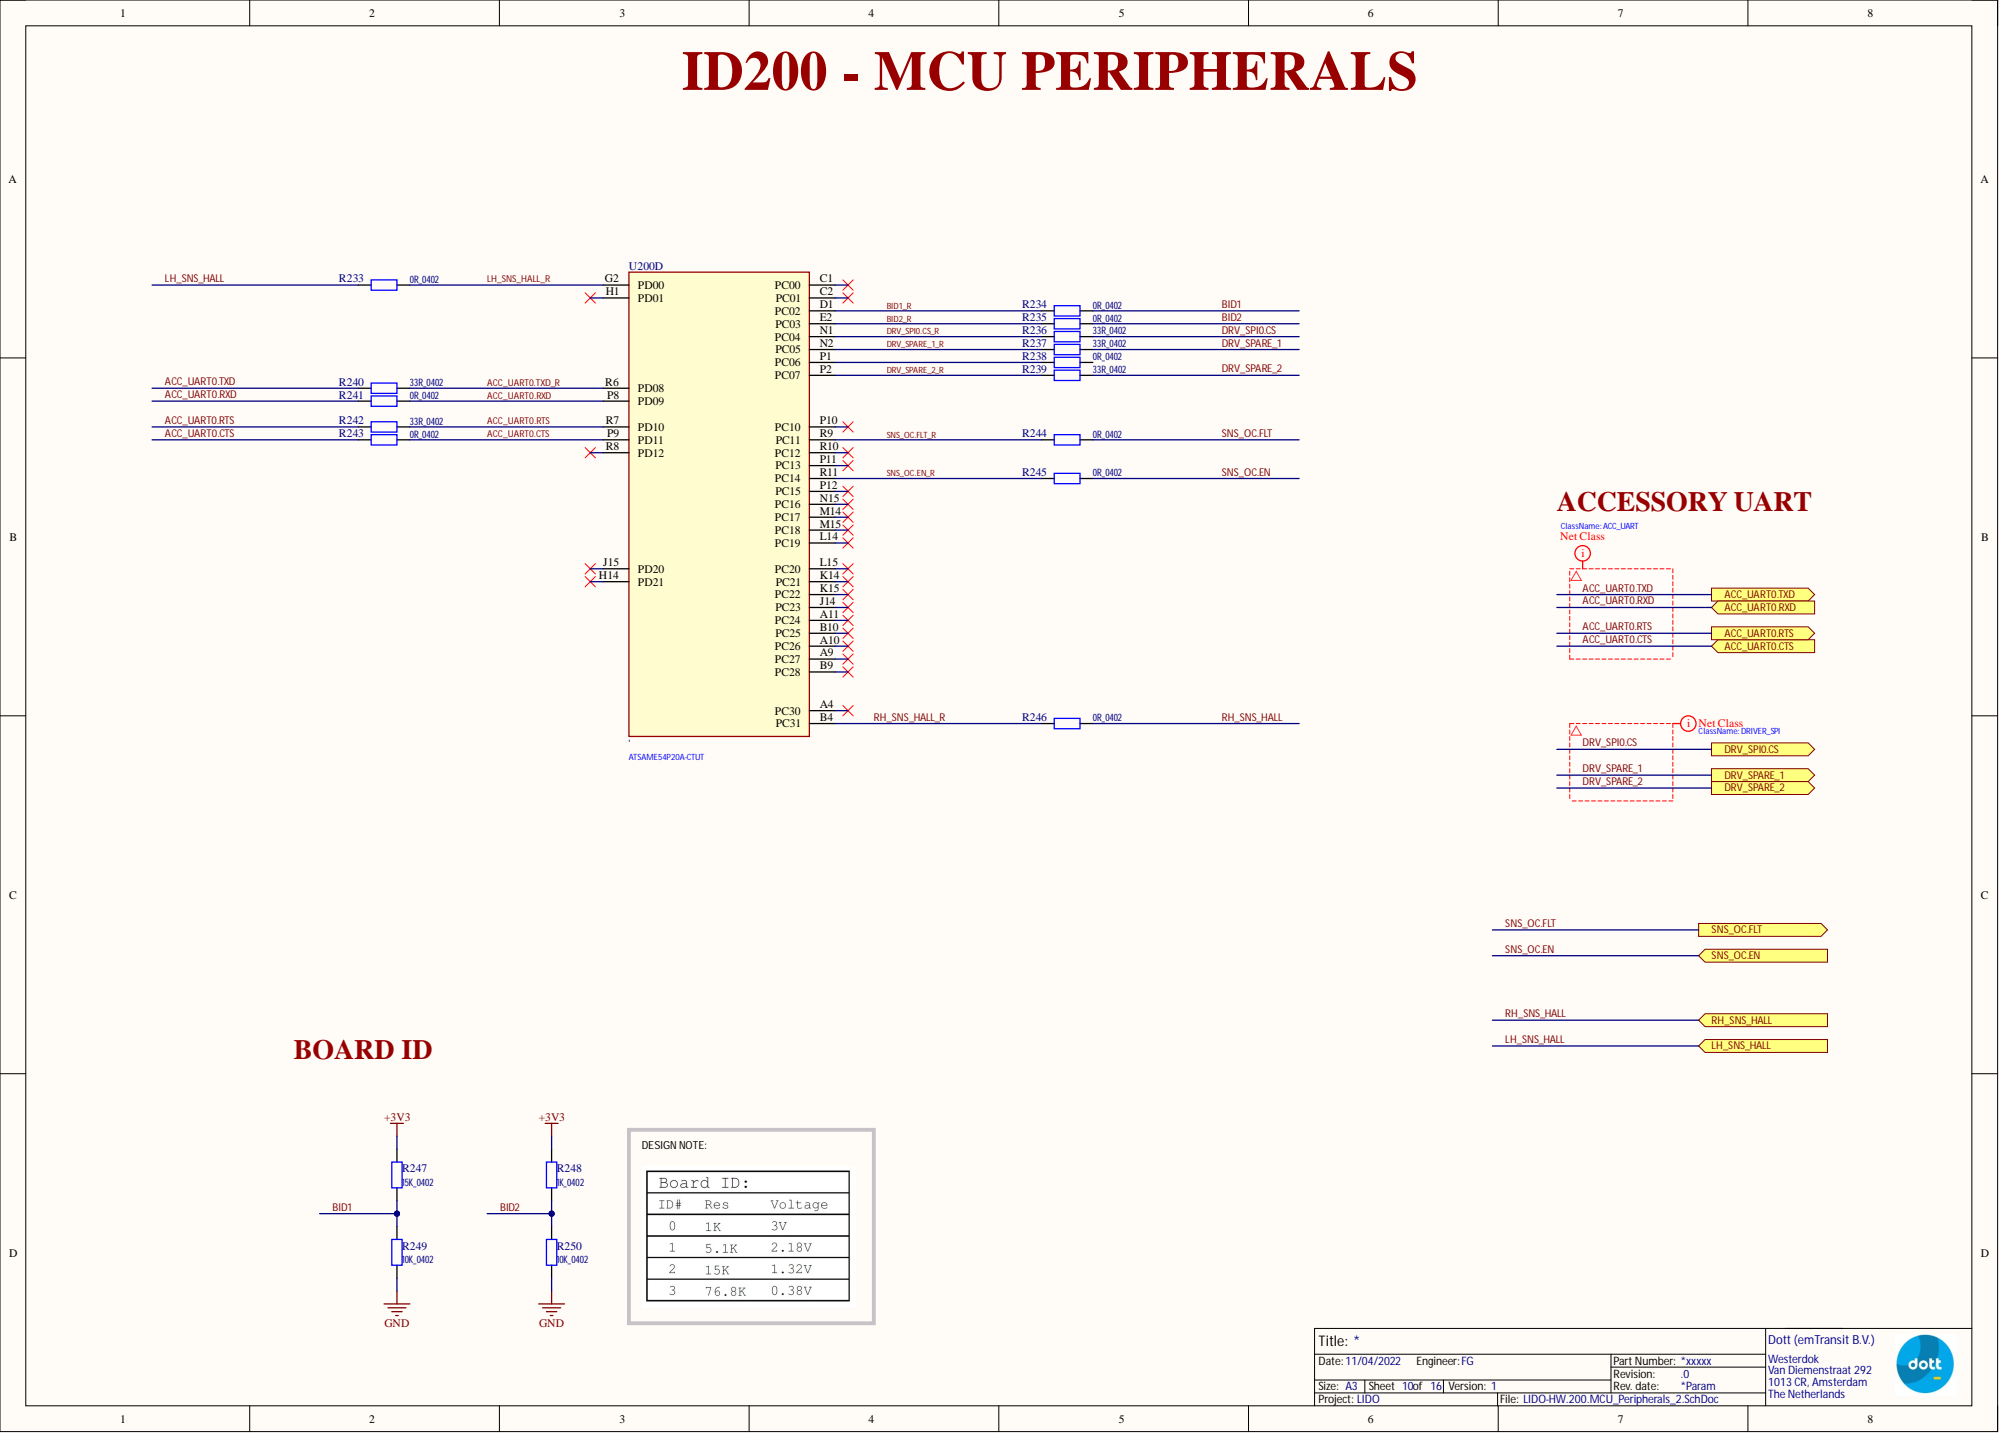
[picture p68: page 11]

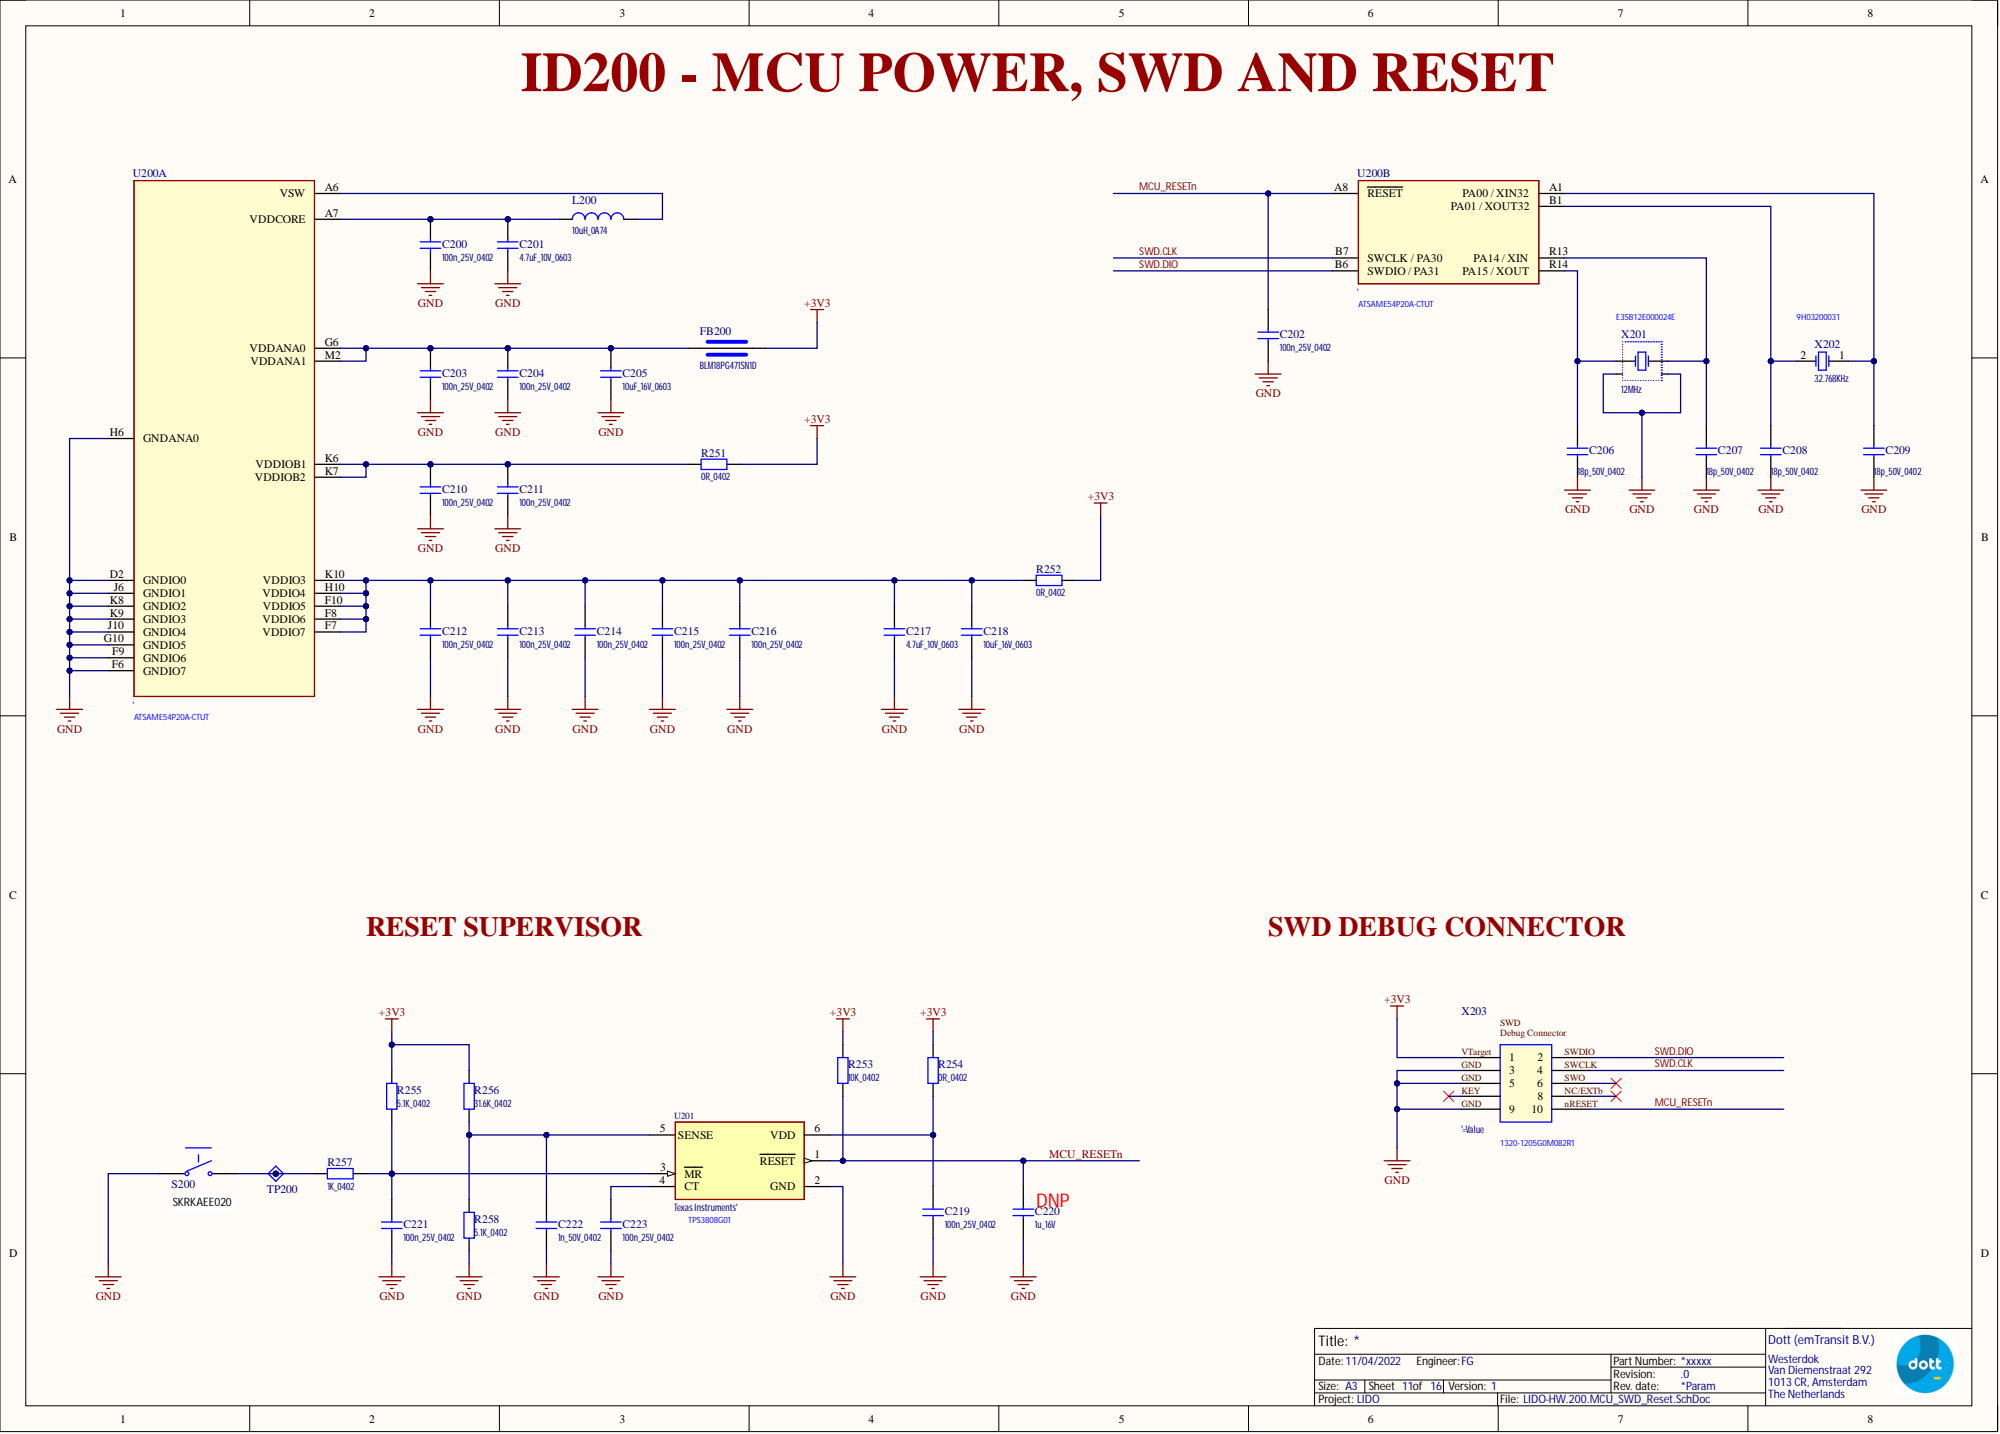
[picture p69: page 12]

ID200 - MCU POWER, SWD AND RESET

GND
KEY

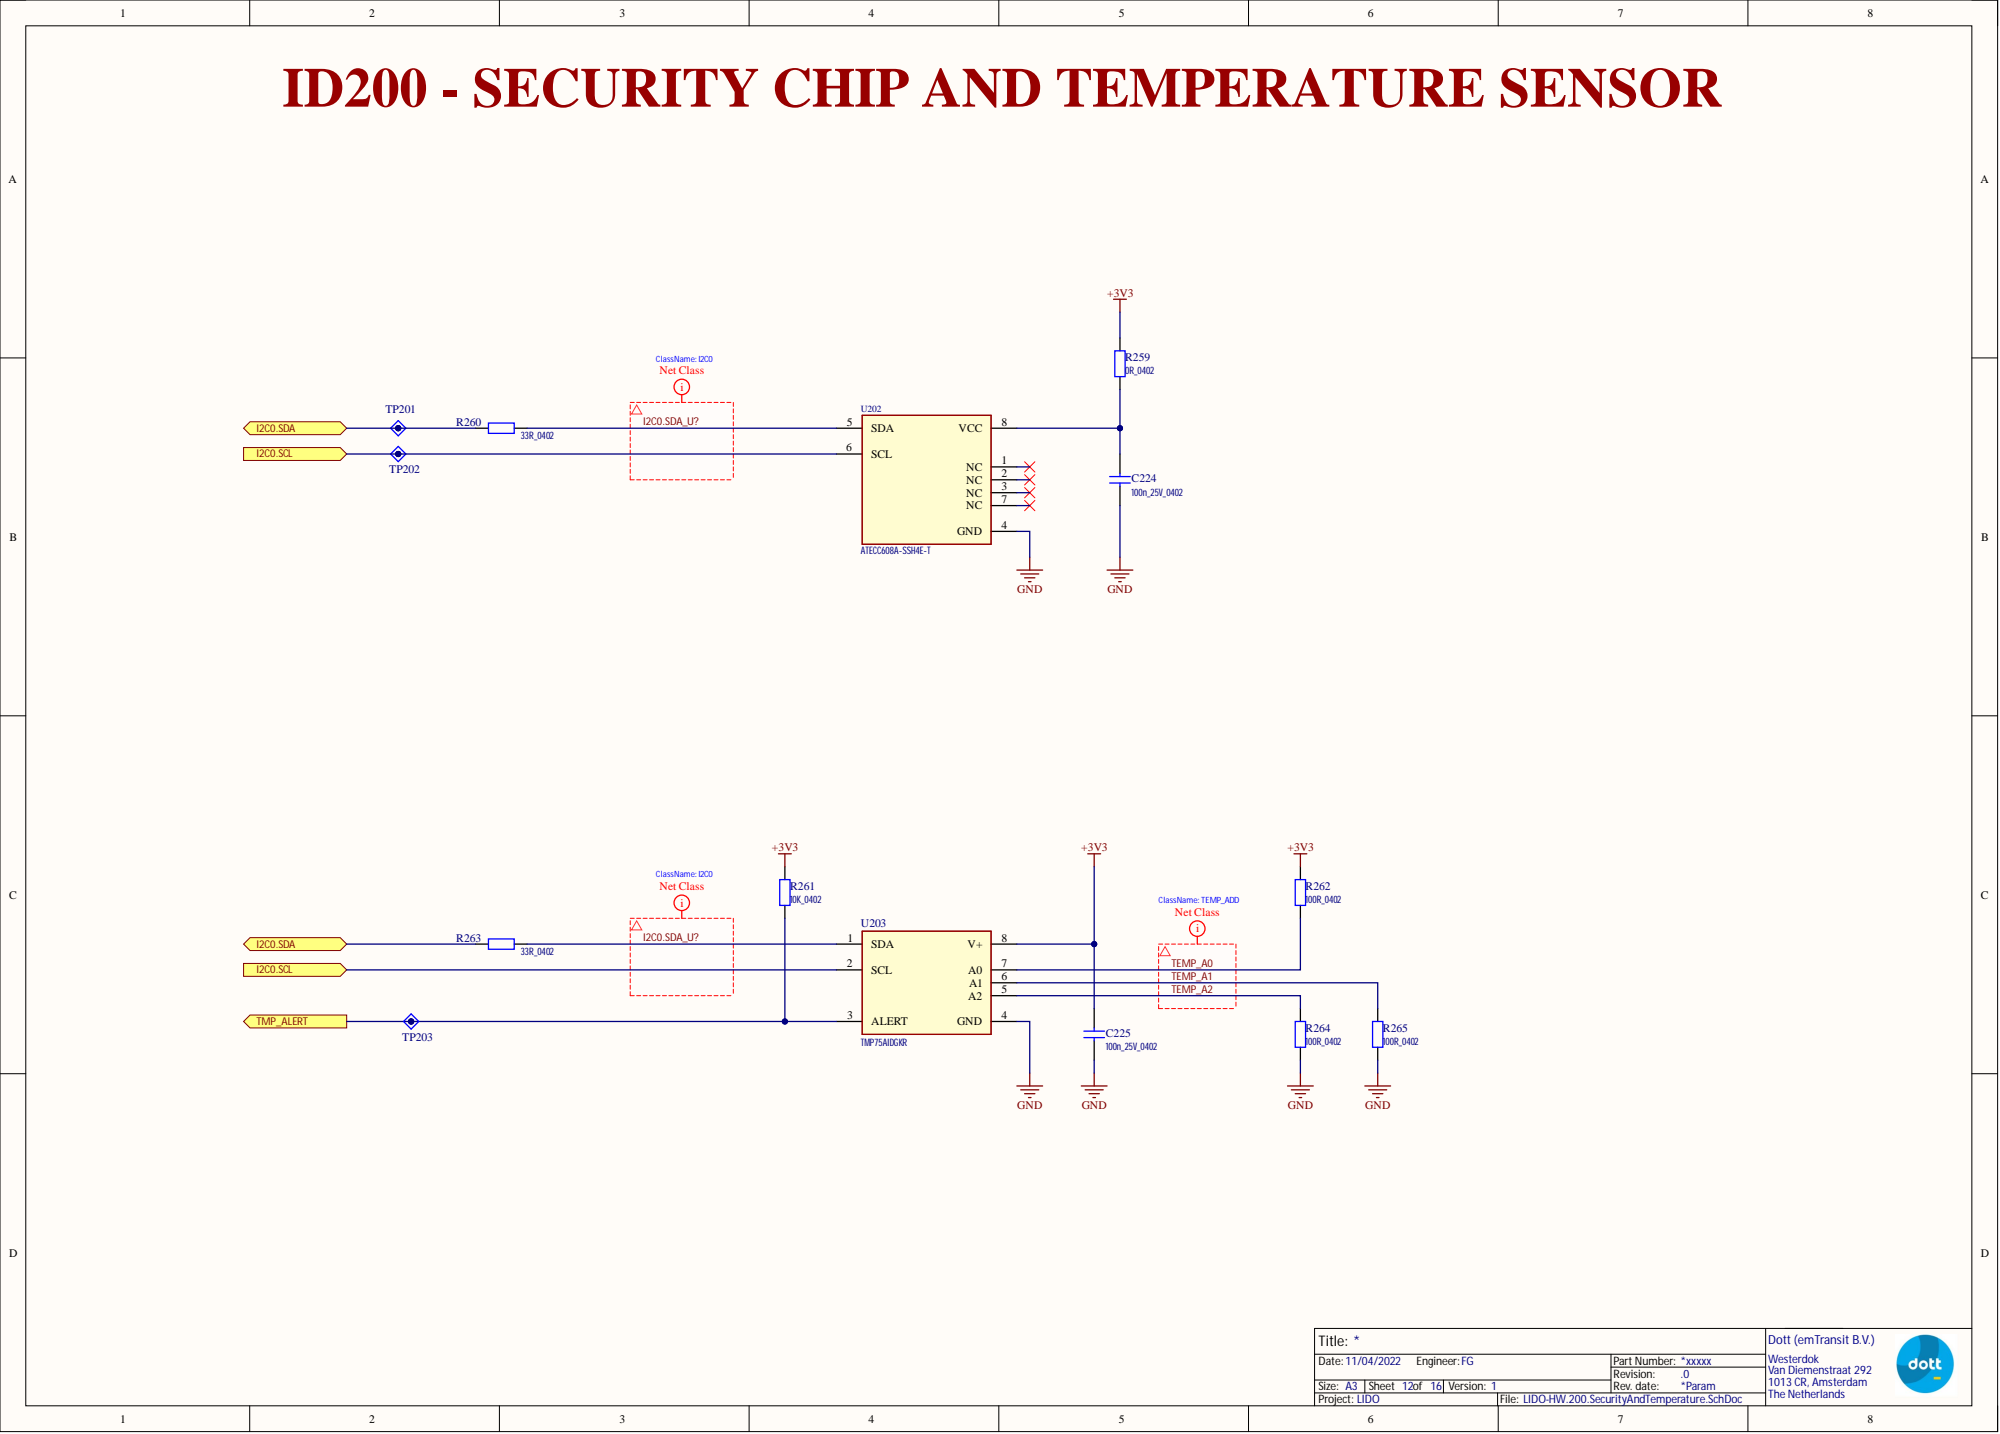
[picture p70: page 13]

ID200 - SECURITY CHIP AND TEMPERATURE SENSOR

LIDO-HW.200.SecurityAndTemperature.SchDoc

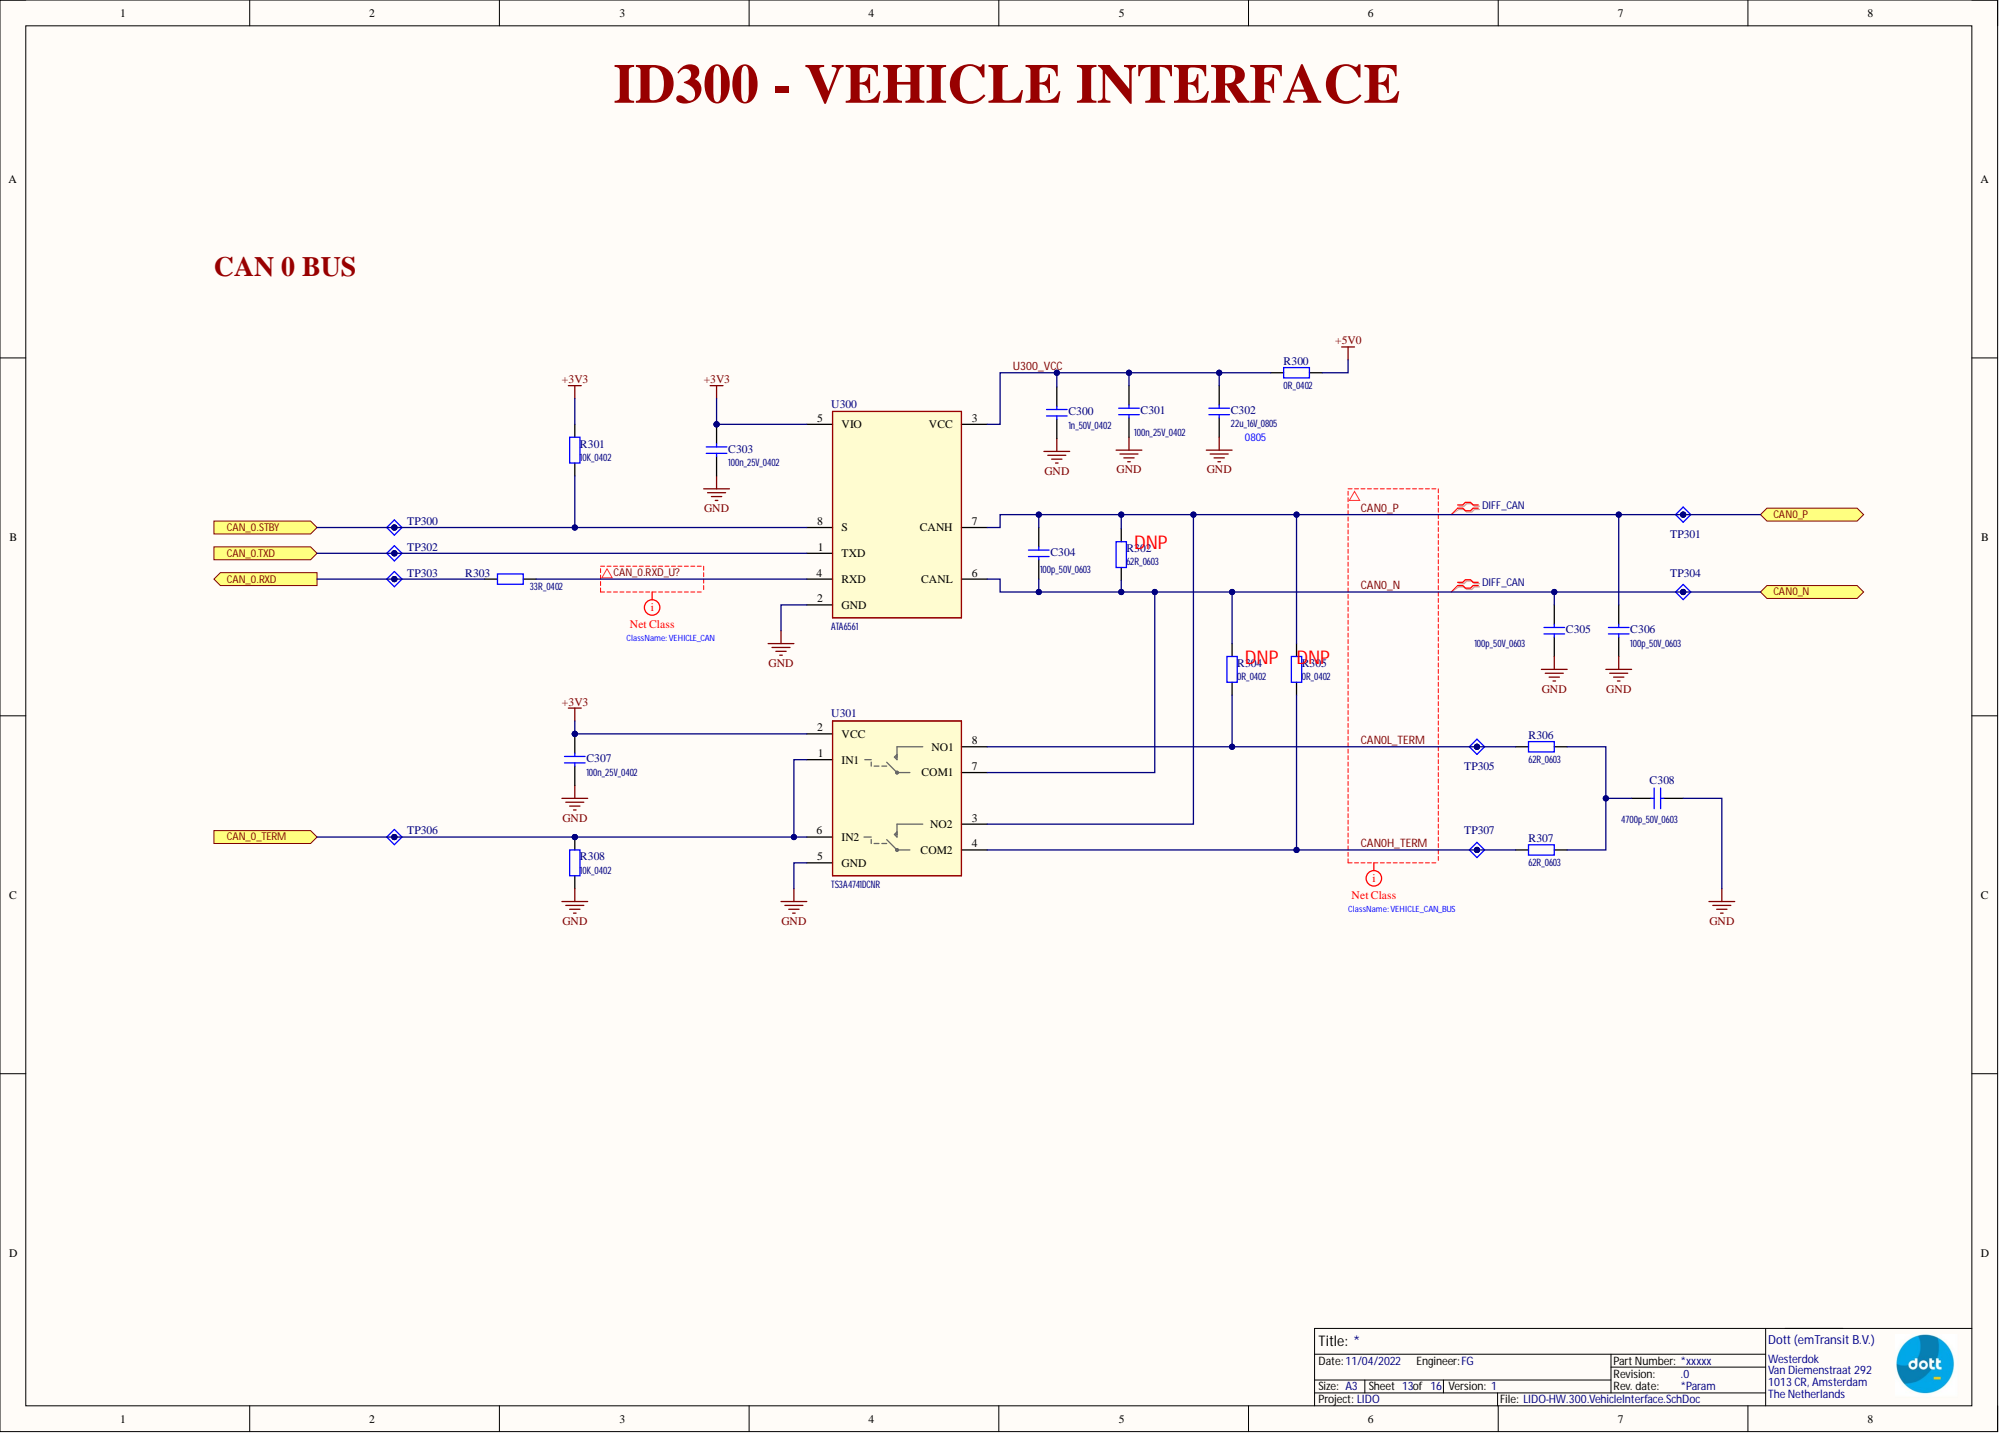
[picture p71: page 14]

CA N 0L_TER M

7 | CA N 0H_TER M | TP3 0 5 TP3 0 7

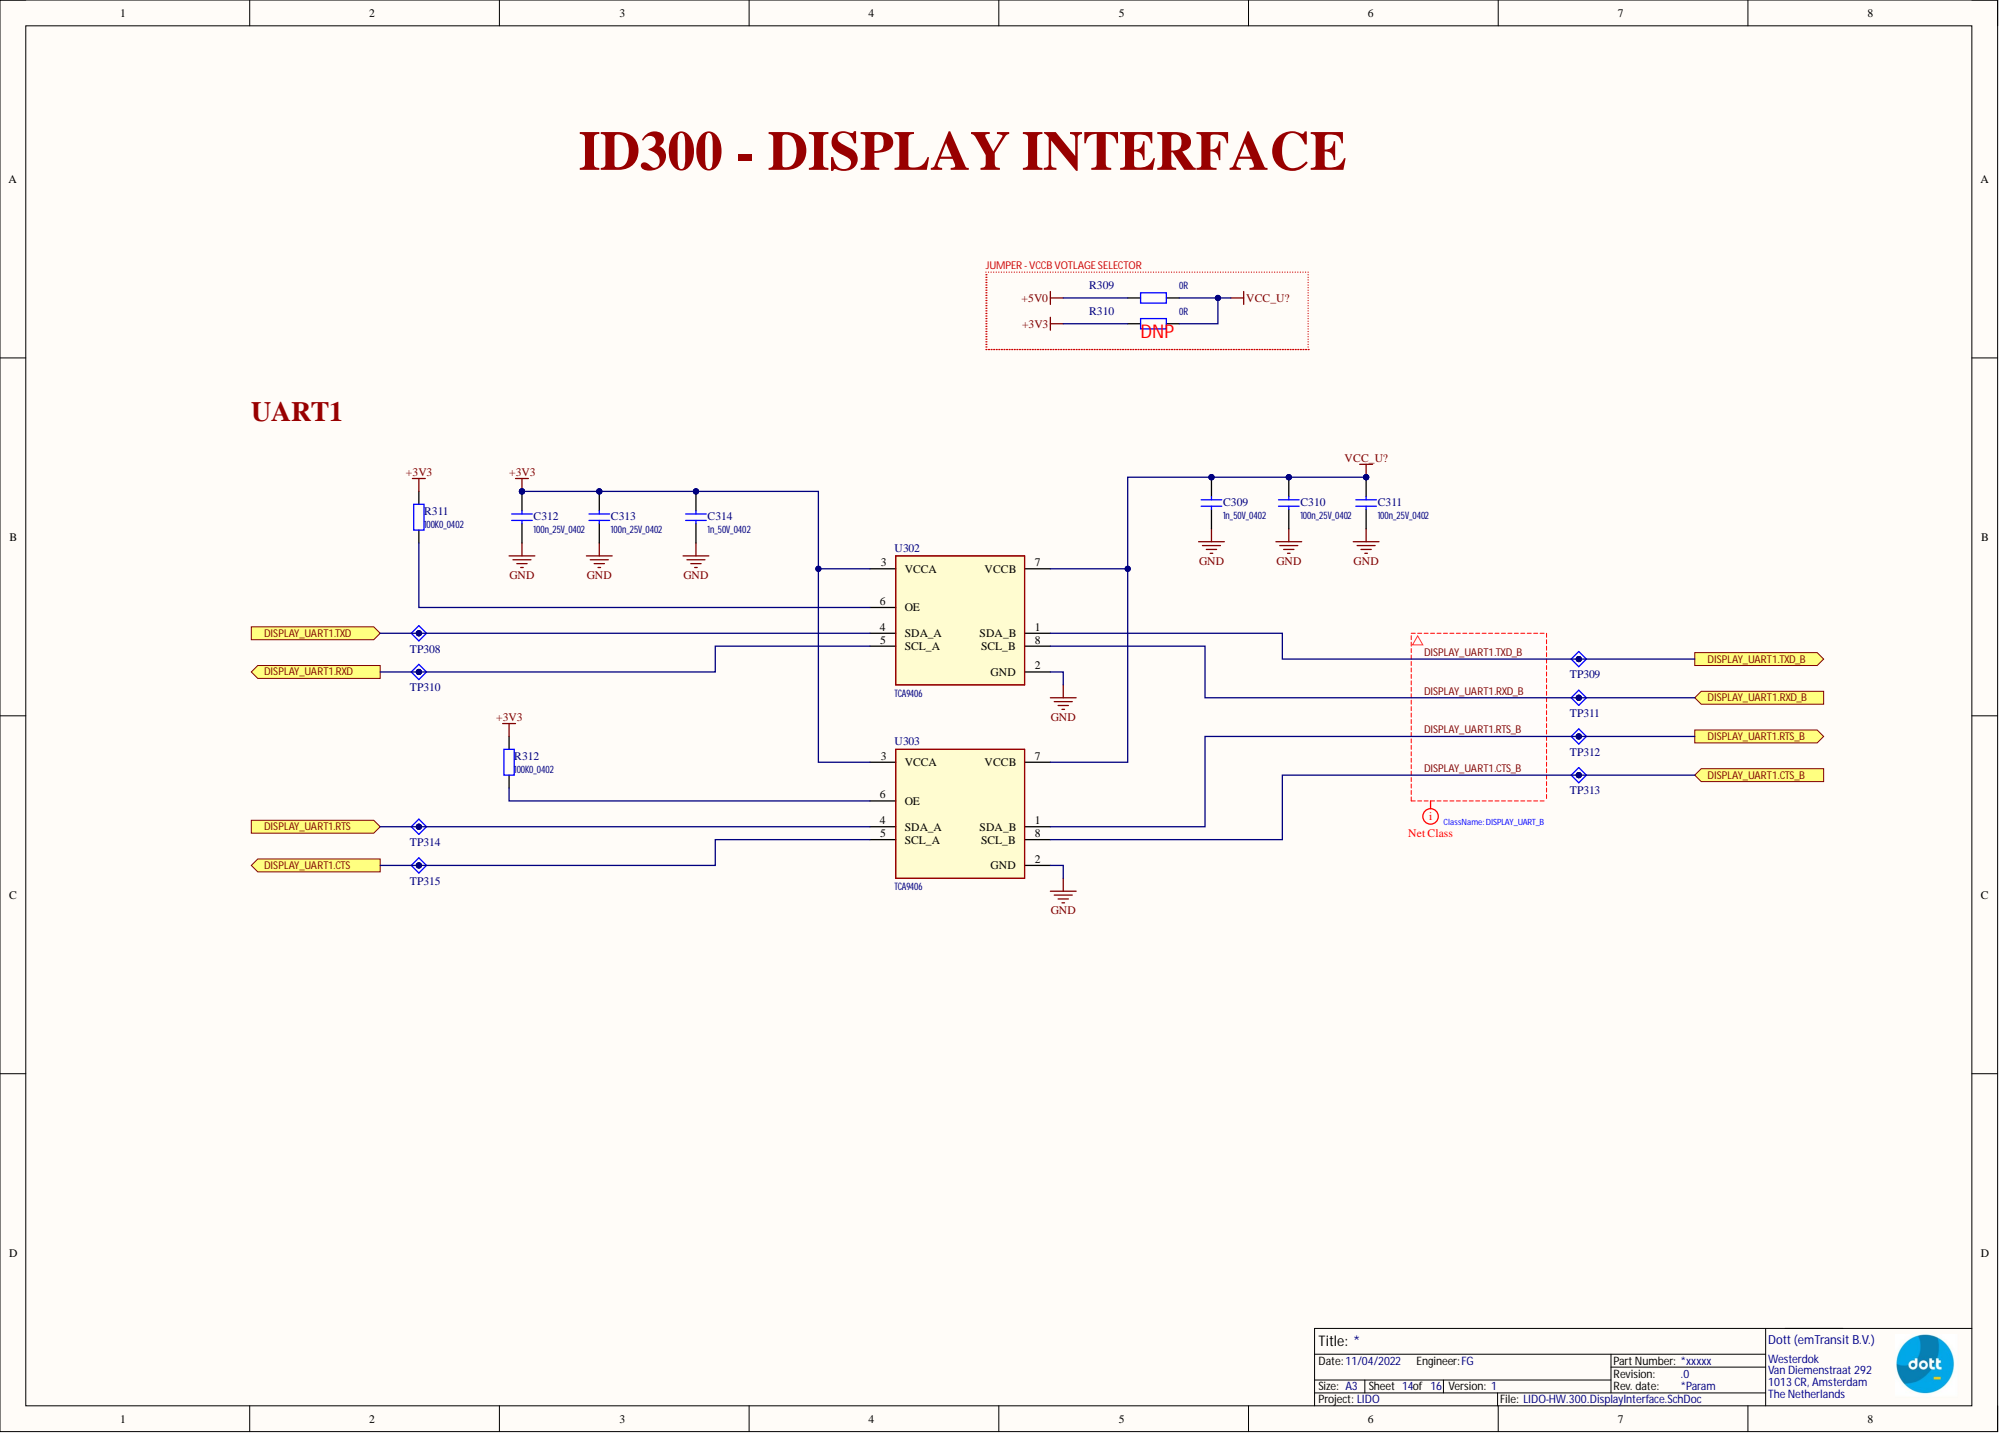
[picture p72: page 15]

JUMPER - VCCB VOTLAGE SELECTOR

SDA_A 4

TP308 | | | | DISPLAY_UART1.TXD_B

DISPLAY_UART1.RXD_B | TP309

GND | | DISPLAY_UART1.RTS_B

DISPLAY_UART1.CTS_B | TP312

SCL_A 5 | Net Class

LIDO-HW.300.DisplayInterface.SchDoc

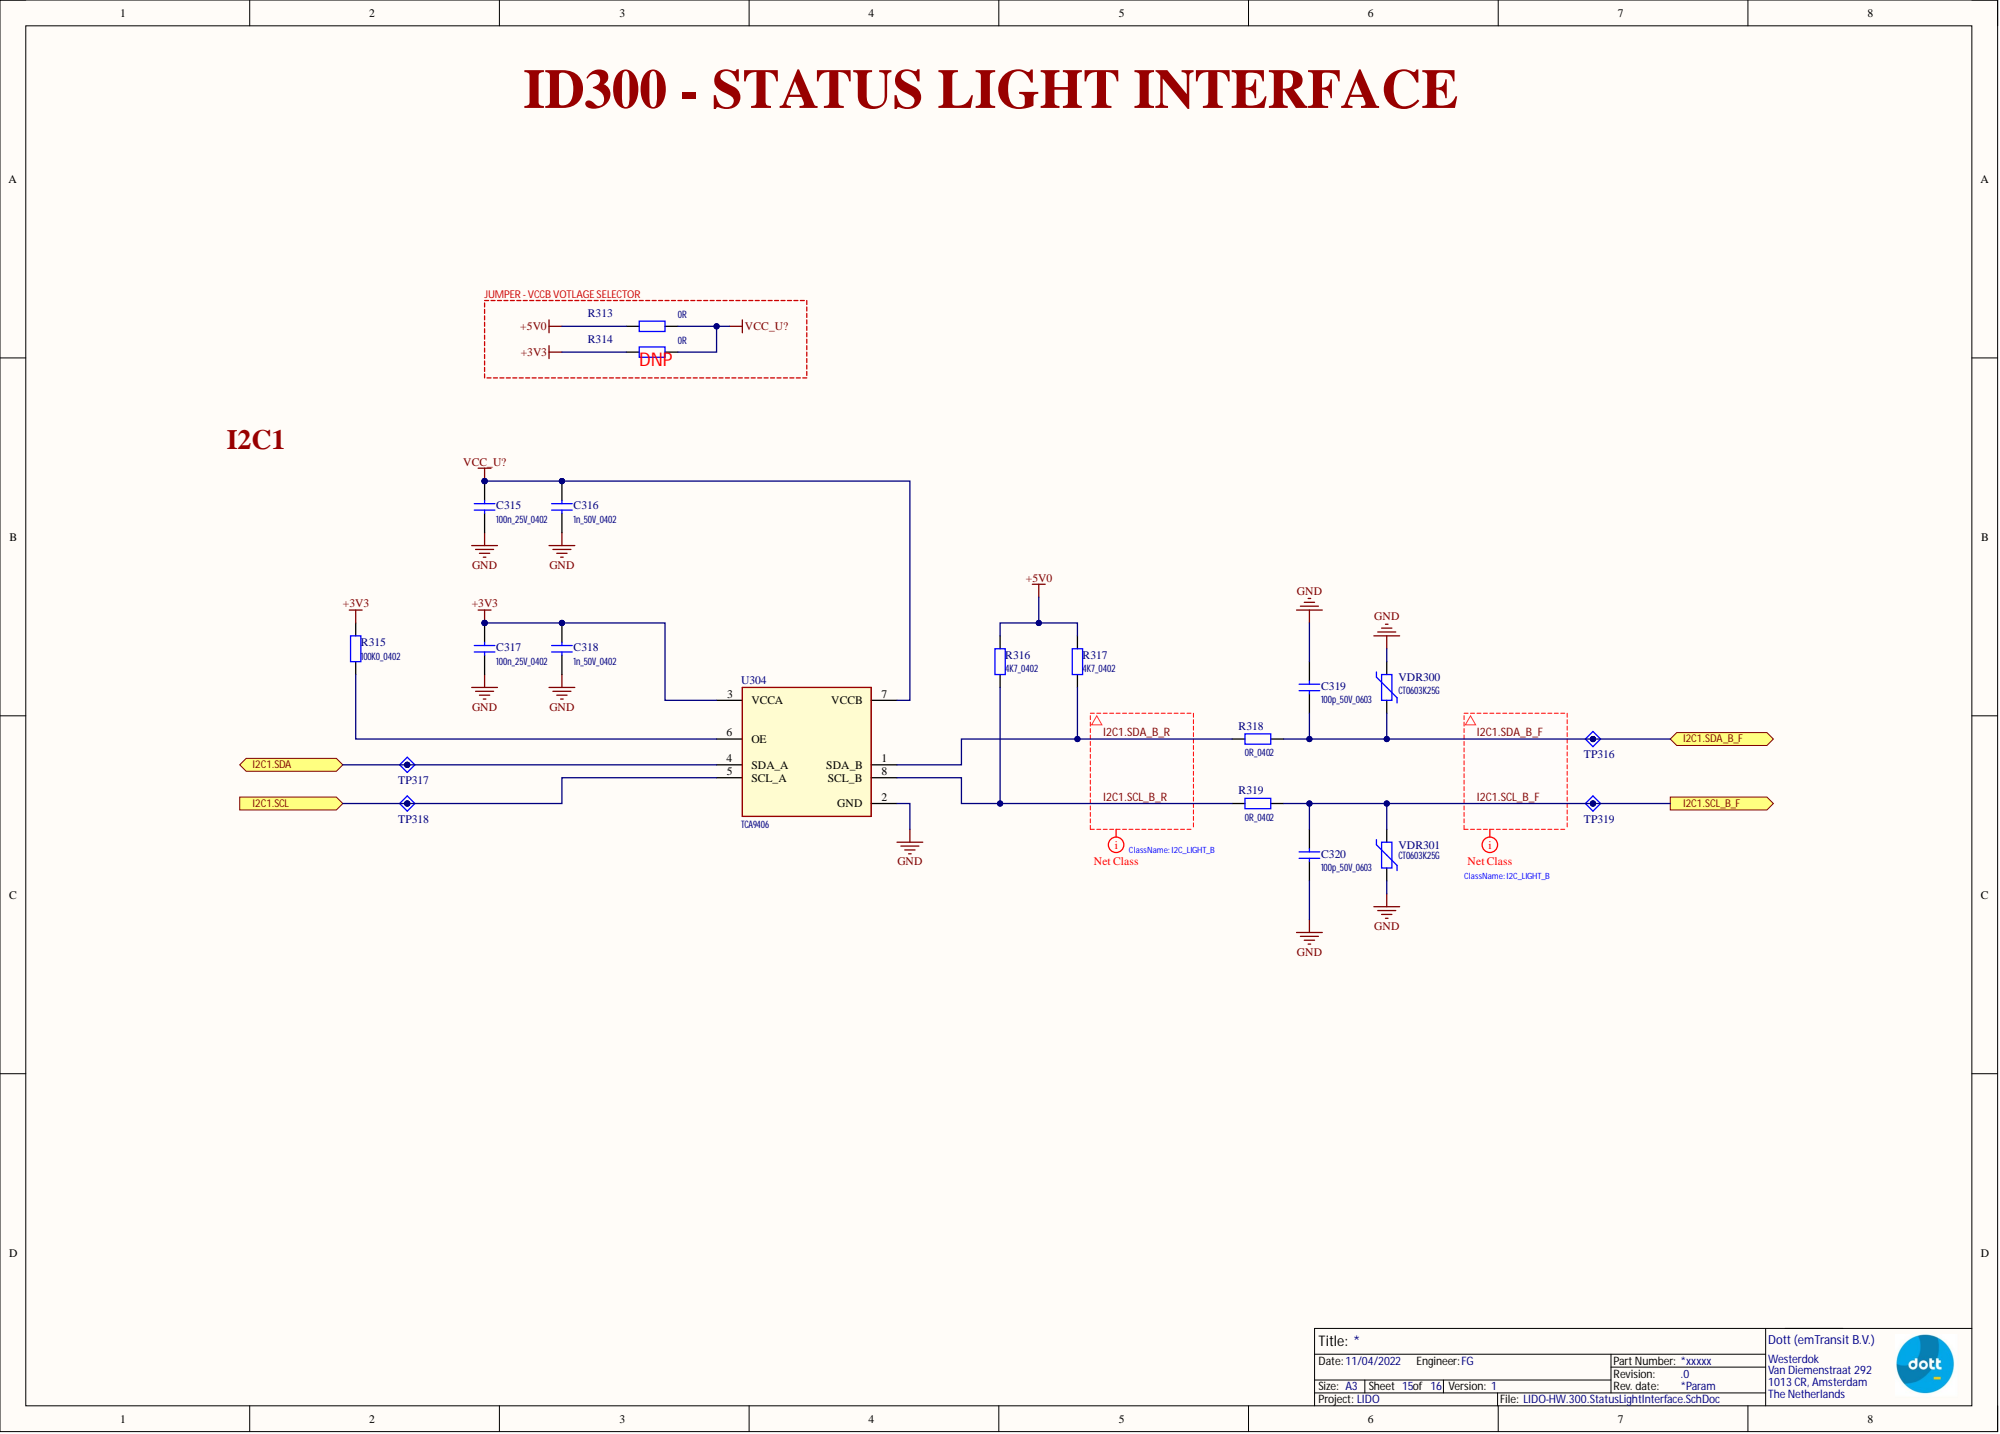
[picture p73: page 16]

JUMPER - VCCB VOTLAGE SELECTOR

LIDO-HW.300.StatusLightInterface.SchDoc

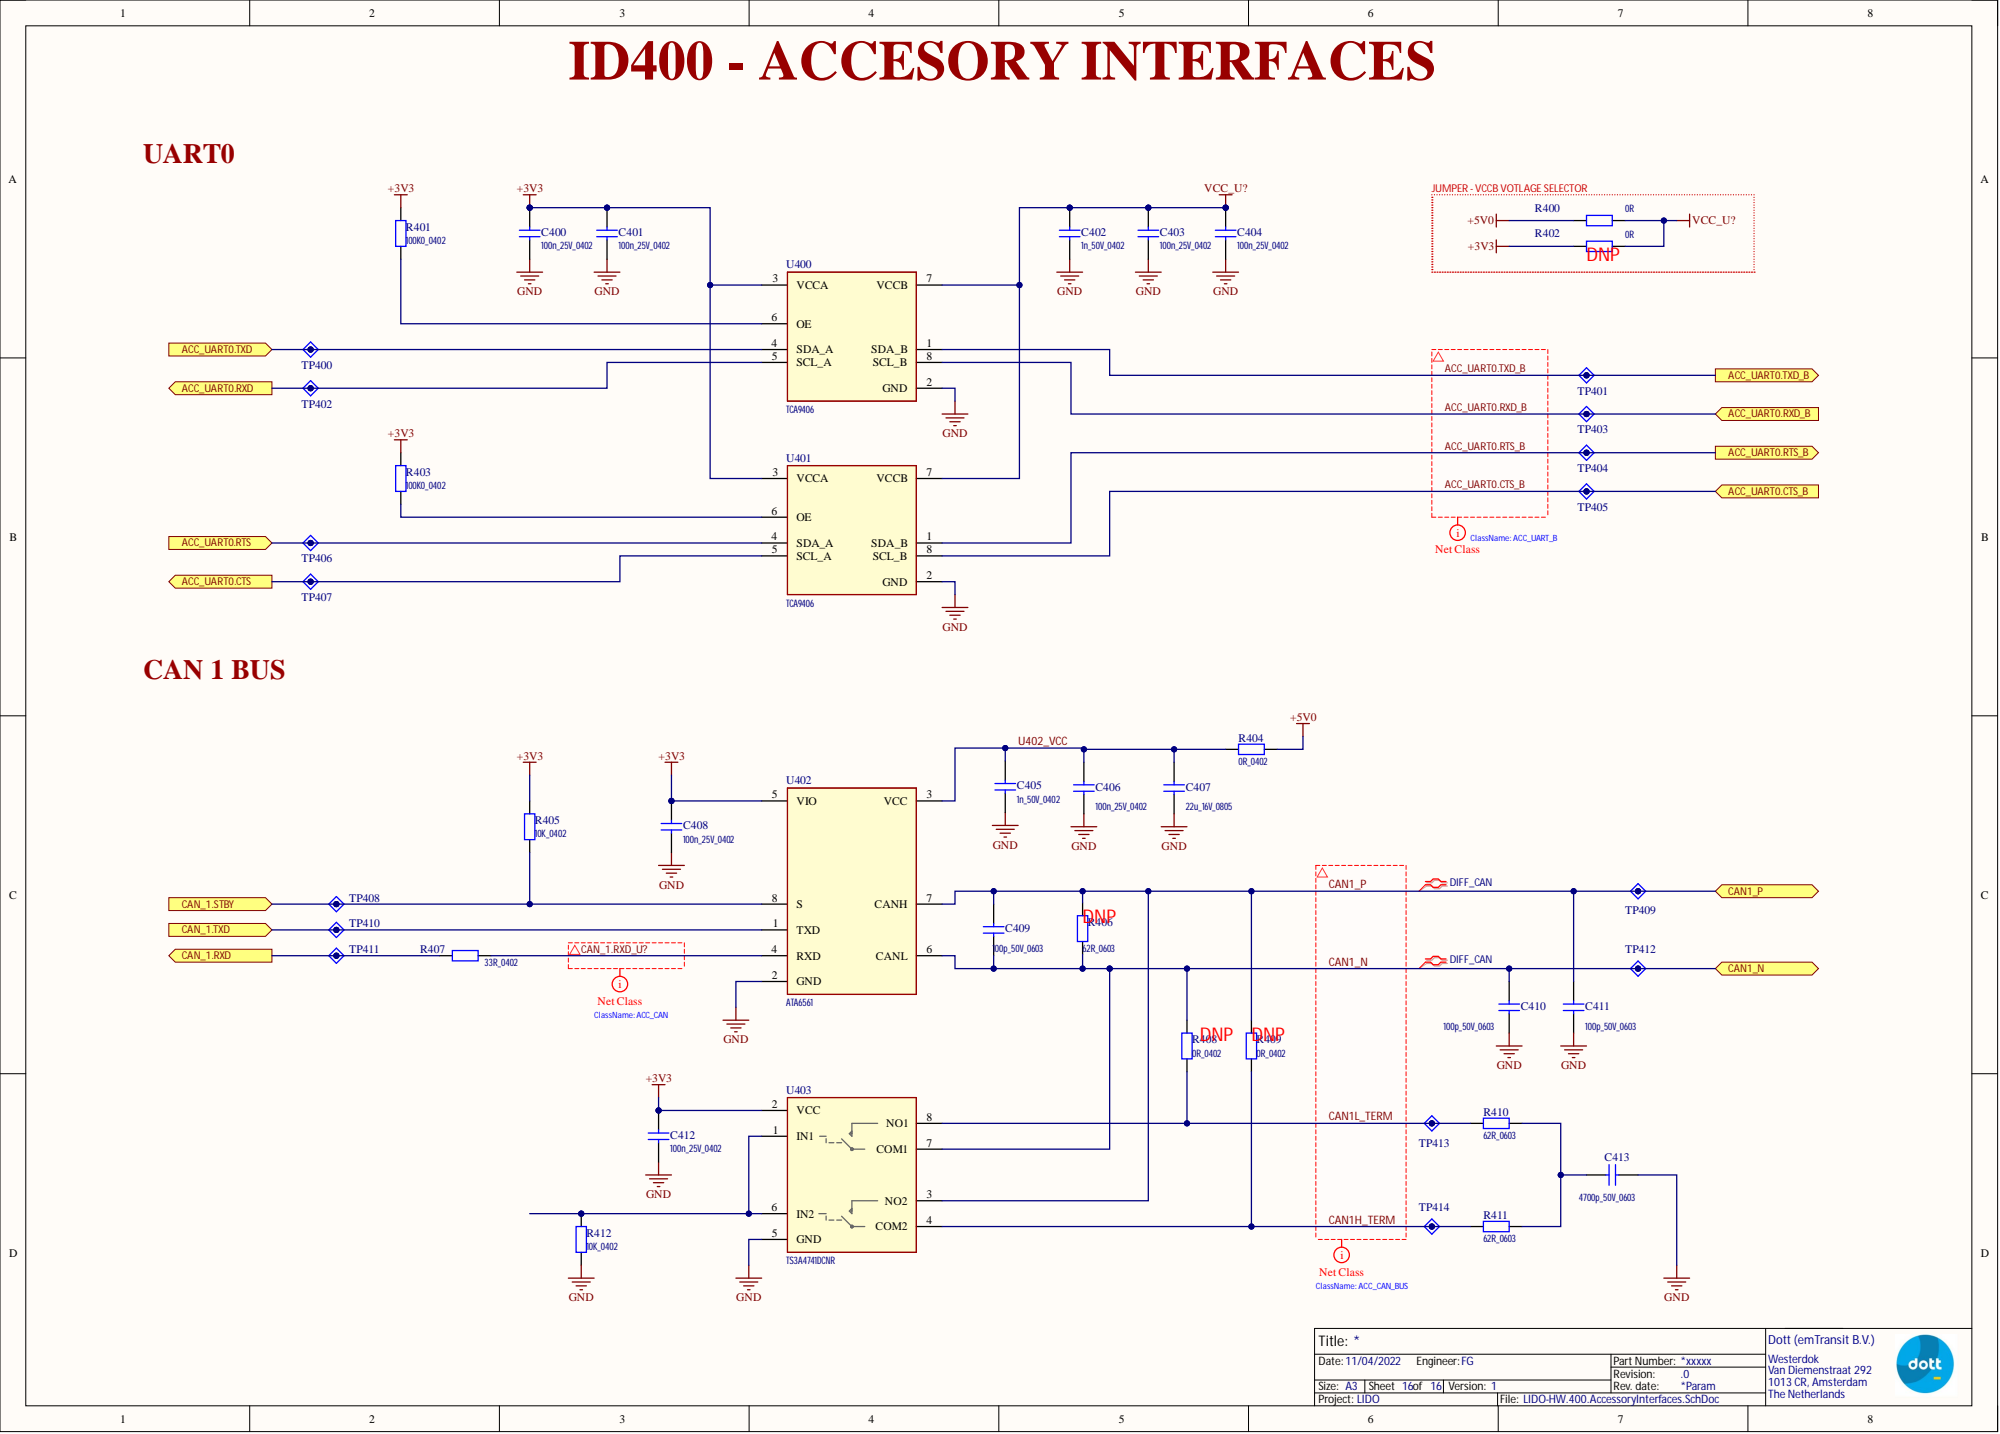
[picture p74: page 17]

JUMPER - VCCB VOTLAGE SELECTOR

SDA_A 4

TP400 | | | | ACC_UART0.TXD_B

ACC_UART0.RXD_B | TP401

GND | | ACC_UART0.RTS_B

ACC_UART0.CTS_B | TP404

SCL_A 5 | Net Class

CAN1_N | DIFF_CAN

CAN1L_TERM

LIDO-HW.400.AccessoryInterfaces.SchDoc
