ridedott/lido-hardware/(list of files, drawings)

Other design files:
LIDO_HW_2022_04_V01/LIDO-HW.001.CoverPage.SchDoc
LIDO_HW_2022_04_V01/LIDO-HW.002.RevisionHistory.SchDoc
LIDO_HW_2022_04_V01/LIDO-HW.003.BlockDiagram.SchDoc
LIDO_HW_2022_04_V01/LIDO-HW.100.FrontConnector.SchDoc
LIDO_HW_2022_04_V01/LIDO-HW.100.InputStage_1.SchDoc
LIDO_HW_2022_04_V01/LIDO-HW.100.InputStage_2.SchDoc
LIDO_HW_2022_04_V01/LIDO-HW.100.OutputStage.SchDoc
LIDO_HW_2022_04_V01/LIDO-HW.100.RearConnector.SchDoc
LIDO_HW_2022_04_V01/LIDO-HW.100.VinAndPower.SchDoc
LIDO_HW_2022_04_V01/LIDO-HW.200.MCU_Peripherals_1.SchDoc
LIDO_HW_2022_04_V01/LIDO-HW.200.MCU_Peripherals_2.SchDoc
LIDO_HW_2022_04_V01/LIDO-HW.200.MCU_SWD_Reset.SchDoc
LIDO_HW_2022_04_V01/LIDO-HW.200.SecurityAndTemperature.SchDoc
LIDO_HW_2022_04_V01/LIDO-HW.300.DisplayInterface.SchDoc
LIDO_HW_2022_04_V01/LIDO-HW.300.StatusLightInterface.SchDoc
LIDO_HW_2022_04_V01/LIDO-HW.300.VehicleInterface.SchDoc
LIDO_HW_2022_04_V01/LIDO-HW.400.AccessoryInterfaces.SchDoc
LIDO_HW_2022_04_V01/LIDO-HW_2022-04_V01.PrjPcb
LIDO_HW_2022_04_V01/LIDO_HW_2022_04_V01.PcbDoc
LIDO_HW_2022_04_V01/LIDO_HW_2022_04_V01.PrjPcb
LIDO_HW_2022_04_V01/SupportDocuments/Templates/A3_Dott_template_V1.SchDoc
