ridedott/lido-hardware/(commit log)

2022-04-12 Altium project structure created.
    [A3_Dott_template_V1.SchDoc, LIDO-HW.001.CoverPage.SchDoc, LIDO-HW.002.BlockDiagram.SchDoc, LIDO-HW.003.BlockDiagram.SchDoc, LIDO-HW.004.RevisionHistory.SchDoc, LIDO-HW.100.TopLevel.SchDoc, LIDO-HW_2022-04_V01.PcbDoc, LIDO-HW_2022-04_V01.PrjPcb]
2022-04-15 Sections added to the schematic: MCU, CAN, UART, L9733 (High-side driver), ATECC and temp sensor.
    [LIDO-HW.001.CoverPage.SchDoc, LIDO-HW.003.BlockDiagram.SchDoc, LIDO-HW.003.RevisionHistory.SchDoc, LIDO-HW.100.Connectors_1.SchDoc, LIDO-HW.100.Connectors_2.SchDoc, LIDO-HW.100.Page_10.SchDoc, LIDO-HW.100.Page_3.SchDoc, LIDO-HW.100.Page_4.SchDoc]
2022-04-29 Schematic Draft, ready for first sch. reviews
    [LIDO-HW.001.CoverPage.SchDoc, LIDO-HW.002.BlockDiagram.SchDoc, LIDO-HW.003.RevisionHistory.SchDoc, LIDO-HW.004.RevisionHistory.SchDoc, LIDO-HW.100.Connectors_1.SchDoc, LIDO-HW.100.Connectors_2.SchDoc, LIDO-HW.100.FrontConnector.SchDoc, LIDO-HW.100.InputStage.SchDoc]
2022-04-29 Reference designator and values modified
    [LIDO-HW.100.FrontConnector.SchDoc, LIDO-HW.100.InputStage.SchDoc, LIDO-HW.100.OutputStage.SchDoc, LIDO-HW.100.RearConnector.SchDoc, LIDO-HW.100.VinAndPower.SchDoc, LIDO-HW.200.MCU_Peripherals_1.SchDoc, LIDO-HW.200.MCU_Peripherals_2.SchDoc, LIDO-HW.200.MCU_SWD_Reset.SchDoc]
2022-05-04 Project V0.1 - Corrections based on the first sch. review meeting are implemented
    [LIDO-HW.003.RevisionHistory.SchDoc, LIDO-HW.100.FrontConnector.SchDoc, LIDO-HW.100.InputStage.SchDoc, LIDO-HW.100.InputStage_1.SchDoc, LIDO-HW.100.InputStage_2.SchDoc, LIDO-HW.100.OutputStage.SchDoc, LIDO-HW.100.RearConnector.SchDoc, LIDO-HW.100.VinAndPower.SchDoc]
2022-05-04 v0.1 schematic pdf document
2022-05-17 Schemeatic ready to be freeze. Symbol replaced by real components. PN based on Vladimir's selection.
    [LIDO-HW.001.CoverPage.SchDoc, LIDO-HW.002.BlockDiagram.SchDoc, LIDO-HW.003.RevisionHistory.SchDoc, LIDO-HW.100.FrontConnector.SchDoc, LIDO-HW.100.InputStage_1.SchDoc, LIDO-HW.100.InputStage_2.SchDoc, LIDO-HW.100.OutputStage.SchDoc, LIDO-HW.100.RearConnector.SchDoc]
2022-05-18 Development variant created. Scheamtic ready to be freeze.
    [LIDO-HW.100.InputStage_2.SchDoc, LIDO-HW.100.OutputStage.SchDoc, LIDO-HW.100.RearConnector.SchDoc, LIDO-HW.100.VinAndPower.SchDoc, LIDO-HW.200.MCU_SWD_Reset.SchDoc, LIDO-HW.300.DisplayInterface.SchDoc, LIDO-HW.300.StatusLightInterface.SchDoc, LIDO-HW.300.VehicleInterface.SchDoc]
2022-05-18 Block Diagram Added to schematic. Schematic freezed after my own revision.
    [LIDO-HW.002.BlockDiagram.SchDoc, LIDO-HW.002.RevisionHistory.SchDoc, LIDO-HW.003.BlockDiagram.SchDoc, LIDO-HW.003.RevisionHistory.SchDoc, LIDO-HW.004.RevisionHistory.SchDoc, LIDO-HW.100.RearConnector.SchDoc, LIDO-HW.100.VinAndPower.SchDoc, LIDO-HW.200.MCU_Peripherals_2.SchDoc]
2022-05-18 PCB document created and components added to it.
    [LIDO_HW_2022_04_V01.PrjPcb, LIDO_HW_V02_17052022.xls]
2022-05-19 Component placement in process. Some schematics errors corrected too,
    [LIDO-HW.003.BlockDiagram.SchDoc, LIDO-HW.100.InputStage_1.SchDoc, LIDO-HW.100.InputStage_2.SchDoc, LIDO-HW.100.OutputStage.SchDoc, LIDO-HW.100.VinAndPower.SchDoc, LIDO-HW.200.MCU_SWD_Reset.SchDoc, LIDO-HW.200.SecurityAndTemperature.SchDoc, LIDO-HW.300.DisplayInterface.SchDoc]
2022-05-20 working with connectors placement
    [LIDO-HW.300.StatusLightInterface.SchDoc]
2022-05-27 Weekly backup
    [LIDO-HW.100.FrontConnector.SchDoc, LIDO-HW.100.InputStage_1.SchDoc, LIDO-HW.100.InputStage_2.SchDoc, LIDO-HW.100.OutputStage.SchDoc, LIDO-HW.100.RearConnector.SchDoc, LIDO-HW.100.VinAndPower.SchDoc, LIDO-HW.200.MCU_SWD_Reset.SchDoc, LIDO-HW.200.SecurityAndTemperature.SchDoc]
2022-05-30 Component placement: 80% done
    [LIDO-HW.100.FrontConnector.SchDoc, LIDO-HW.100.InputStage_1.SchDoc, LIDO-HW.100.InputStage_2.SchDoc, LIDO-HW.100.OutputStage.SchDoc, LIDO-HW.100.RearConnector.SchDoc, LIDO-HW.100.VinAndPower.SchDoc, LIDO-HW.300.DisplayInterface.SchDoc, LIDO-HW.300.StatusLightInterface.SchDoc]
2022-06-01 V0.3 revision. New and smaller connectors thta the first ones. Connector's pinout updates to suit layout. This pinout shared to OMNI. Component placement completed.
    [LIDO-HW.001.CoverPage.SchDoc, LIDO-HW.002.RevisionHistory.SchDoc, LIDO-HW.100.RearConnector.SchDoc, LIDO_HW_2022_04_V01.PrjPcb]
2022-06-01 Connector's receptacle STEP files added
2022-06-01 Stackup updated accordingly to Pcbway standard -> used by Deltaproto Pinout images updated
    [LIDO-HW.100.FrontConnector.SchDoc, LIDO-HW.100.RearConnector.SchDoc]
2022-06-07 Work progress backup, plus STEP model of the Board outline from OMNI
    [20220602_OMNI LIDO PCB.step, LIDO-HW.100.RearConnector.SchDoc, LIDO-HW.200.MCU_Peripherals_1.SchDoc, LIDO-HW.200.MCU_Peripherals_2.SchDoc, LIDO-HW.200.MCU_SWD_Reset.SchDoc, LIDO_HW_2022_04_V01.PrjPcb]
2022-06-08 Backup before going into holidays
    [LIDO-HW.300.StatusLightInterface.SchDoc]
2022-06-15 80% Routing
    [LIDO-HW.100.OutputStage.SchDoc]
2022-06-16 All Nets connected. Layout feasible wiht 6layers PCB. 3 ground planes and 3 layers for Pwr and signals
    [LIDO-HW.200.MCU_Peripherals_2.SchDoc]
2022-06-17 Weekly backup. Layout optimization ongoing. Stackup pending by NCAB
    [LIDO-HW.003.BlockDiagram.SchDoc, LIDO-HW.100.InputStage_1.SchDoc, LIDO-HW.100.InputStage_2.SchDoc, LIDO-HW.100.OutputStage.SchDoc, LIDO-HW.300.DisplayInterface.SchDoc, LIDO-HW.300.StatusLightInterface.SchDoc, LIDO-HW.300.VehicleInterface.SchDoc, LIDO-HW.400.AccessoryInterfaces.SchDoc]
2022-06-19 Assembly Layer Added. Working on Polygons
    [LIDO-HW.100.RearConnector.SchDoc, LIDO_HW_2022_04_V01.PrjPcb]
2022-06-21 Output file folder structure modified.
    [LIDO_HW_V03_21062022.xls]
2022-06-21 Delete LIDO_HW_2022_04_V01/Output Documents/04_BOM directory
    04 BOM folder changed to 05 BOM
    [LIDO_HW_V02_17052022.xls]
2022-06-21 Delete LIDO_HW_2022_04_V01/Output Documents/05_PCB_3D directory
    05 PCB 3D folder changed to 06 PCB 3D
2022-06-21 Revert "no message"
    This reverts commit 96dbba4188b4a5c24c3d674bd1b02144580dac03.
    [LIDO_HW_V03_21062022.xls]
2022-06-21 Remove old version of BOM
    [LIDO_HW_V03_21062022.xls]
2022-06-21 New revision of BOM with comparison table between V0.2 and V0.3
    [LIDO_HW_V03_21062022.xlsx]
2022-06-23 Gerber Files generated (Draft revision) for review wiht ZignInnovations and NCAB group.
    [LIDO-HW.100.FrontConnector.SchDoc, LIDO-HW.100.RearConnector.SchDoc, LIDO-HW.400.AccessoryInterfaces.SchDoc, LIDO_HW_2022_04_V01.PrjPcb]
2022-06-27 Gerber and NC drill files modified according to AQC feedback. LAyout ready for the first review
    [LIDO_HW_2022_04_V01.PrjPcb]
2022-06-30 Layout modification based on AQC comments
    [LIDO_HW_2022_04_V01.PrjPcb]
2022-07-02 Outputfile Generated: SCH, Assembly drw, Board drw, Gerber, Drils, pick&place and BOM
    [BOM Dott template rev.A1.xls, BOM LIDO_V03_DEVELOPMENT_04_07_2022.xls, LIDO-HW.001.CoverPage.SchDoc, LIDO_HW_2022_04_V01.PrjPcb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]
2022-07-05 last modifications before final layout review
    [LIDO_HW_2022_04_V01.PrjPcb]
2022-07-06 Layout modifications based on Xaver's comments
    [LIDO_HW_2022_04_V01.PrjPcb]
